henla464/WiRocKiCad/KiCad6/Hardware_OLED_v1/Plots/3dmodel.png

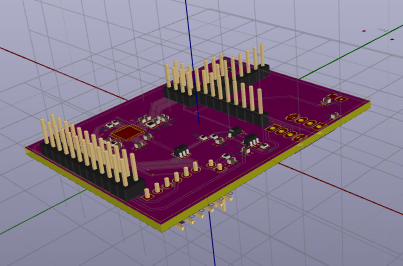
KiCad6/Hardware_OLED_v1/Plots/3dmodel.png
