henla464/WiRocKiCad/KiCad8/WiRoc_NanoPi_v7/production/WiRoc_NanoPi.png

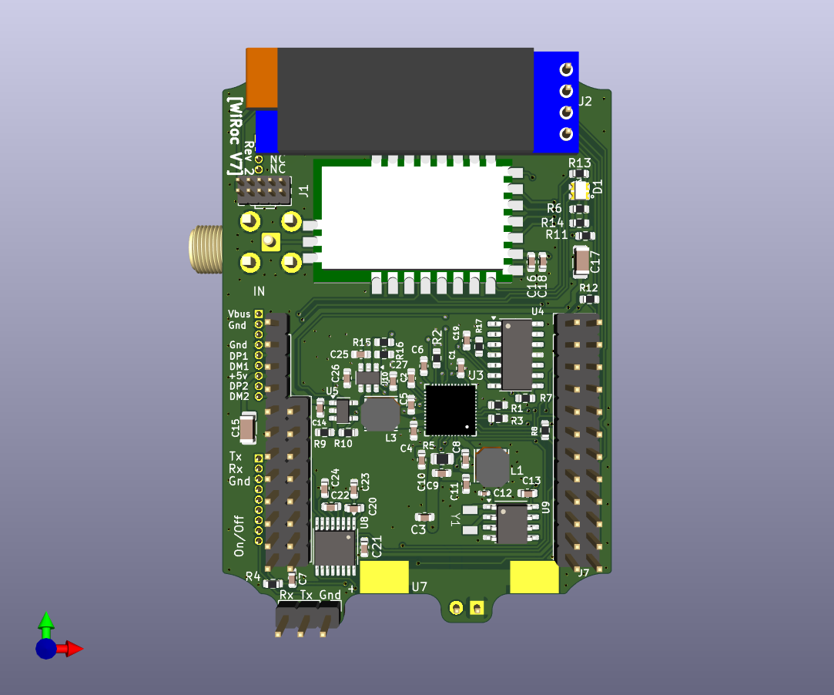
KiCad8/WiRoc_NanoPi_v7/production/WiRoc_NanoPi.png
