henla464/WiRocKiCad/Components for voltage protection TECH PUBLIC USBLC6 2P6.txt

TECH PUBLIC USBLC6-2P6  		is tiny SOT-666-6  1,5kr/st available
STMicroelectronics USBLC6-2P6		is tiny SOT-666-6  2 kr/st available
TECH PUBLIC TPUSBLC6-2P6		is tiny SOT-666-6  1,5kr/st available
