henla464/WiRocKiCad/KiCad6/Hardware_NanoPi_v5/WiRoc_NanoPi_v1.html

# /home/henla464/Documents/WiRoc/Hardware/KiCad/KiCad5/Hardware_NanoPi_v5/WiRoc_NanoPi_v1.sch

lör 7 aug 2021 14:30:26

Eeschema 5.1.10-88a1d61d58~88~ubuntu20.04.1

Component Count:55

Ref | Qnty | Value | Part | Datasheet | Description | Vendor
C1, C3, C8, C10, C11, C18 | 6 | 4.7uF | WiRoc_NanoPi_v1-rescue:C
C2, C6, C9, C16 | 4 | 1uF | WiRoc_NanoPi_v1-rescue:C
C4, C5, C12, C13, C14, C19 | 6 | 10uF | WiRoc_NanoPi_v1-rescue:C
C7 | 1 | 100pF | WiRoc_NanoPi_v1-rescue:C
C15, C17 | 2 | 47uF | Device:C | ~ | Unpolarized capacitor
D1 | 1 | LED_DUAL_ACCA | WiRoc:LED_DUAL_ACCA | https://datasheet.lcsc.com/szlcsc/2005041205_HONGLITRONIC-Hongli-Zhihui-HONGLITRONIC-HL-PCB-1617S9FH203BC_C513363.pdf
D3 | 1 | IN5819 | WiRoc_NanoPi_v1-rescue:D_Schottky | https://datasheet.lcsc.com/szlcsc/1811011112_Changjiang-Electronics-Tech-CJ-B5817W_C8597.pdf
J1 | 1 | Conn_01x02 | WiRoc_NanoPi_v1-rescue:Conn_01x02
J2 | 1 | USB_Power_02x02 | WiRoc:TerminalBlock_USB_Power_01x04 | | Generic connector, single row, 01x04
J3 | 1 | Serial | Connector:Conn_01x04_Female | | Generic connector, single row, 01x04, script generated (kicad-library-utils/schlib/autogen/connector/)
J4 | 1 | USB_Host_Data_02x02 | WiRoc:TerminalBlock_USB_Host_Data_01x04 | | Generic connector, single row, 01x04
J6 | 1 | HAT_Conn_DBG | WiRoc_NanoPi_v1-rescue:Conn_01x03
J7 | 1 | NanoPIAir | WiRoc:NanoPIAir
J8 | 1 | USB_Host_Data_02x02 | WiRoc:TerminalBlock_USB_Host_Data_01x04 | | Generic connector, single row, 01x04
J9 | 1 | Conn_Coaxial | Connector:Conn_Coaxial | | coaxial connector (BNC, SMA, SMB, SMC, Cinch/RCA, ...)
JP1 | 1 | Jumper_NO_Small | Device:Jumper_NO_Small | ~ | Jumper, normally open, small symbol
JP2 | 1 | Jumper_NC_Small | Device:Jumper_NC_Small | ~ | Jumper, normally closed, small symbol
L1, L2 | 2 | 2.2uH-DCR<0.1R-1.5A | WiRoc_NanoPi_v1-rescue:L
R1, R10 | 2 | 100K-1% | WiRoc_NanoPi_v1-rescue:R
R2, R3, R7 | 3 | 200K-1% | WiRoc_NanoPi_v1-rescue:R
R4, R8 | 2 | 24K-1% | WiRoc_NanoPi_v1-rescue:R
R5 | 1 | 0R03 | WiRoc_NanoPi_v1-rescue:R
R6, R13, R14 | 3 | 1K | WiRoc_NanoPi_v1-rescue:R
R9 | 1 | 3.6K-1% | WiRoc_NanoPi_v1-rescue:R | https://datasheet.lcsc.com/szlcsc/1811081731_UNI-ROYAL-Uniroyal-Elec-0603WAF3601T5E_C22980.pdf
R11, R12 | 2 | 10K | WiRoc_NanoPi_v1-rescue:R
SW1 | 1 | SW_SPST | Switch:SW_SPST | | Single Pole Single Throw (SPST) switch
U1 | 1 | DRF1268DS | WiRoc:DRF1268DS
U2 | 1 | OLED | WiRoc:OLED
U3 | 1 | AXP209 | WiRoc:axp209 | http://dl.linux-sunxi.org/AXP/AXP209_Datasheet_v1.0en.pdf
U4 | 1 | LP6226_SY7208 | WiRoc:LP6226_SY7208 | https://datasheet.lcsc.com/szlcsc/1810010234_Silergy-Corp-SY7208ABC_C80514.pdf | SOT23-6
U5 | 1 | SY6280 | WiRoc:SY6280 | https://datasheet.lcsc.com/szlcsc/1810121532_Silergy-Corp-SY6280AAC_C55136.pdf
U6 | 1 | BatteryPadM | WiRoc:BatteryPadM
U7 | 1 | BatteryPadP | WiRoc:BatteryPadP
