henla464/WiRocKiCad/KiCad6/Hardware_NanoPi_v1/Plots/WiRoc_NanoPi_v1.html

# WiRoc NanoPI Hat BOM Rev 1

Date

# 2018-03-31

Company

# Henrik Larsson

Comment 1

Total Parts

# 53 (Unique 29)

Ref

Qty

Value

Description

ElecrowPNr

Manufacturer

ManufacturerPNr

Notes

Original

Package

WebsiteURL

WebsiteURL2

Datasheet

[C] -

C13 C12 C14 C4 C5

5

10uF

C19702

CL10A106KP8NNNC

Free

0603

C3 C11 C10 C8 C1

5

4.7uF

C19666

CL10A475KO8NNNC

Free

0603

C9 C2 C6

3

1uF

C15849

CL10A105KB8NNNC

Free

0603

C7

1

100pF

100pF (101) ±5% 50V

C14858

CL10C101JB8NNNC

Free

0603

[D] -

D3

1

IN5819

Diode Schottky 40V 1A Surface Mount SOD-123

Diodes Incorporated

1N5819HW-7-F

No

SOD-123

Link (https://www.digikey.com/product-detail/en/diodes-incorporated/1N5819HW-7-F/1N5819HW-FDICT-ND/815283)

Datasheet (https://www.diodes.com/assets/Datasheets/ds30217.pdf)

D1

1

D_TVS

Applied Power Microelectronics

AU0511P1

No

DFN1006-2

Link (http://www.datasheetspdf.com/pdf/1099402/AppliedPowerMicroelectronics/AU0511P1/1)

Datasheet

D2

1

LED

Red LED

4040506A

No

0603

[J] -

J6

1

NanoPIAir_USBPort

CONN HEADER FEM 12POS.1" SGL TIN

Sullins Connector Solutions

PPTC121LFBN-RC

No

1x 12P-2.54

Link (https://www.digikey.se/products/en?keywords=PPTC121LFBN-RC)

Link

Datasheet (http://www.sullinscorp.com/drawings/78_P(N)PxCxxxLFBN-RC,_10492-H.pdf)

J9

1

NanoPIAir_GPIOPort

2.54mm 2X12 Pin Double Row Female 12P

Sullins Connector Solutions

PPTC122LFBN-RC

No

2x 12P-2.54

Link (https://www.digikey.com/product-detail/en/sullins-connector-solutions/PPTC122LFBN-RC/S7080-ND/810218)

Link

Datasheet (http://www.sullinscorp.com/drawings/78_P(N)PxCxxxLFBN-RC,_10492-H.pdf)

J7

1

NanoPIAir_DebugPort

CONN HEADER FEM 12POS.1" SGL TIN

Sullins Connector Solutions

PPTC041LFBN-RC

No

1x 4P-2.54

Link (https://www.digikey.se/product-detail/en/sullins-connector-solutions/PPTC041LFBN-RC/S7002-ND/810144)

Link

Datasheet (http://www.sullinscorp.com/drawings/78_P(N)PxCxxxLFBN-RC,_10492-H.pdf)

J3

1

JST-2PIN

2 Positions Header Connector 0.098" (2.50mm) Through Hole Tin

JST Sales America Inc.

B2B-XH-A(LF)(SN)

2.54 mm pitch should work too...

No

Link (https://www.digikey.se/product-detail/en/jst-sales-america-inc/B2B-XH-A-LF-SN/455-2247-ND/1651045)

J1

1

Conn_01x02

6030916A

No

1x 2P-2.54

J8

1

HAT_Conn_DBG

6030916A

No

1x 3P-2.54

J2

1

TerminalBlock_USB_Power_01x04

J5

1

Conn_01x06

J4

1

TerminalBlock_USB_Host_Data_01x04

[L] -

L2 L1

2

2.2uH-DCR<0.1R-1.5A

FIXED IND 2.2UH 1.7A 55 MOHM SMD

Panasonic Electronic Components

ELL-4LG2R2NA

ELL4LG-A

Link (https://www.digikey.se/product-detail/en/panasonic-electronic-components/ELL-4LG2R2NA/PCD2215TR-ND/1938292)

Datasheet (https://industrial.panasonic.com/cdbs/www-data/pdf/AGM0000/AGM0000CE3.pdf)

[R] -

R7 R2 R3

3

200K-1%

C25811

0603WAF2003T5E

Free

0603

R8

1

24K-1%

C23352

0603WAF2402T5E

Free

0603

R9

1

3.6K-1%

C22980

0603WAF3601T5E

Free

0603

R5

1

0R03

RESISTOR 0805 0.03Ω 1/8W±1%

Vishay Dale

WSL0805R0300FEA

No

0805

Link (https://www.digikey.com/product-detail/en/vishay-dale/WSL0805R0300FEA/WSLA-.03CT-ND/713392)

R4 R6

2

1K

1KΩ (1001) ±1%

C21190

0603F1001T5E

Free

0603

R1 R10

2

100K-1%

C25803

0603WAF1003T5E

Free

0603

[TP] -

TP10 TP11 TP14 TP4 TP1 TP2 TP9 TP3

8

TEST

[U] -

U3

1

AXP209

Enhanced single Cell Li-Battery and Power System Management IC

X-Powers Limited

AXP209

Yes

6mm x 6mm 48-pin QFN

Datasheet (http://dl.linux-sunxi.org/AXP/AXP209_Datasheet_v1.0en.pdf)

U4

1

LP6226/SY7208

High Efficiency Boost DC/DC Convertor

lowpowersemi

LP6226B6F

Yes

SOT23-6

Datasheet (http://www.lowpowersemi.com/uploads/soft/20170826Boost/LP6226.pdf)

U5

1

SY6280

Power Distribution Switch 1In/1Out Act-High Enable 1A Vin 2.4÷5.5V 80mΩ

SILERGY

SY6280AAC

Yes

SOT23-5

Datasheet (http://www.szyucan.com/upfile/IC-PDF/SY6280A.pdf)

U2

1

LoraRadio

Lora radio module

AppconnWireless

RF1276T ; freq: ~440Mhz ; voltage: 2.1-3.7V ; TTL serial

Yes

# BOM made with KICAD_BOM_WIZARD (https://github.com/HashDefineElectronics/KiCad_BOM_Wizard) (Generated lör 7 jul 2018 10:53:41)
