henla464/WiRocKiCad/KiCad6/Hardware_NanoPi_v3/WiRoc_NanoPi_v1.html

# WiRoc NanoPI Hat BOM Rev 1

Date

# 2018-03-31

Company

# Henrik Larsson

Comment 1

Total Parts

# 59 (Unique 33)

Ref

Qty

Value

Description

ElecrowPNr

LCSCPNr

Manufacturer

ManufacturerPNr

Notes

Original

Package

WebsiteURL

WebsiteURL2

Datasheet

[C] -

C13 C12 C14 C4 C5

5

10uF

C19702

C19702

Samsung Electro-Mechanics

CL10A106KP8NNNC

No

0603

Link (https://lcsc.com/product-detail/Multilayer-Ceramic-Capacitors-MLCC-SMD-SMT_SAMSUNG_CL10A106KP8NNNC_10uF-106-10-10V_C19702.html)

C3

1

4.7uF

C99226

C19666

Guangdong Fenghua Advanced Tech

0603B475K160NT

No

0603

Link (https://lcsc.com/product-detail/Multilayer-Ceramic-Capacitors-MLCC-SMD-SMT_4-7uF-475-10-16V_C99226.html)

Link

C9 C2 C6

3

1uF

C157684

C15849

Guangdong Fenghua Advanced Tech

0603X105K500NT

No

0603

Link (https://lcsc.com/product-detail/Multilayer-Ceramic-Capacitors-MLCC-SMD-SMT_1uF-105-10-50V_C157684.html)

C11 C10 C8 C1

4

4.7uF

C99226

C19666

Guangdong Fenghua Advanced Tech

0603B475K160NT

No

0603

Link (https://lcsc.com/product-detail/Multilayer-Ceramic-Capacitors-MLCC-SMD-SMT_4-7uF-475-10-16V_C99226.html)

C7

1

100pF

100pF (101) ±5% 50V

C1635

C14858

Guangdong Fenghua Advanced Tech

0603CG101J500NT

No

0603

Link (https://lcsc.com/product-detail/Multilayer-Ceramic-Capacitors-MLCC-SMD-SMT_100pF-101-5-50V_C1635.html)

C15

1

47uF

C77101

C77101

1210

Datasheet

[D] -

D3

1

IN5819

Diode Schottky 40V 1A Surface Mount SOD-123

C82544

C8597

Diodes Incorporated

1N5819HW-7-F

No

SOD-123

Link (https://www.digikey.com/product-detail/en/diodes-incorporated/1N5819HW-7-F/1N5819HW-FDICT-ND/815283)

Datasheet (https://www.diodes.com/assets/Datasheets/ds30217.pdf)

D2 D5 D4

3

LED

Red LED

C118330

C2286

Wuxi ARK Tech Elec

D-R060306L3-KS2

No

0603

Link (https://lcsc.com/product-detail/Light-Emitting-Diodes-LED_D-R060306L3-KS2-Azarin_C118330.html)

[J] -

J3

1

JST-2PIN

2 Positions Header Connector 0.098" (2.50mm) Through Hole Tin

C20079

N/A

Boom Precision Elec

XH-2A

2.54 mm pitch should work too...

No

XH-2A

Link (https://lcsc.com/product-detail/XH-Connectors_XH-2A-2P-pitch2-5mm-Straight-line_C20079.html)

J1

1

Conn_01x02

C2337

N/A

Boom Precision Elec

No

1x 2P-2.54

Link (https://lcsc.com/product-detail/Male-Header_2-54mm-1-40P-Straight-Headers-Pins_C2337.html)

J2

1

USB_Power_02x02

N/A

N/A

J4

1

USB_Host_Data_02x02

N/A

N/A

J6

1

HAT_Conn_DBG

CONN HEADER Male 3POS.1"

C2337

N/A

Boom Precision Elec

No

1x 3P-2.54

Link (https://lcsc.com/product-detail/Male-Header_2-54mm-1-40P-Straight-Headers-Pins_C2337.html)

J5

1

Conn_01x03

N/A

Datasheet

J8

1

USB_Host_Data_02x02

N/A

N/A

J7

1

NanoPIAir

N/A

J9

1

Conn_Coaxial

C88374

C88374

Datasheet

[L] -

L2 L1

2

2.2uH-DCR<0.1R-1.5A

FIXED IND 2.2UH 1.7A 55 MOHM SMD

C206341

C206341

Sunltech Tech

SLW4018S2R2MST

Yes

4018

Link (https://lcsc.com/product-detail/Power-Inductors_2-2uH-20-1-65A_C206341.html)

[R] -

R7 R2 R3

3

200K-1%

C25811

C25811

Uniroyal Elec

0603WAF2003T5E

No

0603

Link (https://lcsc.com/product-detail/Chip-Resistor-Surface-Mount-UniOhm_Uniroyal-Elec-0603WAF2003T5E_C25811.html)

R8

1

24K-1%

C23352

C23352

Uniroyal Elec

0603WAF2402T5E

No

0603

Link (https://lcsc.com/product-detail/Chip-Resistor-Surface-Mount-UniOhm_Uniroyal-Elec-0603WAF2402T5E_C23352.html)

R9

1

3.6K-1%

C100993

C22980

LIZ Elec

CR0603FA3601G

No

0603

Link (https://lcsc.com/product-detail/Chip-Resistor-Surface-Mount_3-6KR-3601-1_C100993.html)

R5

1

0R03

RESISTOR 0805 0.03Ω 1/8W±1%

C158159

C247605

RALEC

RTT05R030FTP

No

0805

Link (https://lcsc.com/product-detail/Chip-Resistor-Surface-Mount_0-03R-R030-1_C158159.html)

R4 R6 R14 R13

4

1K

1KΩ (1001) ±1%

C103198

C21190

RALEC

RTT031001FTP

No

0603

Link (https://lcsc.com/product-detail/Chip-Resistor-Surface-Mount_1KR-1001-1_C103198.html)

R1 R10

2

100K-1%

C25803

C25803

Uniroyal Elec

0603WAF1003T5E

No

0603

Link (https://lcsc.com/product-detail/Chip-Resistor-Surface-Mount-UniOhm_Uniroyal-Elec-0603WAF1003T5E_C25803.html)

R11 R12

2

10K

RESISTOR 0603 10KΩ

C108450

C25804

Huaxin S&T

WR06X103JTL

No

0603

Link (https://lcsc.com/product-detail/Chip-Resistor-Surface-Mount_10KR-103-5_C108450.html)

[TP] -

TP10 TP11 TP14 TP4 TP1 TP2 TP9 TP3

8

TEST

N/A

N/A

[U] -

U3

1

AXP209

Enhanced single Cell Li-Battery and Power System Management IC

C80525

C80525

X-Powers Limited

AXP209

Yes

6mm x 6mm 48-pin QFN

Link (https://lcsc.com/product-detail/PMIC-AC-DC-Converters_AXP209_C80525.html)

Datasheet (http://dl.linux-sunxi.org/AXP/AXP209_Datasheet_v1.0en.pdf)

U4

1

LP6226_SY7208

High Efficiency Boost DC/DC Convertor

Missing

C80514

lowpowersemi

LP6226B6F

Yes

SOT23-6

Link

Link (https://lcsc.com/product-detail/DC-DC-Converters_Silergy_SY7208ABC_SY7208ABC_C80514.html)

Datasheet (http://www.lowpowersemi.com/uploads/soft/20170826Boost/LP6226.pdf)

U5

1

SY6280

Power Distribution Switch 1In/1Out Act-High Enable 1A Vin 2.4÷5.5V 80mΩ

C55136

C55136

SILERGY

SY6280AAC

Yes

SOT23-5

Link (https://lcsc.com/product-detail/PMIC-Power-Distribution-Switches_Silergy_SY6280AAC_SY6280AAC_C55136.html)

Datasheet (http://www.szyucan.com/upfile/IC-PDF/SY6280A.pdf)

U1

1

DRF1268DS

N/A

U2

1

OLED

N/A

U7

1

BatteryPadP

N/A

U6

1

BatteryPadM

N/A

# BOM made with KICAD_BOM_WIZARD (https://github.com/HashDefineElectronics/KiCad_BOM_Wizard) (Generated ons 11 sep 2019 00:13:55)
