henla464/WiRocKiCad/KiCad10/WiRoc_v8/ComponentDesignationAndLocation.ods

Sheet: Resistors
Resistor designation on NanoPi | Found | on WiRoc | Where* (b=bottom, t=top, column A-D, row 1-4)
R1 | No
R2 | Yes | R19 | bC1
R3 | Yes | R27 | bC1
R4 | Yes | R43 | bD1
R5 | Yes | R29 | bC1
R6 | Yes | - |  | Micro usb
R7 | Yes | - |  | Audio
R8 | Yes | - |  | Micro usb
R9 | Yes | - |  | Audio
R10 | Yes | - |  | Micro usb
R11 | Yes | R35 | bB3
R12 | Yes | R45 | bB4
R13 | Yes | R52 | bD4
R14 | Yes | R44 | bB4
R15 | Yes | - |  | Audio
R16 | Yes | R48 | bC4
R17 | Yes | R47 | bC4
R18 | Yes | - |  | Micro usb
R19 | Yes | R51 | bD4
R20 | Yes | RV8 | tC1
R21 | Yes | R33 | tB2
R22 | Yes | R34 | bC3
R23 | Yes | R26 | bC3
R24 | Yes | R29 | tB2
R25 | Yes | RV7 | tC1
R26 | Yes | RV1 | tC2
R27 | Yes | RV2 | tC2
R28 | Yes | RV6 | tC2
R29 | Yes | RV5 | tC2
R30 | Yes | RV4 | tC2
R31 | Yes | RV3 | tC3
R32 | Yes | R42 | bB4
R33 | No
R34 | No
R35 | No
R36 | Yes | R46 | bD1
… | No
R51 | Yes | R23 | tC2
R52 | Yes | R24 | bB2
R53 | Yes | R22 | tC2
… | No
R88 | Yes | R25 | bA4
R89 | Yes | - |  | Audio
R90 | Yes | - |  | IR
R91 | Yes | - |  | Audio
R92 | No
… | No
R140 | Yes | - |  | Wifi/BT
R141 | Yes | - |  | Wifi/BT
R142 | Yes | - |  | Wifi/BT
R143 | Yes | - |  | Wifi/BT
R144 | Yes | - |  | Wifi/BT
R145 | Yes | - |  | Wifi/BT
R146 | Yes | - |  | Wifi/BT
R147 | Yes | - |  | Wifi/BT
.. | No
R163 | Yes | - |  | Micro usb
… | No
R184 | Yes | - |  | Micro usb
… | No
R202 | Yes | R40 | bD3
R203 | Yes | R39 | bD3
… | No
R206 | Yes | R41 | bD3
…
R234 | Yes | - |  | Camera
…
R239 | Yes | - |  | Micro usb
R240 | No
R241 | Yes | - |  | Micro usb
R242 | Yes | - |  | Micro usb
…
R246 | Yes | - |  | Camera
R247 | Yes | - |  | Camera
…
R250 | Yes | - |  | Camera
R251 | No
R252 | Yes | R32 | bC1
R253 | No
R254 | Yes | R34 | bC1
…
R344 | Yes | R28 | bC1
R345 | Yes | - |  | Wifi/BT
R346 | Yes | R20 | bA1
R347 | Yes | R21 | bA1
R348 | Yes | - |  | Wifi/BT
…
R350 | Yes | R18 | bC1
R351 | Yes | R36 | tC1
R352 | Yes | R37 | bA1
R353 | Yes | R38 | bA1
…
R452 | Yes | R50 | bD2
R453 | Yes | R53 | bD2
R454 | Yes | R54 | bD2
R455 | Yes | R55 | bD2
…
R475 | Yes | R30 | bD1

Sheet: Capacitor
Capacitor designation on NanoPi | Found | on WiRoc | Where* (b=bottom, t=top, column A-D, row 1-4)
C1 | Yes | C37 | tC2 |  | DRAM (A – area)
C2 | Yes | C31 | tA2
C3 | Yes | C38 | bD1
C4 | Yes | C39 | bD1
C5 | Yes | C44
… | No
C9 | Yes | C45 | tC2
… | No
C11 | Yes | - |  | Audio
C12 | Yes | - |  | Audio
C13 | Yes | - |  | Audio
C14 | Yes | - |  | Audio
C15 | Yes | - |  | Audio
C16 | Yes | C80 | bD4
C17 | Yes | C66 | bA3
C18 | Yes | C67 | tA2
C19 | Yes | C69 | tC2
C20 | Yes | C68 | tB2
C21 | Yes | C72 | tB2
C22 | Yes | C76
C23 | Yes | C77 | tB1
C24 | Yes | C74 | tB1
C25 | Yes | C78 | tB1
C26 | Yes | C79 | bC3
C27 | Yes | C82 | tB2
C28 | Yes | C83 | bC3
C29 | Yes | C84 | tB2
C30 | Yes | C85 | tB2?
C31 | Yes | C40 | bD2
C32 | Yes | -
C33 | Yes | -
C34 | Yes | -
C35 | Yes | -
C36 | Yes | C71 | tA2
C37 | Yes | -
C38 | Yes | -
C39 | Yes | C75 | tB1
C40 | Yes | C42 | bD3
C41 | Yes | C41 | bD2
C42 | Yes | C64 | bB4
C43 | Yes | C89 | bB4 (marked C50)
C44 | Yes | C87 | bC4
C45 | Yes | C65 | bB3
C46 | Yes | C88 | bC3
C47 | Yes | C92 | bC3
C48 | Yes | C33 | bC4
C49 | Yes | C86 | bD3
C50 | Yes | C91 | bC4
C51 | Yes | C34 | tA4
C52 | Yes | C90 | bC3
C53 | Yes | C35 | bB3
C54 | Yes | C32 | bC4
C55 | Yes | C93 | bD3
C56 | Yes | - |  | Wifi
C57 | Yes | C95 | bD3
C58 | Yes | C96 | bD3
C59 | Yes | C30 | bA2
C60 | Yes | C94 | bD2
C61 | Yes | - |  | Wifi
C62 | Yes | C73 | tB1
C63 | Yes | C81 | tB2
C64 | No
C65 | Yes | C70 | tC3
C66 | Yes | - |  | Audio
… | No
C73 | Yes | - |  | Micro usb
C74 | Yes | - |  | Micro usb
… | No
C91 | Yes | C43 | tC1
… | No
C175 | Yes | - |  | Wifi
C176 | Yes | - |  | Wifi
C177 | Yes | - |  | Wifi
C178 | Yes | - |  | Wifi
C179 | No
C180 | Yes | - |  | Wifi
C181 | Yes | - |  | Wifi
… | No
C238 | Yes | - |  | Camera
C239 | Yes | - |  | Camera
… | No
C307 | Yes | C62 | bA1
C308 | Yes | C46 | bA2
C309 | Yes | C47 | tB1
C310 | Yes | C48 | bA2
C311 | Yes | C49 | bA3
C312 | Yes | C50 | bB3
C313 | Yes | C51 | bA2
C314 | Yes | C52 | bB3
C315 | Yes | C53 | bA2
C316 | Yes | C54 | bA2
C317 | Yes | C55 | bA1
C318 | Yes | C56 | tB1
C319 | Yes | C57 | tC1
… | No
C325 | Yes | C29
C326 | Yes | C63 | bA1
C327 | Yes | C58 | bA2
C328 | Yes | C59 | bA1
C329 | Yes | C60 | tB1
C330 | Yes | C61 | tB1
… | No
C334 | Yes | C28 | bA1
