henla464/WiRocKiCad/KiCad7/LoraAmplifier/production/bom.csv

Designator | Footprint | Quantity | Value | LCSC Part #
BT1 | JST_2.56 | 1 | Battery_Cell
C8, C9 | 0805 | 2 | 10uF
D2 | LED_Dual_1.7_1.6 | 1 | LED_DUAL_ACCA
J1 | USB_Micro-B_Horizontal | 1 | USB_B_Micro
J2 | JST_2.56 | 1 | Conn_01x02_Pin
R4 | 0805 | 1 | 2K
R5, R6 | 0805 | 2 | 470
SW1 | SW_SPDT_PCM12 | 1 | SW_SPDT
U4 | SOT-23-5 | 1 | LP4054HB5F
