henla464/WiRocKiCad/KiCad7/Hardware_NanoPi_v7_ConnectorPlate/production/bom.csv

Designator | Footprint | Quantity | Value | LCSC Part #
J10 | PinHeader_1x04_P1.27mm_Horizontal | 1 | Conn_01x04
J11 | PinHeader_1x02_P2.54mm_Horizontal | 1 | Conn_01x02
J12 | PwrBtnPads | 1 | Conn_01x02
J5 | SerialConnPads3Pin | 1 | Conn_01x03
J6, J8 | PinHeader_1x09_P1.27mm_Horizontal | 2 | Conn_01x09
U1, U2, U3 | SOT-666 | 3 | USBLC6-2P6
