henla464/WiRocKiCad/KiCad10/Hardware_Library/STM32G030F6P6/STM32G030F6P6.stp

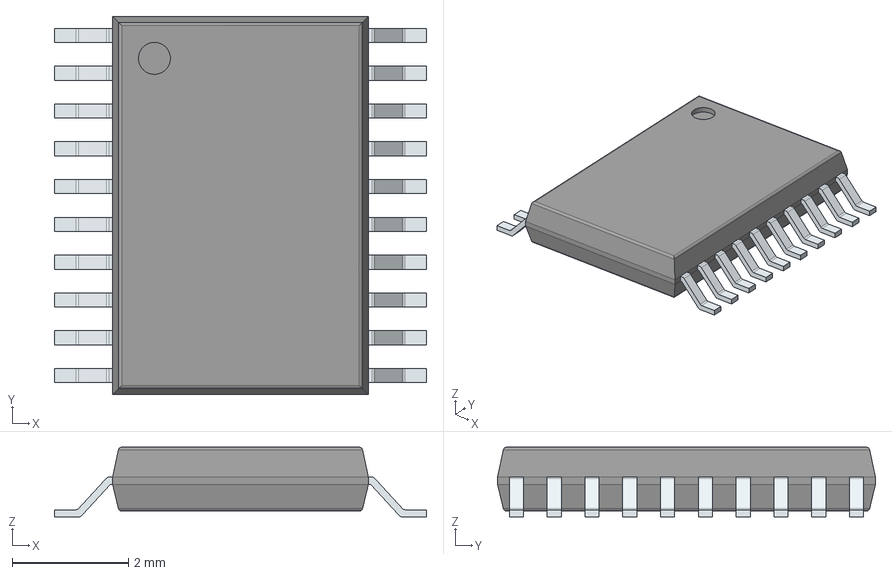
[picture p3: CAD file, 2023-06-16]
KiCad10/Hardware_Library/STM32G030F6P6/STM32G030F6P6.stp
6.40 x 6.50 x 1.20 mm
PinsArrayLR
