henla464/WiRocKiCad/KiCad10/SRRReceiver_v6/SRRReceiver.step

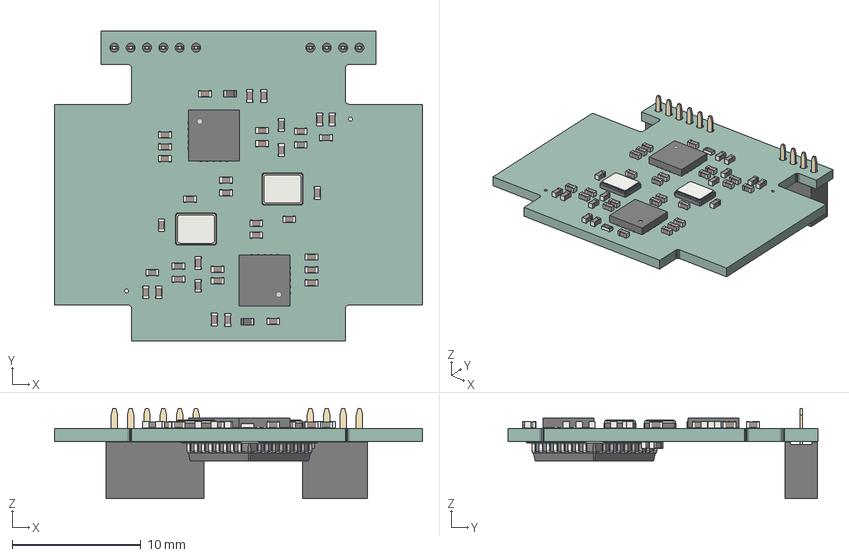
[picture p4: CAD file, 2025-09-28]
KiCad10/SRRReceiver_v6/SRRReceiver.step
28.6 x 24.1 x 7.00 mm
SRRReceiver PCB
