henla464/WiRocKiCad/KiCad10/SRRReceiverProgrammerAdaptorBoard/SRRReceiverProgrammerAdaptorBoard.step

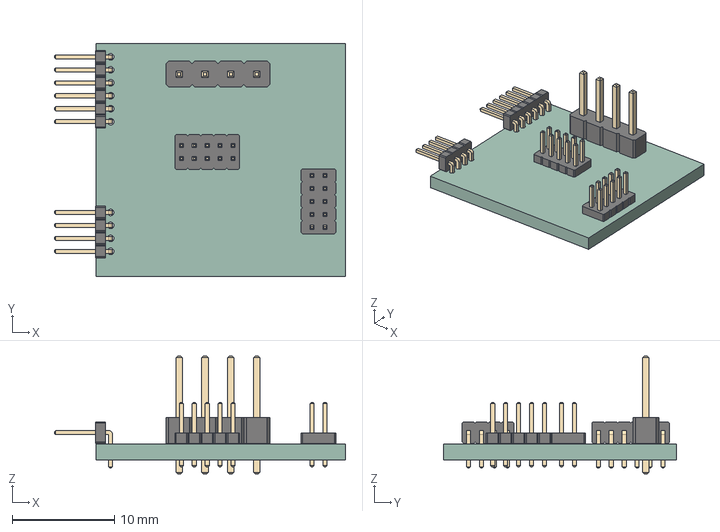
[picture p5: CAD file, 2023-11-12]
KiCad10/SRRReceiverProgrammerAdaptorBoard/SRRReceiverProgrammerAdaptorBoard.step
28.5 x 22.8 x 11.5 mm
_autosave-SRRReceiverProgrammerAdaptorBoard PCB
