henla464/WiRocKiCad/KiCad10/WifiModuleBoard/WifiModuleBoard.step

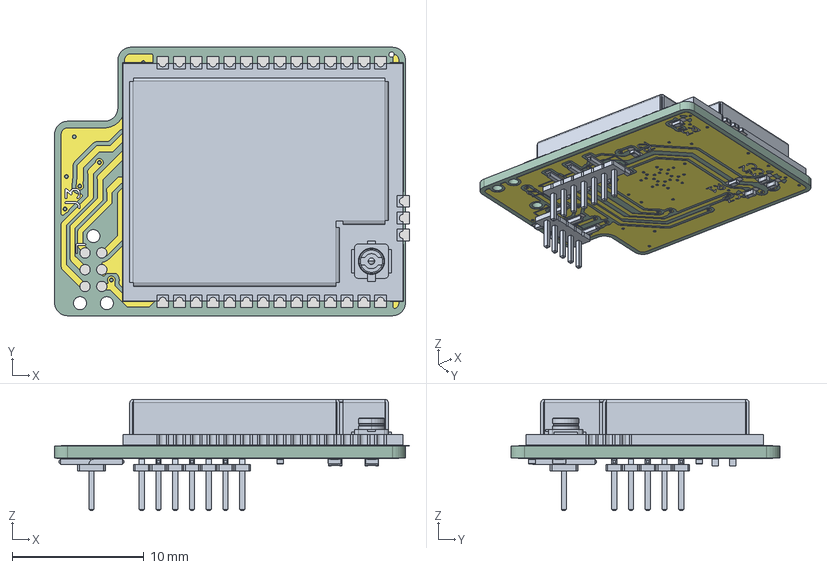
[picture p6: CAD file, 2025-12-04]
KiCad10/WifiModuleBoard/WifiModuleBoard.step
26.9 x 20.4 x 8.43 mm
ESP32-C5-WROOM-1U-N8R8
R_0402_1005Metric x 3
C_0402_1005Metric x 3
PinHeader_1x05_P1.27mm_Vertical_SMD_Pin1Left
PinHeader_1x07_P1.27mm_Vertical_SMD_Pin1Left
WifiModuleBoard_copper
WifiModuleBoard_pad
WifiModuleBoard_via
WifiModuleBoard_silkscreen x 2
WifiModuleBoard_PCB
