henla464/WiRocKiCad/KiCad10/WiRoc_v8/WiRoc_NanoPi.step

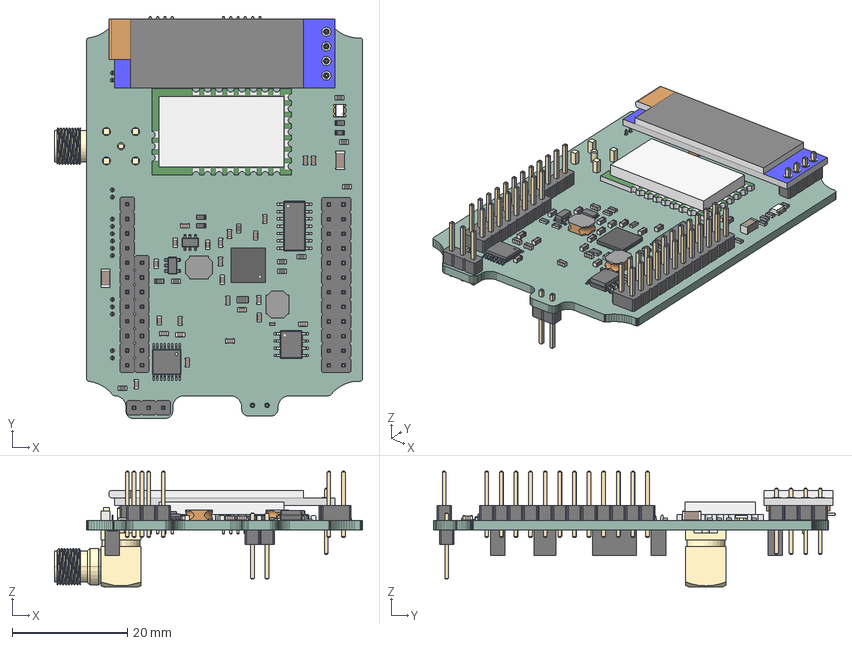
[picture p7: CAD file, 2025-09-28]
KiCad10/WiRoc_v8/WiRoc_NanoPi.step
53.6 x 69.9 x 20.1 mm
_autosave-WiRoc_NanoPi PCB
