henla464/WiRocKiCad/KiCad10/WiRoc_v8_USBConnectorPlate/WiRoc_v8_USBConnectorPlate.step

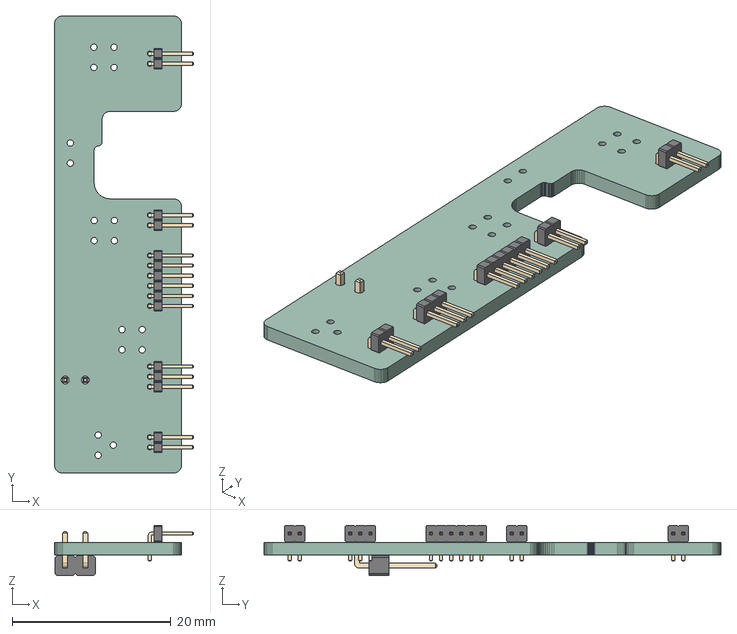
[picture p8: CAD file, 2023-11-12]
KiCad10/WiRoc_v8_USBConnectorPlate/WiRoc_v8_USBConnectorPlate.step
17.5 x 57.5 x 6.34 mm
Hardware_NanoPi_v7_ConnectorPlate PCB
