henla464/WiRocKiCad/KiCad7/USBRadio/USBRadio.step

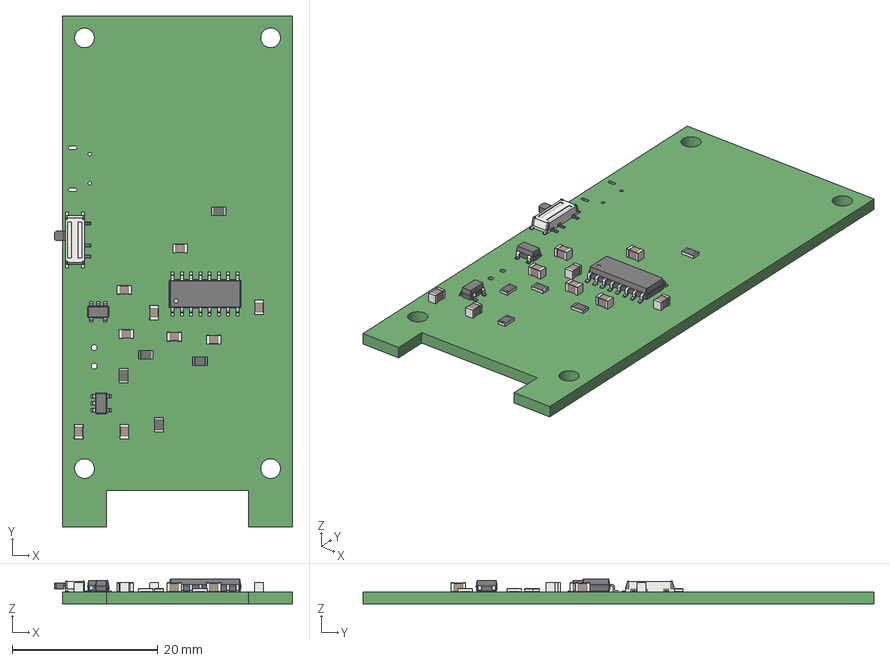
[picture p9: CAD file, 2021-12-25]
KiCad7/USBRadio/USBRadio.step
32.6 x 70.0 x 3.40 mm
JST_XH_B02B-XH-A_02x2.50mm_Straight
