henla464/WiRocKiCad/KiCad10/WiRoc_v8/3dmodelWithSRR.FCStd

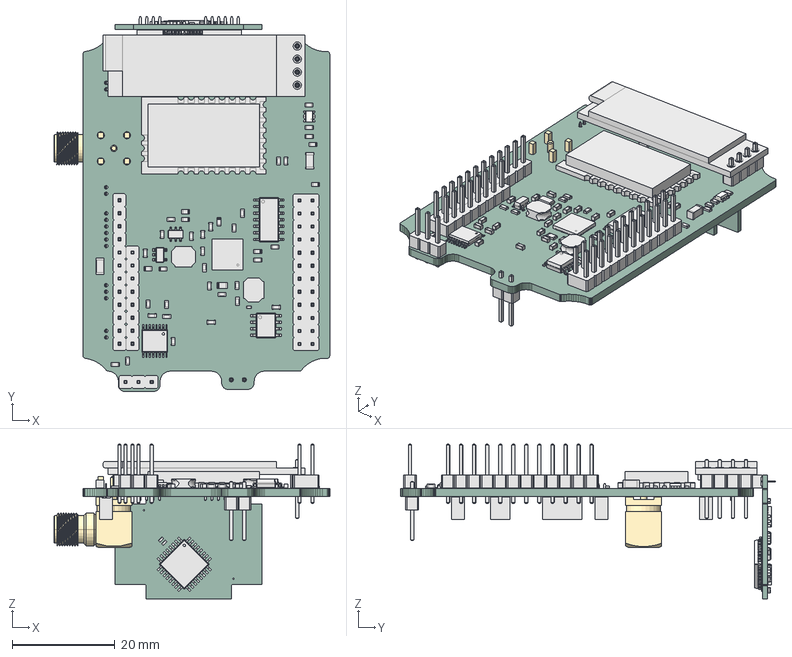
[picture p10: CAD file, 2023-11-12]
KiCad10/WiRoc_v8/3dmodelWithSRR.FCStd
53.6 x 73.0 x 30.1 mm
_autosave-WiRoc_NanoPi PCB
SRRReceiver PCB
