henla464/WiRocKiCad/(list of files, cad)

Other CAD files:
KiCad10/SRRReceiverProgrammerAdaptorBoard/AssemblyWithSRRReciever.FCStd
