henla464/WiRocKiCad/KiCad6/Hardware_NanoPi_v5/.\Board2Pdf/WiRoc_NanoPi_v1-Assembly.pdf

[WiRoc V5] | U5 C⁷ | C14 R⁹ C¹⁵ R⁴ | U1 J2 D+ | 5v GND
1 | 2 | 3 | 4 | 5 | 6

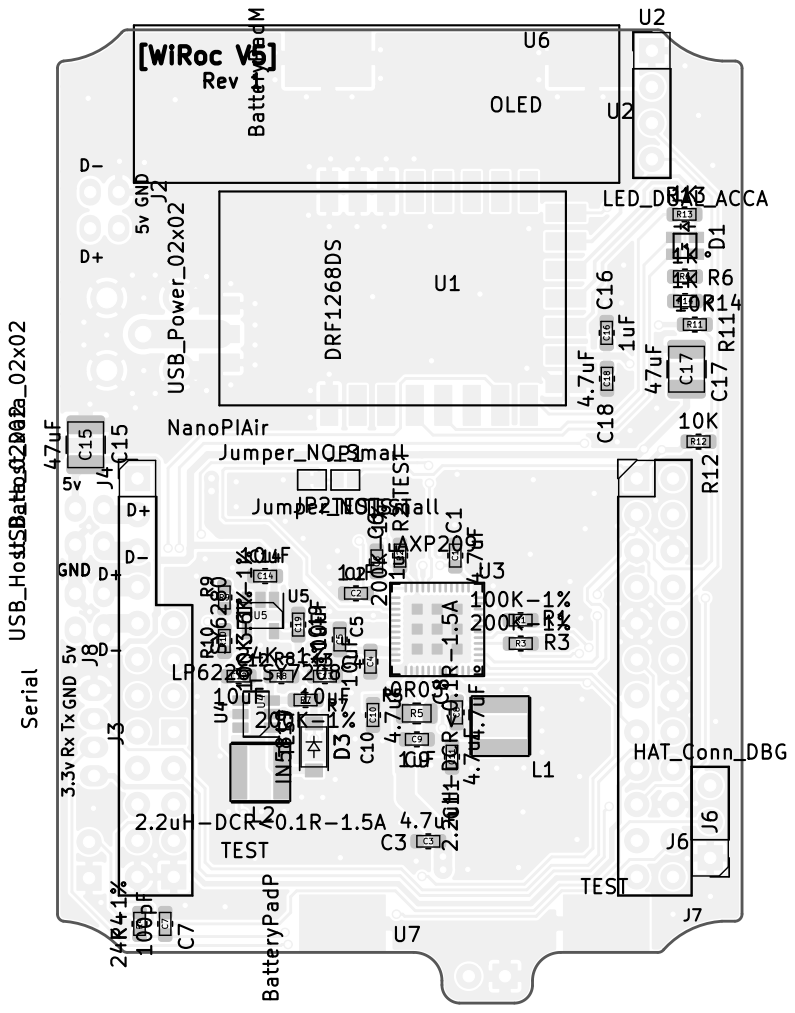
[picture p11: page 1]

J9 1 | 2 | 3 | 4 | 5 | 6

A

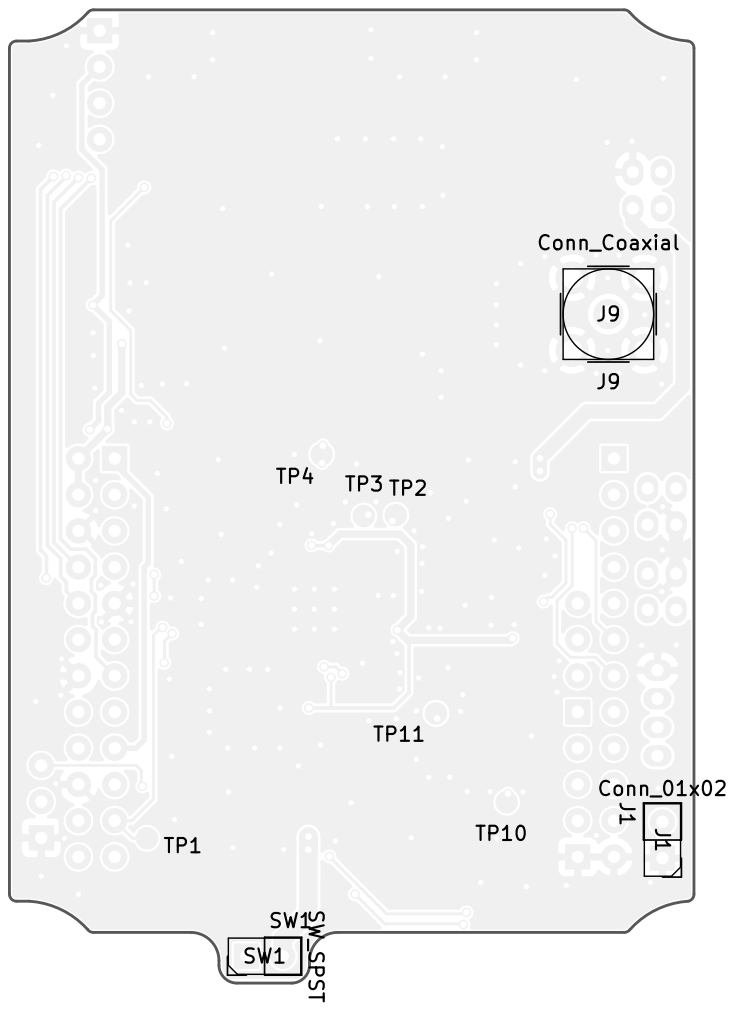
[picture p12: page 2]
