henla464/WiRocKiCad/KiCad6/Hardware_OLED_v1/Plots/WiRocChip_1.pdf

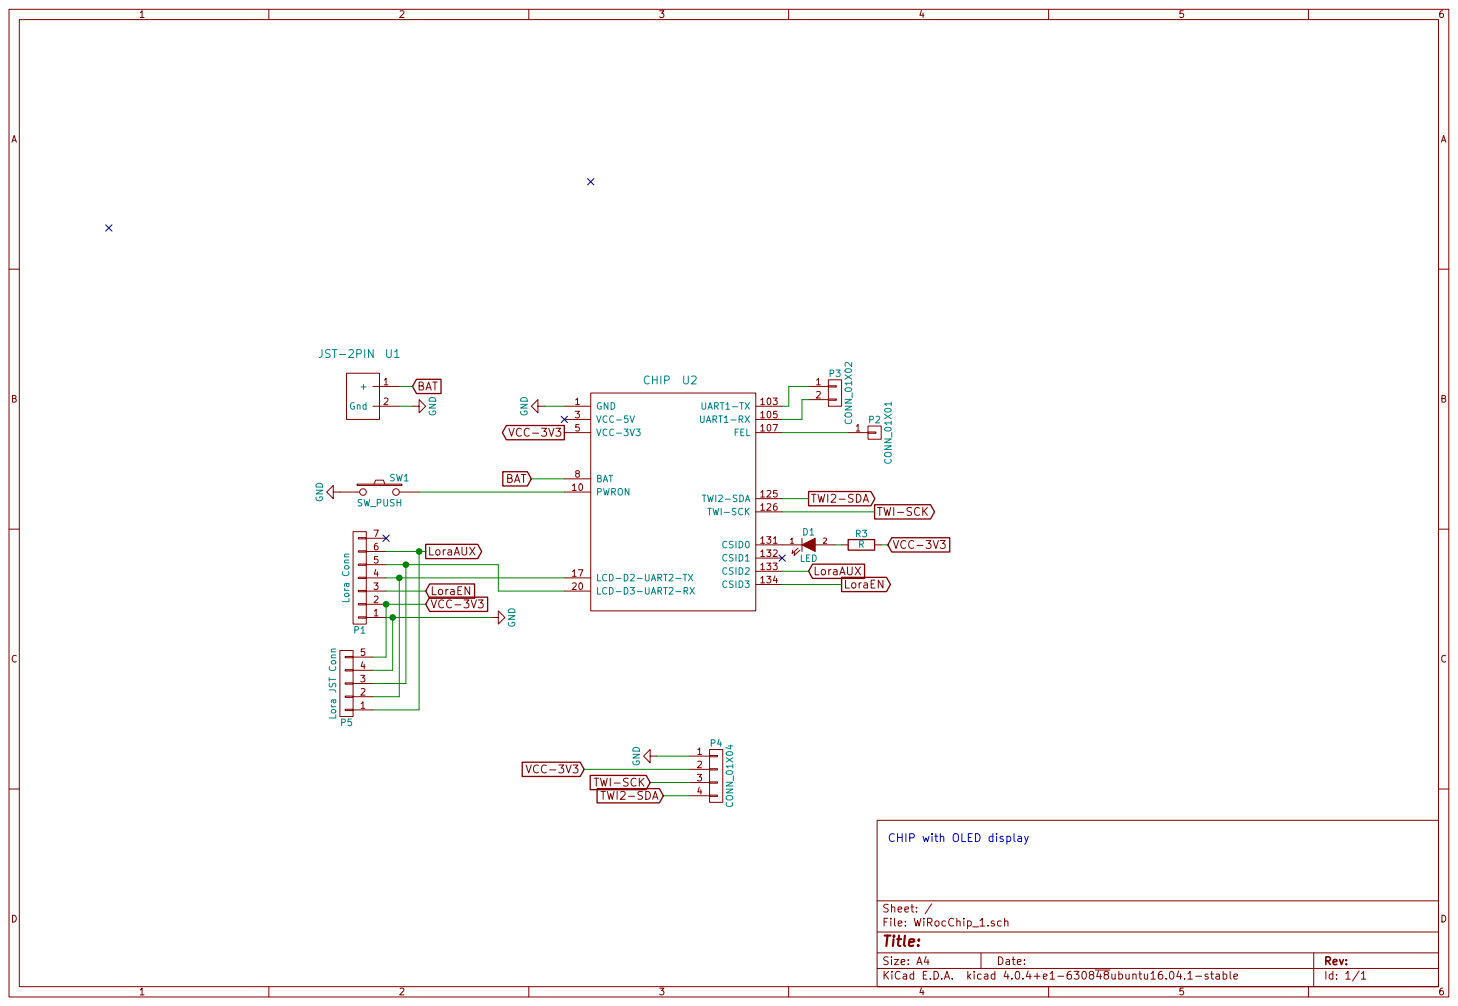
[picture p13: page 1]

3 | LCD-D3-UART2-RX 20

CHIP with OLED display
