henla464/WiRocKiCad/KiCad5/Hardware_NanoPi_SideOledPCB_TallUSBMicro_v2/Plots/WiRoc_NanoPi_SideOledPCB_v1-B.Cu.pdf

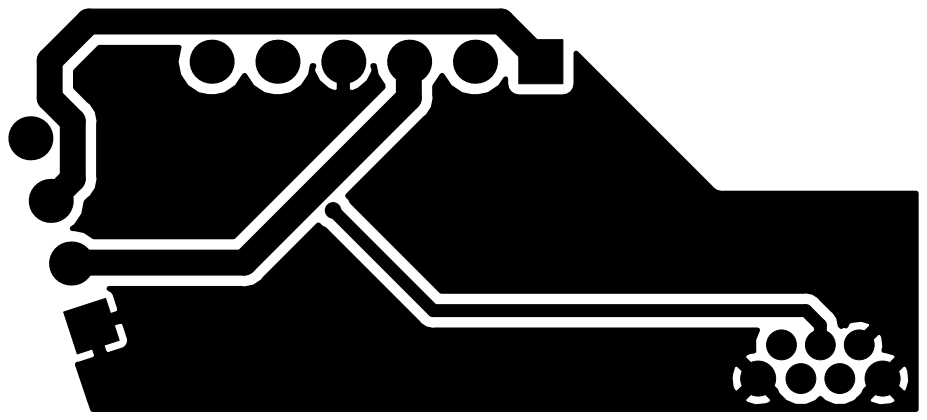
[picture p14: page 1]
