henla464/WiRocKiCad/KiCad5/Hardware_NanoPi_SideOledPCB_TallUSBMicro_v2/Plots/WiRoc_NanoPi_SideOledPCB_v1-F.Cu.pdf

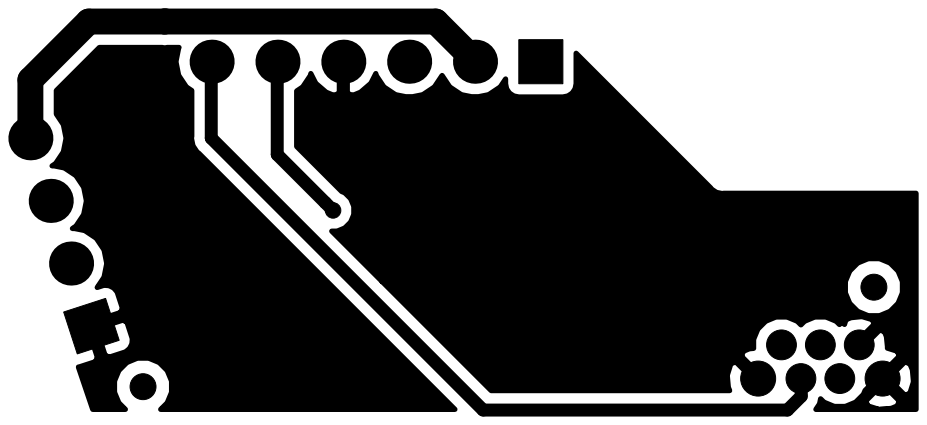
[picture p15: page 1]
