henla464/WiRocKiCad/KiCad5/Hardware_NanoPi_SideOledPCB_v3/Plots/WiRoc_NanoPi_SideOledPCB_v1-B.Cu.pdf

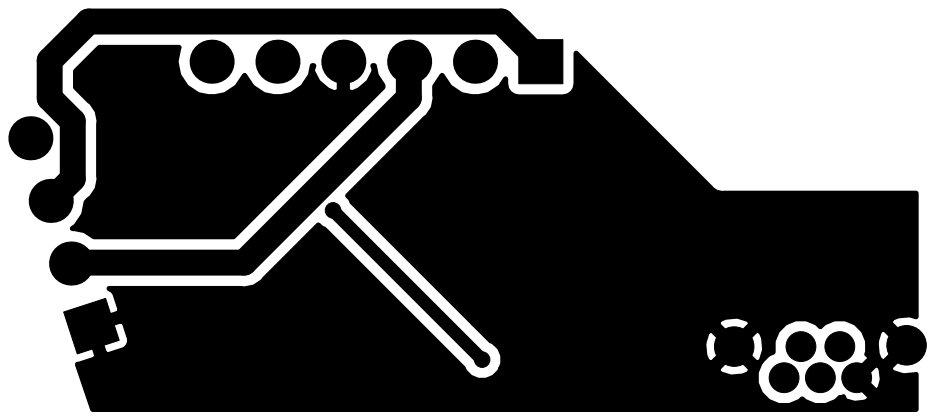
[picture p16: page 1]
