henla464/WiRocKiCad/KiCad5/Hardware_NanoPi_SideOledPCB_v3/Plots/WiRoc_NanoPi_SideOledPCB_v1-F.Cu.pdf

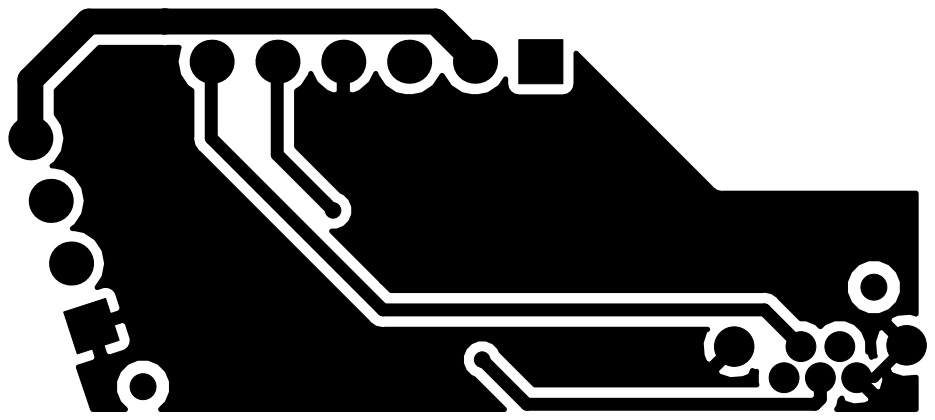
[picture p17: page 1]
