henla464/WiRocKiCad/KiCad6/Hardware_OLED_v1/PlotsPanelized/WiRoc-Panelized-B.Cu.pdf

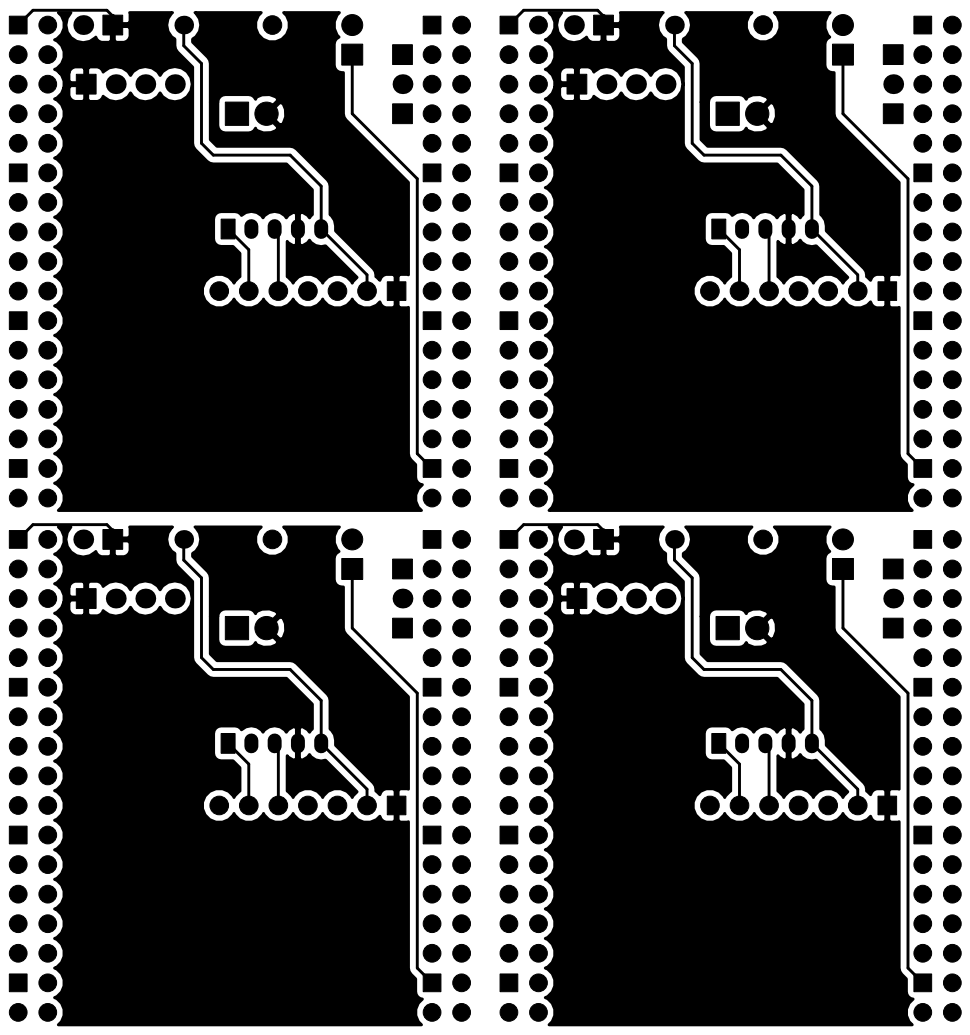
[picture p18: page 1]
