henla464/WiRocKiCad/KiCad6/Hardware_OLED_v1/PlotsPanelized/WiRoc-Panelized-B.Mask.pdf

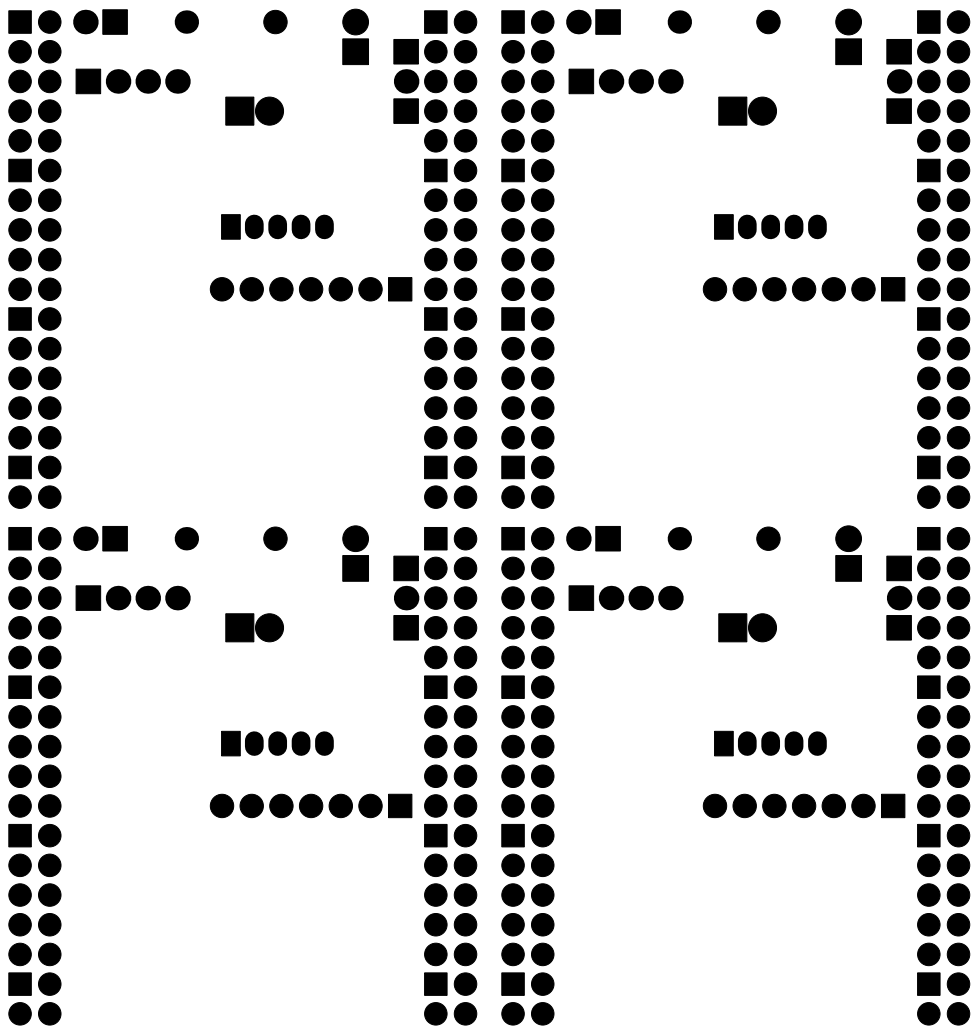
[picture p19: page 1]
