henla464/WiRocKiCad/KiCad6/Hardware_OLED_v1/PlotsPanelized/WiRoc-Panelized-B.SilkS.pdf

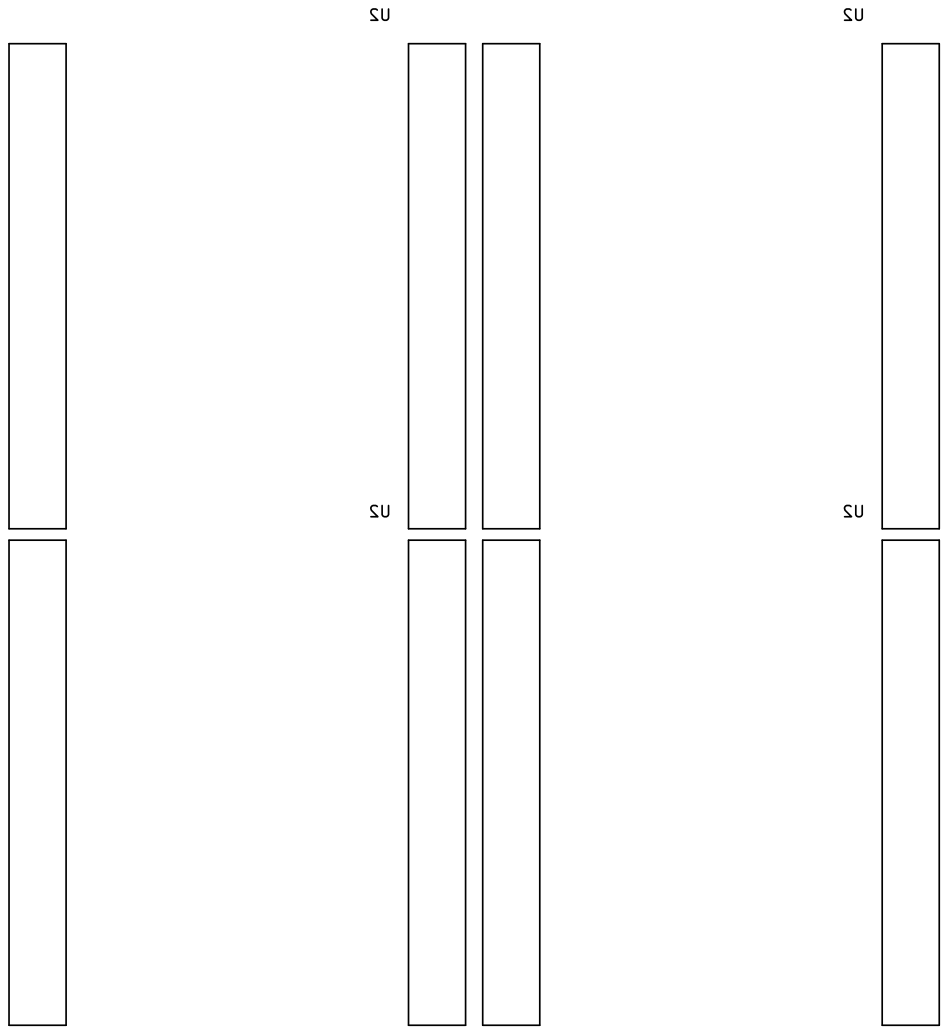
[picture p20: page 1]
