henla464/WiRocKiCad/KiCad6/Hardware_OLED_v1/PlotsPanelized/WiRoc-Panelized-F.Cu.pdf

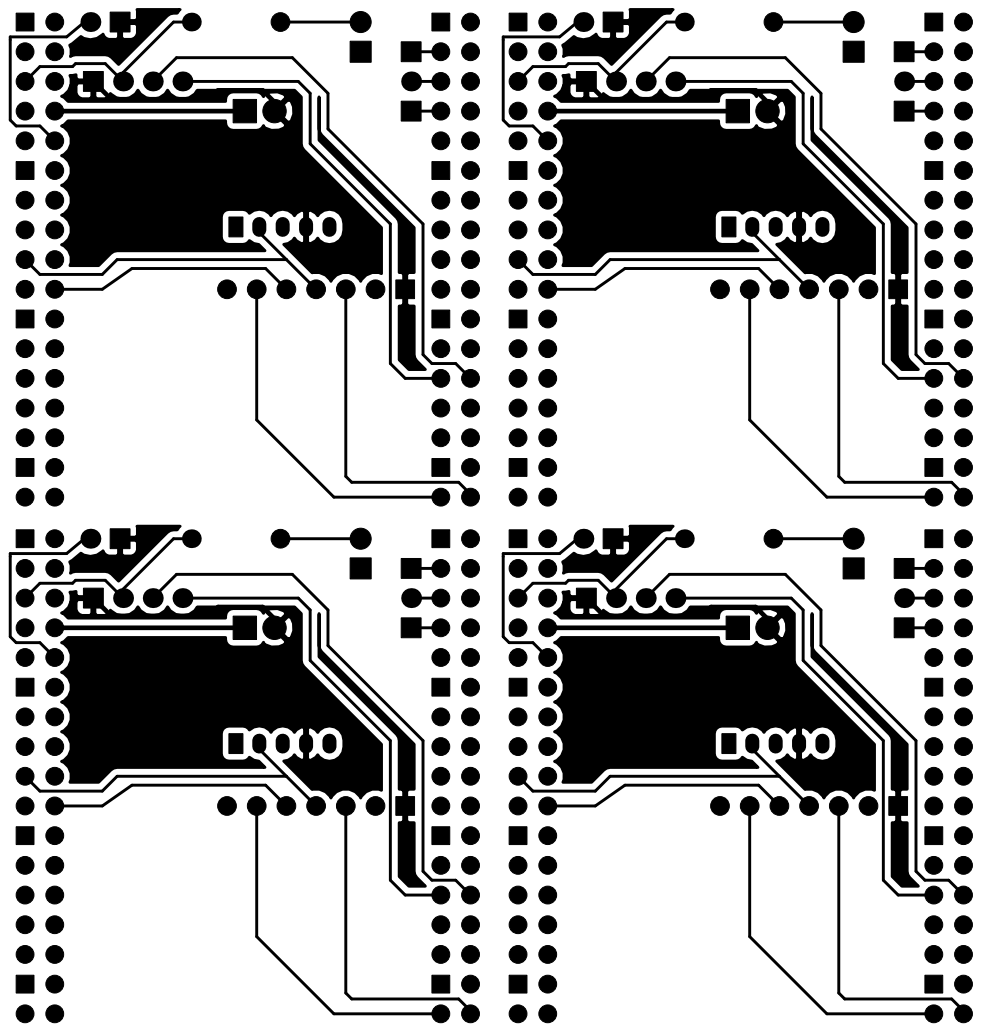
[picture p21: page 1]
