henla464/WiRocKiCad/KiCad6/Hardware_OLED_v1/PlotsPanelized/WiRoc-Panelized-F.SilkS.pdf

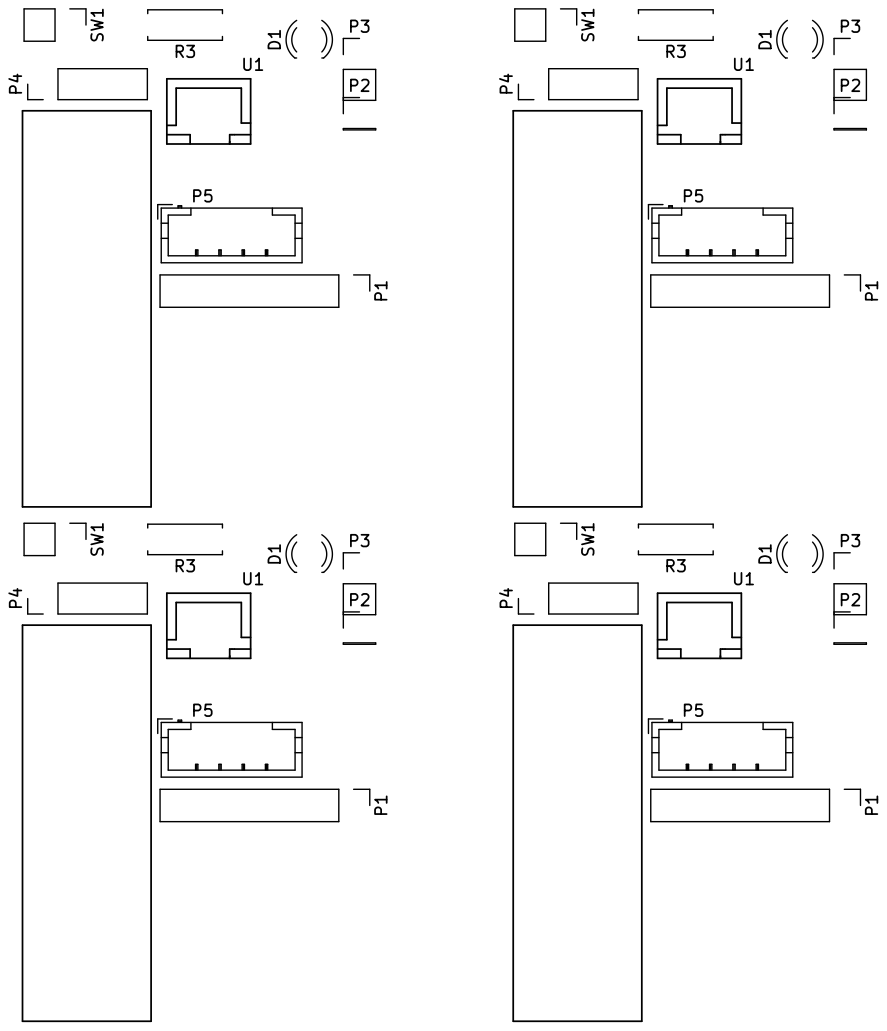
[picture p22: page 1]
