henla464/WiRocKiCad/KiCad6/Hardware_NanoPi_v4/Plots/WiRoc_NanoPi_v1.pdf

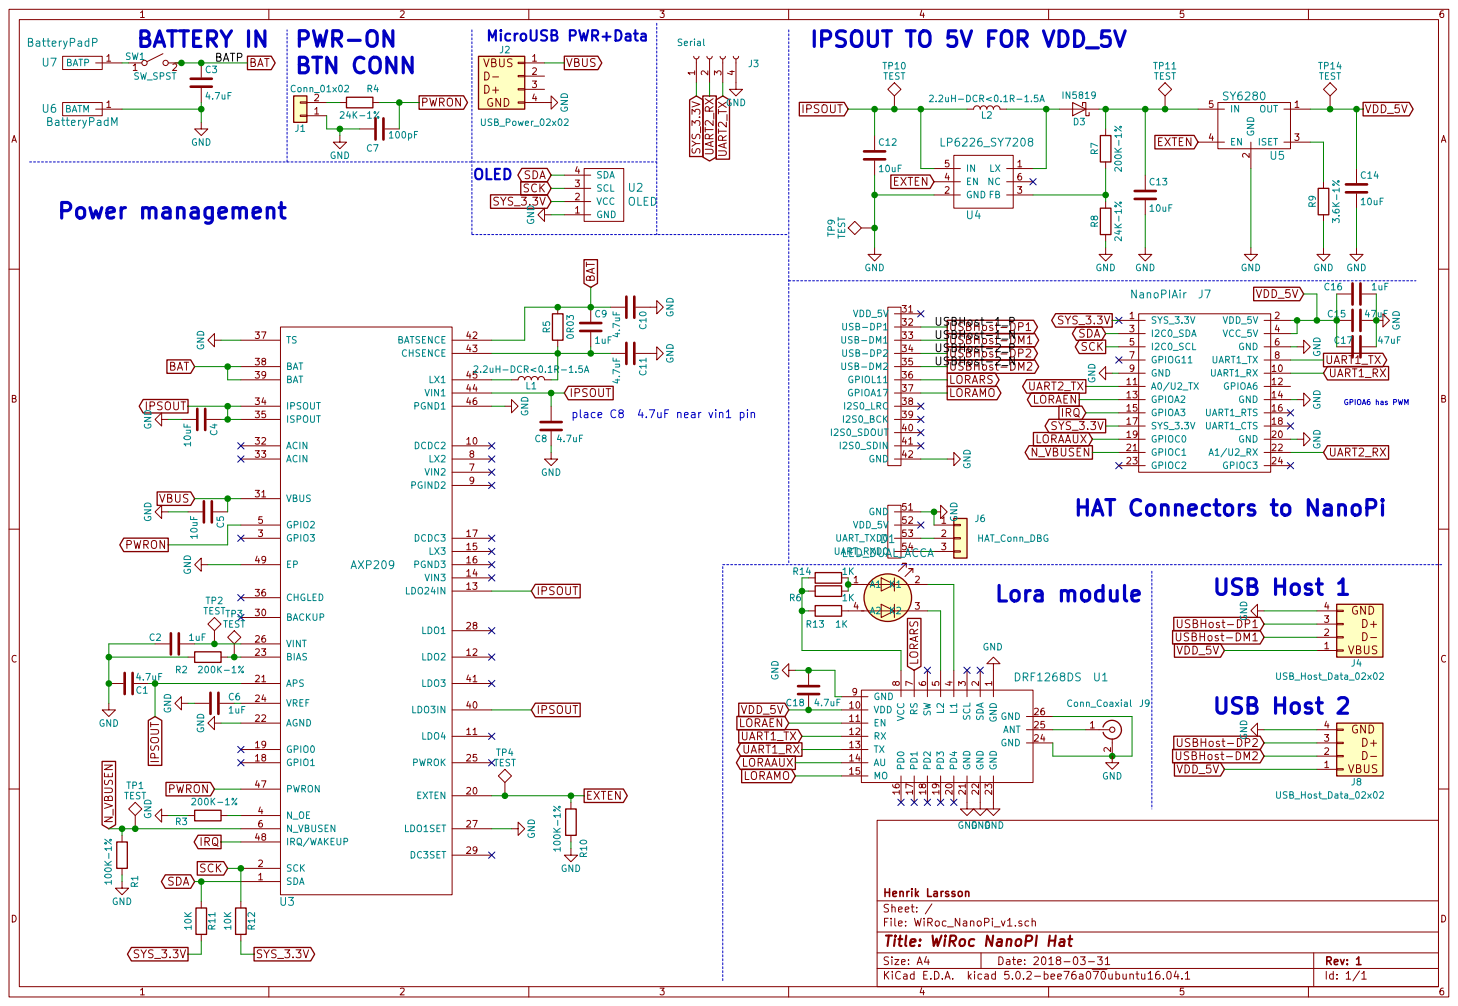
[picture p23: page 1]

HAT Connectors to NanoPi GND

1 VDD 10 EN 11 RX 12 TX 13 AU 14 MO 15 PD0 16 PD1 17 PD2 18 PD3 19 SDA

2 PD4 20 GND 21 GND 22 GND 23 GND 24 ANT 25 GND 26 SCL

File: WiRoc_NanoPi_v1.sch Sheet: / Henrik Larsson

Id: 1/1 Title: WiRoc NanoPI Hat
