henla464/WiRocKiCad/KiCad5/Hardware_v3/WiRoc_3.pdf

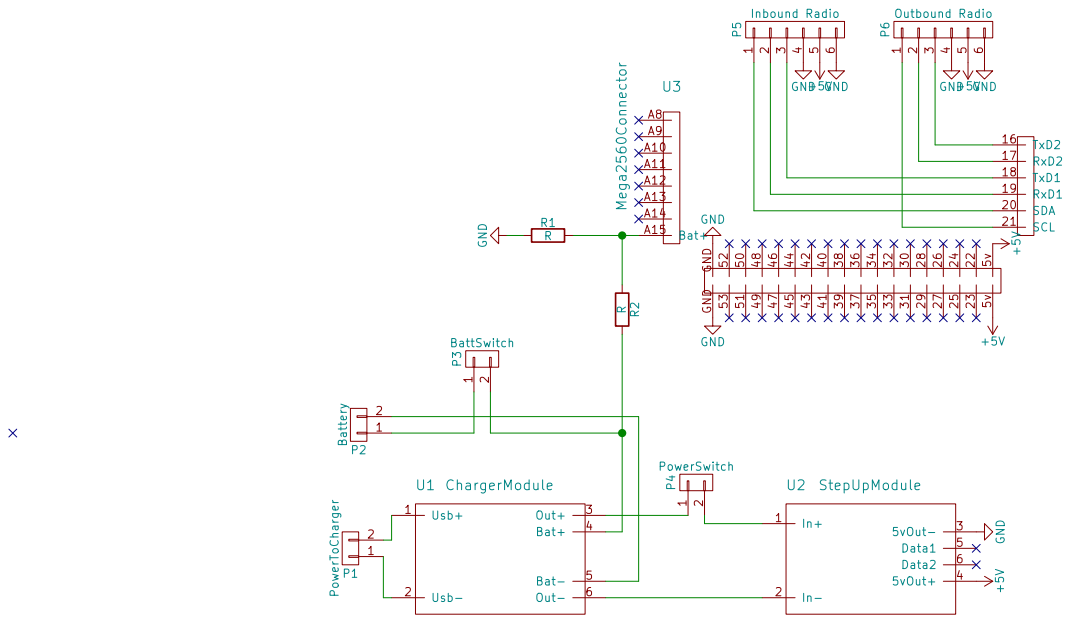
[picture p24: page 1]
