henla464/WiRocKiCad/KiCad5/Hardware_v3/plottest/WiRoc_3-B.Cu.pdf

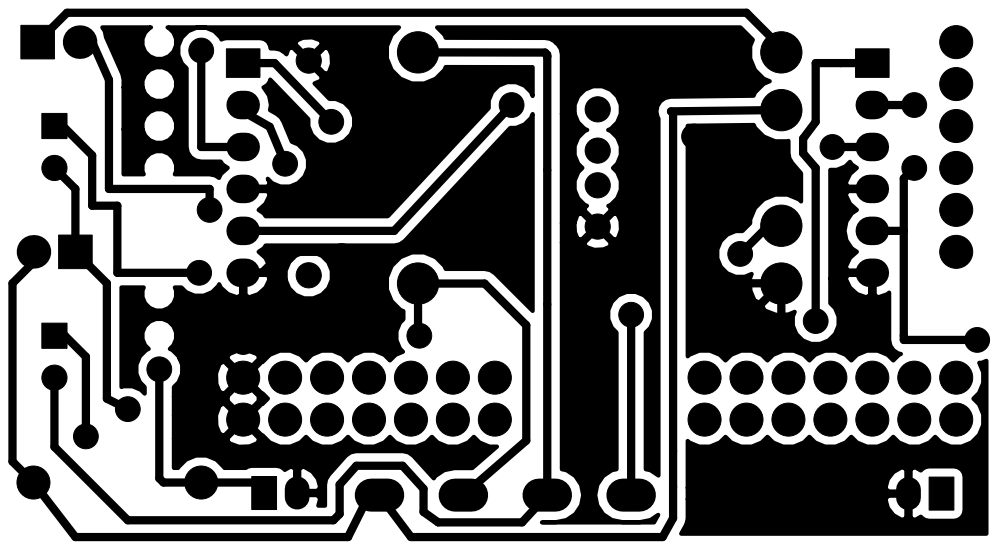
[picture p25: page 1]
