henla464/WiRocKiCad/KiCad5/Hardware_v3/plottest/WiRoc_3-F.Cu.pdf

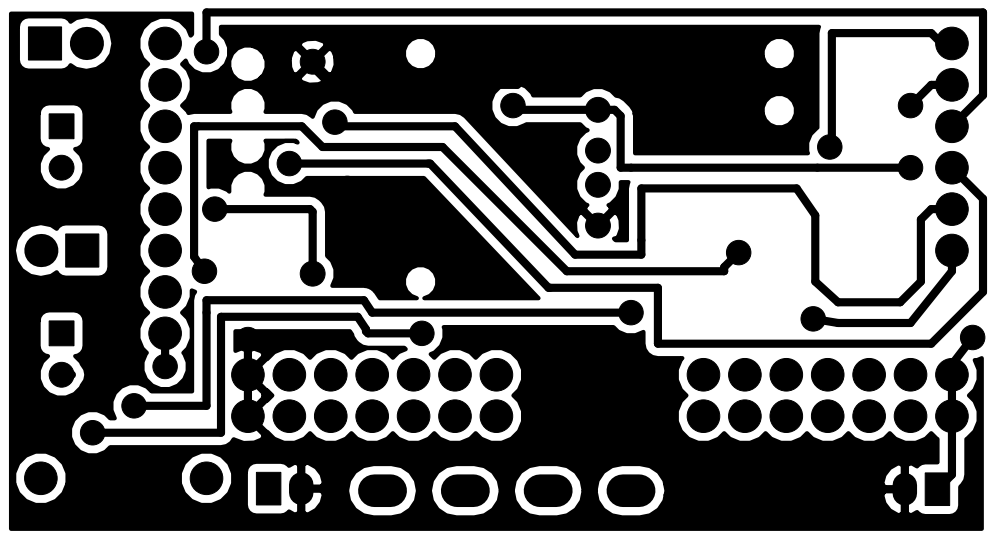
[picture p26: page 1]
