henla464/WiRocKiCad/KiCad6/Hardware_NanoPi_v1/Plots/WiRoc_NanoPi_v1.pdf

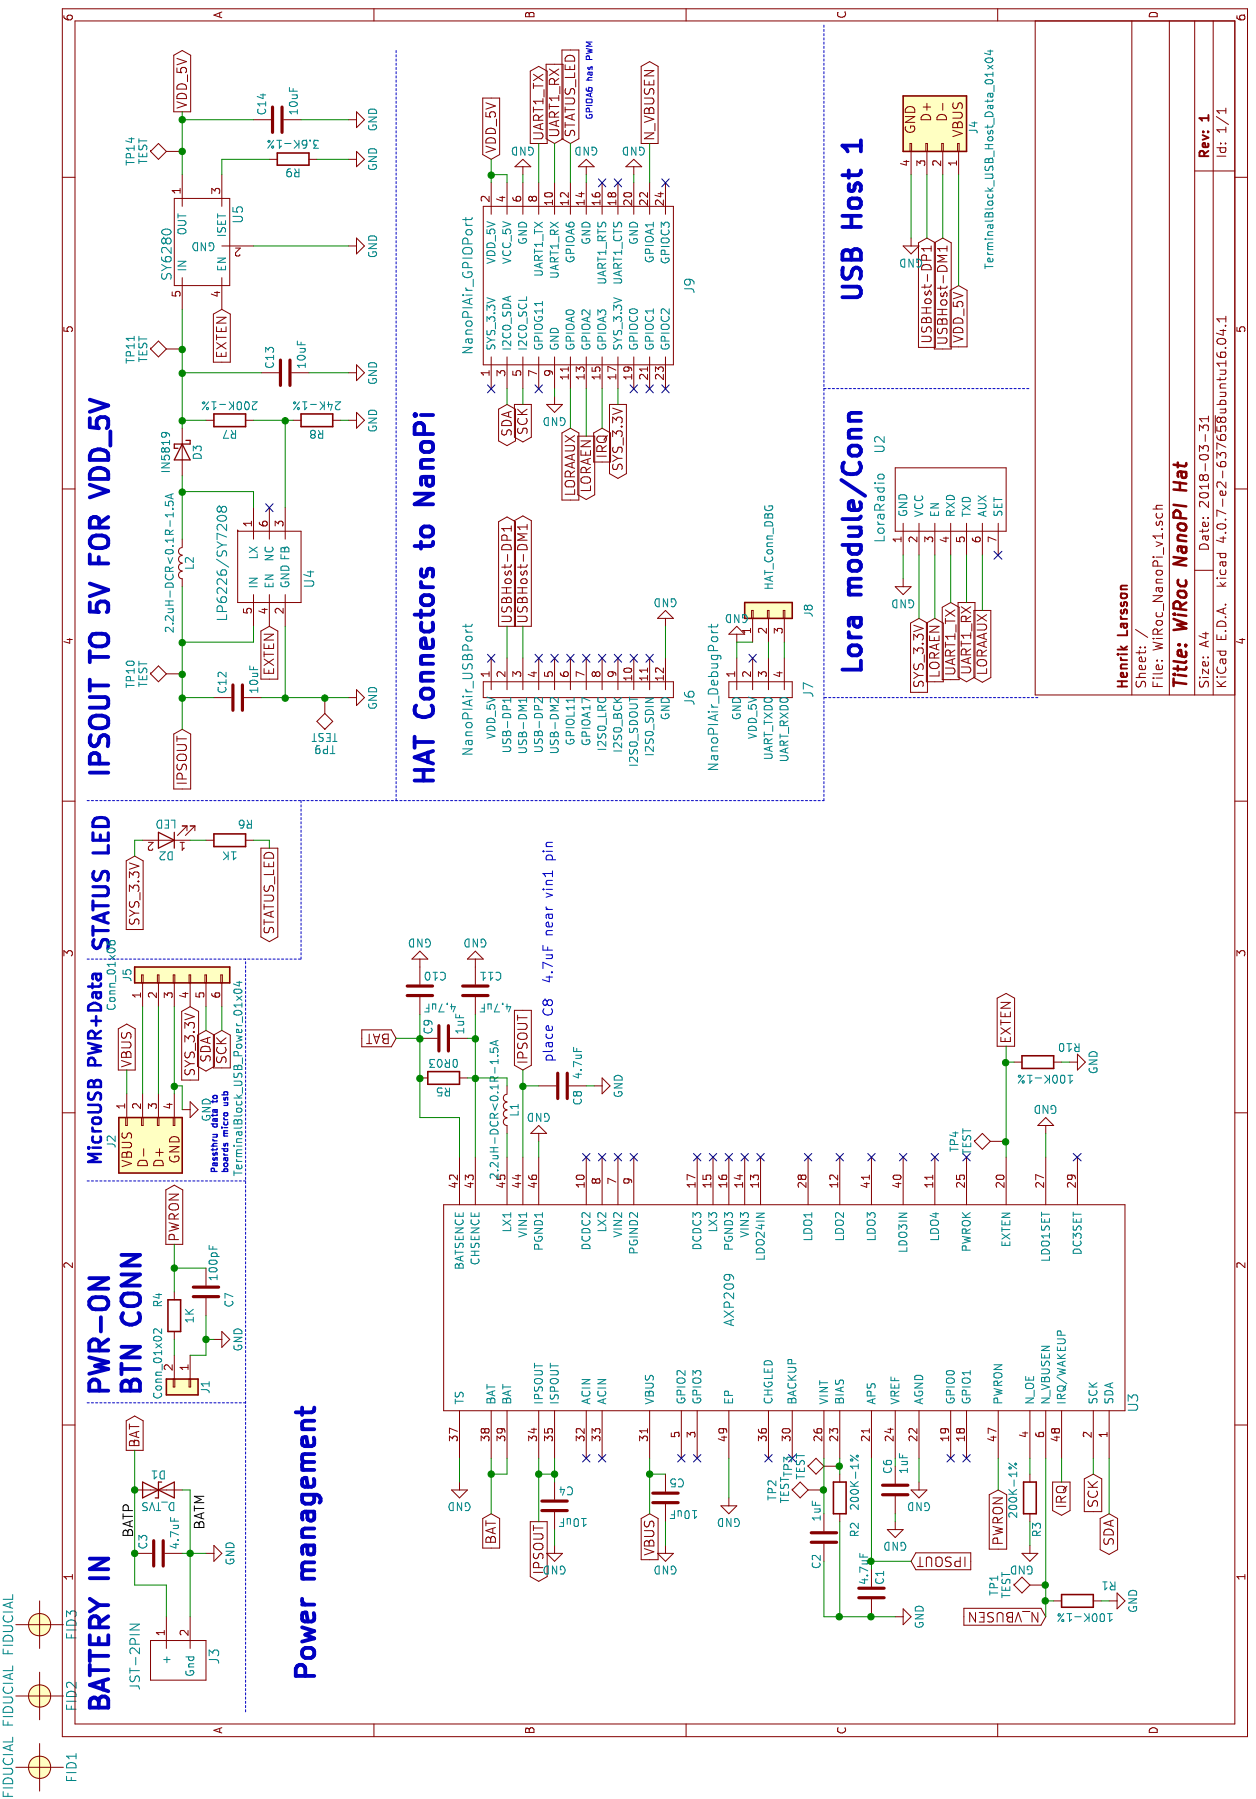
[picture p27: page 1]
