henla464/WiRocKiCad/KiCad6/Hardware_NanoPi_v2/Plots/WiRoc_NanoPi_v1-B.Cu.pdf

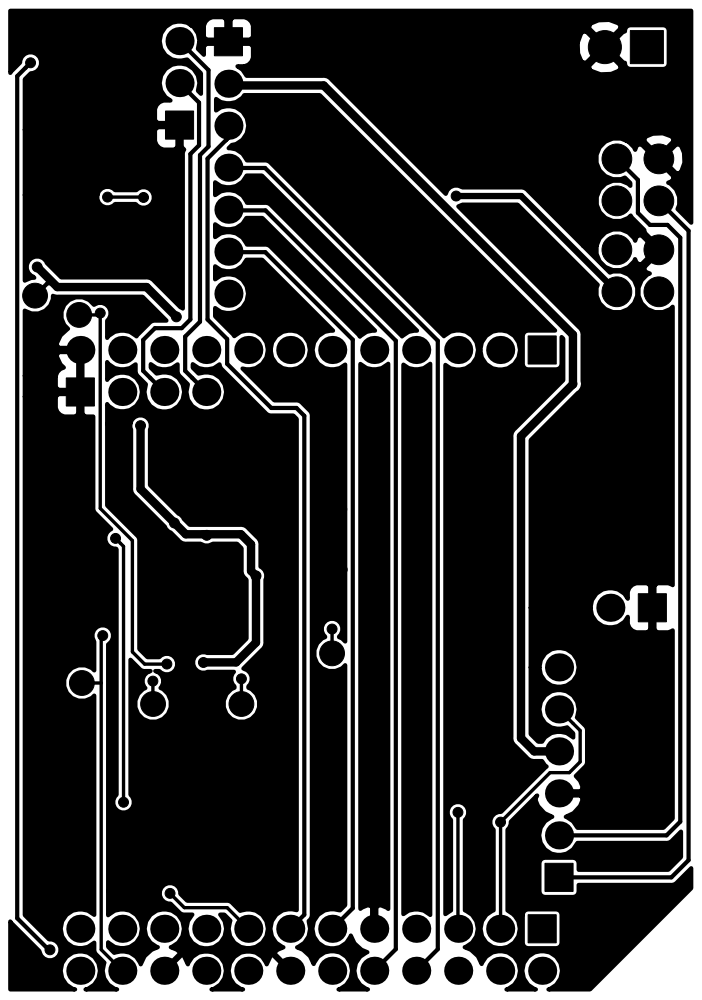
[picture p28: page 1]
