henla464/WiRocKiCad/KiCad6/Hardware_NanoPi_v2/Plots/WiRoc_NanoPi_v1-F.Cu.pdf

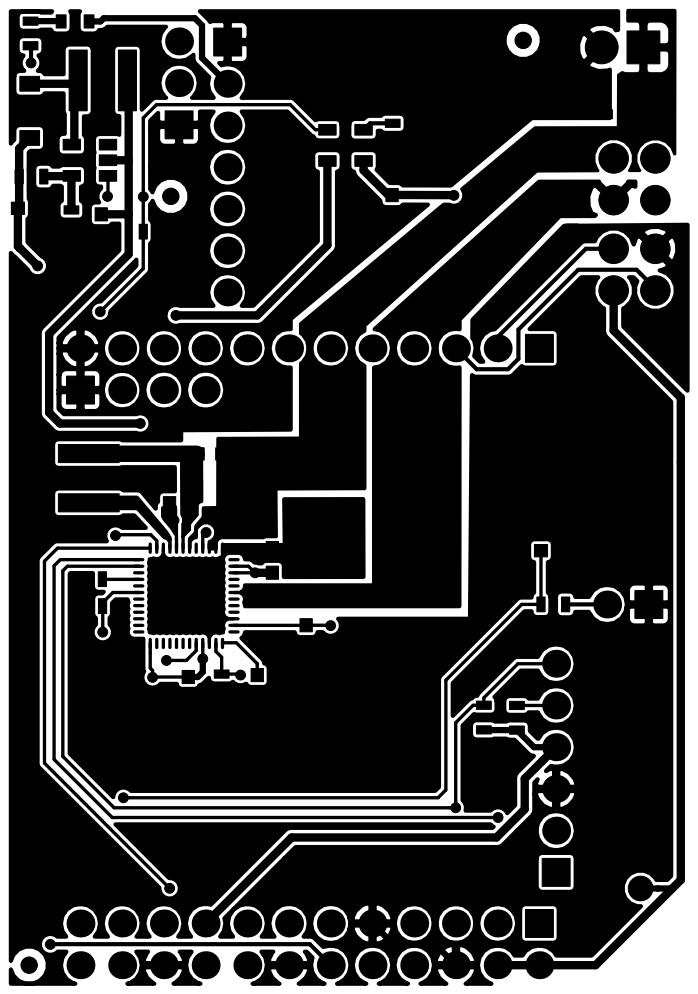
[picture p29: page 1]
