henla464/WiRocKiCad/KiCad10/WifiModuleBoard/WifiModuleBoard.kicad_pcb

## KiCad design KiCad10/WifiModuleBoard/WifiModuleBoard.kicad_pcb (2026-09-28)

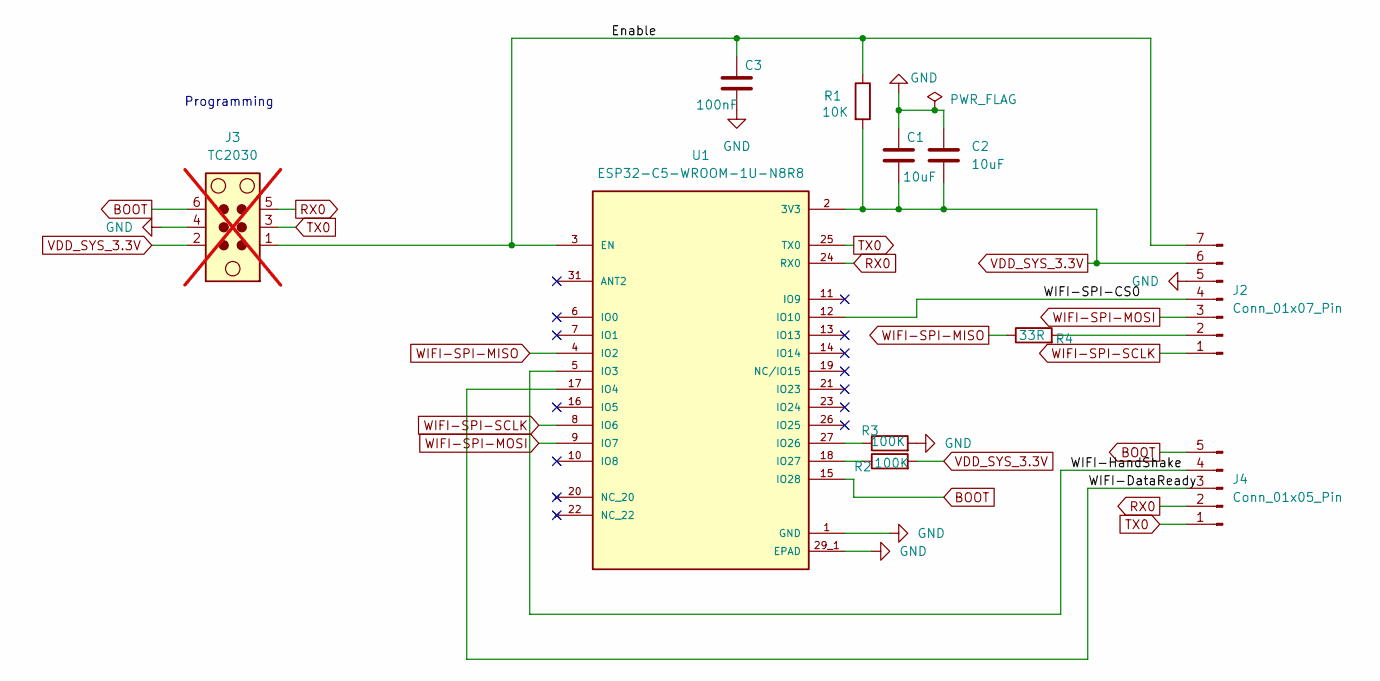
[picture p30: schematic WifiModuleBoard.kicad_sch]

Parts:
C1, C2: 10uF; C_0402_1005Metric_Pad0.74x0.62mm_HandSolder; ManufacturerPartNumber CL05A106MQ5NUNC; LCSC Part# C15525
C3: 100nF; C_0402_1005Metric_Pad0.74x0.62mm_HandSolder; ManufacturerPartNumber CL05B104KO5NNNC; LCSC Part# C1525
J2: Conn_01x07_Pin; PinSocket_1x07_P1.27mm_Vertical_SMD_Pin1Left
J3: TC2030; Tag-Connect_TC2030-IDC-NL_2x03_P1.27mm_Vertical; not fitted
J4: Conn_01x05_Pin; PinSocket_1x05_P1.27mm_Vertical_SMD_Pin1Left
R1: 10K; R_0402_1005Metric_Pad0.72x0.64mm_HandSolder; ManufacturerPartNumber 0402WGF1002TCE; LCSC Part# C25744
R2, R3: 100K; R_0402_1005Metric_Pad0.72x0.64mm_HandSolder; ManufacturerPartNumber 0402WGF1003TCE; LCSC Part# C25741
R4: 33R; R_0402_1005Metric_Pad0.72x0.64mm_HandSolder; ManufacturerPartNumber 0402WGF330JTCE; LCSC Part# C25105
U1: ESP32-C5-WROOM-1U-N8R8; XCVR_ESP32-C5-WROOM-1U-N8R8; PARTREV 0.7

Connections:
/Enable: C3.1, J2.7, J3.1, R1.1, U1.3 (EN)
/WIFI-DataReady: J4.3, U1.17 (IO4)
/WIFI-HandShake: J4.4, U1.5 (IO3)
/WIFI-SPI-CS0: J2.4, U1.12 (IO10)
BOOT: J3.6, J4.5, U1.15 (IO28)
GND: C1.1, C2.1, C3.2, J2.5, J3.4, R3.2, U1.1 (GND), U1.28 (GND), U1.29_1 (EPAD), U1.29_2 (EPAD), U1.29_3 (EPAD), U1.29_4 (EPAD), U1.29_5 (EPAD), U1.29_6 (EPAD), U1.29_7 (EPAD), U1.29_8 (EPAD), U1.29_9 (EPAD), U1.30 (GND), U1.32 (GND)
unnamed: J2.2, R4.2
unnamed: R3.1, U1.27 (IO26)
unnamed: R2.1, U1.18 (IO27)
RX0: J3.5, J4.2, U1.24 (RX0)
TX0: J3.3, J4.1, U1.25 (TX0)
VDD_SYS_3.3V: C1.2, C2.2, J2.6, J3.2, R1.2, R2.2, U1.2 (3V3)
WIFI-SPI-MISO: R4.1, U1.4 (IO2)
WIFI-SPI-MOSI: J2.3, U1.9 (IO7)
WIFI-SPI-SCLK: J2.1, U1.8 (IO6)

Notes on the sheet:
Programming

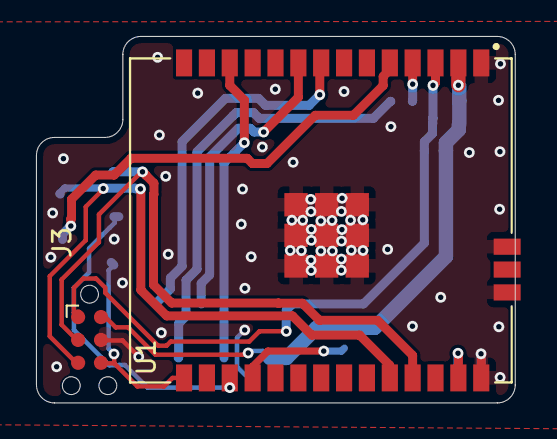
[picture p31: board WifiModuleBoard.kicad_pcb from above]

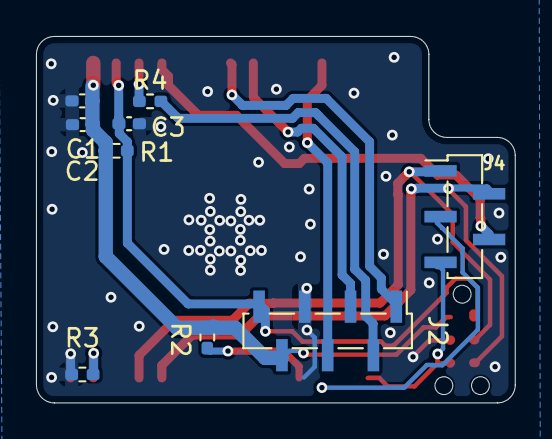
[picture p32: board WifiModuleBoard.kicad_pcb from below]

Board: 2 copper layers, 26.6 x 20.4 mm, 11 parts (9 on the bottom side), 15 nets.
