henla464/WiRocKiCad/KiCad10/WiRoc_v8_USBConnectorPlate/WiRoc_v8_USBConnectorPlate.kicad_pcb

## KiCad design KiCad10/WiRoc_v8_USBConnectorPlate/WiRoc_v8_USBConnectorPlate.kicad_pcb (2026-09-28)

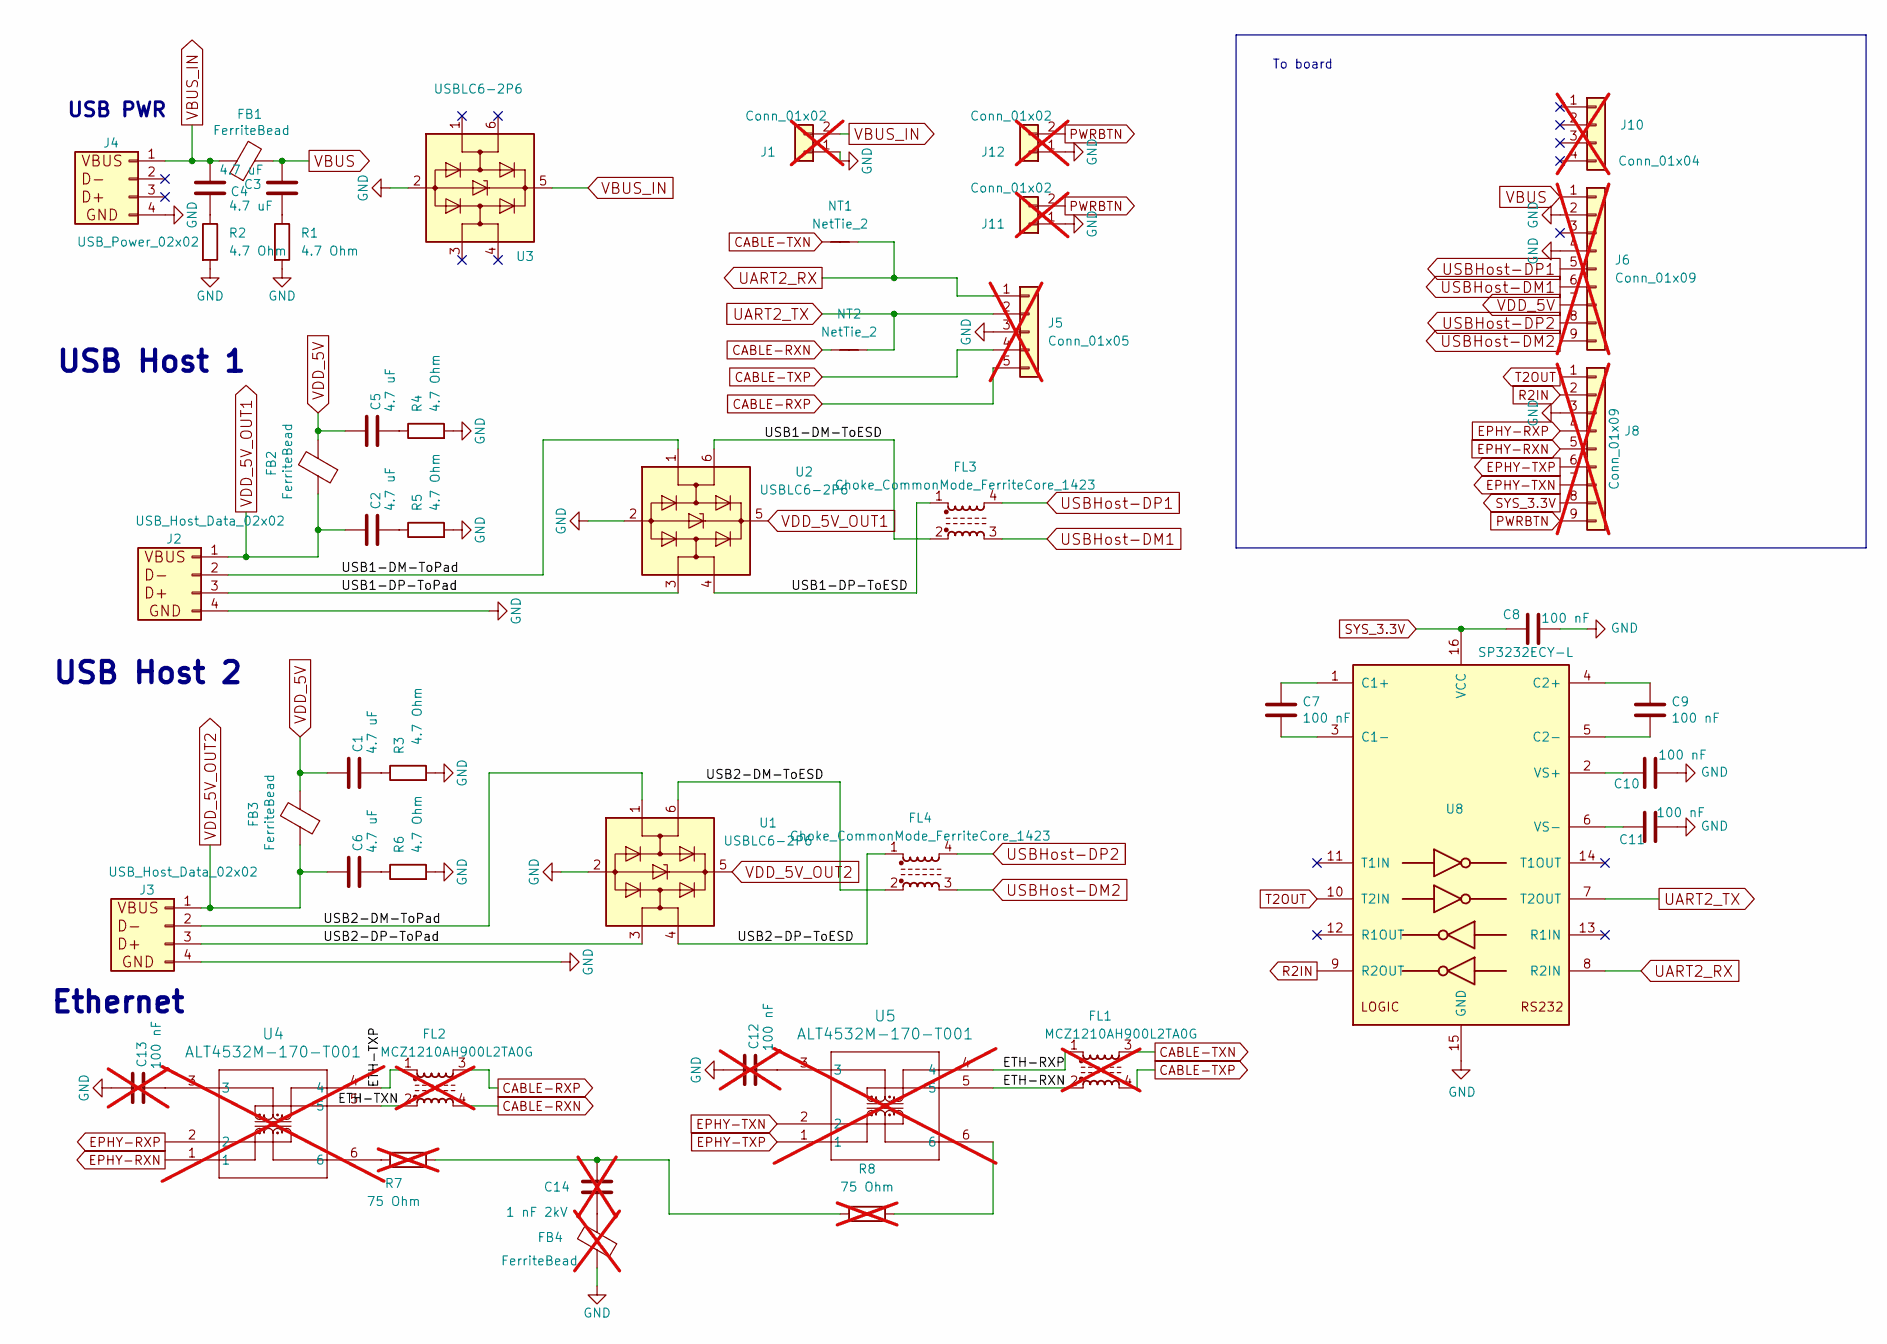
[picture p33: schematic WiRoc_v8_USBConnectorPlate.kicad_sch]

Parts:
C1, C2, C3, C4, C5, C6: 4.7 uF; C_0402_1005Metric; PartNumber CL05A475MP5NRNC; LCSC C23733
C7: 100 nF; C_0402_1005Metric; ManufacturerPartNumber CC0603KRX7R9BB104; LCSC Part # C1525
C8, C9, C10, C11: 100 nF; C_0402_1005Metric; ManufacturerPartNumber CC0603KRX7R9BB104; LCSC Part # C307331
C12, C13: 100 nF; C_0402_1005Metric; PartNumber CL05A475MP5NRNC; LCSC C307331; not fitted
C14: 1 nF 2kV; C_1206_3216Metric; PartNumber CL05A475MP5NRNC; LCSC C9196; not fitted
FB1, FB2: FerriteBead; L_1206_3216Metric; LCSC C16902
FB3: FerriteBead; L_1206_3216Metric; PartNumber BLM31PG601SN1; LCSC C16902
FB4: FerriteBead; L_1206_3216Metric; PartNumber BLM31PG601SN1; LCSC C16902; not fitted
FL1, FL2: MCZ1210AH900L2TA0G; MCZ1210AH_L2_TDK; LCSC C114784; not fitted
FL3, FL4: Choke_CommonMode_FerriteCore_1423; 0805_CommonModeChoke_1423; LCSC C49023314
J1, J11: Conn_01x02; PinHeader_1x02_P2.54mm_Horizontal; not fitted
J2: USB_Host_Data_02x02; USBConnPads7
J3: USB_Host_Data_02x02; USBConnPads8
J4: USB_Power_02x02; USBConnPads7
J5: Conn_01x05; SerialAndEthConnPads4Pin; not fitted
J6, J8: Conn_01x09; PinHeader_1x09_P1.27mm_Horizontal; not fitted
J10: Conn_01x04; PinHeader_1x04_P1.27mm_Horizontal; not fitted
J12: Conn_01x02; PwrBtnPads; not fitted
NT1, NT2: NetTie_2; NetTie-2_SMD_Pad0.3mm
R1, R2, R3, R4, R5, R6: 4.7 Ohm; R_0603_1608Metric; PartNumber 0603WAF470KT5E; LCSC C23164
R7, R8: 75 Ohm; R_0603_1608Metric; LCSC C4275; not fitted
U1, U2, U3: USBLC6-2P6; SOT-666; LCSC C15999
U4, U5: ALT4532M-170-T001; ALT4532M_TDK; LCSC C2845101; not fitted
U8: SP3232ECY-L; TSSOP-16_4.4x5mm_P0.65mm_PartOfSilkscreenRemoved; ManufacturerPartNumber SP3232ECY-L; LCSC Part # C3028967

Connections:
/ETH-RXN: FL1.2, U5.5
/ETH-RXP: FL1.1, U5.4
/ETH-TXN: FL2.2, U4.5
/ETH-TXP: FL2.1, U4.4
/USB1-DM-ToESD: FL3.2, U2.6 (I/O1)
/USB1-DM-ToPad: J2.2, U2.1 (I/O1)
/USB1-DP-ToESD: FL3.1, U2.4 (I/O2)
/USB1-DP-ToPad: J2.3, U2.3 (I/O2)
/USB2-DM-ToESD: FL4.2, U1.6 (I/O1)
/USB2-DM-ToPad: J3.2, U1.1 (I/O1)
/USB2-DP-ToESD: FL4.1, U1.4 (I/O2)
/USB2-DP-ToPad: J3.3, U1.3 (I/O2)
CABLE-RXN: FL2.4, NT2.1
CABLE-RXP: FL2.3, J5.5
CABLE-TXN: FL1.3, NT1.1
CABLE-TXP: FL1.4, J5.4
EPHY-RXN: J8.5, U4.1
EPHY-RXP: J8.4, U4.2
EPHY-TXN: J8.7, U5.2
EPHY-TXP: J8.6, U5.1
GND: C8.1, C10.1, C11.1, C12.1, C13.1, FB4.1, J1.1, J2.4, J3.4, J4.4, J5.3, J6.2, J6.4, J8.3, J11.1, J12.1, R1.2, R2.2, R3.2, R4.2, R5.2, R6.2, U1.2 (GND), U2.2 (GND), U3.2 (GND), U8.15 (GND)
unnamed: C1.2, R3.1
unnamed: C2.2, R5.1
unnamed: C3.1, R1.1
unnamed: C4.2, R2.1
unnamed: C5.2, R4.1
unnamed: C6.2, R6.1
unnamed: C12.2, U5.3
unnamed: C13.2, U4.3
unnamed: C14.1, R7.2, R8.2
unnamed: C14.2, FB4.2
unnamed: R7.1, U4.6
unnamed: R8.1, U5.6
unnamed: C7.1, U8.1 (C1+)
unnamed: C7.2, U8.3 (C1-)
unnamed: C9.1, U8.4 (C2+)
unnamed: C9.2, U8.5 (C2-)
unnamed: C10.2, U8.2 (VS+)
unnamed: C11.2, U8.6 (VS-)
PWRBTN: J8.9, J11.2, J12.2
R2IN: J8.2, U8.9 (R2OUT)
SYS_3.3V: C8.2, J8.8, U8.16 (VCC)
T2OUT: J8.1, U8.10 (T2IN)
UART2_RX: J5.1, NT1.2, U8.8 (R2IN)
UART2_TX: J5.2, NT2.2, U8.7 (T2OUT)
USBHost-DM1: FL3.3, J6.6
USBHost-DM2: FL4.3, J6.9
USBHost-DP1: FL3.4, J6.5
USBHost-DP2: FL4.4, J6.8
VBUS: C3.2, FB1.2, J6.1
VBUS_IN: C4.1, FB1.1, J1.2, J4.1, U3.5 (VBUS)
VDD_5V: C1.1, C5.1, FB2.2, FB3.2, J6.7
VDD_5V_OUT1: C2.1, FB2.1, J2.1, U2.5 (VBUS)
VDD_5V_OUT2: C6.1, FB3.1, J3.1, U1.5 (VBUS)

Notes on the sheet:
USB PWR
USB Host 1
Ethernet
To board
USB Host 2

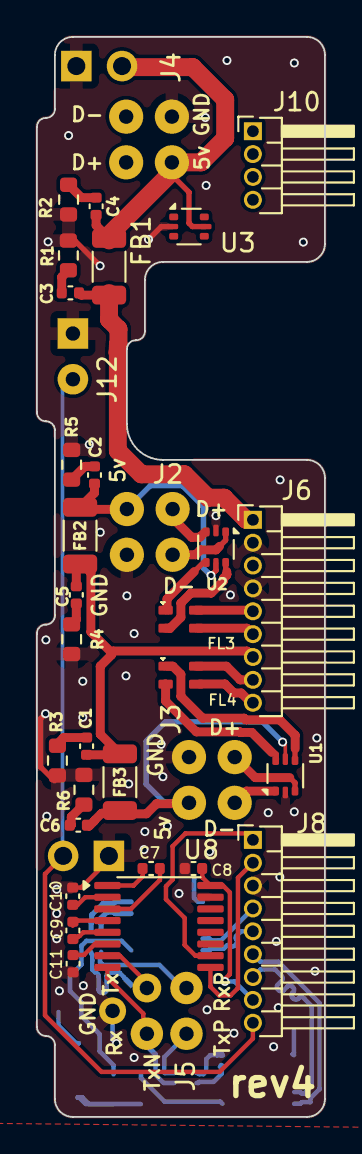
[picture p34: board WiRoc_v8_USBConnectorPlate.kicad_pcb from above]

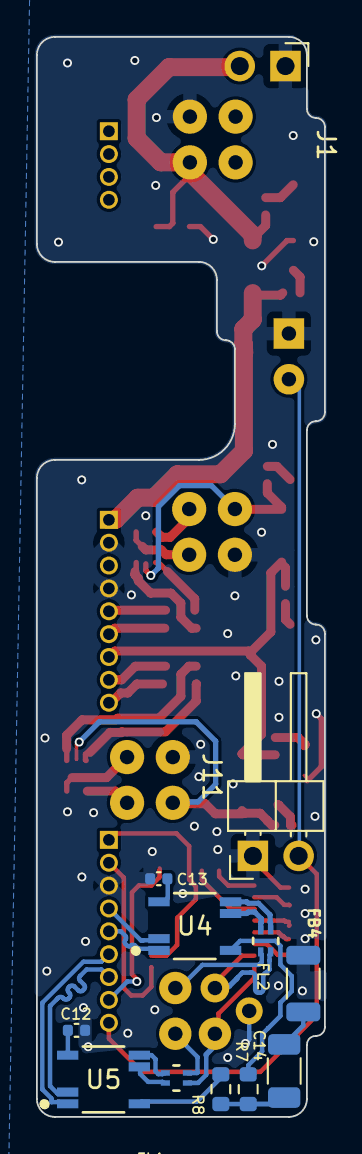
[picture p35: board WiRoc_v8_USBConnectorPlate.kicad_pcb from below]

Board: 2 copper layers, 16.0 x 60.0 mm, 48 parts (14 on the bottom side), 54 nets.
