henla464/WiRocKiCad/KiCad10/SRRReceiver_v6/SRRReceiver.kicad_pcb

## KiCad design KiCad10/SRRReceiver_v6/SRRReceiver.kicad_pcb (2026-09-28)

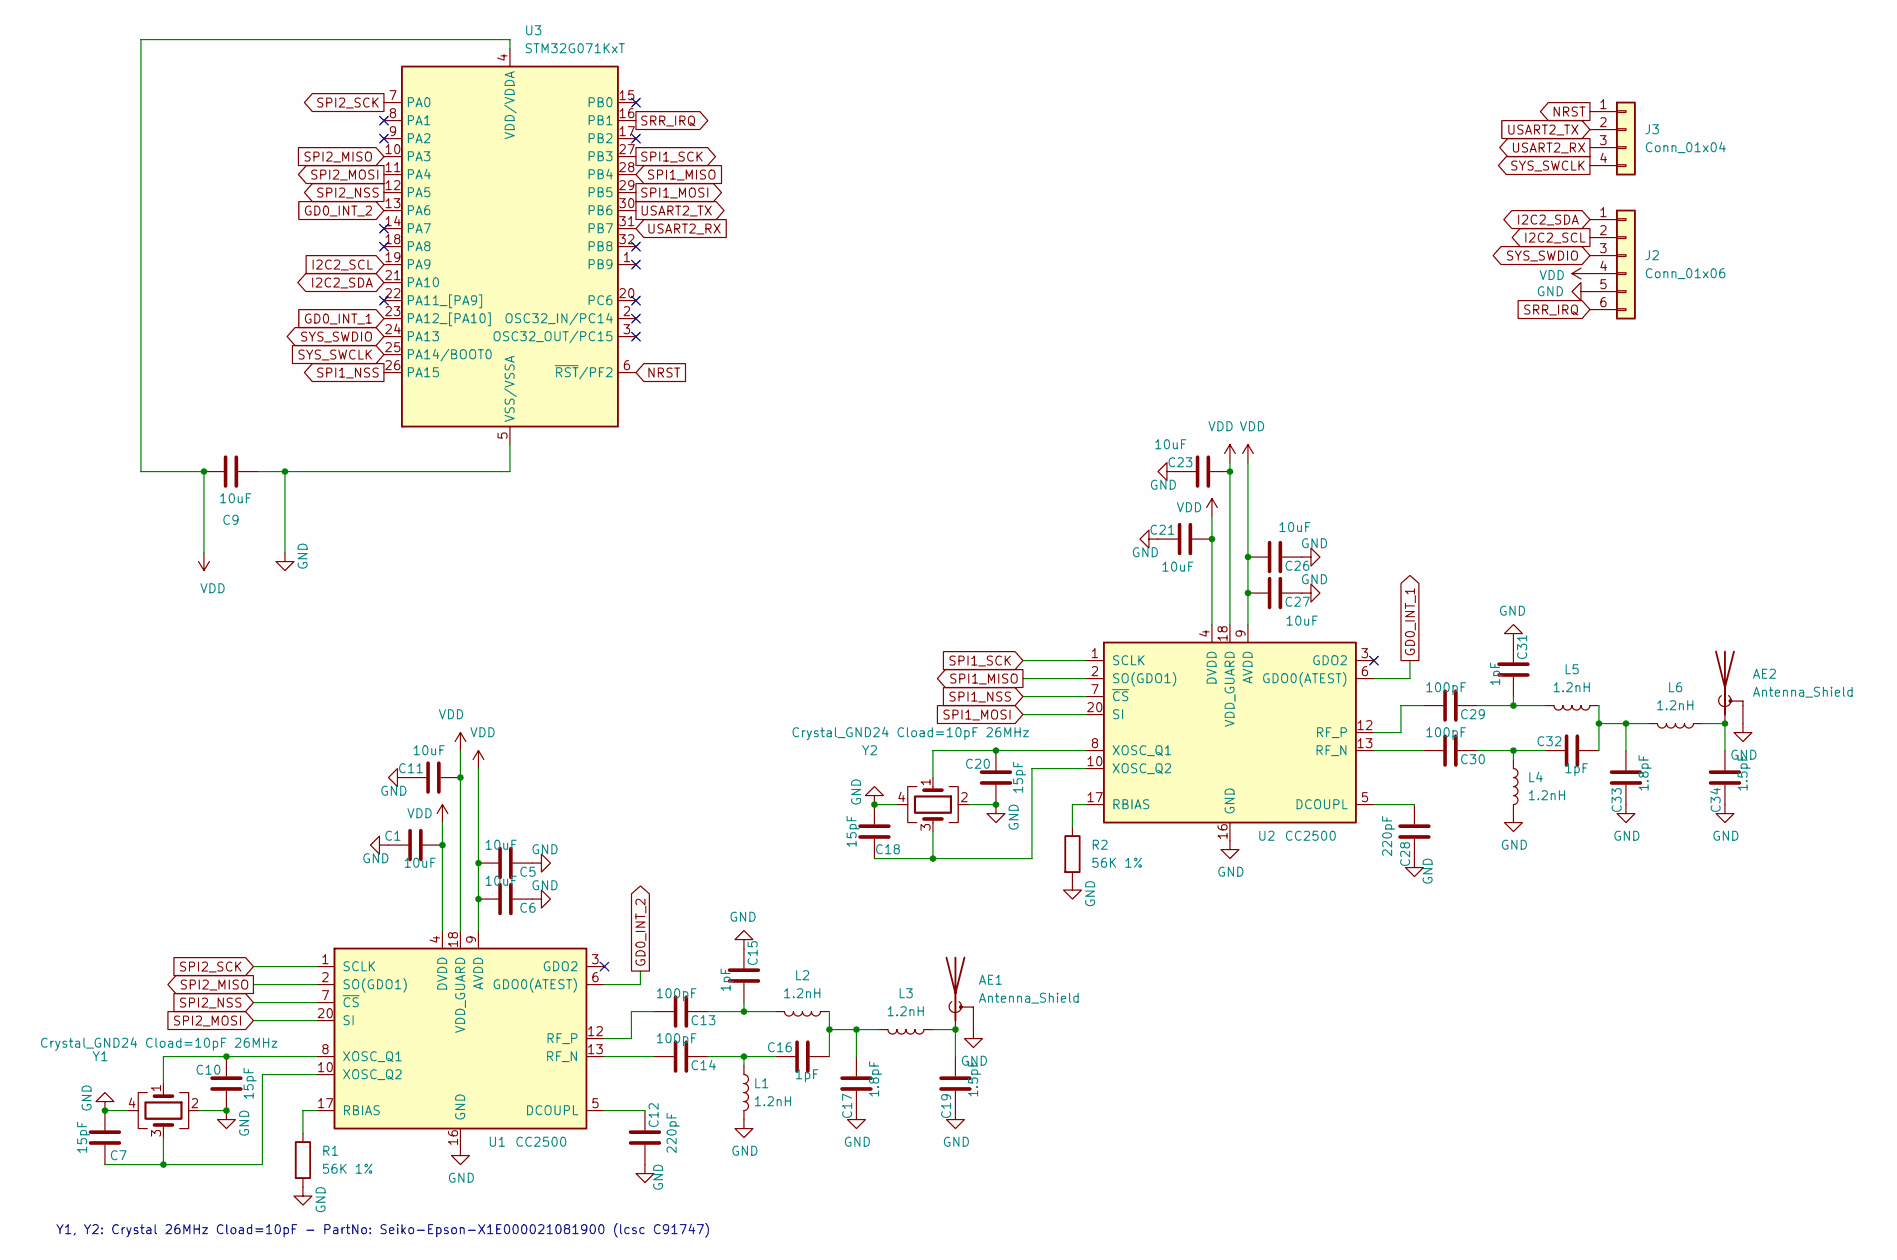
[picture p36: schematic SRRReceiver.kicad_sch]

Parts:
AE1, AE2: Antenna_Shield; Texas_SWRA117D_2.4GHz_Right-TunedForWiroc
C1, C5, C6, C11, C21, C23, C26, C27: 10uF; C_0402_1005Metric; LCSC C15525
C7, C10, C18, C20: 15pF; C_0402_1005Metric; LCSC C1548
C9: 10uF; C_0402_1005Metric_Pad0.74x0.62mm_HandSolder; LCSC C15525
C12, C28: 220pF; C_0402_1005Metric; LCSC C16772
C13, C14, C29, C30: 100pF; C_0402_1005Metric; LCSC C1546
C15, C16, C31, C32: 1pF; C_0402_1005Metric; LCSC C1550
C17, C33: 1.8pF; C_0402_1005Metric; LCSC C76902
C19, C34: 1.5pF; C_0402_1005Metric; LCSC C282238
J2: Conn_01x06; PinSocket_1x06_P1.27mm_Vertical
J3: Conn_01x04; PinSocket_1x04_P1.27mm_Vertical
L1, L2, L3, L4, L5, L6: 1.2nH; L_0402_1005Metric; LCSC C445745
R1, R2: 56K 1%; R_0402_1005Metric; LCSC C25796
U1, U2: CC2500; Texas_S-PVQFN-N20_EP2.4x2.4mm; LCSC C57494
U3: STM32G071KxT; LQFP-32_7x7mm_P0.8mm; LCSC C529339
Y1, Y2: Crystal_GND24 Cload=10pF 26MHz; Crystal_SMD_3225-4Pin_3.2x2.5mm; LCSC C91747

Connections:
GD0_INT_1: U2.6 (GDO0(ATEST)), U3.23 (PA12_[PA10])
GD0_INT_2: U1.6 (GDO0(ATEST)), U3.13 (PA6)
GND: AE1.2 (Shield), AE2.2 (Shield), C1.1, C5.1, C6.1, C7.1, C9.1, C10.1, C11.1, C12.2, C15.1, C17.1, C18.1, C19.1, C20.1, C21.1, C23.1, C26.1, C27.1, C28.1, C31.1, C33.1, C34.1, J2.5, L1.2, L4.2, R1.2, R2.2, U1.16 (GND), U1.19 (GND), U1.21 (GND), U2.16 (GND), U2.19 (GND), U2.21 (GND), U3.5 (VSS/VSSA), Y1.2, Y1.4, Y2.2, Y2.4
I2C2_SCL: J2.2, U3.19 (PA9)
I2C2_SDA: J2.1, U3.21 (PA10)
NRST: J3.1, U3.6 (~RST/PF2)
unnamed: AE1.1 (A), C19.2, L3.1
unnamed: AE2.1 (A), C34.2, L6.1
unnamed: C13.1, C15.2, L2.2
unnamed: C14.1, C16.1, L1.1
unnamed: C16.2, C17.2, L2.1, L3.2
unnamed: C29.1, C31.2, L5.2
unnamed: C30.1, C32.1, L4.1
unnamed: C32.2, C33.2, L5.1, L6.2
unnamed: C12.1, U1.5 (DCOUPL)
unnamed: R1.1, U1.17 (RBIAS)
unnamed: C14.2, U1.13 (RF_N)
unnamed: C13.2, U1.12 (RF_P)
unnamed: C10.2, U1.8 (XOSC_Q1), Y1.1
unnamed: C7.2, U1.10 (XOSC_Q2), Y1.3
unnamed: C28.2, U2.5 (DCOUPL)
unnamed: R2.1, U2.17 (RBIAS)
unnamed: C30.2, U2.13 (RF_N)
unnamed: C29.2, U2.12 (RF_P)
unnamed: C20.2, U2.8 (XOSC_Q1), Y2.1
unnamed: C18.2, U2.10 (XOSC_Q2), Y2.3
SPI1_MISO: U2.2 (SO(GDO1)), U3.28 (PB4)
SPI1_MOSI: U2.20 (SI), U3.29 (PB5)
SPI1_NSS: U2.7 (~CS), U3.26 (PA15)
SPI1_SCK: U2.1 (SCLK), U3.27 (PB3)
SPI2_MISO: U1.2 (SO(GDO1)), U3.10 (PA3)
SPI2_MOSI: U1.20 (SI), U3.11 (PA4)
SPI2_NSS: U1.7 (~CS), U3.12 (PA5)
SPI2_SCK: U1.1 (SCLK), U3.7 (PA0)
SRR_IRQ: J2.6, U3.16 (PB1)
SYS_SWCLK: J3.4, U3.25 (PA14/BOOT0)
SYS_SWDIO: J2.3, U3.24 (PA13)
USART2_RX: J3.3, U3.31 (PB7)
USART2_TX: J3.2, U3.30 (PB6)
VDD: C1.2, C5.2, C6.2, C9.2, C11.2, C21.2, C23.2, C26.2, C27.2, J2.4, U1.4 (DVDD), U1.9 (AVDD), U1.11 (AVDD), U1.14 (AVDD), U1.15 (AVDD), U1.18 (VDD_GUARD), U2.4 (DVDD), U2.9 (AVDD), U2.11 (AVDD), U2.14 (AVDD), U2.15 (AVDD), U2.18 (VDD_GUARD), U3.4 (VDD/VDDA)

Notes on the sheet:
Y1, Y2: Crystal 26MHz Cload=10pF - PartNo: Seiko-Epson-X1E000021081900 (lcsc C91747)

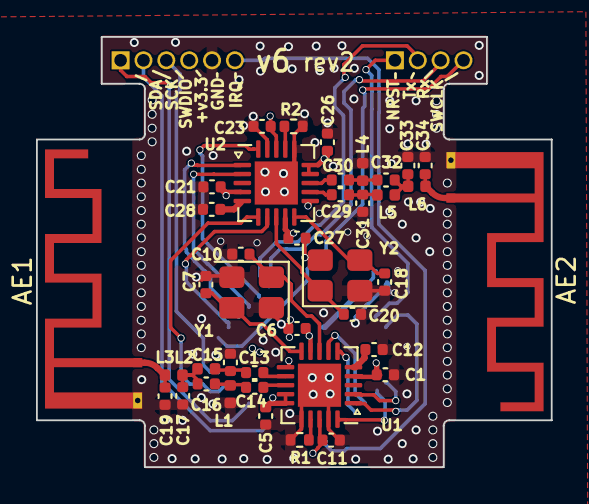
[picture p37: board SRRReceiver.kicad_pcb from above]

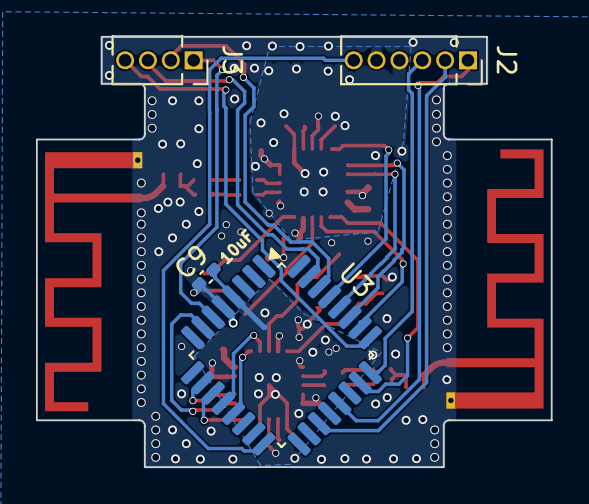
[picture p38: board SRRReceiver.kicad_pcb from below]

Board: 4 copper layers, 28.6 x 23.9 mm, 44 parts (4 on the bottom side), 40 nets.
