henla464/WiRocKiCad/KiCad10/WiRoc_v8/WiRoc_NanoPi.kicad_pcb

## KiCad design KiCad10/WiRoc_v8/WiRoc_NanoPi.kicad_pcb (2026-09-28)

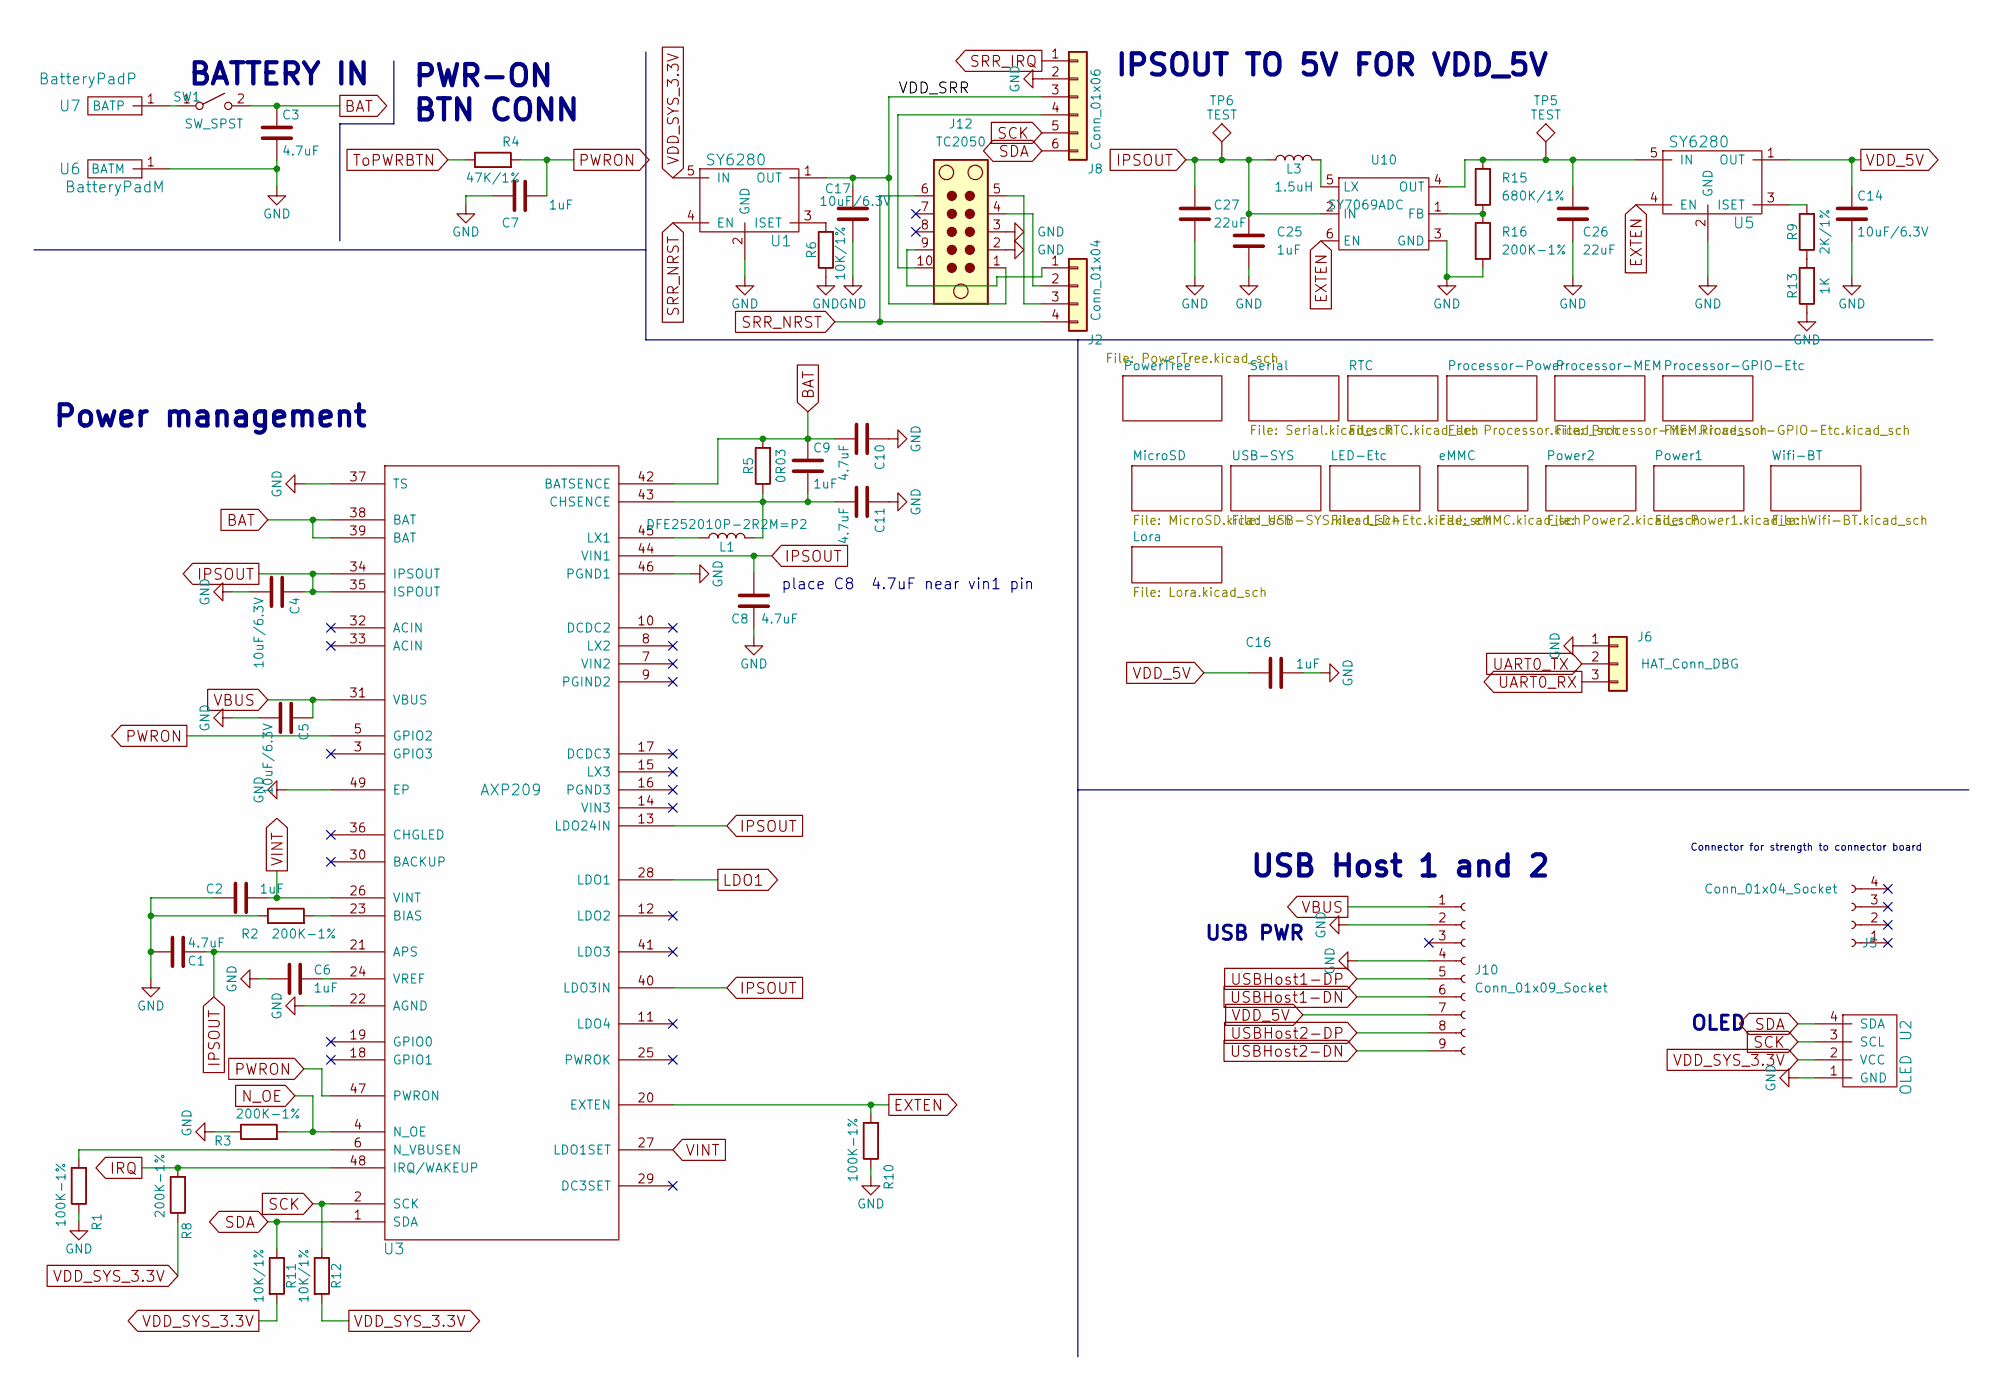
[picture p39: schematic WiRoc_NanoPi.kicad_sch, WiRoc]

Parts:
C1, C3, C8, C10, C11: 4.7uF; C_0402_1005Metric; ManufacturerPartNumber CL05A475MP5NRNC; LCSC Part # C23733
C2, C6, C7, C9, C16, C25: 1uF; C_0402_1005Metric; ManufacturerPartNumber CL05A105KA5NQNC; LCSC Part # C52923
C4, C5, C14, C17: 10uF/6.3V; C_0402_1005Metric; ManufacturerPartNumber CL05A106MQ5NUNC; LCSC Part # C15525
C26, C27: 22uF; C_0603_1608Metric; ManufacturerPartNumber GRM188R61A226ME15D; LCSC Part # C84419
J2: Conn_01x04; PinSocket_1x04_P1.27mm_RightAngled
J5: Conn_01x04_Socket; PinSocket_1x04_P1.27mm_Vertical; ManufacturerPartNumber PM127V-11-04-H46; JLCBasicExtended Extended
J6: HAT_Conn_DBG; Pin_Header_Straight_1x03_Pitch2.54mm; ManufacturerPartNumber 2.54mm 1x40P
J8: Conn_01x06; PinSocket_1x06_P1.27mm_RightAngled
J10: Conn_01x09_Socket; PinSocket_1x09_P1.27mm_Vertical; ManufacturerPartNumber PM127V-11-09-H46; JLCBasicExtended Extended
J12: TC2050; Tag-Connect_TC2050-IDC-NL_2x05_P1.27mm_Vertical
L1: DFE252010P-2R2M=P2; L_1008_2520Metric; ManufacturerPartNumber DFE252012F‑2R2M=P2; LCSC Part # C576403
L3: 1.5uH; L_1008_2520Metric; ManufacturerPartNumber DFE252012F-1R5M=P2; LCSC Part # C909806
R1, R10: 100K-1%; R_0402_1005Metric; ManufacturerPartNumber 0402WGF1003TCE; LCSC Part # C25741
R2, R3, R8, R16: 200K-1%; R_0402_1005Metric; ManufacturerPartNumber 0402WGF2003TCE; LCSC Part # C25764
R4: 47K/1%; R_0402_1005Metric; ManufacturerPartNumber 0402WGF4702TCE; LCSC Part # C25792
R5: 0R03; R_0805_2012Metric; ManufacturerPartNumber 0805W4F300MT5E; LCSC Part # C247605
R6, R11, R12: 10K/1%; R_0402_1005Metric; ManufacturerPartNumber 0402WGF1002TCE; LCSC Part # C25744
R9: 2K/1%; R_0402_1005Metric; ManufacturerPartNumber 0402WGF2001TCE; LCSC Part # C4109
R13: 1K; R_0402_1005Metric; ManufacturerPartNumber 0402WGF1001TCE; LCSC Part # C11702
R15: 680K/1%; R_0402_1005Metric; ManufacturerPartNumber 0402WGF6803TCE; LCSC Part # C4131
SW1: SW_SPST; Pin_Header_Straight_1x02_Pitch2.54mm; ManufacturerPartNumber 2.54mm 1x40P
TP5, TP6: TEST; TestPoint_Pad_D1.0mm
U1, U5: SY6280; SOT-23-5; ManufacturerPartNumber SY6280AAC; LCSC Part # C55136
U2: OLED; CONN_OLED_TWI-Socket_Strip_Straight_1x04_Pitch2.54mm; ManufacturerPartNumber 2.54mm 1x40P
U3: AXP209; qfn48_6x6mm_Pitch0.4mm; ManufacturerPartNumber AXP209; LCSC Part # C2997895
U6: BatteryPadM; BatteryPad
U7: BatteryPadP; BatteryPadThinner
U10: SY7069ADC; TSOT-23-6; PartNo SY7069ADC; LCSC Part # C207630

Connections:
/VDD_SRR: C17.1, J8.3, J12.1, U1.1 (OUT)
BAT: C3.1, C9.1, C10.2, R5.2, SW1.2 (B), U3.38 (BAT), U3.39 (BAT), U3.42 (BATSENCE)
EXTEN: R10.2, U3.20 (EXTEN), U5.4 (EN), U10.6 (EN); also elsewhere on the board
GND: C1.2, C2.2, C3.2, C4.2, C5.2, C6.2, C7.1, C8.1, C10.1, C11.1, C14.2, C16.2, C17.2, C25.2, C26.2, C27.2, J6.1, J8.2, J10.2, J10.4, J12.2, J12.3, R1.1, R2.1, R3.1, R6.1, R10.1, R13.1, R16.2, U1.2 (GND), U2.1 (GND), U3.22 (AGND), U3.37 (TS), U3.46 (PGND1), U3.49 (EP), U5.2 (GND), U6.1 (BATM_1), U10.3 (GND); also elsewhere on the board
IPSOUT: C1.1, C4.1, C8.2, C25.1, C27.1, L3.1, TP6.1, U3.13 (LDO24IN), U3.21 (APS), U3.34 (IPSOUT), U3.35 (ISPOUT), U3.40 (LDO3IN), U3.44 (VIN1), U10.2 (IN); also elsewhere on the board
IRQ: R8.2, U3.48 (IRQ/WAKEUP); also elsewhere on the board
LDO1: U3.28 (LDO1); also elsewhere on the board
N_OE: R3.2, U3.4 (N_OE); also elsewhere on the board
unnamed: J2.1, J12.9
unnamed: J2.2, J12.4
unnamed: J2.3, J12.5
unnamed: J8.4, J12.10
unnamed: R9.1, R13.2
unnamed: SW1.1 (A), U7.1 (BATP_1)
unnamed: R6.2, U1.3 (ISET)
unnamed: R2.2, U3.23 (BIAS)
unnamed: C9.2, C11.2, L1.2, R5.1, U3.43 (CHSENCE)
unnamed: L1.1, U3.45 (LX1)
unnamed: R1.2, U3.6 (N_VBUSEN)
unnamed: C6.1, U3.24 (VREF)
unnamed: R9.2, U5.3 (ISET)
unnamed: R15.2, R16.1, U10.1 (FB)
unnamed: L3.2, U10.5 (LX)
unnamed: C26.1, R15.1, TP5.1, U5.5 (IN), U10.4 (OUT)
PWRON: C7.2, R4.2, U3.5 (GPIO2), U3.47 (PWRON)
SCK: J8.5, R12.1, U2.3 (SCL), U3.2 (SCK); also elsewhere on the board
SDA: J8.6, R11.1, U2.4 (SDA), U3.1 (SDA); also elsewhere on the board
SRR_IRQ: J8.1; also elsewhere on the board
SRR_NRST: J2.4, J12.6, U1.4 (EN); also elsewhere on the board
ToPWRBTN: R4.1; also elsewhere on the board
UART0_RX: J6.3; also elsewhere on the board
UART0_TX: J6.2; also elsewhere on the board
USBHost1-DN: J10.6; also elsewhere on the board
USBHost1-DP: J10.5; also elsewhere on the board
USBHost2-DN: J10.9; also elsewhere on the board
USBHost2-DP: J10.8; also elsewhere on the board
VBUS: C5.1, J10.1, U3.31 (VBUS)
VDD_5V: C14.1, C16.1, J10.7, U5.1 (OUT); also elsewhere on the board
VDD_SYS_3.3V: R8.1, R11.2, R12.2, U1.5 (IN), U2.2 (VCC); also elsewhere on the board
VINT: C2.1, U3.26 (VINT), U3.27 (LDO1SET)

Notes on the sheet:
place C8 4.7uF near vin1 pin
USB PWR
IPSOUT TO 5V FOR VDD_5V
PWR-ON BTN CONN
Power management
OLED
Connector for strength to connector board
USB Host 1 and 2
BATTERY IN
