henla464/WiRocKiCad/KiCad10/WiRoc_v8/WiRoc_NanoPi.kicad_pcb

## KiCad design KiCad10/WiRoc_v8/WiRoc_NanoPi.kicad_pcb (continued)

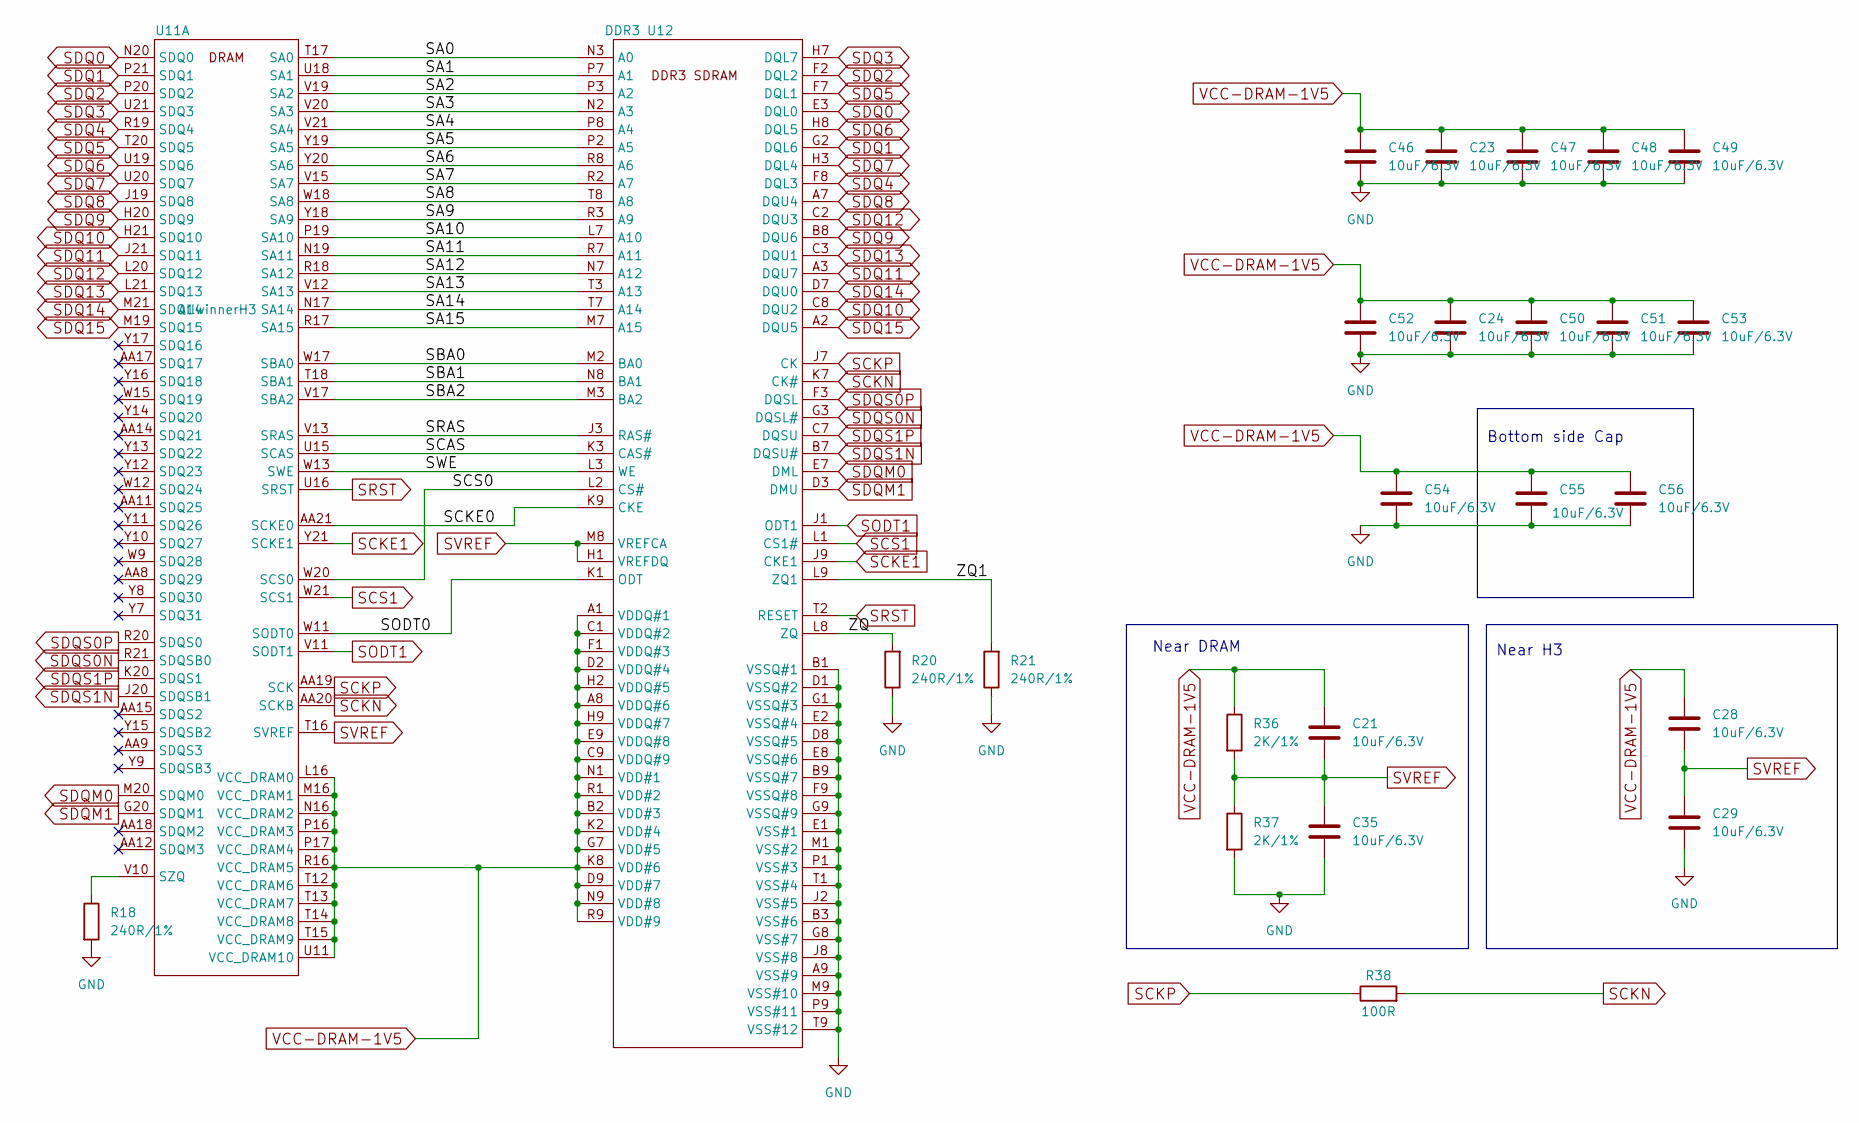
[picture p40: schematic Processor-MEM.kicad_sch]

Parts:
C21, C23, C24, C28, C29, C35, C46, C47, C48, C49, C50, C51, C52, C53, C54, C55, C56: 10uF/6.3V; C_0402_1005Metric; ManufacturerPartNumber CL05A106MQ5NUNC; LCSC Part # C15525
R18, R20, R21: 240R/1%; R_0402_1005Metric; ManufacturerPartNumber RC0402FR-07240RL; JLCBasicExtended Extended
R36, R37: 2K/1%; R_0402_1005Metric; ManufacturerPartNumber 0402WGF2001TCE; JLCBasicExtended Basic
R38: 100R; R_0402_1005Metric; ManufacturerPartNumber RC0402FR-07100RL; JLCBasicExtended Basic
U11: AllwinnerH3; BGA-347_21x21_14.0x14.0mm; ManufacturerPartNumber H3; JLCBasicExtended Extended
U12: DDR3; FBGA-96_7.5x13mm_Layout9x16_P0.8mm; ManufacturerPartNumber H5TQ4G63EFR-RDC; JLCBasicExtended Extended

Connections:
/Processor-MEM/SA0: U11.T17 (SA0), U12.N3 (A0)
/Processor-MEM/SA1: U11.U18 (SA1), U12.P7 (A1)
/Processor-MEM/SA2: U11.V19 (SA2), U12.P3 (A2)
/Processor-MEM/SA3: U11.V20 (SA3), U12.N2 (A3)
/Processor-MEM/SA4: U11.V21 (SA4), U12.P8 (A4)
/Processor-MEM/SA5: U11.Y19 (SA5), U12.P2 (A5)
/Processor-MEM/SA6: U11.Y20 (SA6), U12.R8 (A6)
/Processor-MEM/SA7: U11.V15 (SA7), U12.R2 (A7)
/Processor-MEM/SA8: U11.W18 (SA8), U12.T8 (A8)
/Processor-MEM/SA9: U11.Y18 (SA9), U12.R3 (A9)
/Processor-MEM/SA10: U11.P19 (SA10), U12.L7 (A10)
/Processor-MEM/SA11: U11.N19 (SA11), U12.R7 (A11)
/Processor-MEM/SA12: U11.R18 (SA12), U12.N7 (A12)
/Processor-MEM/SA13: U11.V12 (SA13), U12.T3 (A13)
/Processor-MEM/SA14: U11.N17 (SA14), U12.T7 (A14)
/Processor-MEM/SA15: U11.R17 (SA15), U12.M7 (A15)
/Processor-MEM/SBA0: U11.W17 (SBA0), U12.M2 (BA0)
/Processor-MEM/SBA1: U11.T18 (SBA1), U12.N8 (BA1)
/Processor-MEM/SBA2: U11.V17 (SBA2), U12.M3 (BA2)
/Processor-MEM/SCAS: U11.U15 (SCAS), U12.K3 (CAS#)
/Processor-MEM/SCKE0: U11.AA21 (SCKE0), U12.K9 (CKE)
/Processor-MEM/SCS0: U11.W20 (SCS0), U12.L2 (CS#)
/Processor-MEM/SODT0: U11.W11 (SODT0), U12.K1 (ODT)
/Processor-MEM/SRAS: U11.V13 (SRAS), U12.J3 (RAS#)
/Processor-MEM/SWE: U11.W13 (SWE), U12.L3 (WE)
/Processor-MEM/ZQ: R20.2, U12.L8 (ZQ)
/Processor-MEM/ZQ1: R21.2, U12.L9 (ZQ1)
GND: C23.2, C24.2, C29.2, C35.2, C46.2, C47.2, C48.2, C49.2, C50.2, C51.2, C52.2, C53.2, C54.2, C55.2, C56.2, R18.2, R20.1, R21.1, R37.2, U12.A9 (VSS#9), U12.B1 (VSSQ#1), U12.B3 (VSS#6), U12.B9 (VSSQ#7), U12.D1 (VSSQ#2), U12.D8 (VSSQ#5), U12.E1 (VSS#1), U12.E2 (VSSQ#4), U12.E8 (VSSQ#6), U12.F9 (VSSQ#8), U12.G1 (VSSQ#3), U12.G8 (VSS#7), U12.G9 (VSSQ#9), U12.J2 (VSS#5), U12.J8 (VSS#8), U12.M1 (VSS#2), U12.M9 (VSS#10), U12.P1 (VSS#3), U12.P9 (VSS#11), U12.T1 (VSS#4), U12.T9 (VSS#12); also elsewhere on the board
unnamed: R18.1, U11.V10 (SZQ)
SCKE1: U11.Y21 (SCKE1), U12.J9 (CKE1)
SCKN: R38.2, U11.AA20 (SCKB), U12.K7 (CK#)
SCKP: R38.1, U11.AA19 (SCK), U12.J7 (CK)
SCS1: U11.W21 (SCS1), U12.L1 (CS1#)
SDQ0: U11.N20 (SDQ0), U12.E3 (DQL0)
SDQ1: U11.P21 (SDQ1), U12.G2 (DQL6)
SDQ2: U11.P20 (SDQ2), U12.F2 (DQL2)
SDQ3: U11.U21 (SDQ3), U12.H7 (DQL7)
SDQ4: U11.R19 (SDQ4), U12.F8 (DQL3)
SDQ5: U11.T20 (SDQ5), U12.F7 (DQL1)
SDQ6: U11.U19 (SDQ6), U12.H8 (DQL5)
SDQ7: U11.U20 (SDQ7), U12.H3 (DQL4)
SDQ8: U11.J19 (SDQ8), U12.A7 (DQU4)
SDQ9: U11.H20 (SDQ9), U12.B8 (DQU6)
SDQ10: U11.H21 (SDQ10), U12.C8 (DQU2)
SDQ11: U11.J21 (SDQ11), U12.A3 (DQU7)
SDQ12: U11.L20 (SDQ12), U12.C2 (DQU3)
SDQ13: U11.L21 (SDQ13), U12.C3 (DQU1)
SDQ14: U11.M21 (SDQ14), U12.D7 (DQU0)
SDQ15: U11.M19 (SDQ15), U12.A2 (DQU5)
SDQM0: U11.M20 (SDQM0), U12.E7 (DML)
SDQM1: U11.G20 (SDQM1), U12.D3 (DMU)
SDQS0N: U11.R21 (SDQSB0), U12.G3 (DQSL#)
SDQS0P: U11.R20 (SDQS0), U12.F3 (DQSL)
SDQS1N: U11.J20 (SDQSB1), U12.B7 (DQSU#)
SDQS1P: U11.K20 (SDQS1), U12.C7 (DQSU)
SODT1: U11.V11 (SODT1), U12.J1 (ODT1)
SRST: U11.U16 (SRST), U12.T2 (RESET)
SVREF: C21.2, C28.2, C29.1, C35.1, R36.2, R37.1, U11.T16 (SVREF), U12.H1 (VREFDQ), U12.M8 (VREFCA)
VCC-DRAM-1V5: C21.1, C23.1, C24.1, C28.1, C46.1, C47.1, C48.1, C49.1, C50.1, C51.1, C52.1, C53.1, C54.1, C55.1, C56.1, R36.1, U11.L16 (VCC_DRAM0), U11.M16 (VCC_DRAM1), U11.N16 (VCC_DRAM2), U11.P16 (VCC_DRAM3), U11.P17 (VCC_DRAM4), U11.R16 (VCC_DRAM5), U11.T12 (VCC_DRAM6), U11.T13 (VCC_DRAM7), U11.T14 (VCC_DRAM8), U11.T15 (VCC_DRAM9), U11.U11 (VCC_DRAM10), U12.A1 (VDDQ#1), U12.A8 (VDDQ#6), U12.B2 (VDD#3), U12.C1 (VDDQ#2), U12.C9 (VDDQ#9), U12.D2 (VDDQ#4), U12.D9 (VDD#7), U12.E9 (VDDQ#8), U12.F1 (VDDQ#3), U12.G7 (VDD#5), U12.H2 (VDDQ#5), U12.H9 (VDDQ#7), U12.K2 (VDD#4), U12.K8 (VDD#6), U12.N1 (VDD#1), U12.N9 (VDD#8), U12.R1 (VDD#2), U12.R9 (VDD#9); also elsewhere on the board

Notes on the sheet:
Near H3
Near DRAM
Bottom side Cap

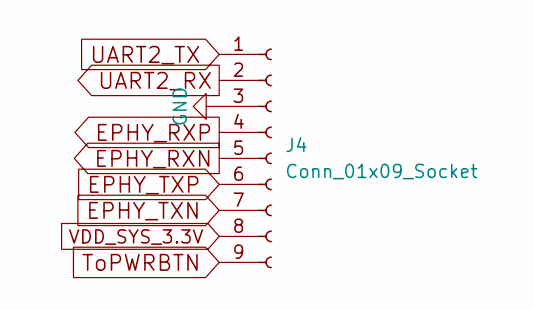
[picture p41: schematic Serial.kicad_sch]

Parts:
J4: Conn_01x09_Socket; PinSocket_1x09_P1.27mm_Vertical; ManufacturerPartNumber PM127V-11-09-H46; JLCBasicExtended Extended

Connections:
EPHY_RXN: J4.5; also elsewhere on the board
EPHY_RXP: J4.4; also elsewhere on the board
EPHY_TXN: J4.7; also elsewhere on the board
EPHY_TXP: J4.6; also elsewhere on the board
GND: J4.3; also elsewhere on the board
ToPWRBTN: J4.9; also elsewhere on the board
UART2_RX: J4.2; also elsewhere on the board
UART2_TX: J4.1; also elsewhere on the board
VDD_SYS_3.3V: J4.8; also elsewhere on the board

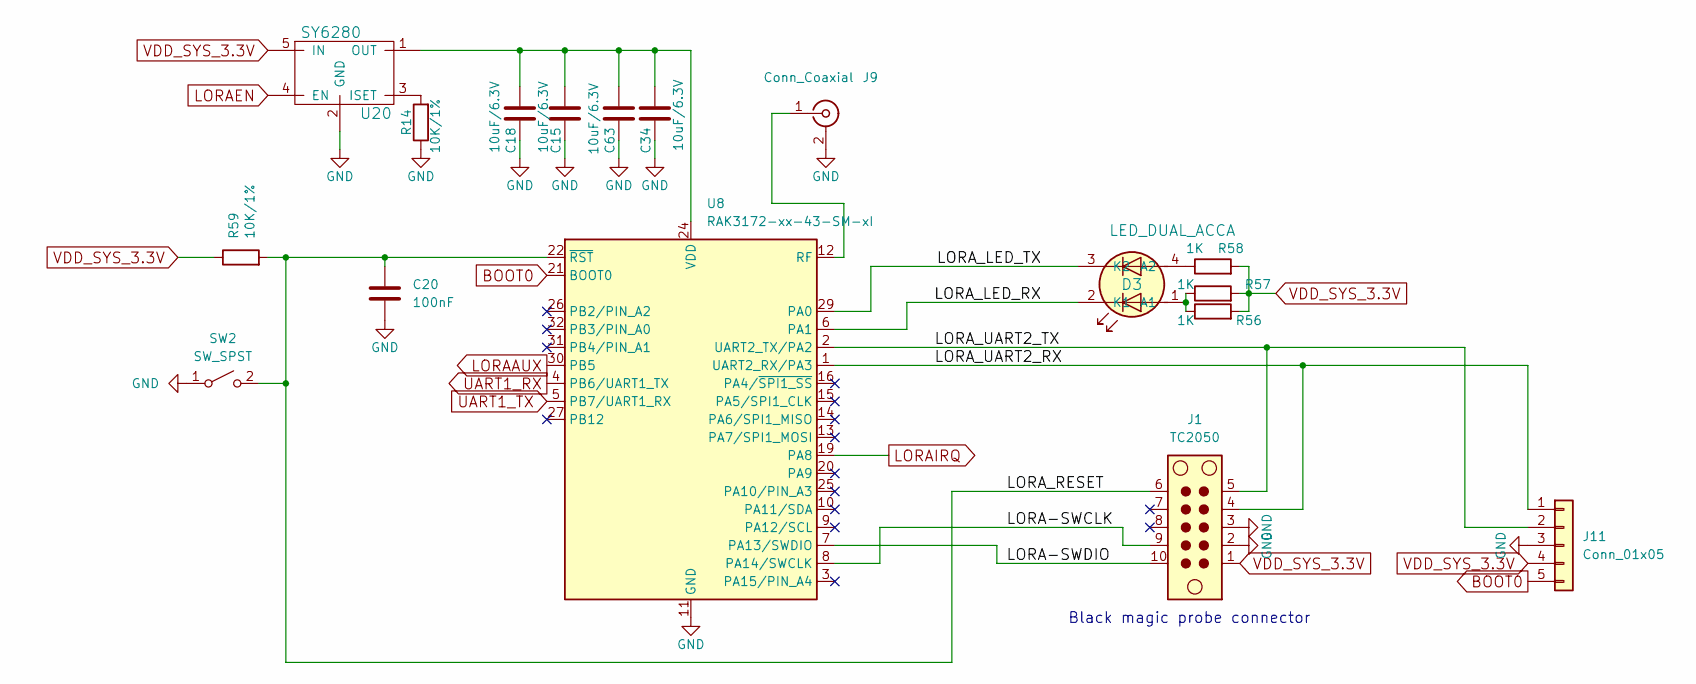
[picture p42: schematic Lora.kicad_sch]

Parts:
C15, C18, C34, C63: 10uF/6.3V; C_0402_1005Metric; ManufacturerPartNumber CL05A106MQ5NUNC; LCSC Part # C15525
C20: 100nF; C_0402_1005Metric; ManufacturerPartNumber CL05B104KO5NNNC; LCSC Part # C1525
D3: LED_DUAL_ACCA; LED_Dual_1.7_1.6; ManufacturerPartNumber HL-PCB-1617S9FH203BC; LCSC Part # C513363
J1: TC2050; Tag-Connect_TC2050-IDC-NL_2x05_P1.27mm_Vertical
J9: Conn_Coaxial; SMA_Amphenol_901-143_Horizontal
J11: Conn_01x05; PinHeader_1x05_P2.54mm_Vertical; ManufacturerPartNumber HB-PH3-25415PB2GOP; JLCBasicExtended Extended
R14: 10K/1%; R_0402_1005Metric; ManufacturerPartNumber 0402WGF1002TCE; LCSC Part # C25744
R56, R57, R58: 1K; R_0402_1005Metric; ManufacturerPartNumber 0402WGF1001TCE; LCSC Part # C11702
R59: 10K/1%; R_0402_1005Metric; ManufacturerPartNumber 0402WGF1002TCE; JLCBasicExtended Basic
SW2: SW_SPST; PinHeader_1x02_P1.27mm_Vertical
U8: RAK3172-xx-43-SM-xI; RAK3172
U20: SY6280; SOT-23-5; ManufacturerPartNumber SY6280AAC; LCSC Part # C55136

Connections:
/Lora/LORA-SWCLK: J1.9, U8.8 (PA14/SWCLK)
/Lora/LORA-SWDIO: J1.10, U8.7 (PA13/SWDIO)
/Lora/LORA_LED_RX: D3.2 (K1), U8.6 (PA1)
/Lora/LORA_LED_TX: D3.3 (K2), U8.29 (PA0)
/Lora/LORA_RESET: C20.1, J1.6, R59.2, SW2.2 (B), U8.22 (~RST)
/Lora/LORA_UART2_RX: J1.4, J11.1, U8.1 (UART2_RX/PA3)
/Lora/LORA_UART2_TX: J1.5, J11.2, U8.2 (UART2_TX/PA2)
BOOT0: J11.5, U8.21 (BOOT0)
GND: C15.2, C18.2, C20.2, C34.2, C63.2, J1.2, J1.3, J9.2 (Ext), J11.3, R14.1, SW2.1 (A), U8.11 (GND), U8.17 (GND), U8.18 (GND), U8.23 (GND), U8.28 (GND), U20.2 (GND); also elsewhere on the board
LORAAUX: U8.30 (PB5); also elsewhere on the board
LORAEN: U20.4 (EN); also elsewhere on the board
LORAIRQ: U8.19 (PA8); also elsewhere on the board
unnamed: D3.1 (A1), R56.1, R57.1
unnamed: D3.4 (A2), R58.1
unnamed: J9.1 (In), U8.12 (RF)
unnamed: R14.2, U20.3 (ISET)
unnamed: C15.1, C18.1, C34.1, C63.1, U8.24 (VDD), U20.1 (OUT)
UART1_RX: U8.4 (PB6/UART1_TX); also elsewhere on the board
UART1_TX: U8.5 (PB7/UART1_RX); also elsewhere on the board
VDD_SYS_3.3V: J1.1, J11.4, R56.2, R57.2, R58.2, R59.1, U20.5 (IN); also elsewhere on the board

Notes on the sheet:
Black magic probe connector

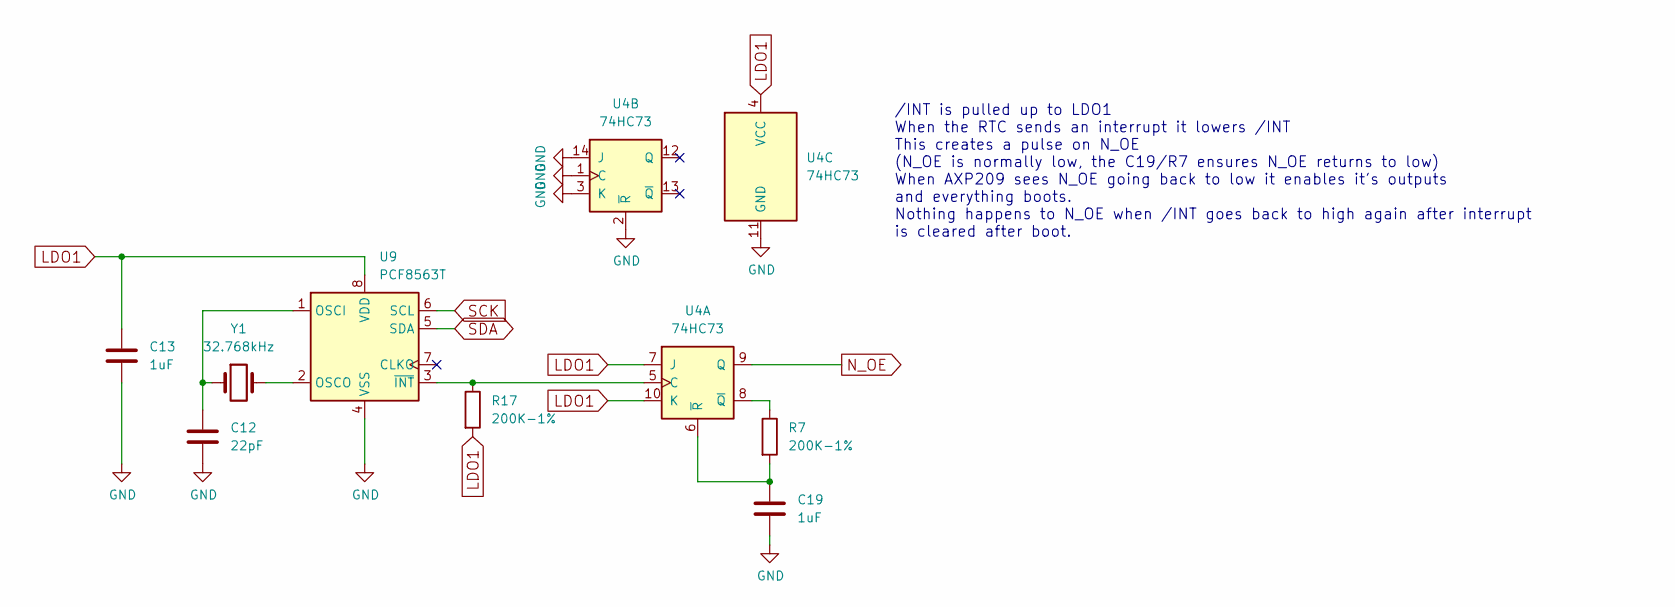
[picture p43: schematic RTC.kicad_sch]

Parts:
C12: 22pF; C_0402_1005Metric; ManufacturerPartNumber 0402CG220J500NT; LCSC Part # C1555
C13, C19: 1uF; C_0402_1005Metric; ManufacturerPartNumber CL05A105KA5NQNC; LCSC Part # C52923
R7, R17: 200K-1%; R_0402_1005Metric; ManufacturerPartNumber 0402WGF2003TCE; LCSC Part # C25764
U4: 74HC73; SOIC-14_3.9x8.7mm_P1.27mm; ManufacturerPartNumber CD74HC73M96; LCSC Part # C350539
U9: PCF8563T; SOIC-8_3.9x4.9mm_P1.27mm; ManufacturerPartNumber PCF8563T/5,518; LCSC Part # C7440
Y1: 32.768kHz; SMD3215-2P; ManufacturerPartNumber Q13FC1350000400; LCSC Part # C32346

Connections:
GND: C12.2, C13.2, C19.2, U4.1 (C), U4.2 (~R), U4.3 (K), U4.11 (GND), U4.14 (J), U9.4 (VSS); also elsewhere on the board
LDO1: C13.1, R17.2, U4.4 (VCC), U4.7 (J), U4.10 (K), U9.8 (VDD); also elsewhere on the board
N_OE: U4.9 (Q); also elsewhere on the board
unnamed: R17.1, U4.5 (C), U9.3 (~INT)
unnamed: R7.1, U4.8 (~Q)
unnamed: C19.1, R7.2, U4.6 (~R)
unnamed: C12.1, U9.1 (OSCI), Y1.1
unnamed: U9.2 (OSCO), Y1.2
SCK: U9.6 (SCL); also elsewhere on the board
SDA: U9.5 (SDA); also elsewhere on the board

Notes on the sheet:
/INT is pulled up to LDO1 When the RTC sends an interrupt it lowers /INT This creates a pulse on N_OE (N_OE is normally low, the C19/R7 ensures N_OE returns to low) When AXP209 sees N_OE going back to low it enables it's outputs and everything boots. Nothing happens to N_OE when /INT goes back to h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

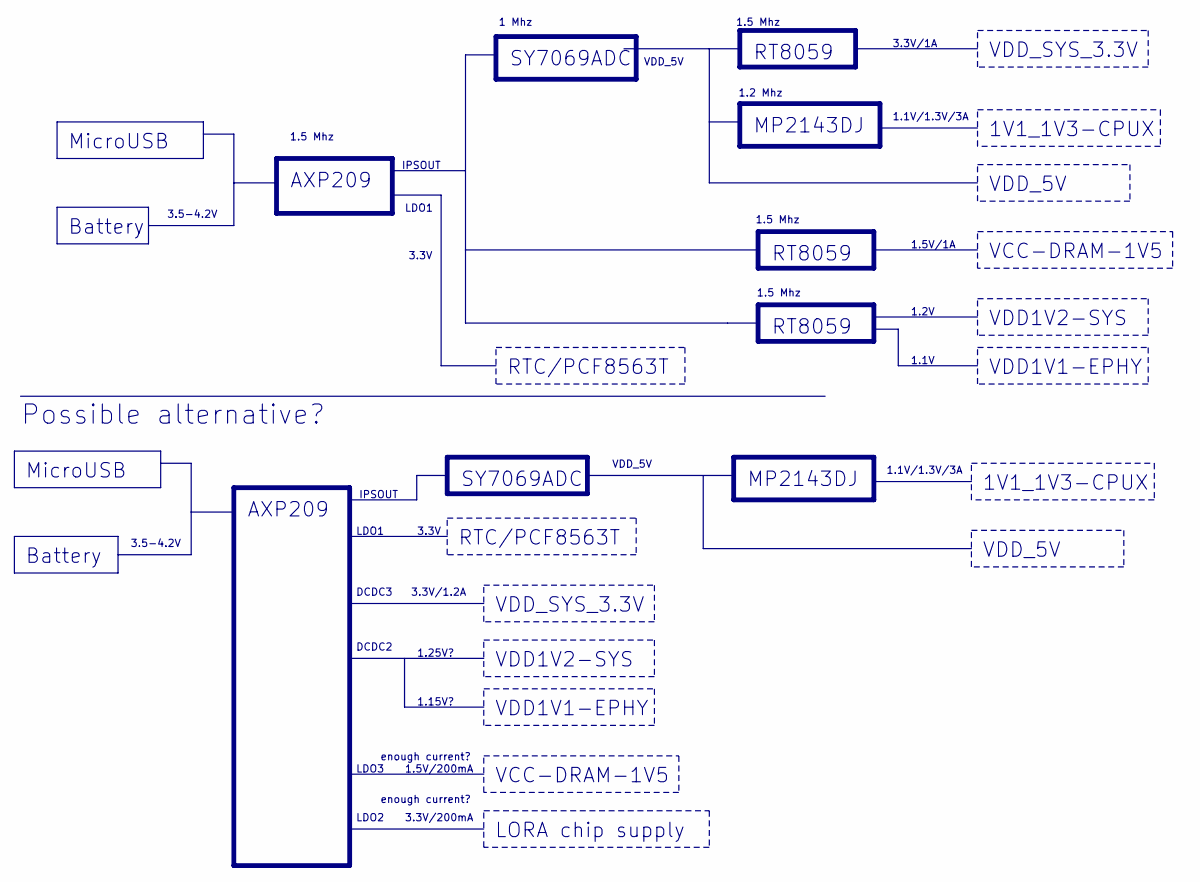
[picture p44: schematic PowerTree.kicad_sch]

Notes on the sheet:
1.5 Mhz
1.5V/1A
3.5-4.2V
DCDC3
1.1V/1.3V/3A
Possible alternative?
3.3V/1.2A
1.5V/200mA
1.25V?
IPSOUT
1 Mhz
LDO2
3.3V/1A
3.3V/200mA
1.2V
1.15V?
DCDC2
VDD_5V
LDO1
1.2 Mhz
LDO3
3.3V
1.1V
enough current?
VDD1V1-EPHY
1V1_1V3-CPUX
MicroUSB
RTC/PCF8563T
SY7069ADC
Battery
VDD1V2-SYS
MP2143DJ
RT8059
VDD_SYS_3.3V
AXP209
VCC-DRAM-1V5
LORA chip supply

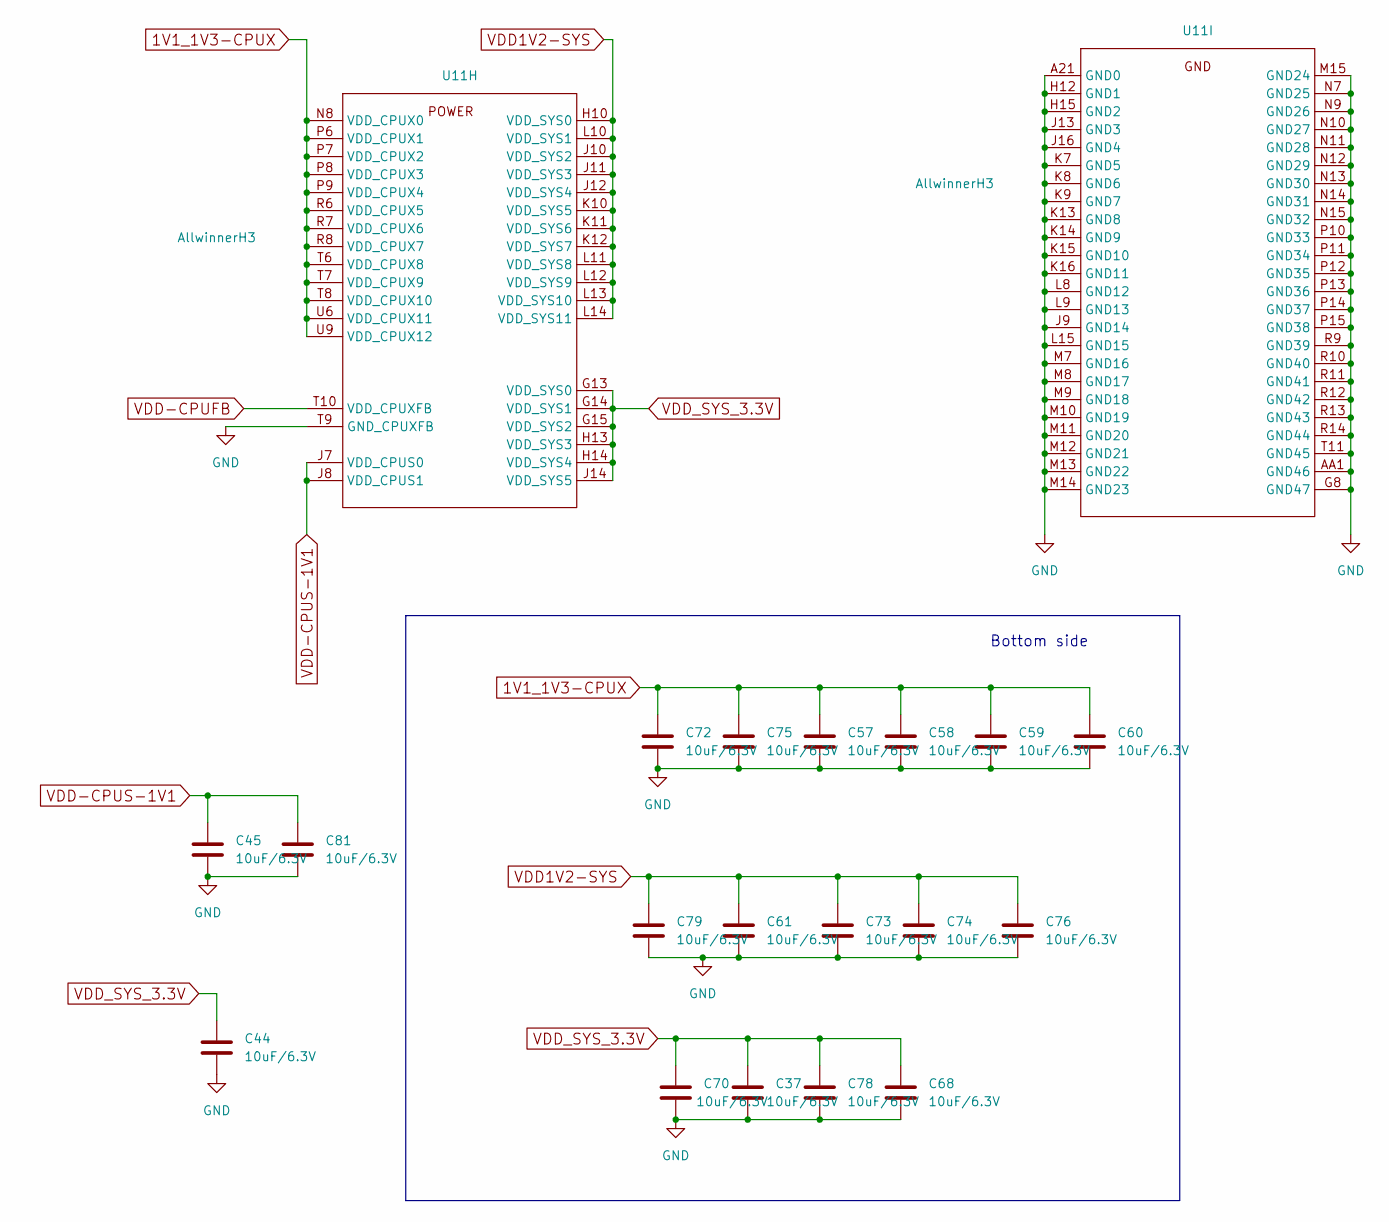
[picture p45: schematic Processor.kicad_sch]

Parts:
C37, C44, C45, C57, C58, C59, C60, C61, C68, C70, C72, C73, C74, C75, C76, C78, C79, C81: 10uF/6.3V; C_0402_1005Metric; ManufacturerPartNumber CL05A106MQ5NUNC; LCSC Part # C15525
U11: AllwinnerH3; BGA-347_21x21_14.0x14.0mm; ManufacturerPartNumber H3; JLCBasicExtended Extended

Connections:
1V1_1V3-CPUX: C57.1, C58.1, C59.1, C60.1, C72.1, C75.1, U11.N8 (VDD_CPUX0), U11.P6 (VDD_CPUX1), U11.P7 (VDD_CPUX2), U11.P8 (VDD_CPUX3), U11.P9 (VDD_CPUX4), U11.R6 (VDD_CPUX5), U11.R7 (VDD_CPUX6), U11.R8 (VDD_CPUX7), U11.T6 (VDD_CPUX8), U11.T7 (VDD_CPUX9), U11.T8 (VDD_CPUX10), U11.U6 (VDD_CPUX11), U11.U9 (VDD_CPUX12); also elsewhere on the board
GND: C37.2, C44.2, C45.2, C57.2, C58.2, C59.2, C60.2, C61.2, C68.2, C70.2, C72.2, C73.2, C74.2, C75.2, C76.2, C78.2, C79.2, C81.2, U11.A21 (GND0), U11.AA1 (GND46), U11.G8 (GND47), U11.H12 (GND1), U11.H15 (GND2), U11.J9 (GND14), U11.J13 (GND3), U11.J16 (GND4), U11.K7 (GND5), U11.K8 (GND6), U11.K9 (GND7), U11.K13 (GND8), U11.K14 (GND9), U11.K15 (GND10), U11.K16 (GND11), U11.L8 (GND12), U11.L9 (GND13), U11.L15 (GND15), U11.M7 (GND16), U11.M8 (GND17), U11.M9 (GND18), U11.M10 (GND19), U11.M11 (GND20), U11.M12 (GND21), U11.M13 (GND22), U11.M14 (GND23), U11.M15 (GND24), U11.N7 (GND25), U11.N9 (GND26), U11.N10 (GND27), U11.N11 (GND28), U11.N12 (GND29), U11.N13 (GND30), U11.N14 (GND31), U11.N15 (GND32), U11.P10 (GND33), U11.P11 (GND34), U11.P12 (GND35), U11.P13 (GND36), U11.P14 (GND37), U11.P15 (GND38), U11.R9 (GND39), U11.R10 (GND40), U11.R11 (GND41), U11.R12 (GND42), U11.R13 (GND43), U11.R14 (GND44), U11.T9 (GND_CPUXFB), U11.T11 (GND45); also elsewhere on the board
VDD1V2-SYS: C61.1, C73.1, C74.1, C76.1, C79.1, U11.H10 (VDD_SYS0), U11.J10 (VDD_SYS2), U11.J11 (VDD_SYS3), U11.J12 (VDD_SYS4), U11.K10 (VDD_SYS5), U11.K11 (VDD_SYS6), U11.K12 (VDD_SYS7), U11.L10 (VDD_SYS1), U11.L11 (VDD_SYS8), U11.L12 (VDD_SYS9), U11.L13 (VDD_SYS10), U11.L14 (VDD_SYS11); also elsewhere on the board
VDD-CPUFB: U11.T10 (VDD_CPUXFB); also elsewhere on the board
VDD-CPUS-1V1: C45.1, C81.1, U11.J7 (VDD_CPUS0), U11.J8 (VDD_CPUS1); also elsewhere on the board
VDD_SYS_3.3V: C37.1, C44.1, C68.1, C70.1, C78.1, U11.G13 (VDD_SYS0), U11.G14 (VDD_SYS1), U11.G15 (VDD_SYS2), U11.H13 (VDD_SYS3), U11.H14 (VDD_SYS4), U11.J14 (VDD_SYS5); also elsewhere on the board

Notes on the sheet:
Bottom side

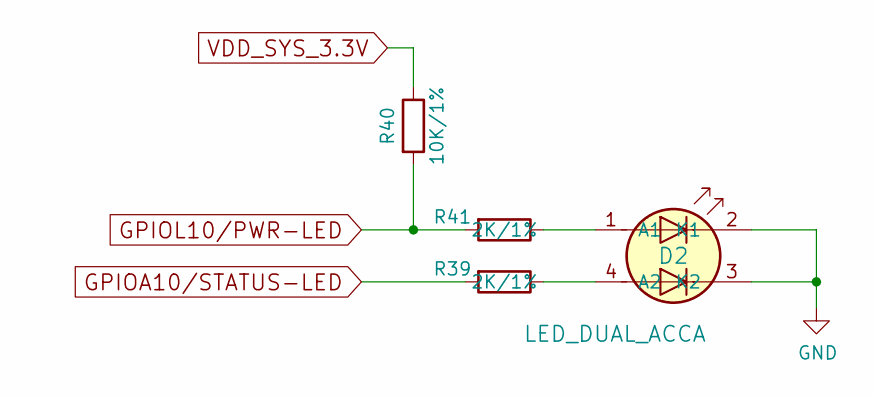
[picture p46: schematic LED-Etc.kicad_sch]

Parts:
D2: LED_DUAL_ACCA; LED_Dual_1.7_1.6; ManufacturerPartNumber HL-PCB-1617S9FH203BC; LCSC Part # C513363
R39, R41: 2K/1%; R_0402_1005Metric; ManufacturerPartNumber 0402WGF2001TCE; LCSC Part # C4109
R40: 10K/1%; R_0402_1005Metric; ManufacturerPartNumber 0402WGF1002TCE; LCSC Part # C25744

Connections:
GPIOA10/STATUS-LED: R39.2; also elsewhere on the board
GND: D2.2 (K1), D2.3 (K2); also elsewhere on the board
GPIOL10/PWR-LED: R40.2, R41.2; also elsewhere on the board
unnamed: D2.1 (A1), R41.1
unnamed: D2.4 (A2), R39.1
VDD_SYS_3.3V: R40.1; also elsewhere on the board

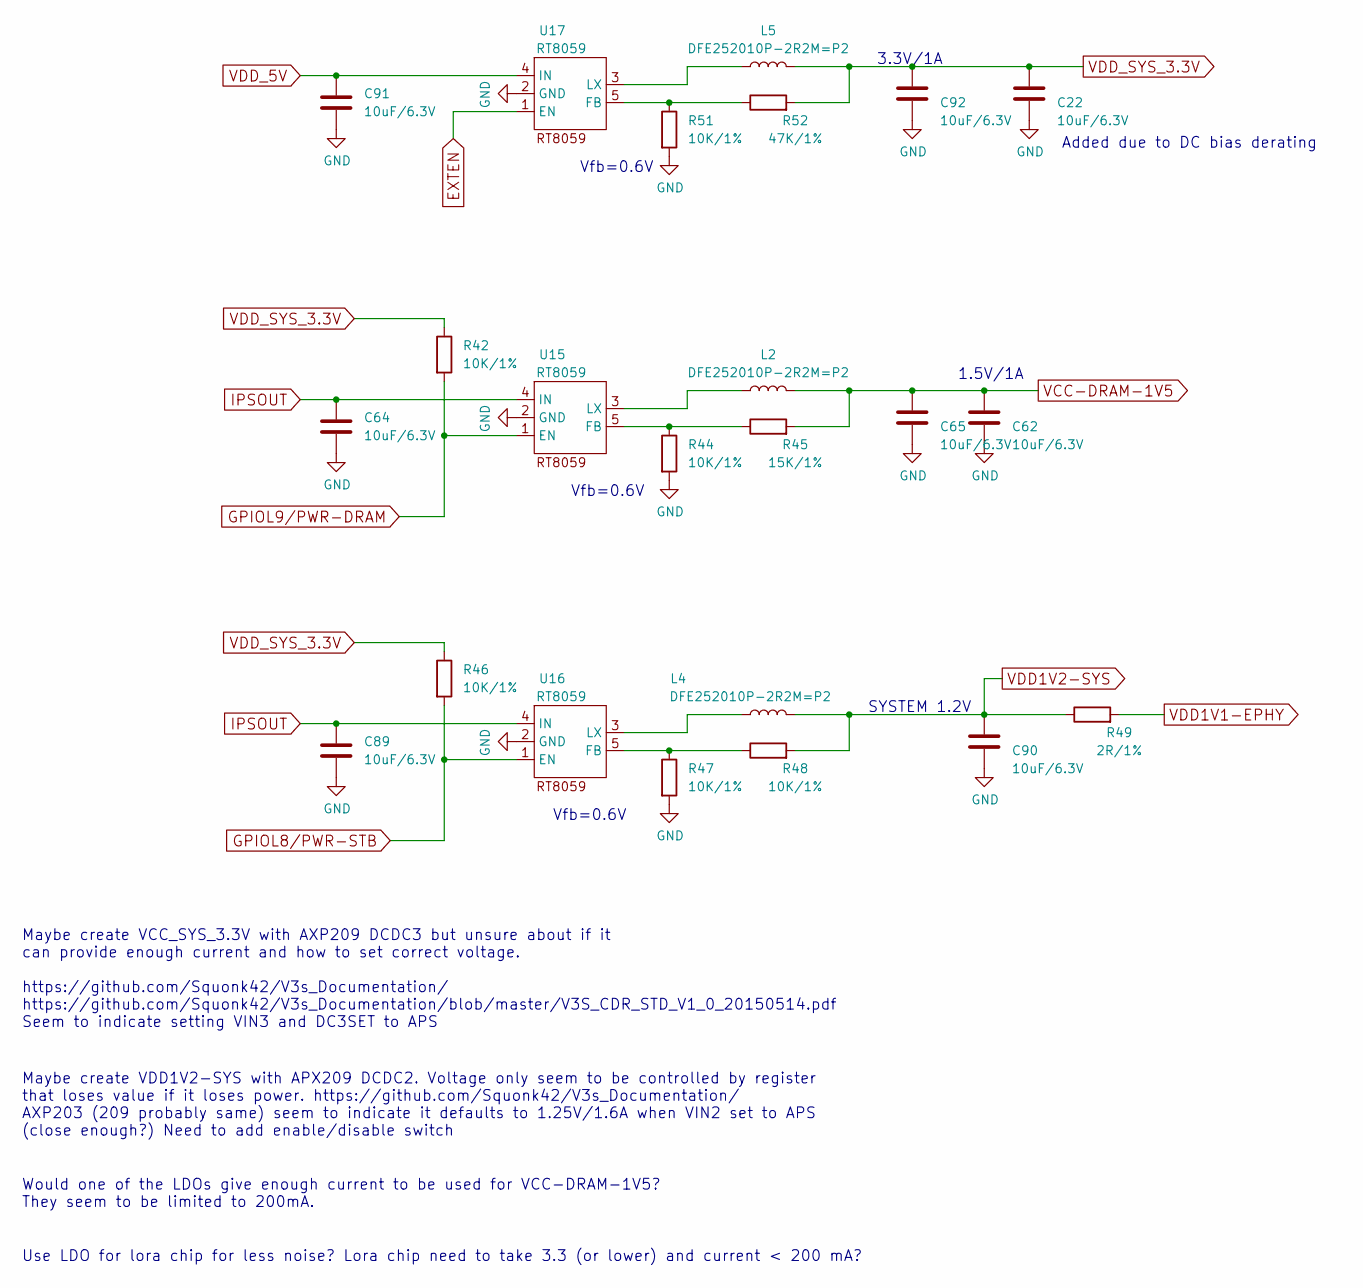
[picture p47: schematic Power2.kicad_sch]

Parts:
C22, C62, C64, C65, C89, C90, C91, C92: 10uF/6.3V; C_0402_1005Metric; ManufacturerPartNumber CL05A106MQ5NUNC; LCSC Part # C15525
L2, L4, L5: DFE252010P-2R2M=P2; L_1008_2520Metric; ManufacturerPartNumber DFE252010P-2R2M=P2; JLCBasicExtended Extended
R42, R46: 10K/1%; R_0402_1005Metric; ManufacturerPartNumber 0402WGF1002TCE; LCSC Part # C25744
R44, R47, R48, R51: 10K/1%; R_0402_1005Metric; ManufacturerPartNumber 0402WGF1002TCE; JLCBasicExtended Basic
R45: 15K/1%; R_0402_1005Metric; ManufacturerPartNumber 0402WGF1502TCE; JLCBasicExtended Basic
R49: 2R/1%; R_0402_1005Metric; ManufacturerPartNumber FRC0402F2R00TS; JLCBasicExtended Extended
R52: 47K/1%; R_0402_1005Metric; ManufacturerPartNumber 0402WGF4702TCE; JLCBasicExtended Basic
U15, U16, U17: RT8059; TSOT-23-5; ManufacturerPartNumber RT8059GJ5; JLCBasicExtended Extended

Connections:
EXTEN: U17.1 (EN); also elsewhere on the board
GND: C22.2, C62.2, C64.2, C65.2, C89.2, C90.2, C91.2, C92.2, R44.2, R47.2, R51.2, U15.2 (GND), U16.2 (GND), U17.2 (GND); also elsewhere on the board
GPIOL8/PWR-STB: R46.2, U16.1 (EN); also elsewhere on the board
GPIOL9/PWR-DRAM: R42.2, U15.1 (EN); also elsewhere on the board
IPSOUT: C64.1, C89.1, U15.4 (IN), U16.4 (IN); also elsewhere on the board
unnamed: R44.1, R45.1, U15.5 (FB)
unnamed: L2.1, U15.3 (LX)
unnamed: R47.1, R48.1, U16.5 (FB)
unnamed: L4.1, U16.3 (LX)
unnamed: R51.1, R52.1, U17.5 (FB)
unnamed: L5.1, U17.3 (LX)
VCC-DRAM-1V5: C62.1, C65.1, L2.2, R45.2; also elsewhere on the board
VDD1V1-EPHY: R49.2; also elsewhere on the board
VDD1V2-SYS: C90.1, L4.2, R48.2, R49.1; also elsewhere on the board
VDD_5V: C91.1, U17.4 (IN); also elsewhere on the board
VDD_SYS_3.3V: C22.1, C92.1, L5.2, R42.1, R46.1, R52.2; also elsewhere on the board

Notes on the sheet:
Vfb=0.6V
Maybe create VDD1V2-SYS with APX209 DCDC2. Voltage only seem to be controlled by register that loses value if it loses power. https://github.com/Squonk42/V3s_Documentation/ AXP203 (209 probably same) seem to indicate it defaults to 1.25V/1.6A when VIN2 set to APS (close enough?) Need to add enable/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
1.5V/1A
Added due to DC bias derating
Maybe create VCC_SYS_3.3V with AXP209 DCDC3 but unsure about if it can provide enough current and how to set correct voltage. https://github.com/Squonk42/V3s_Documentation/ https://github.com/Squonk42/V3s_Documentation/blob/master/V3S_CDR_STD_V1_0_20150514.pdf Seem to indicate setting VIN3 and DC3S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
Would one of the LDOs give enough current to be used for VCC-DRAM-1V5? They seem to be limited to 200mA.
Use LDO for lora chip for less noise? Lora chip need to take 3.3 (or lower) and current < 200 mA?
3.3V/1A
SYSTEM 1.2V

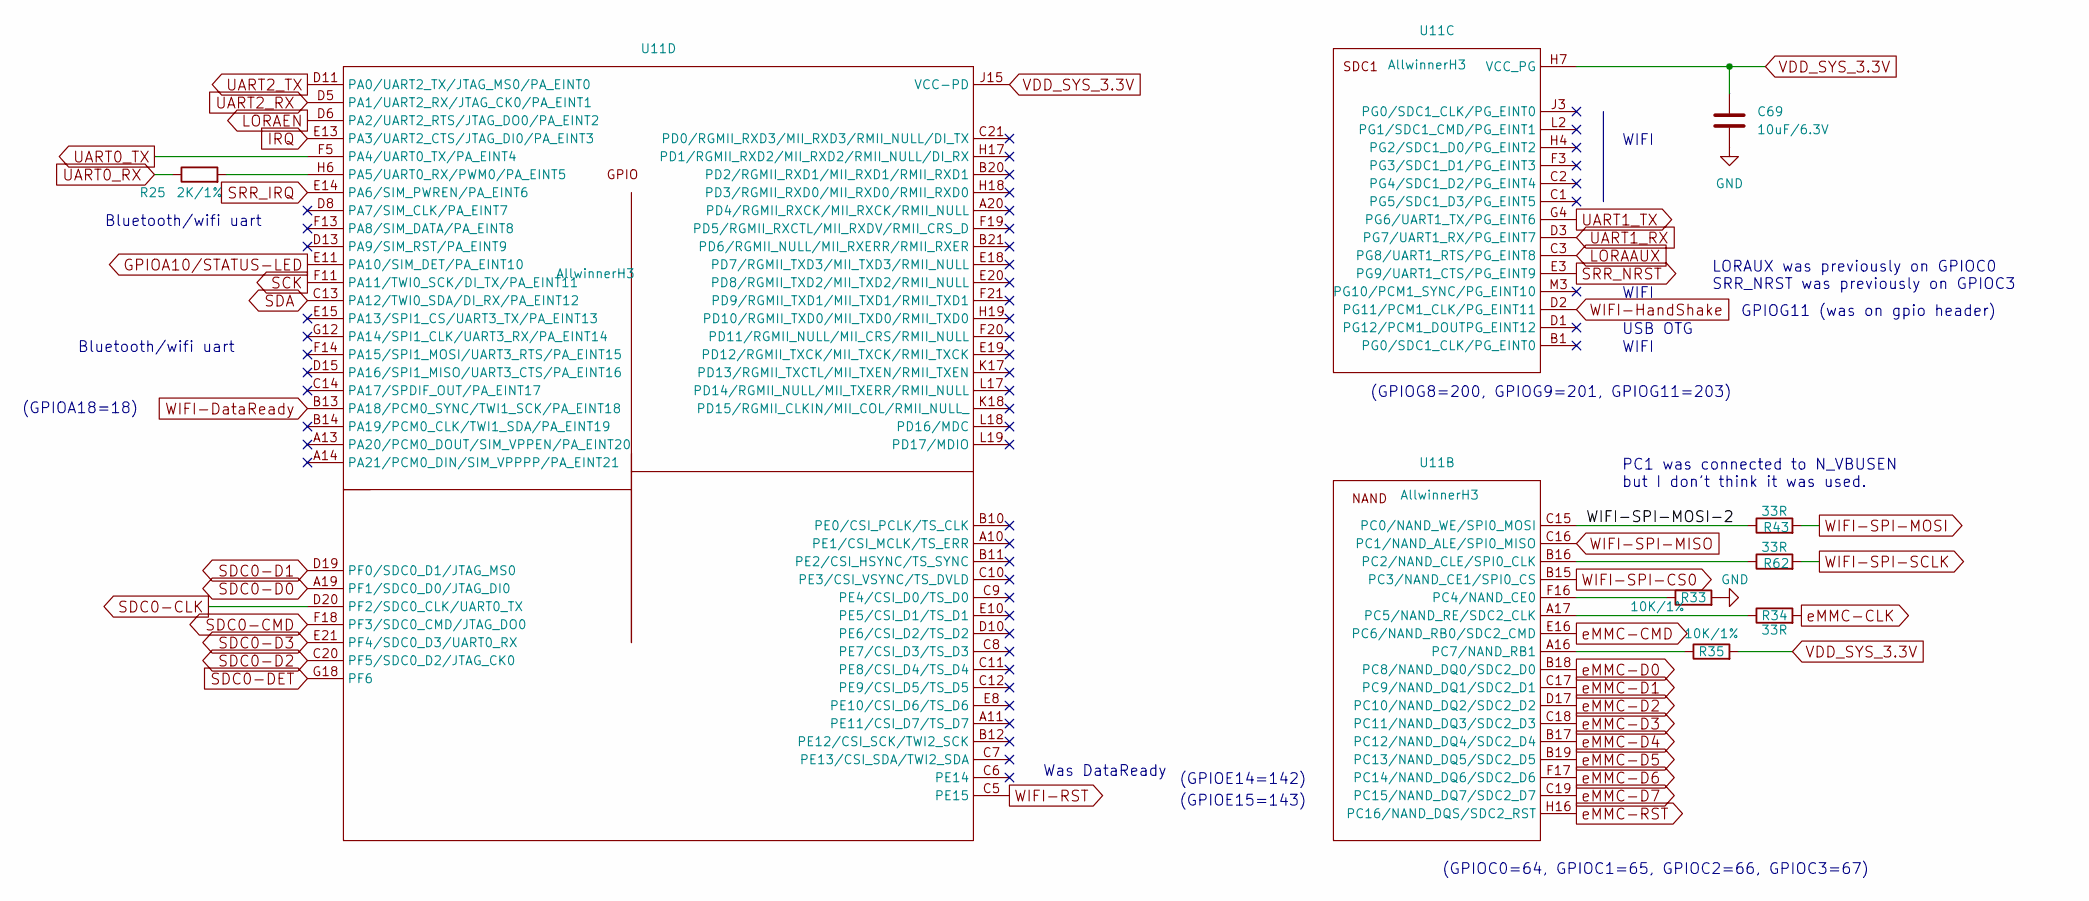
[picture p48: schematic Processor-GPIO-Etc.kicad_sch]

Parts:
C69: 10uF/6.3V; C_0402_1005Metric; ManufacturerPartNumber CL05A106MQ5NUNC; LCSC Part # C15525
R25: 2K/1%; R_0402_1005Metric; ManufacturerPartNumber 0402WGF2001TCE; JLCBasicExtended Basic
R33, R35: 10K/1%; R_0402_1005Metric; ManufacturerPartNumber 0402WGF1002TCE; LCSC Part # C25744
R34, R43, R62: 33R; R_0402_1005Metric; ManufacturerPartNumber 0402WGF330JTCE; JLCBasicExtended Basic
U11: AllwinnerH3; BGA-347_21x21_14.0x14.0mm; ManufacturerPartNumber H3; JLCBasicExtended Extended

Connections:
GPIOA10/STATUS-LED: U11.E11 (PA10/SIM_DET/PA_EINT10); also elsewhere on the board
/Processor-GPIO-Etc/WIFI-SPI-MOSI-2: R43.1, U11.C15 (PC0/NAND_WE/SPI0_MOSI)
GND: C69.2, R33.2; also elsewhere on the board
IRQ: U11.E13 (PA3/UART2_CTS/JTAG_DI0/PA_EINT3); also elsewhere on the board
LORAAUX: U11.C3 (PG8/UART1_RTS/PG_EINT8); also elsewhere on the board
LORAEN: U11.D6 (PA2/UART2_RTS/JTAG_DO0/PA_EINT2); also elsewhere on the board
unnamed: R62.1, U11.B16 (PC2/NAND_CLE/SPI0_CLK)
unnamed: R33.1, U11.F16 (PC4/NAND_CE0)
unnamed: R34.1, U11.A17 (PC5/NAND_RE/SDC2_CLK)
unnamed: R35.1, U11.A16 (PC7/NAND_RB1)
unnamed: R25.2, U11.H6 (PA5/UART0_RX/PWM0/PA_EINT5)
SCK: U11.F11 (PA11/TWI0_SCK/DI_TX/PA_EINT11); also elsewhere on the board
SDA: U11.C13 (PA12/TWI0_SDA/DI_RX/PA_EINT12); also elsewhere on the board
SDC0-CLK: U11.D20 (PF2/SDC0_CLK/UART0_TX); also elsewhere on the board
SDC0-CMD: U11.F18 (PF3/SDC0_CMD/JTAG_DO0); also elsewhere on the board
SDC0-D0: U11.A19 (PF1/SDC0_D0/JTAG_DI0); also elsewhere on the board
SDC0-D1: U11.D19 (PF0/SDC0_D1/JTAG_MS0); also elsewhere on the board
SDC0-D2: U11.C20 (PF5/SDC0_D2/JTAG_CK0); also elsewhere on the board
SDC0-D3: U11.E21 (PF4/SDC0_D3/UART0_RX); also elsewhere on the board
SDC0-DET: U11.G18 (PF6); also elsewhere on the board
SRR_IRQ: U11.E14 (PA6/SIM_PWREN/PA_EINT6); also elsewhere on the board
SRR_NRST: U11.E3 (PG9/UART1_CTS/PG_EINT9); also elsewhere on the board
UART0_RX: R25.1; also elsewhere on the board
UART0_TX: U11.F5 (PA4/UART0_TX/PA_EINT4); also elsewhere on the board
UART1_RX: U11.D3 (PG7/UART1_RX/PG_EINT7); also elsewhere on the board
UART1_TX: U11.G4 (PG6/UART1_TX/PG_EINT6); also elsewhere on the board
UART2_RX: U11.D5 (PA1/UART2_RX/JTAG_CK0/PA_EINT1); also elsewhere on the board
UART2_TX: U11.D11 (PA0/UART2_TX/JTAG_MS0/PA_EINT0); also elsewhere on the board
VDD_SYS_3.3V: C69.1, R35.2, U11.H7 (VCC_PG), U11.J15 (VCC-PD); also elsewhere on the board
WIFI-DataReady: U11.B13 (PA18/PCM0_SYNC/TWI1_SCK/PA_EINT18); also elsewhere on the board
WIFI-HandShake: U11.D2 (PG11/PCM1_CLK/PG_EINT11); also elsewhere on the board
WIFI-RST: U11.C5 (PE15); also elsewhere on the board
WIFI-SPI-CS0: U11.B15 (PC3/NAND_CE1/SPI0_CS); also elsewhere on the board
WIFI-SPI-MISO: U11.C16 (PC1/NAND_ALE/SPI0_MISO); also elsewhere on the board
WIFI-SPI-MOSI: R43.2; also elsewhere on the board
WIFI-SPI-SCLK: R62.2; also elsewhere on the board
eMMC-CLK: R34.2; also elsewhere on the board
eMMC-CMD: U11.E16 (PC6/NAND_RB0/SDC2_CMD); also elsewhere on the board
eMMC-D0: U11.B18 (PC8/NAND_DQ0/SDC2_D0); also elsewhere on the board
eMMC-D1: U11.C17 (PC9/NAND_DQ1/SDC2_D1); also elsewhere on the board
eMMC-D2: U11.D17 (PC10/NAND_DQ2/SDC2_D2); also elsewhere on the board
eMMC-D3: U11.C18 (PC11/NAND_DQ3/SDC2_D3); also elsewhere on the board
eMMC-D4: U11.B17 (PC12/NAND_DQ4/SDC2_D4); also elsewhere on the board
eMMC-D5: U11.B19 (PC13/NAND_DQ5/SDC2_D5); also elsewhere on the board
eMMC-D6: U11.F17 (PC14/NAND_DQ6/SDC2_D6); also elsewhere on the board
eMMC-D7: U11.C19 (PC15/NAND_DQ7/SDC2_D7); also elsewhere on the board
eMMC-RST: U11.H16 (PC16/NAND_DQS/SDC2_RST); also elsewhere on the board

Notes on the sheet:
Bluetooth/wifi uart
WIFI
(GPIOG8=200, GPIOG9=201, GPIOG11=203)
USB OTG
(GPIOA18=18)
Was DataReady
PC1 was connected to N_VBUSEN but I don't think it was used.
(GPIOE15=143)
GPIOG11 (was on gpio header)
(GPIOE14=142)
LORAUX was previously on GPIOC0 SRR_NRST was previously on GPIOC3
(GPIOC0=64, GPIOC1=65, GPIOC2=66, GPIOC3=67)

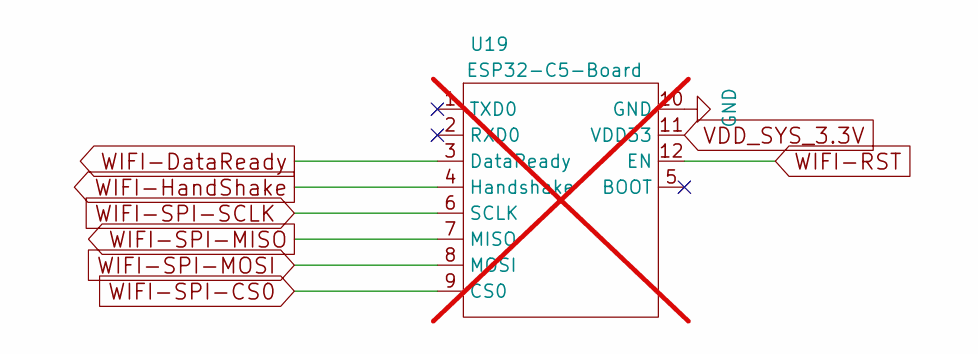
[picture p49: schematic Wifi-BT.kicad_sch]

Parts:
U19: ESP32-C5-Board; ESP32Hosted-C6-Board; not fitted

Connections:
GND: U19.10 (GND); also elsewhere on the board
VDD_SYS_3.3V: U19.11 (VDD33); also elsewhere on the board
WIFI-DataReady: U19.3 (DataReady); also elsewhere on the board
WIFI-HandShake: U19.4 (Handshake); also elsewhere on the board
WIFI-RST: U19.12 (EN); also elsewhere on the board
WIFI-SPI-CS0: U19.9 (CS0); also elsewhere on the board
WIFI-SPI-MISO: U19.7 (MISO); also elsewhere on the board
WIFI-SPI-MOSI: U19.8 (MOSI); also elsewhere on the board
WIFI-SPI-SCLK: U19.6 (SCLK); also elsewhere on the board
