henla464/WiRocKiCad/KiCad10/WiRoc_v8/WiRoc_NanoPi.kicad_pcb

## KiCad design KiCad10/WiRoc_v8/WiRoc_NanoPi.kicad_pcb (continued)

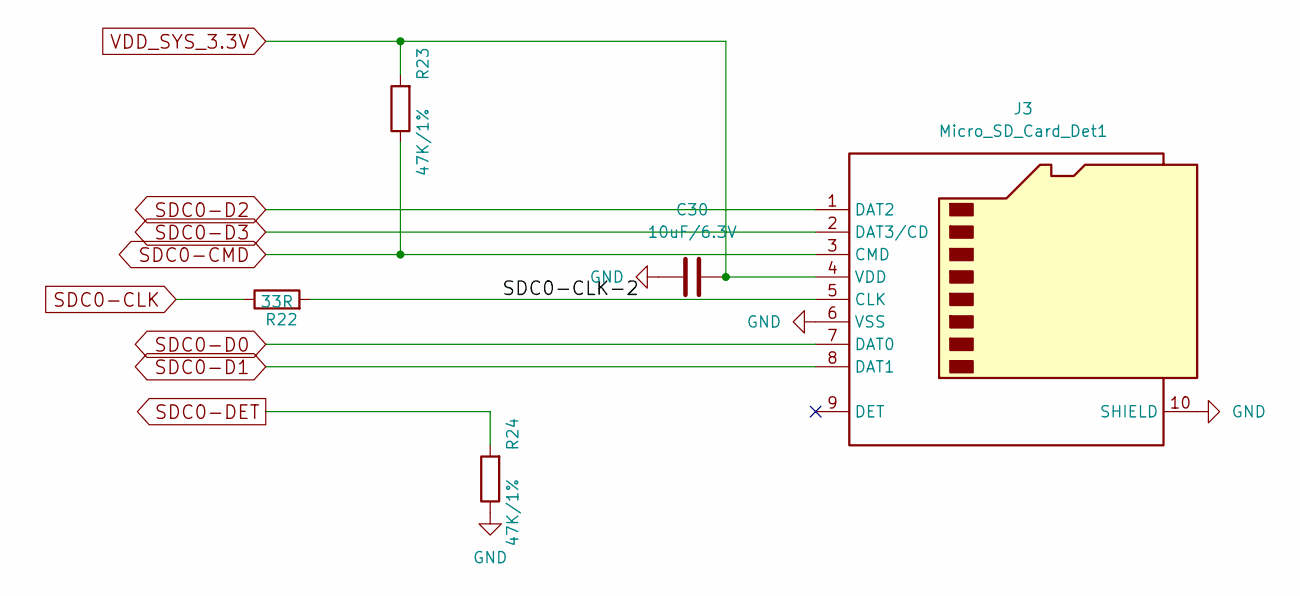
[picture p50: schematic MicroSD.kicad_sch]

Parts:
C30: 10uF/6.3V; C_0402_1005Metric; ManufacturerPartNumber CL05A106MQ5NUNC; LCSC Part # C15525
J3: Micro_SD_Card_Det1; TF-SMD_TF-018B-H15; ManufacturerPartNumber TF-018B-H15; LCSC Part # C2962372
R22: 33R; R_0402_1005Metric; ManufacturerPartNumber 0402WGF330JTCE; JLCBasicExtended Basic
R23, R24: 47K/1%; R_0402_1005Metric; ManufacturerPartNumber 0402WGF4702TCE; JLCBasicExtended Basic

Connections:
/MicroSD/SDC0-CLK-2: J3.5 (CLK), R22.2
GND: C30.1, J3.6 (VSS), J3.10 (SHIELD), R24.1; also elsewhere on the board
SDC0-CLK: R22.1; also elsewhere on the board
SDC0-CMD: J3.3 (CMD), R23.1; also elsewhere on the board
SDC0-D0: J3.7 (DAT0); also elsewhere on the board
SDC0-D1: J3.8 (DAT1); also elsewhere on the board
SDC0-D2: J3.1 (DAT2); also elsewhere on the board
SDC0-D3: J3.2 (DAT3/CD); also elsewhere on the board
SDC0-DET: R24.2; also elsewhere on the board
VDD_SYS_3.3V: C30.2, J3.4 (VDD), R23.2; also elsewhere on the board

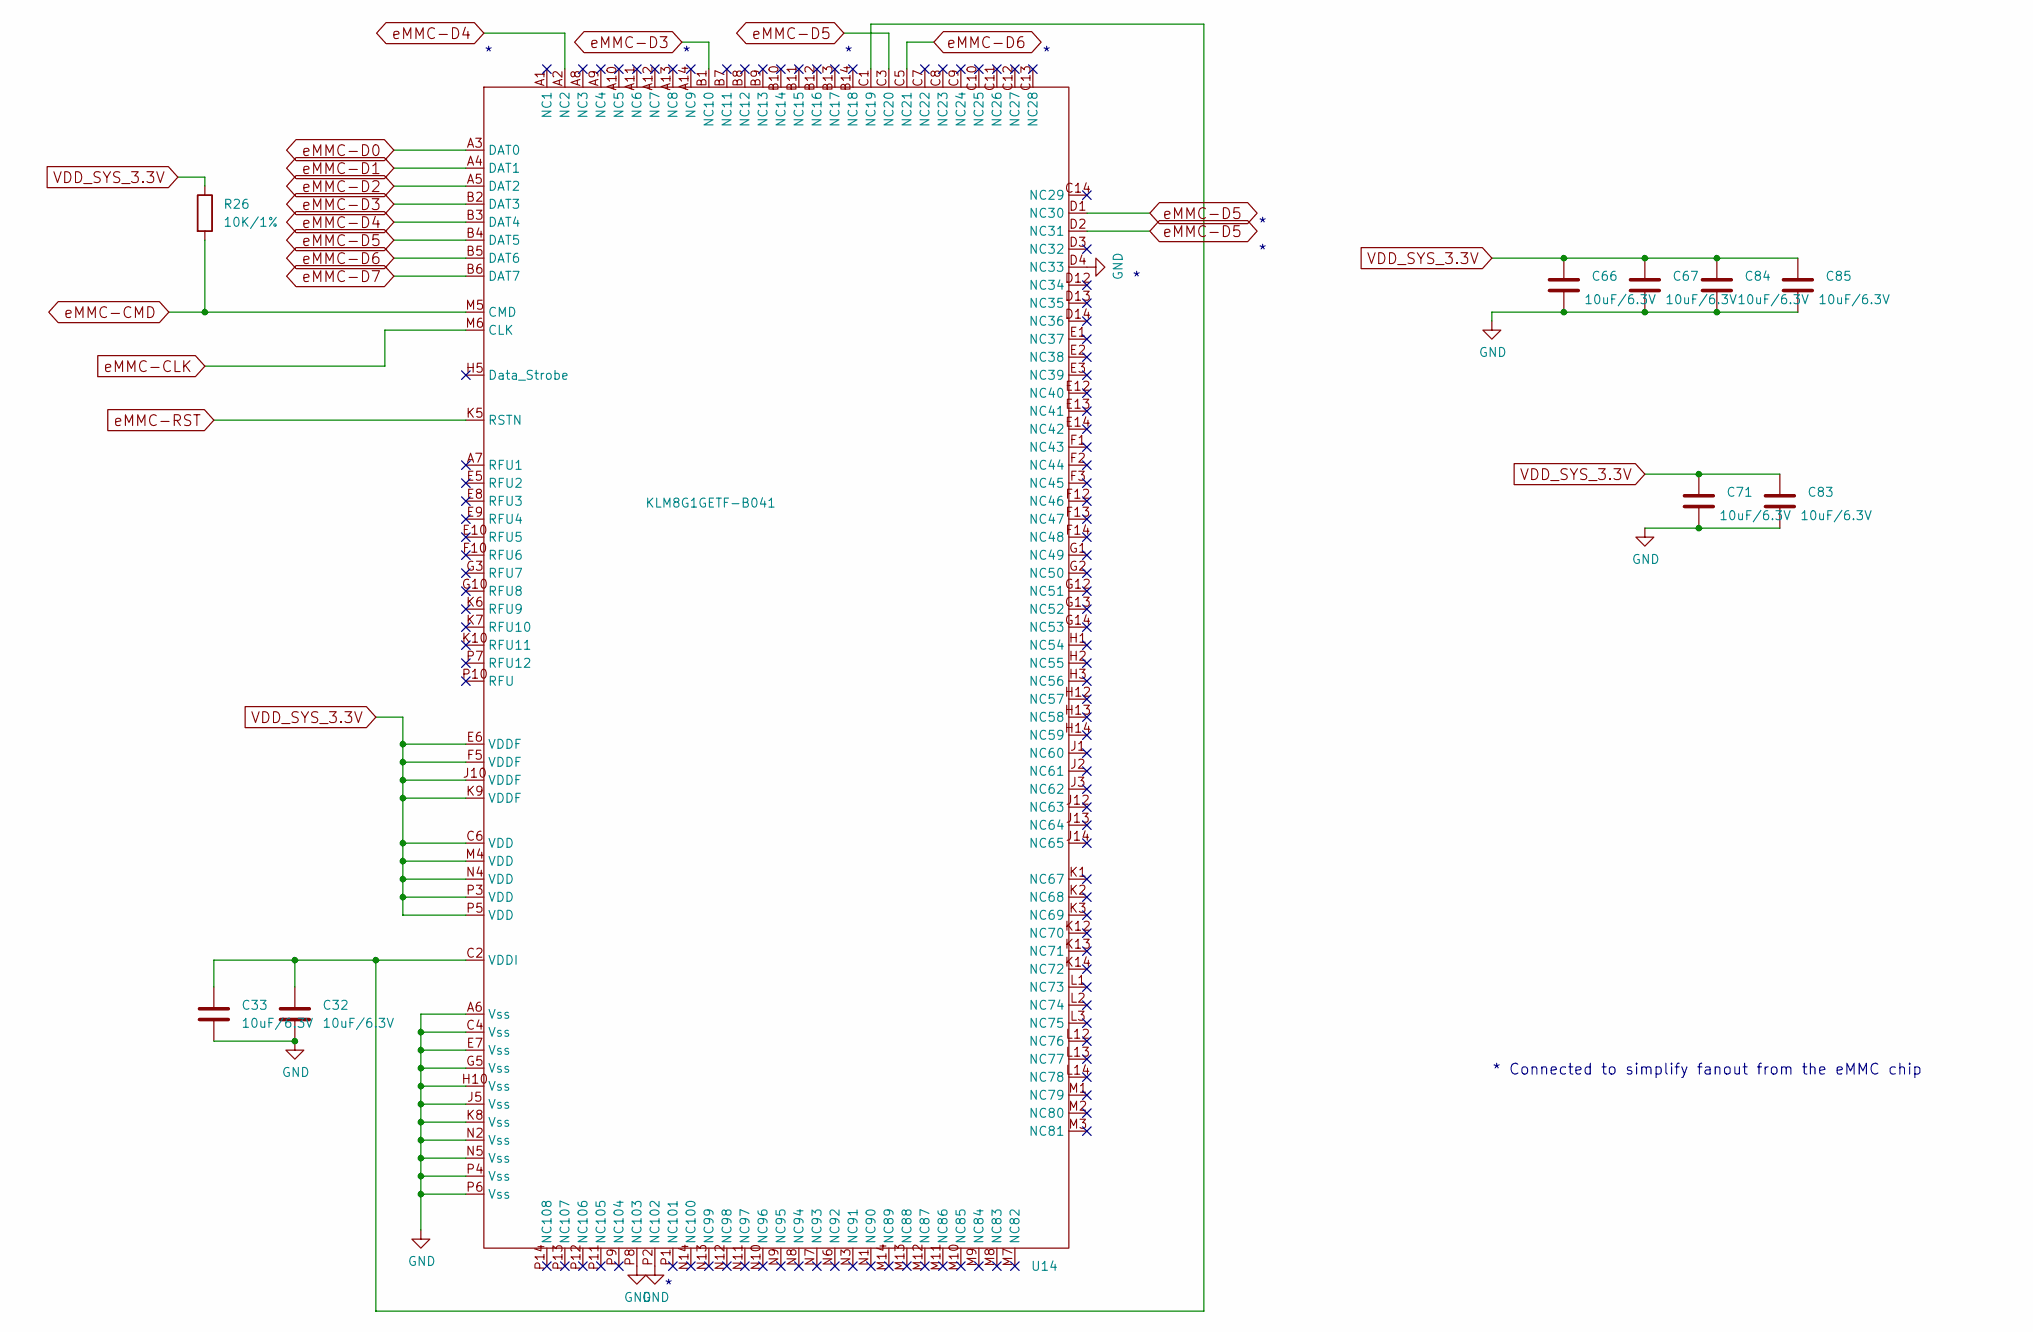
[picture p51: schematic eMMC.kicad_sch]

Parts:
C32, C33, C66, C67, C71, C83, C84, C85: 10uF/6.3V; C_0402_1005Metric; ManufacturerPartNumber CL05A106MQ5NUNC; LCSC Part # C15525
R26: 10K/1%; R_0402_1005Metric; ManufacturerPartNumber 0402WGF1002TCE; LCSC Part # C25744
U14: KLM8G1GETF-B041; MICRON_EMMC_153; ManufacturerPartNumber KLM8G1GETF-B041; JLCBasicExtended Extended

Connections:
GND: C32.2, C33.2, C66.2, C67.2, C71.2, C83.2, C84.2, C85.2, U14.A6 (Vss), U14.C4 (Vss), U14.D4 (NC33), U14.E7 (Vss), U14.G5 (Vss), U14.H10 (Vss), U14.J5 (Vss), U14.K8 (Vss), U14.N2 (Vss), U14.N5 (Vss), U14.P2 (NC102), U14.P4 (Vss), U14.P6 (Vss), U14.P8 (NC103); also elsewhere on the board
unnamed: C32.1, C33.1, U14.C1 (NC19), U14.C2 (VDDI)
VDD_SYS_3.3V: C66.1, C67.1, C71.1, C83.1, C84.1, C85.1, R26.1, U14.C6 (VDD), U14.E6 (VDDF), U14.F5 (VDDF), U14.J10 (VDDF), U14.K9 (VDDF), U14.M4 (VDD), U14.N4 (VDD), U14.P3 (VDD), U14.P5 (VDD); also elsewhere on the board
eMMC-CLK: U14.M6 (CLK); also elsewhere on the board
eMMC-CMD: R26.2, U14.M5 (CMD); also elsewhere on the board
eMMC-D0: U14.A3 (DAT0); also elsewhere on the board
eMMC-D1: U14.A4 (DAT1); also elsewhere on the board
eMMC-D2: U14.A5 (DAT2); also elsewhere on the board
eMMC-D3: U14.B1 (NC10), U14.B2 (DAT3); also elsewhere on the board
eMMC-D4: U14.A2 (NC2), U14.B3 (DAT4); also elsewhere on the board
eMMC-D5: U14.B4 (DAT5), U14.C3 (NC20), U14.D1 (NC30), U14.D2 (NC31); also elsewhere on the board
eMMC-D6: U14.B5 (DAT6), U14.C5 (NC21); also elsewhere on the board
eMMC-D7: U14.B6 (DAT7); also elsewhere on the board
eMMC-RST: U14.K5 (RSTN); also elsewhere on the board

Notes on the sheet:
* Connected to simplify fanout from the eMMC chip

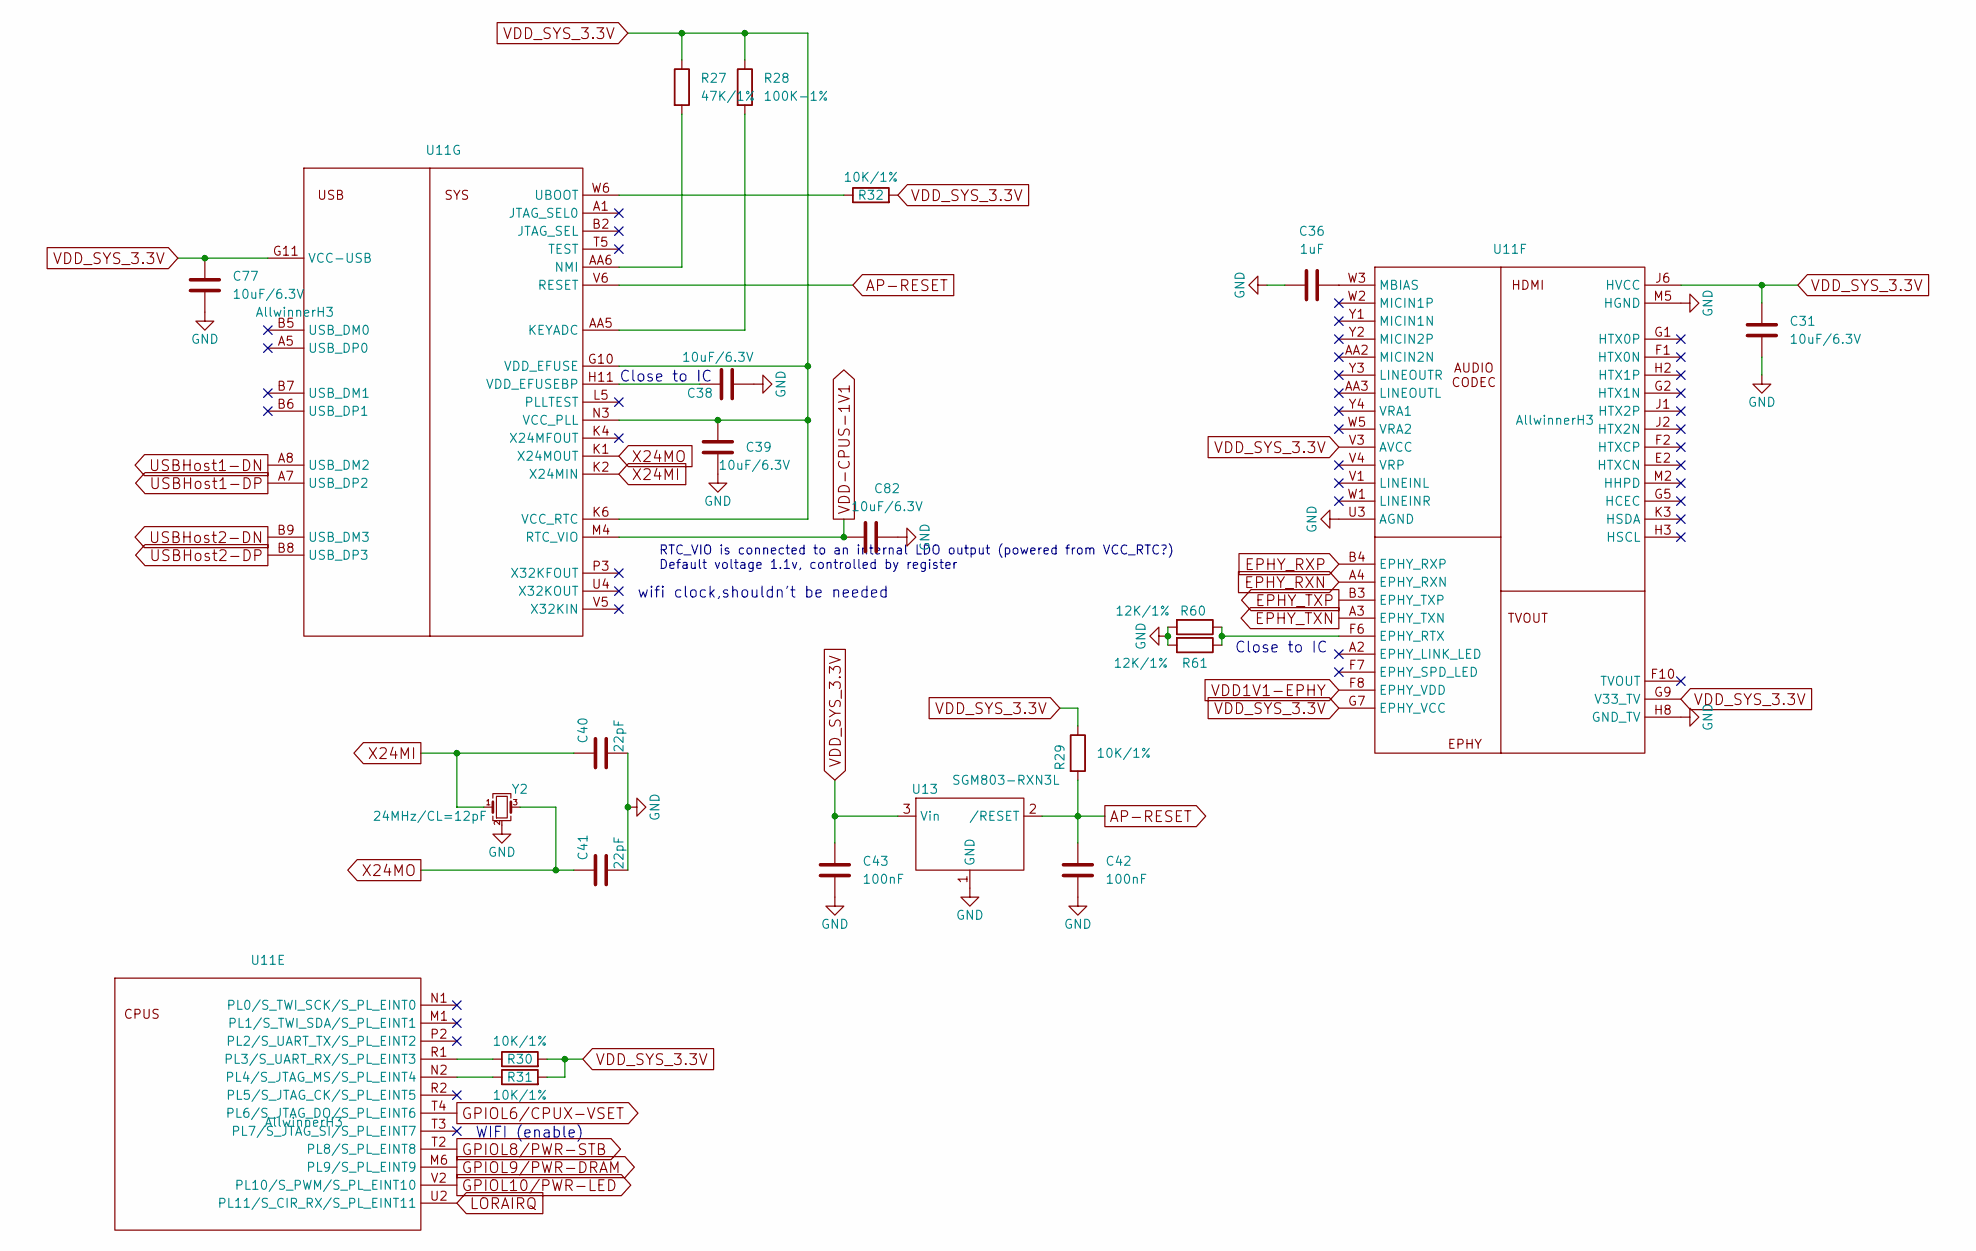
[picture p52: schematic USB-SYS.kicad_sch]

Parts:
C31, C38, C39, C77, C82: 10uF/6.3V; C_0402_1005Metric; ManufacturerPartNumber CL05A106MQ5NUNC; LCSC Part # C15525
C36: 1uF; C_0402_1005Metric; ManufacturerPartNumber CL05A105KA5NQNC; LCSC Part # C52923
C40, C41: 22pF; C_0402_1005Metric; ManufacturerPartNumber 0402CG220J500NT; JLCBasicExtended Basic
C42, C43: 100nF; C_0402_1005Metric; ManufacturerPartNumber CL05B104KO5NNNC; LCSC Part # C1525
R27: 47K/1%; R_0402_1005Metric; ManufacturerPartNumber 0402WGF4702TCE; JLCBasicExtended Basic
R28: 100K-1%; R_0402_1005Metric; ManufacturerPartNumber 0402WGF1003TCE; JLCBasicExtended Basic
R29, R30, R31, R32: 10K/1%; R_0402_1005Metric; ManufacturerPartNumber 0402WGF1002TCE; LCSC Part # C25744
R60, R61: 12K/1%; R_0402_1005Metric; ManufacturerPartNumber 0402WGF1202TCE; JLCBasicExtended Basic
U11: AllwinnerH3; BGA-347_21x21_14.0x14.0mm; ManufacturerPartNumber H3; JLCBasicExtended Extended
U13: SGM803-RXN3L; SOT-23-3; ManufacturerPartNumber SGM803-RXN3L/TR; JLCBasicExtended Extended
Y2: 24MHz/CL=12pF; Crystal_SMD_2520-4Pin_2.5x2.0mm; ManufacturerPartNumber TXM24M0004252FBCEO00T; JLCBasicExtended Extended

Connections:
AP-RESET: C42.1, R29.2, U11.V6 (RESET), U13.2 (/RESET)
EPHY_RXN: U11.A4 (EPHY_RXN); also elsewhere on the board
EPHY_RXP: U11.B4 (EPHY_RXP); also elsewhere on the board
EPHY_TXN: U11.A3 (EPHY_TXN); also elsewhere on the board
EPHY_TXP: U11.B3 (EPHY_TXP); also elsewhere on the board
GND: C31.2, C36.1, C38.2, C39.1, C40.1, C41.1, C42.2, C43.2, C77.2, C82.2, R60.2, R61.2, U11.H8 (GND_TV), U11.M5 (HGND), U11.U3 (AGND), U13.1 (GND), Y2.2 (G), Y2.4 (G); also elsewhere on the board
GPIOL6/CPUX-VSET: U11.T4 (PL6/S_JTAG_DO/S_PL_EINT6); also elsewhere on the board
GPIOL8/PWR-STB: U11.T2 (PL8/S_PL_EINT8); also elsewhere on the board
GPIOL9/PWR-DRAM: U11.M6 (PL9/S_PL_EINT9); also elsewhere on the board
GPIOL10/PWR-LED: U11.V2 (PL10/S_PWM/S_PL_EINT10); also elsewhere on the board
LORAIRQ: U11.U2 (PL11/S_CIR_RX/S_PL_EINT11); also elsewhere on the board
unnamed: R30.1, U11.R1 (PL3/S_UART_RX/S_PL_EINT3)
unnamed: R31.1, U11.N2 (PL4/S_JTAG_MS/S_PL_EINT4)
unnamed: R60.1, R61.1, U11.F6 (EPHY_RTX)
unnamed: C36.2, U11.W3 (MBIAS)
unnamed: R28.2, U11.AA5 (KEYADC)
unnamed: R27.2, U11.AA6 (NMI)
unnamed: R32.1, U11.W6 (UBOOT)
unnamed: C38.1, U11.H11 (VDD_EFUSEBP)
USBHost1-DN: U11.A8 (USB_DM2); also elsewhere on the board
USBHost1-DP: U11.A7 (USB_DP2); also elsewhere on the board
USBHost2-DN: U11.B9 (USB_DM3); also elsewhere on the board
USBHost2-DP: U11.B8 (USB_DP3); also elsewhere on the board
VDD1V1-EPHY: U11.F8 (EPHY_VDD); also elsewhere on the board
VDD-CPUS-1V1: C82.1, U11.M4 (RTC_VIO); also elsewhere on the board
VDD_SYS_3.3V: C31.1, C39.2, C43.1, C77.1, R27.1, R28.1, R29.1, R30.2, R31.2, R32.2, U11.G7 (EPHY_VCC), U11.G9 (V33_TV), U11.G10 (VDD_EFUSE), U11.G11 (VCC-USB), U11.J6 (HVCC), U11.K6 (VCC_RTC), U11.N3 (VCC_PLL), U11.V3 (AVCC), U13.3 (Vin); also elsewhere on the board
X24MI: C40.2, U11.K2 (X24MIN), Y2.1
X24MO: C41.2, U11.K1 (X24MOUT), Y2.3

Notes on the sheet:
Close to IC
RTC_VIO is connected to an internal LDO output (powered from VCC_RTC?) Default voltage 1.1v, controlled by register
wifi clock,shouldn't be needed
WIFI (enable)

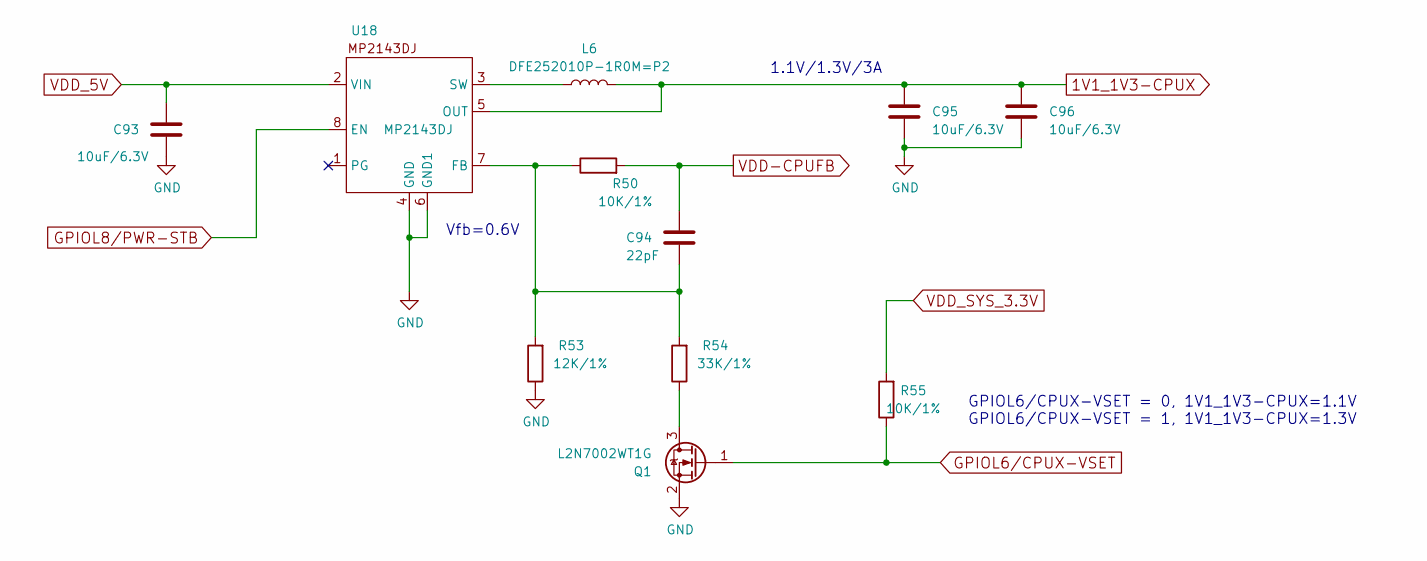
[picture p53: schematic Power1.kicad_sch]

Parts:
C93, C95, C96: 10uF/6.3V; C_0402_1005Metric; ManufacturerPartNumber CL05A106MQ5NUNC; LCSC Part # C15525
C94: 22pF; C_0402_1005Metric; ManufacturerPartNumber 0402CG220J500NT; LCSC Part # C1555
L6: DFE252010P-1R0M=P2; L_1008_2520Metric; ManufacturerPartNumber DFE252010P-1R0M=P2; JLCBasicExtended Extended
Q1: L2N7002WT1G; SOT-323_SC-70; ManufacturerPartNumber L2N7002WT1G; JLCBasicExtended Extended
R50: 10K/1%; R_0402_1005Metric; ManufacturerPartNumber 0402WGF1002TCE; JLCBasicExtended Basic
R53: 12K/1%; R_0402_1005Metric; ManufacturerPartNumber 0402WGF1202TCE; JLCBasicExtended Basic
R54: 33K/1%; R_0402_1005Metric; ManufacturerPartNumber 0402WGF3302TCE; JLCBasicExtended Basic
R55: 10K/1%; R_0402_1005Metric; ManufacturerPartNumber 0402WGF1002TCE; LCSC Part # C25744
U18: MP2143DJ; TSOT-23-8-Thinner-Pads; ManufacturerPartNumber MP2143DJ-LF-Z; JLCBasicExtended Extended

Connections:
1V1_1V3-CPUX: C95.1, C96.1, L6.2, U18.5 (OUT); also elsewhere on the board
GND: C93.2, C95.2, C96.2, Q1.2 (S), R53.1, U18.4 (GND), U18.6 (GND1); also elsewhere on the board
GPIOL6/CPUX-VSET: Q1.1 (G), R55.1; also elsewhere on the board
GPIOL8/PWR-STB: U18.8 (EN); also elsewhere on the board
unnamed: Q1.3 (D), R54.1
unnamed: C94.2, R50.1, R53.2, R54.2, U18.7 (FB)
unnamed: L6.1, U18.3 (SW)
VDD-CPUFB: C94.1, R50.2; also elsewhere on the board
VDD_5V: C93.1, U18.2 (VIN); also elsewhere on the board
VDD_SYS_3.3V: R55.2; also elsewhere on the board

Notes on the sheet:
GPIOL6/CPUX-VSET = 0, 1V1_1V3-CPUX=1.1V GPIOL6/CPUX-VSET = 1, 1V1_1V3-CPUX=1.3V
1.1V/1.3V/3A
Vfb=0.6V

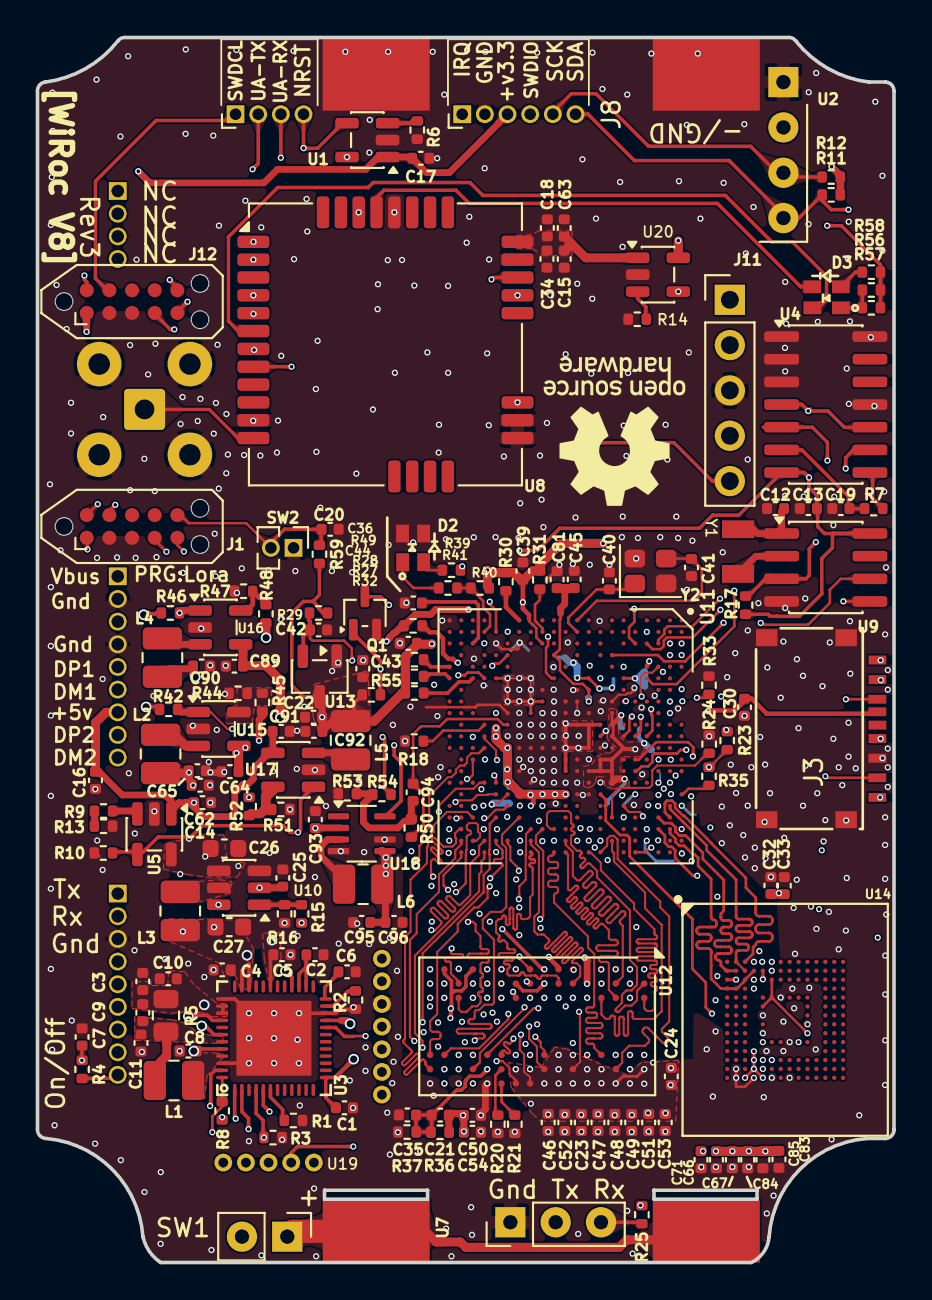
[picture p54: board WiRoc_NanoPi.kicad_pcb from above]

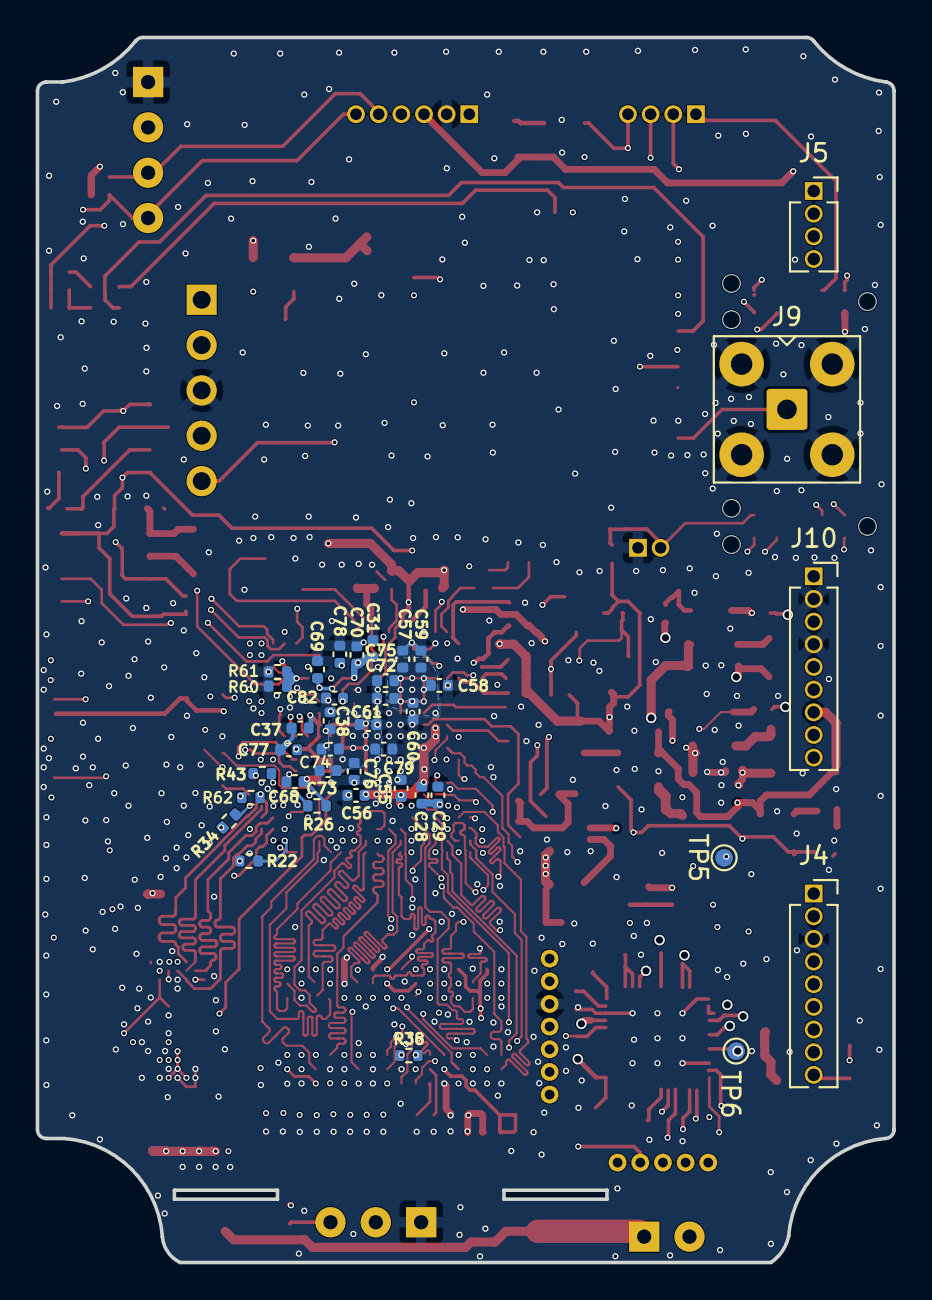
[picture p55: board WiRoc_NanoPi.kicad_pcb from below]

Board: 6 copper layers, 48.0 x 68.7 mm, 199 parts (38 on the bottom side), 192 nets.
