henla464/WiRocKiCad/KiCad10/SRRReceiverProgrammerAdaptorBoard/SRRReceiverProgrammerAdaptorBoard.kicad_pcb

## KiCad design KiCad10/SRRReceiverProgrammerAdaptorBoard/SRRReceiverProgrammerAdaptorBoard.kicad_pcb (2026-05-12)

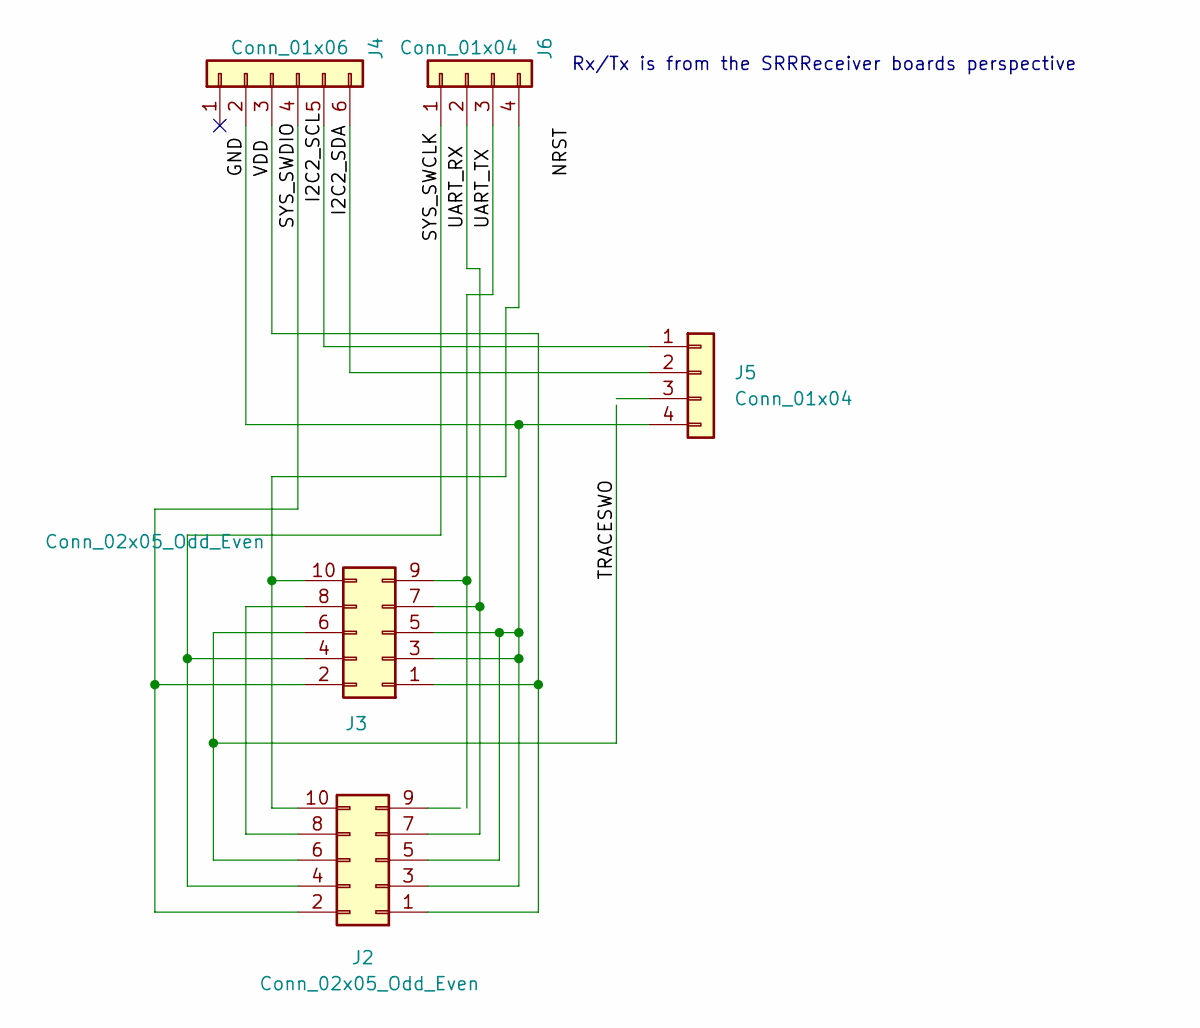
[picture p56: schematic SRRReceiverProgrammerAdaptorBoard.kicad_sch]

Parts:
J2, J3: Conn_02x05_Odd_Even; PinHeader_2x05_P1.27mm_Vertical
J4: Conn_01x06; PinHeader_1x06_P1.27mm_Horizontal
J5: Conn_01x04; PinHeader_1x04_P2.54mm_Vertical
J6: Conn_01x04; PinHeader_1x04_P1.27mm_Horizontal

Connections:
/GND: J2.3, J2.5, J3.3, J3.5, J4.2, J5.4
/I2C2_SCL: J4.5, J5.1
/I2C2_SDA: J4.6, J5.2
/SYS_SWCLK: J2.4, J3.4, J6.1
/SYS_SWDIO: J2.2, J3.2, J4.4
/TRACESWO: J2.6, J3.6
/UART_RX: J2.7, J3.7, J6.2
/UART_TX: J3.9, J6.3
/VDD: J2.1, J3.1, J4.3
unnamed: J2.8, J3.8
unnamed: J2.10, J3.10, J6.4

Notes on the sheet:
Rx/Tx is from the SRRReceiver boards perspective

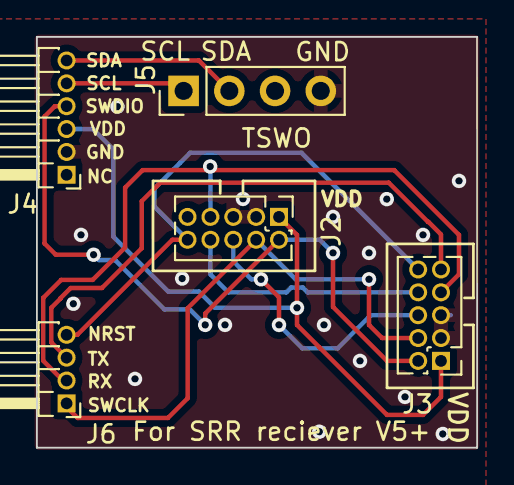
[picture p57: board KiCad10/SRRReceiverProgrammerAdaptorBoard/SRRReceiverProgrammerAdapto… from above]

Board: 2 copper layers, 24.5 x 22.8 mm, 5 parts (0 on the bottom side), 11 nets.
