henla464/WiRocKiCad/KiCad9/ESPHostedTestBoard/ESPHostedTestBoard.kicad_pcb

## KiCad design KiCad9/ESPHostedTestBoard/ESPHostedTestBoard.kicad_pcb (2025-10-19)

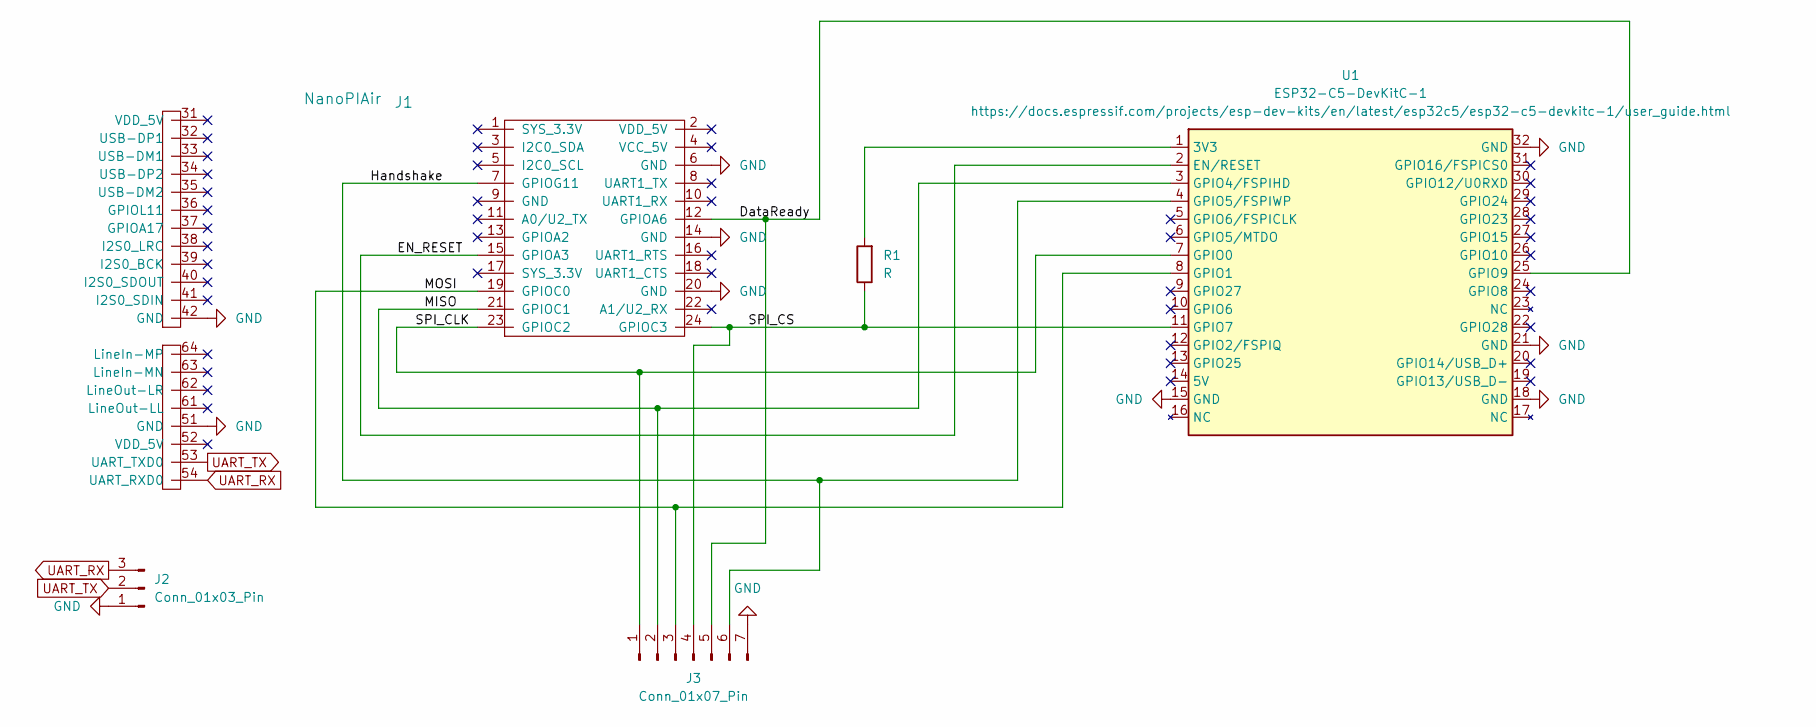
[picture p58: schematic ESPHostedTestBoard.kicad_sch]

Parts:
J1: NanoPIAir; NanoPiNeoAirAllPins
J2: Conn_01x03_Pin; PinHeader_1x03_P2.54mm_Vertical
J3: Conn_01x07_Pin; PinHeader_1x07_P2.54mm_Vertical
R1: R; R_0805_2012Metric
U1: ESP32-C5-DevKitC-1

Connections:
/DataReady: J1.12 (GPIOA6), J3.5, U1.25 (GPIO9)
/EN_RESET: J1.15 (GPIOA3), U1.2 (EN/RESET)
/Handshake: J1.7 (GPIOG11), J3.6, U1.4 (GPIO5/FSPIWP)
/MISO: J1.21 (GPIOC1), J3.2, U1.3 (GPIO4/FSPIHD)
/MOSI: J1.19 (GPIOC0), J3.3, U1.8 (GPIO1)
/SPI_CLK: J1.23 (GPIOC2), J3.1, U1.7 (GPIO0)
/SPI_CS: J1.24 (GPIOC3), J3.4, R1.1, U1.11 (GPIO7)
GND: J1.6 (GND), J1.14 (GND), J1.20 (GND), J1.42 (GND), J1.51 (GND), J2.1, J3.7, U1.15 (GND), U1.18 (GND), U1.21 (GND), U1.32 (GND)
unnamed: R1.2, U1.1 (3V3)
UART_RX: J1.54 (UART_RXD0), J2.3
UART_TX: J1.53 (UART_TXD0), J2.2

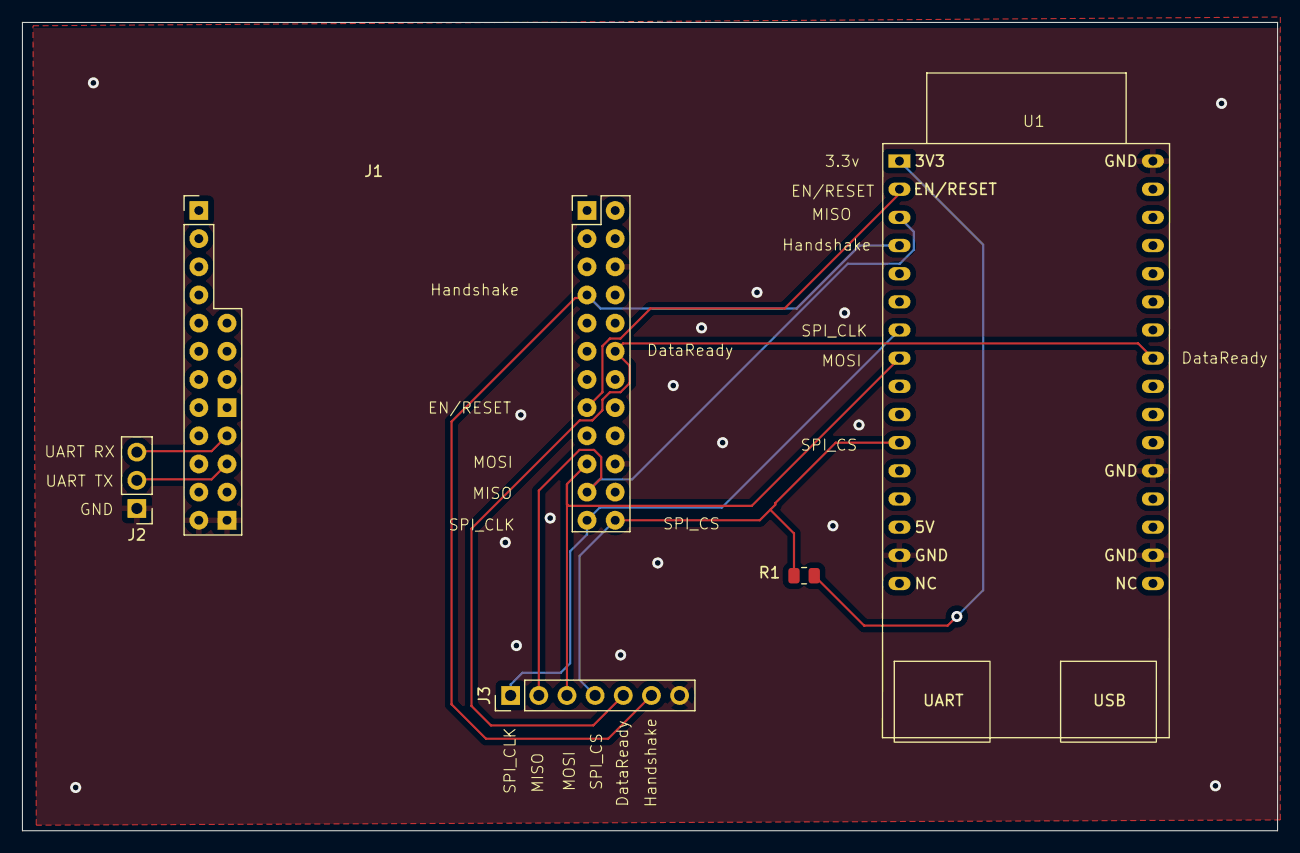
[picture p59: board ESPHostedTestBoard.kicad_pcb from above]

Board: 2 copper layers, 113.2 x 72.9 mm, 5 parts (0 on the bottom side), 11 nets.
