henla464/WiRocKiCad/KiCad8/Hardware_NanoPi_v7_ConnectorPlate/Hardware_NanoPi_v7_ConnectorPlate.kicad_pcb

## KiCad design KiCad8/Hardware_NanoPi_v7_ConnectorPlate/Hardware_NanoPi_v7_ConnectorPlate.kicad_pcb (2025-09-28)

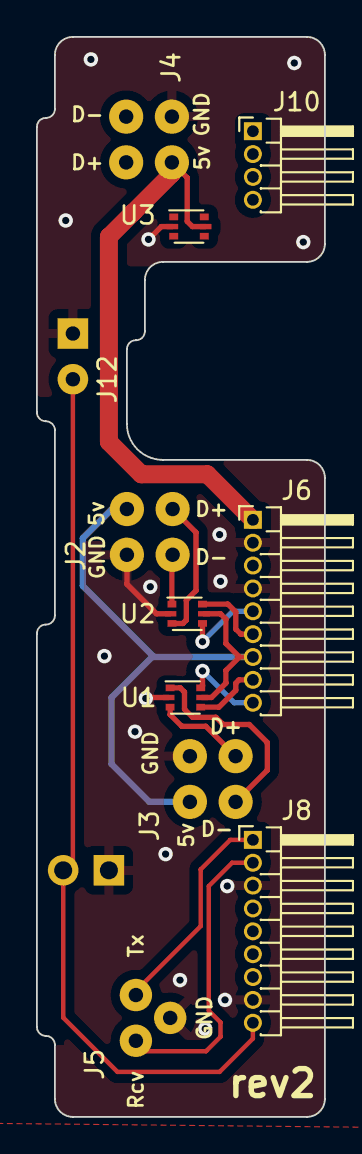
[picture p60: board Hardware_NanoPi_v7_ConnectorPlate.kicad_pcb from above]

Board: 2 copper layers, 16.0 x 60.0 mm, 12 parts (1 on the bottom side), 14 nets.

Parts:
J2: USB_Host_Data_02x02; USBConnPads7
J3: USB_Host_Data_02x02; USBConnPads8
J4: USB_Power_02x02; USBConnPads7
J5: Conn_01x03; SerialConnPads3Pin
J6, J8: Conn_01x09; PinHeader_1x09_P1.27mm_Horizontal
J10: Conn_01x04; PinHeader_1x04_P1.27mm_Horizontal
J11: Conn_01x02; PinHeader_1x02_P2.54mm_Horizontal
J12: Conn_01x02; PwrBtnPads
U1, U2, U3: USBLC6-2P6; SOT-666

Connections:
GND: J2.4, J3.4, J4.4, J5.3, J6.2, J6.4, J8.3, J8.8, J11.1, J12.1, U1.2 (GND), U2.2 (GND), U3.2 (GND)
unnamed: J2.2, U2.1 (I/O1)
unnamed: J2.3, U2.3 (I/O2)
unnamed: J3.2, U1.1 (I/O1)
unnamed: J3.3, U1.3 (I/O2)
PWRBTN: J8.9, J11.2, J12.2
R2IN: J5.1, J8.2
T2OUT: J5.2, J8.1
USBHost-DM1: J6.6, U2.6 (I/O1)
USBHost-DM2: J6.9, U1.6 (I/O1)
USBHost-DP1: J6.5, U2.4 (I/O2)
USBHost-DP2: J6.8, U1.4 (I/O2)
VBUS: J4.1, J6.1, U3.5 (VBUS)
VDD_5V: J2.1, J3.1, J6.7, U1.5 (VBUS), U2.5 (VBUS)
