henla464/WiRocKiCad/KiCad7/LoraAmplifier/LoraAmplifier.kicad_pcb

## KiCad design KiCad7/LoraAmplifier/LoraAmplifier.kicad_pcb (2025-09-28)

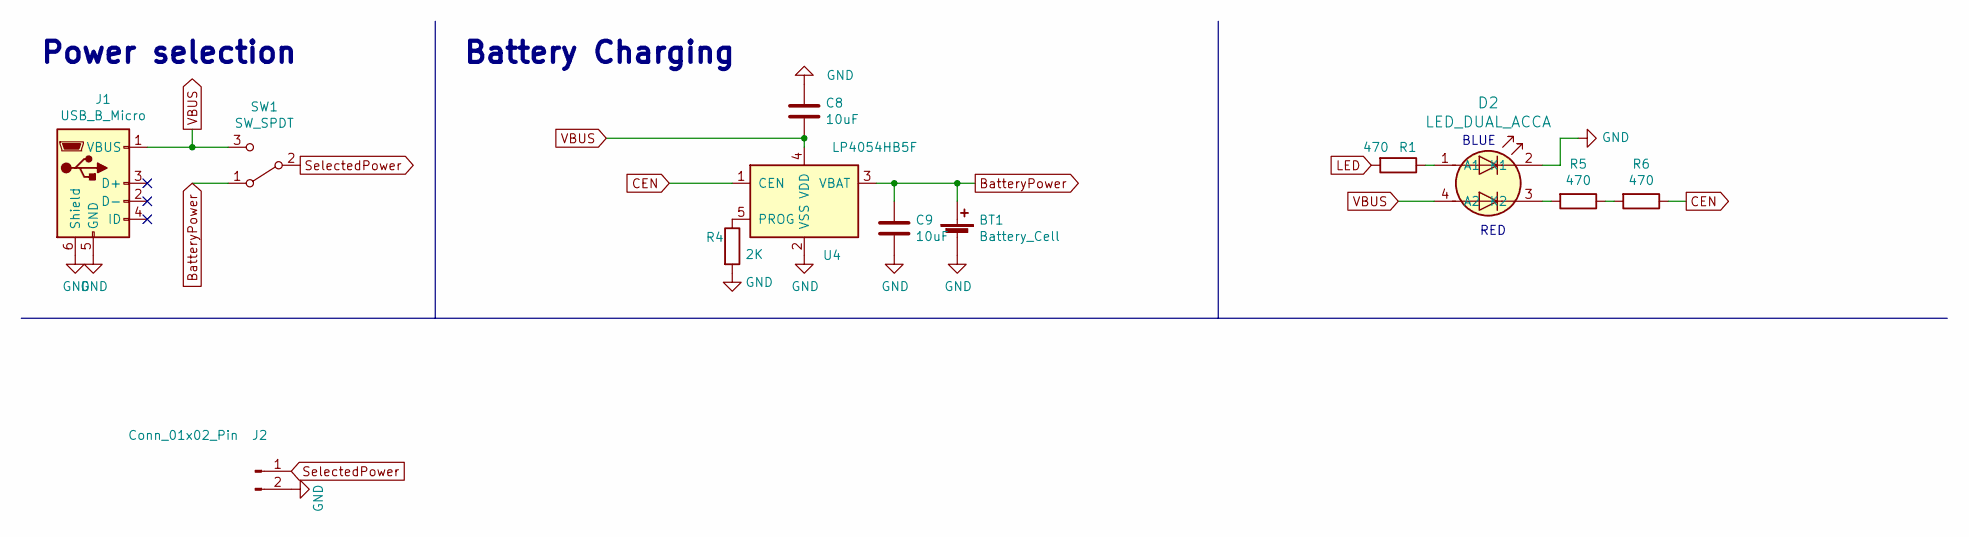
[picture p61: schematic LoraAmplifier.kicad_sch]

Parts:
BT1: Battery_Cell; JST_2.56
C8, C9: 10uF; C_0805_2012Metric_Pad1.15x1.40mm_HandSolder; ManufacturerPartNumber CL21A106KOQNNNE; LCSCPartNumber C1713
D2: LED_DUAL_ACCA; LED_Dual_1.7_1.6; ManufacturerPartNumber HL-PCB-1617S9FH203BC; LCSCPartNumber C513363
J1: USB_B_Micro; USB_Micro-B_Horizontal; ManufacturerPartNumber U254-051T-4BH83-F1S; LCSCPartNumber C397452
J2: Conn_01x02_Pin; JST_2.56
R1, R5, R6: 470; R_0805_2012Metric_Pad1.15x1.40mm_HandSolder; ManufacturerPartNumber 0805W8F4700T5E; LCSCPartNumber C17710
R4: 2K; R_0805_2012Metric_Pad1.15x1.40mm_HandSolder; ManufacturerPartNumber 0805W8F2001T5E; LCSCPartNumber C17604
SW1: SW_SPDT; SW_SPDT_PCM12; ManufacturerPartNumber SK-3296S-01-L3; LCSCPartNumber C319019
U4: LP4054HB5F; SOT-23-5; ManufacturerPartNumber LP4054HB5F; LCSCPartNumber C517187

Connections:
BatteryPower: BT1.1 (+), C9.1, SW1.1 (A), U4.3 (VBAT)
CEN: R6.1, U4.1 (CEN)
GND: BT1.2 (-), C8.1, C9.2, D2.2 (K1), J1.5 (GND), J1.6 (Shield), J2.2, R4.2, U4.2 (VSS)
unnamed: D2.1 (A1), R1.1
unnamed: D2.3 (K2), R5.2
unnamed: R5.1, R6.2
unnamed: R4.1, U4.5 (PROG)
SelectedPower: J2.1, SW1.2 (B)
VBUS: C8.2, D2.4 (A2), J1.1 (VBUS), SW1.3 (C), U4.4 (VDD)

Notes on the sheet:
Battery Charging
RED
BLUE
Power selection

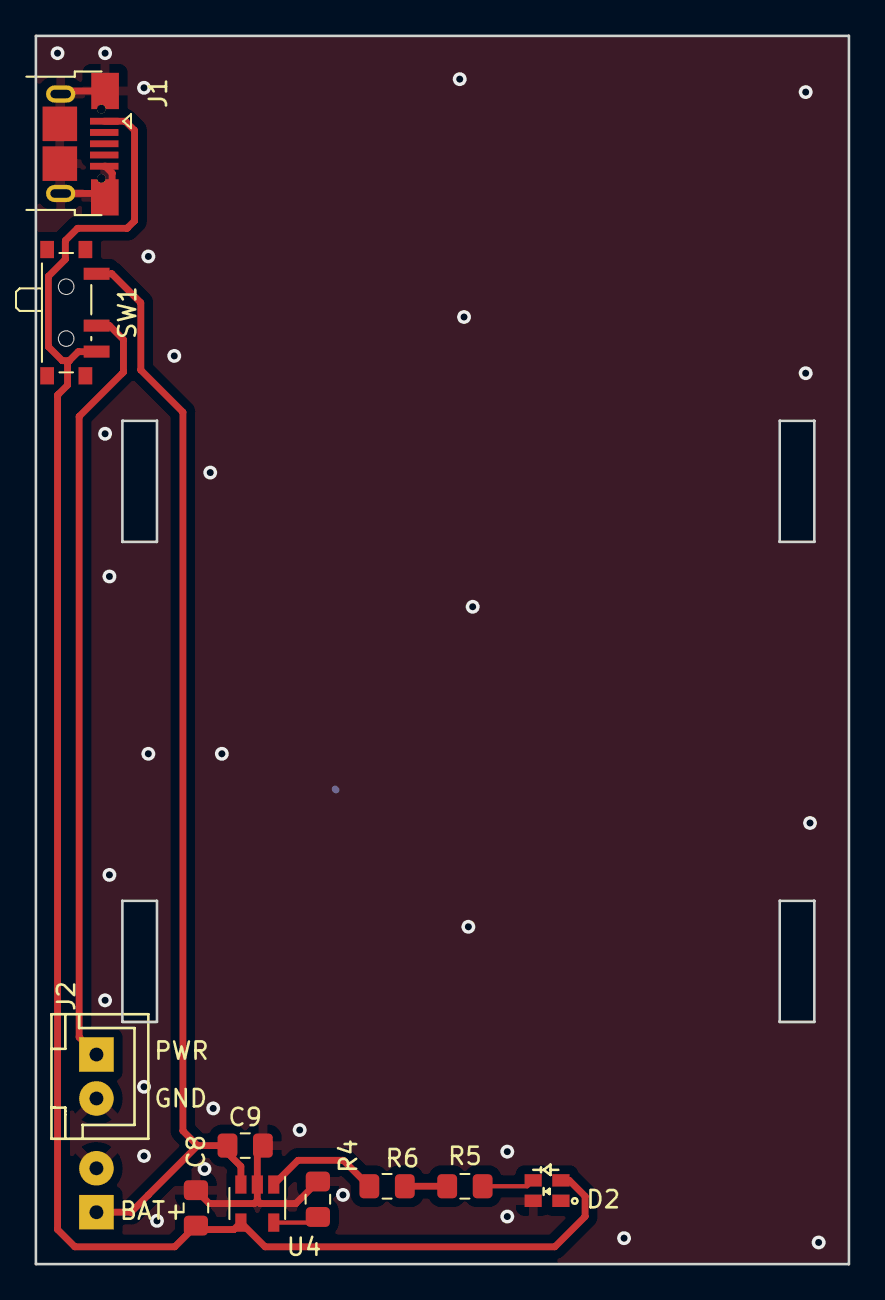
[picture p62: board LoraAmplifier.kicad_pcb from above]

Board: 2 copper layers, 47.0 x 71.0 mm, 11 parts (1 on the bottom side), 8 nets.
