henla464/WiRocKiCad/KiCad9/RAK3172_Breakoutboard/RAK3172_Breakoutboard.kicad_pcb

## KiCad design KiCad9/RAK3172_Breakoutboard/RAK3172_Breakoutboard.kicad_pcb (2025-09-28)

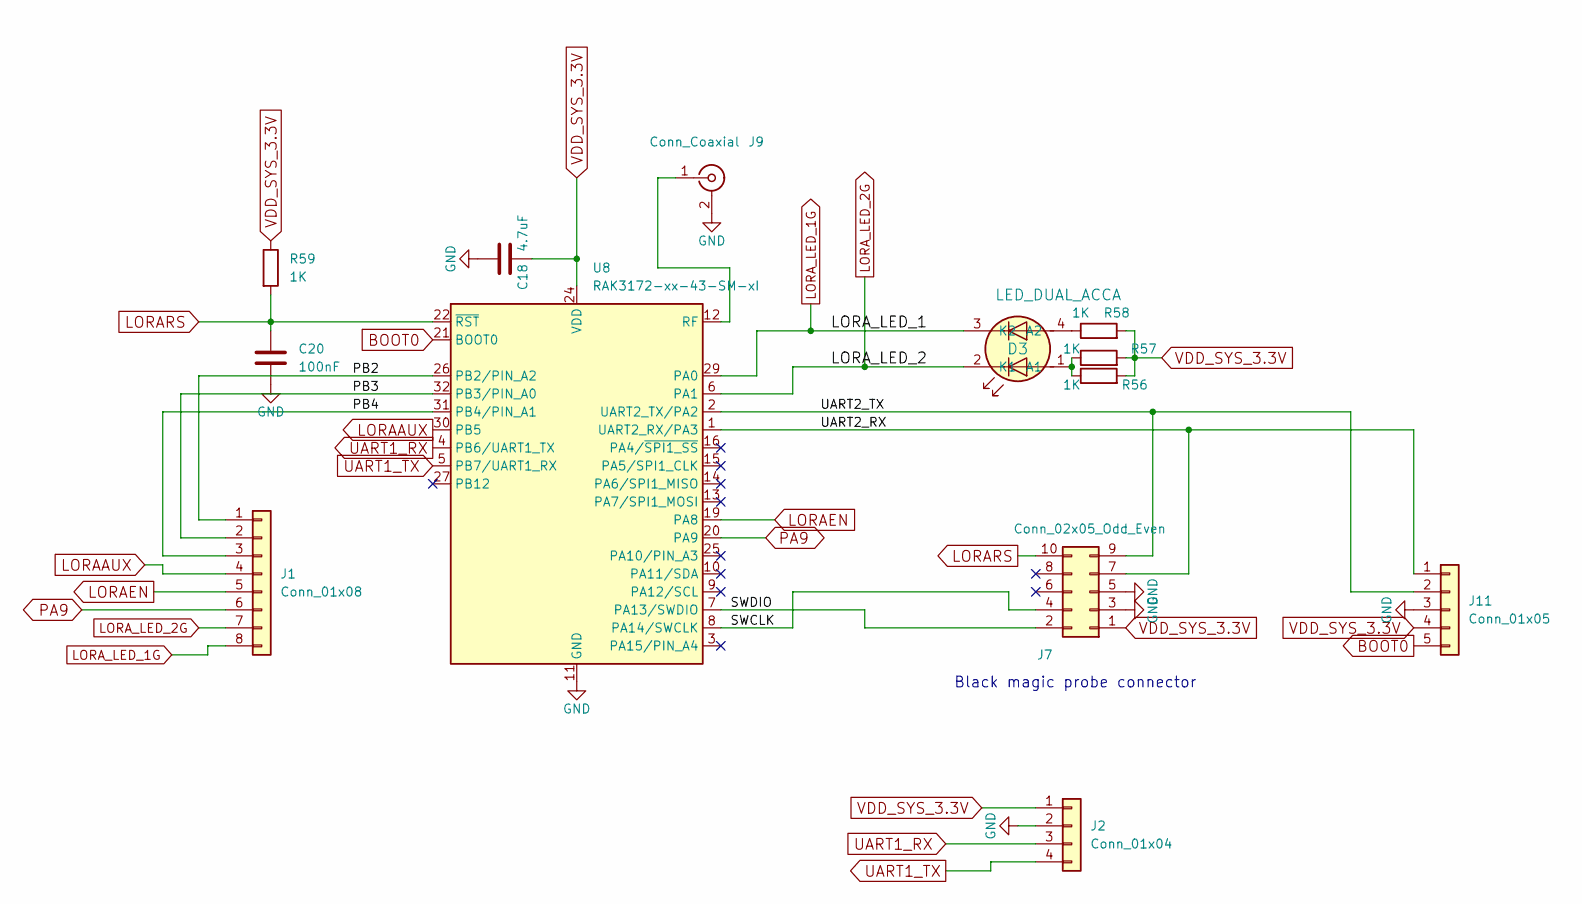
[picture p63: schematic RAK3172_Breakoutboard.kicad_sch]

Parts:
C18: 4.7uF; C_0603_1608Metric; ManufacturerPartNumber CL10A475KO8NNNC; LCSC Part # C19666
C20: 100nF; C_0402_1005Metric
D3: LED_DUAL_ACCA; LED_Dual_1.7_1.6; ManufacturerPartNumber HL-PCB-1617S9FH203BC; LCSC Part # C513363
J1: Conn_01x08; PinHeader_1x08_P2.54mm_Vertical
J2: Conn_01x04; PinHeader_1x04_P2.54mm_Vertical
J7: Conn_02x05_Odd_Even; PinHeader_2x05_P1.27mm_Vertical
J9: Conn_Coaxial; SMA_Amphenol_901-143_Horizontal
J11: Conn_01x05; PinHeader_1x05_P2.54mm_Vertical
R56, R57, R58: 1K; R_0603_1608Metric; ManufacturerPartNumber 0603WAJ0102T5E; LCSC Part # C21190
R59: 1K; R_0603_1608Metric
U8: RAK3172-xx-43-SM-xI; RAK3172

Connections:
/PB2: J1.1, U8.26 (PB2/PIN_A2)
/PB3: J1.2, U8.32 (PB3/PIN_A0)
/PB4: J1.3, U8.31 (PB4/PIN_A1)
/SWCLK: J7.4, U8.8 (PA14/SWCLK)
/SWDIO: J7.2, U8.7 (PA13/SWDIO)
/UART2_RX: J7.7, J11.1, U8.1 (UART2_RX/PA3)
/UART2_TX: J7.9, J11.2, U8.2 (UART2_TX/PA2)
BOOT0: J11.5, U8.21 (BOOT0)
GND: C18.2, C20.2, J2.2, J7.3, J7.5, J9.2 (Ext), J11.3, U8.11 (GND), U8.17 (GND), U8.18 (GND), U8.23 (GND), U8.28 (GND)
LORAAUX: J1.4, U8.30 (PB5)
LORAEN: J1.5, U8.19 (PA8)
LORARS: C20.1, J7.10, R59.2, U8.22 (~RST)
LORA_LED_1G: D3.3 (K2), J1.8, U8.29 (PA0)
LORA_LED_2G: D3.2 (K1), J1.7, U8.6 (PA1)
unnamed: D3.1 (A1), R56.1, R57.1
unnamed: D3.4 (A2), R58.1
unnamed: J9.1 (In), U8.12 (RF)
PA9: J1.6, U8.20 (PA9)
UART1_RX: J2.3, U8.4 (PB6/UART1_TX)
UART1_TX: J2.4, U8.5 (PB7/UART1_RX)
VDD_SYS_3.3V: C18.1, J2.1, J7.1, J11.4, R56.2, R57.2, R58.2, R59.1, U8.24 (VDD)

Notes on the sheet:
Black magic probe connector

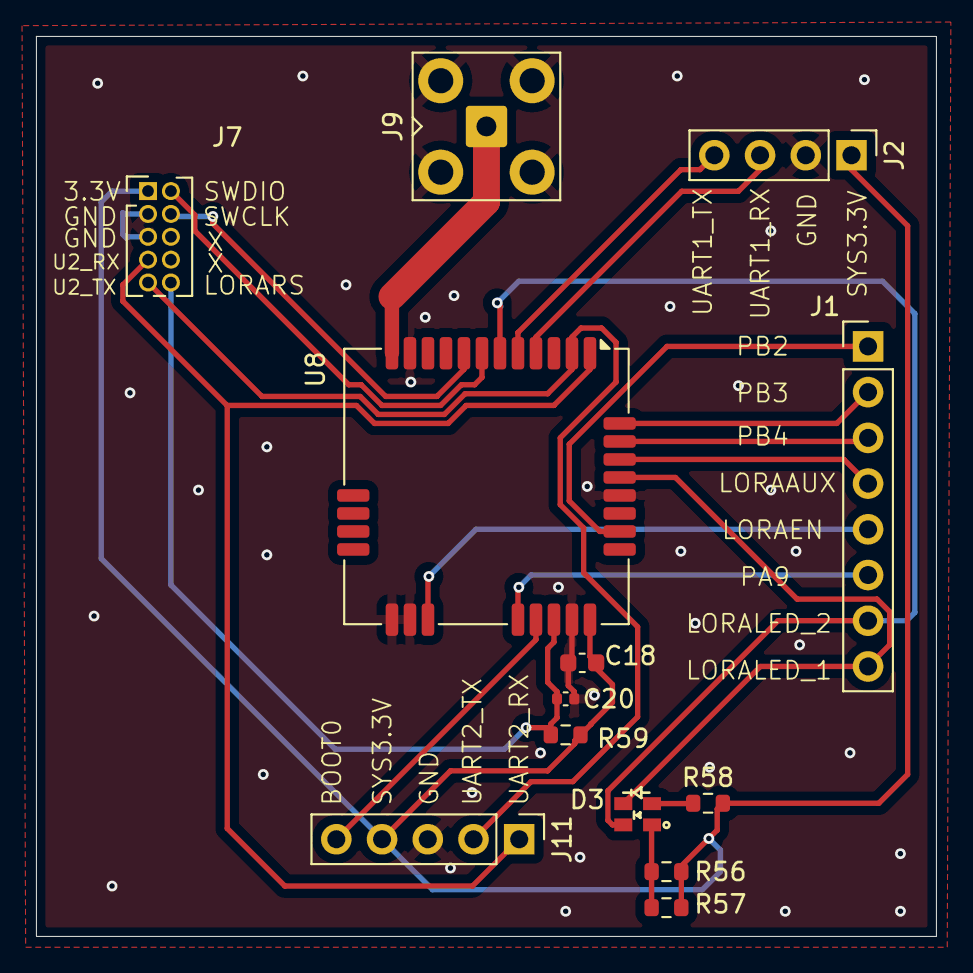
[picture p64: board RAK3172_Breakoutboard.kicad_pcb from above]

Board: 2 copper layers, 50.0 x 50.0 mm, 13 parts (0 on the bottom side), 21 nets.
