henla464/WiRocKiCad/KiCad7/TestAXP209/TestAXP209/TestAXP209.kicad_pcb

## KiCad design KiCad7/TestAXP209/TestAXP209/TestAXP209.kicad_pcb (2024-07-03)

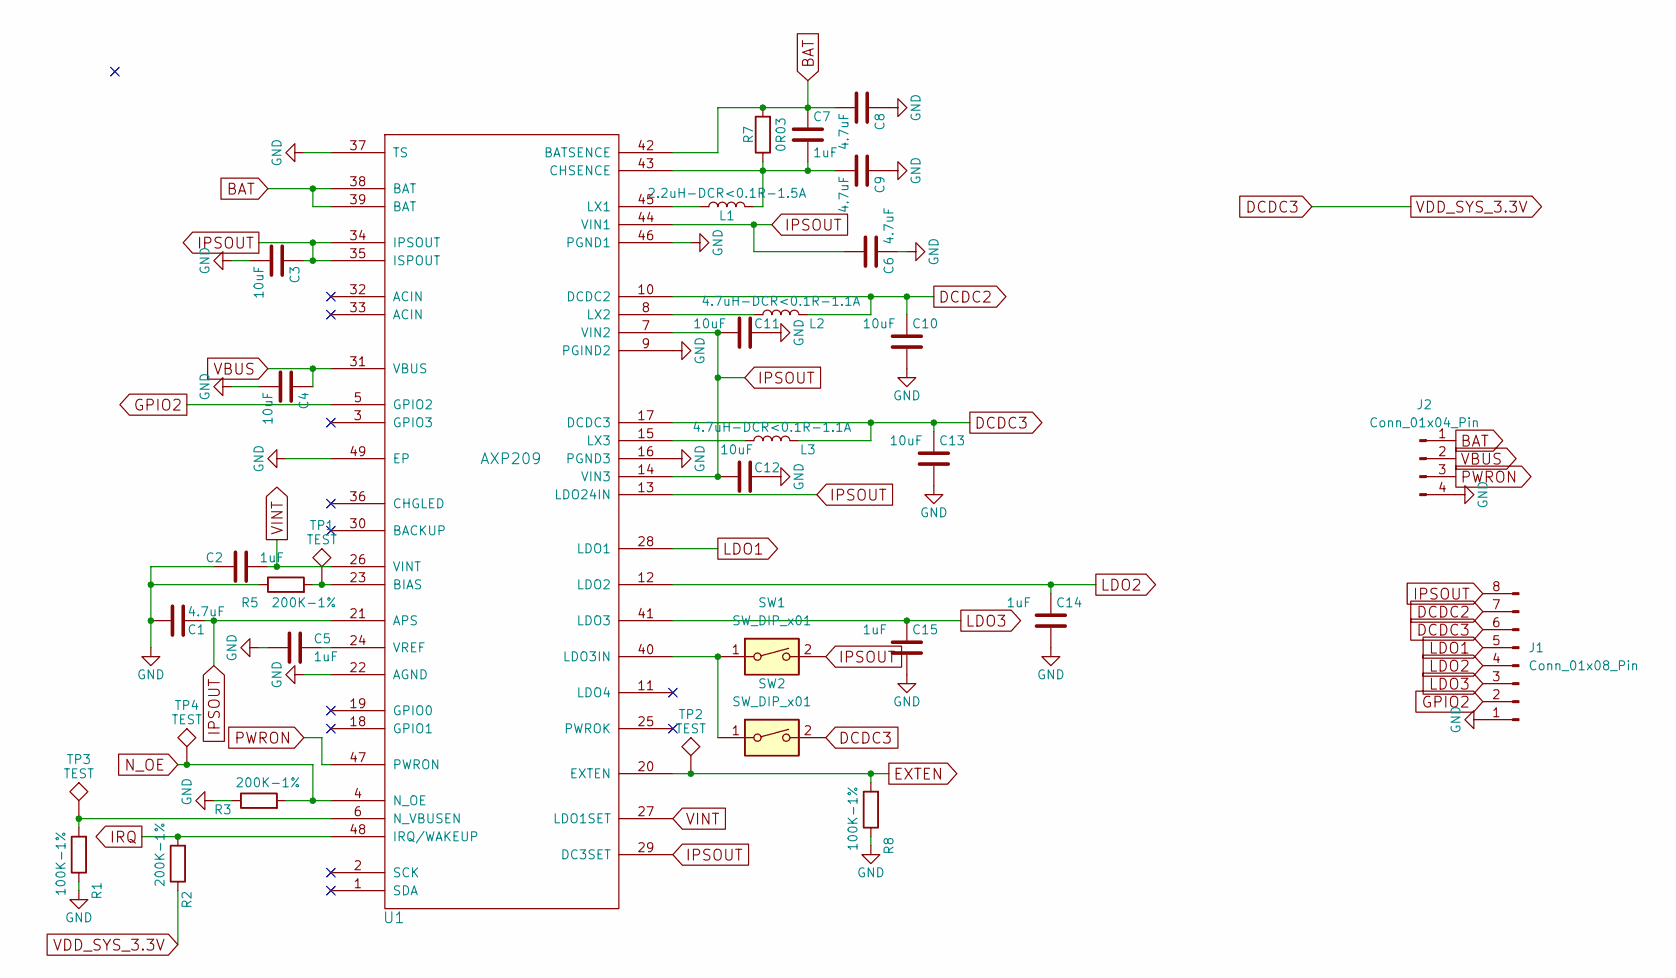
[picture p65: schematic TestAXP209.kicad_sch]

Parts:
C1, C6, C8, C9: 4.7uF; C_0603_1608Metric; ManufacturerPartNumber CL10A475KO8NNNC; LCSC Part # C19666
C2, C5, C7: 1uF; C_0603_1608Metric; ManufacturerPartNumber CL10A105KB8NNNC; LCSC Part # C15849
C3, C4: 10uF; C_0603_1608Metric; ManufacturerPartNumber CL10A106KP8NNNC; LCSC Part # C19702
C10, C11, C12, C13: 10uF; C_0603_1608Metric; ManufacturerPartNumber CL10A475KO8NNNC; LCSC Part # C19666
C14, C15: 1uF; C_0603_1608Metric; ManufacturerPartNumber CL10A475KO8NNNC; LCSC Part # C19666
J1: Conn_01x08_Pin; PinHeader_1x08_P2.54mm_Vertical
J2: Conn_01x04_Pin; PinHeader_1x04_P2.54mm_Vertical
L1: 2.2uH-DCR<0.1R-1.5A; Inductor_SLW4018; ManufacturerPartNumber SLW4018S2R2MST; LCSC Part # C206341
L2: 4.7uH-DCR<0.1R-1.1A; Inductor_SLW4018; ManufacturerPartNumber ?? DFE322520FD-4R7M=P2; LCSC Part # ?? C2045343
L3: 4.7uH-DCR<0.1R-1.1A; Inductor_SLW4018; ManufacturerPartNumber SWPA4030S4R7MT; LCSC Part # C57269
R1, R8: 100K-1%; R_0603_1608Metric; ManufacturerPartNumber 0603WAF1003T5E; LCSC Part # C25803
R2, R3, R5: 200K-1%; R_0603_1608Metric; ManufacturerPartNumber 0603WAF2003T5E; LCSC Part # C25811
R7: 0R03; R_0805_2012Metric; ManufacturerPartNumber 0805W4F300MT5E; LCSC Part # C247605
SW1, SW2: SW_DIP_x01; PinHeader_1x02_P2.54mm_Vertical
TP1, TP2, TP3, TP4: TEST; TestPoint_Pad_D1.0mm
U1: AXP209; qfn48_6x6mm_Pitch0.4mm; ManufacturerPartNumber AXP209; LCSC Part # C2997895

Connections:
BAT: C7.1, C8.2, J2.1, R7.2, U1.38 (BAT), U1.39 (BAT), U1.42 (BATSENCE)
DCDC2: C10.1, J1.7, L2.2, U1.10 (DCDC2)
DCDC3: C13.1, J1.6, L3.2, R2.1, SW2.2, U1.17 (DCDC3)
EXTEN: R8.2, TP2.1, U1.20 (EXTEN)
GND: C1.2, C2.2, C3.2, C4.2, C5.2, C6.1, C8.1, C9.1, C10.2, C11.2, C12.2, C13.2, C14.2, C15.2, J1.1, J2.4, R1.1, R3.1, R5.1, R8.1, U1.9 (PGIND2), U1.16 (PGND3), U1.22 (AGND), U1.37 (TS), U1.46 (PGND1), U1.49 (EP)
GPIO2: J1.2, U1.5 (GPIO2)
IPSOUT: C1.1, C3.1, C6.2, C11.1, C12.1, J1.8, SW1.2, U1.7 (VIN2), U1.13 (LDO24IN), U1.14 (VIN3), U1.21 (APS), U1.29 (DC3SET), U1.34 (IPSOUT), U1.35 (ISPOUT), U1.44 (VIN1)
IRQ: R2.2, U1.48 (IRQ/WAKEUP)
LDO1: J1.5, U1.28 (LDO1)
LDO2: C14.1, J1.4, U1.12 (LDO2)
LDO3: C15.1, J1.3, U1.41 (LDO3)
N_OE: R3.2, TP4.1, U1.4 (N_OE)
unnamed: R5.2, TP1.1, U1.23 (BIAS)
unnamed: C7.2, C9.2, L1.2, R7.1, U1.43 (CHSENCE)
unnamed: SW1.1, SW2.1, U1.40 (LDO3IN)
unnamed: L1.1, U1.45 (LX1)
unnamed: L2.1, U1.8 (LX2)
unnamed: L3.1, U1.15 (LX3)
unnamed: R1.2, TP3.1, U1.6 (N_VBUSEN)
unnamed: C5.1, U1.24 (VREF)
PWRON: J2.3, U1.47 (PWRON)
VBUS: C4.1, J2.2, U1.31 (VBUS)
VINT: C2.1, U1.26 (VINT), U1.27 (LDO1SET)

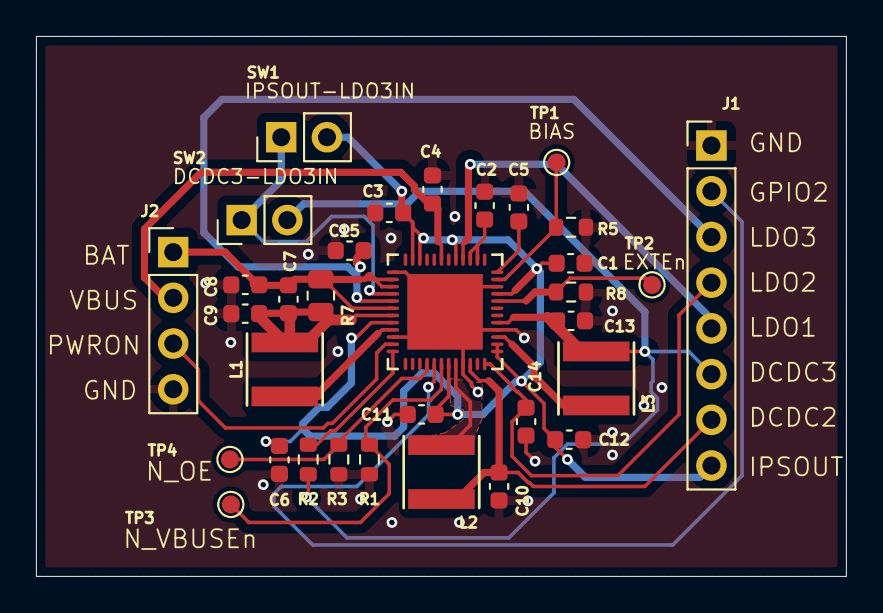
[picture p66: board TestAXP209.kicad_pcb from above]

Board: 2 copper layers, 45.0 x 30.0 mm, 33 parts (0 on the bottom side), 23 nets.
