henla464/WiRocKiCad/KiCad7/USBConnectorTester/USBConnectorTester.kicad_pcb

## KiCad design KiCad7/USBConnectorTester/USBConnectorTester.kicad_pcb (2024-06-18)

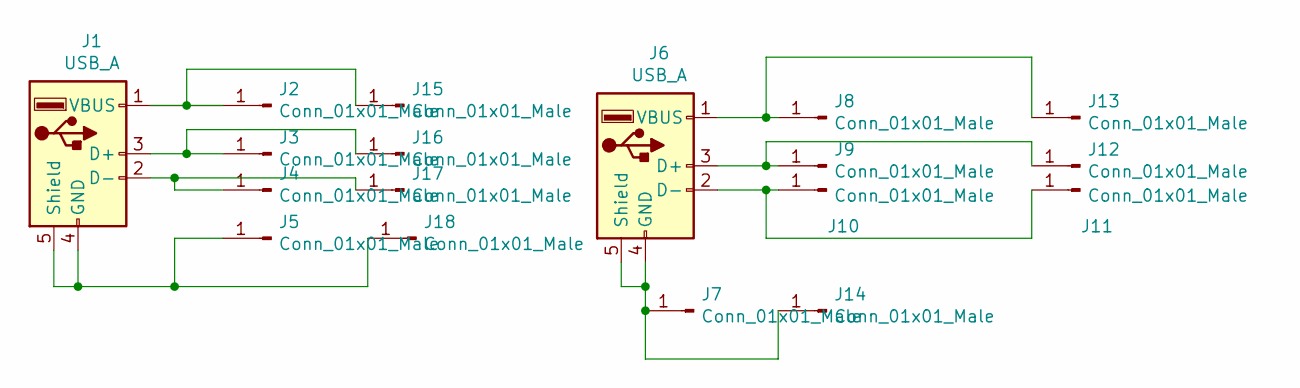
[picture p67: schematic USBConnectorTester.kicad_sch]

Parts:
J1: USB_A; USBA-Male-through-hole-C112454
J2, J3, J4, J5, J7, J8, J9, J10: Conn_01x01_Male; PinHeader_1x01_P2.54mm_Vertical
J6: USB_A; USB_A_CONNFLY_DS1095-WNR0
J11, J12, J13, J14, J15, J16, J17, J18: Conn_01x01_Male; RoundPadThroughHole

Connections:
unnamed: J1.3 (D+), J3.1, J16.1
unnamed: J1.2 (D-), J4.1, J17.1
unnamed: J1.4 (GND), J1.5 (Shield), J5.1, J18.1
unnamed: J1.1 (VBUS), J2.1, J15.1
unnamed: J6.2 (D-), J10.1, J11.1
unnamed: J6.3 (D+), J9.1, J12.1
unnamed: J6.1 (VBUS), J8.1, J13.1
unnamed: J6.4 (GND), J6.5 (Shield), J7.1, J14.1

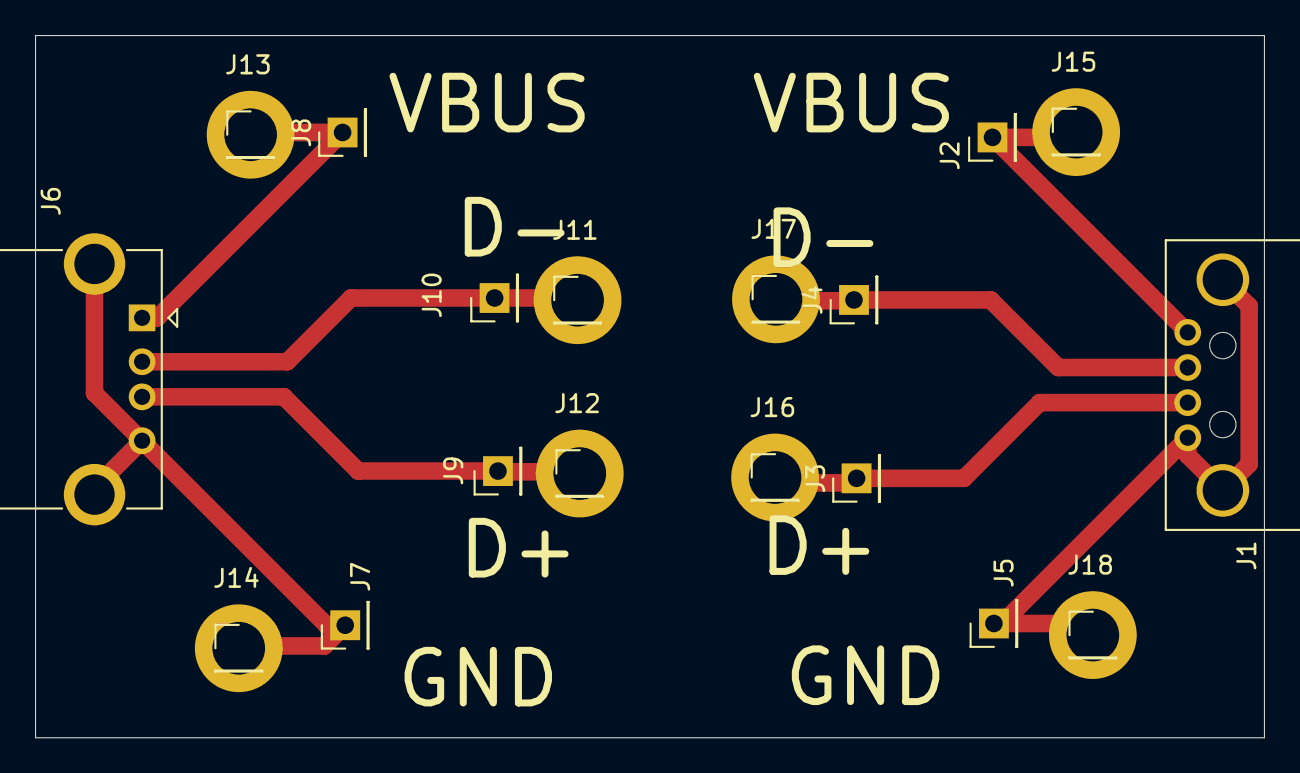
[picture p68: board USBConnectorTester.kicad_pcb from above]

Board: 2 copper layers, 70.0 x 40.0 mm, 18 parts (0 on the bottom side), 8 nets.
