henla464/WiRocKiCad/KiCad7/USBRadio/USBRadio.kicad_pcb

## KiCad design KiCad7/USBRadio/USBRadio.kicad_pcb (2024-06-18)

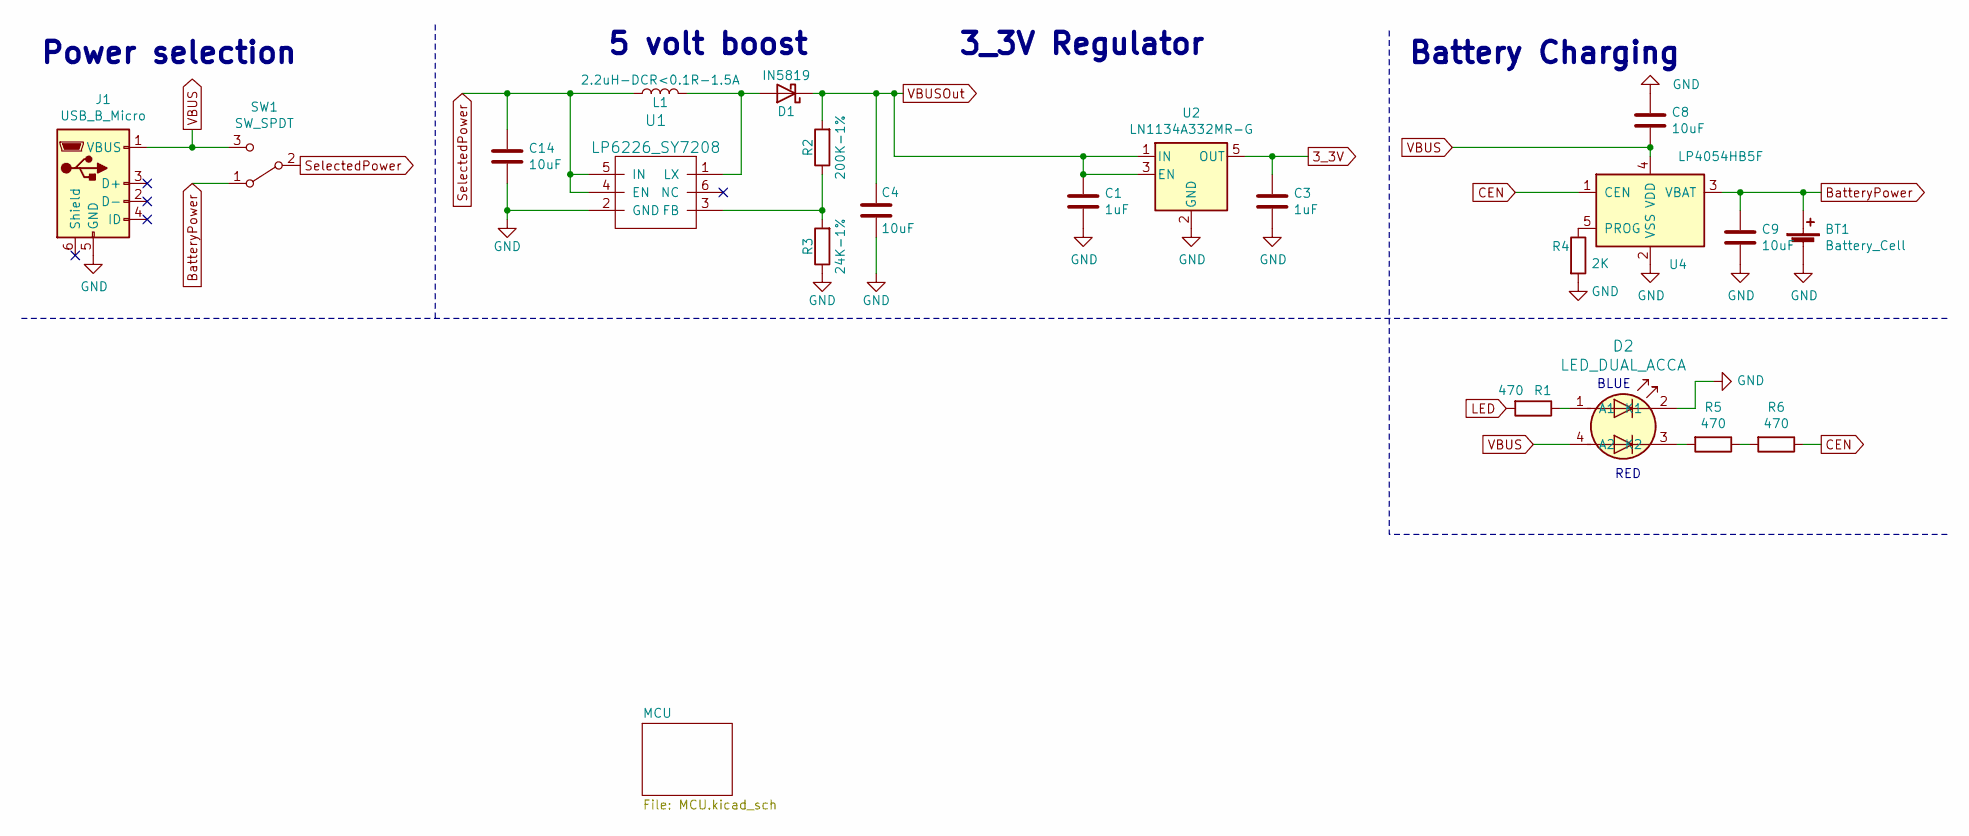
[picture p69: schematic USBRadio.kicad_sch]

Parts:
BT1: Battery_Cell; JST_2.56
C1, C3: 1uF; C_0603_1608Metric_Pad1.08x0.95mm_HandSolder; ManufacturerPartNumber CL10A105KB8NNNC; LCSC Part # C15849
C4, C8, C9, C14: 10uF; C_0603_1608Metric_Pad1.08x0.95mm_HandSolder; ManufacturerPartNumber CL10A106KP8NNNC; LCSC Part # C19702
D1: IN5819; D_SOD-123; ManufacturerPartNumber B5817W; LCSC Part # C8597
D2: LED_DUAL_ACCA; LED_Dual_1.7_1.6; ManufacturerPartNumber HL-PCB-1617S9FH203BC; LCSC Part # C513363
J1: USB_B_Micro; USB_Micro-B_Horizontal; ManufacturerPartNumber U254-051T-4BH83-F1S; LCSC Part # C397452
L1: 2.2uH-DCR<0.1R-1.5A; Inductor_SLW4018; ManufacturerPartNumber SLW4018S2R2MST; LCSC Part # C206341
R1, R5, R6: 470; R_0805_2012Metric_Pad1.20x1.40mm_HandSolder; ManufacturerPartNumber 0805W8F4700T5E; LCSC Part # C17710
R2: 200K-1%; C_0603_1608Metric_Pad1.08x0.95mm_HandSolder; ManufacturerPartNumber 0603WAF2003T5E; LCSC Part # C25811
R3: 24K-1%; C_0603_1608Metric_Pad1.08x0.95mm_HandSolder; ManufacturerPartNumber 0603WAF2402T5E; LCSC Part # C23352
R4: 2K; R_0805_2012Metric_Pad1.20x1.40mm_HandSolder; ManufacturerPartNumber 0805W8F2001T5E; LCSC Part # C17604
SW1: SW_SPDT; SW_SPDT_PCM12; ManufacturerPartNumber SK-3296S-01-L3; LCSC Part # C319019
U1: LP6226_SY7208; TSOT-23-6_HandSoldering; ManufacturerPartNumber SY7208ABC; LCSC Part # C80514
U2: LN1134A332MR-G; SOT-23-5; ManufacturerPartNumber LN1134A332MR-G; LCSC Part # C141419
U4: LP4054HB5F; SOT-23-5; ManufacturerPartNumber LP4054HB5F; LCSC Part # C517187

Connections:
3_3V: C3.1, U2.5 (OUT); also elsewhere on the board
BatteryPower: BT1.1 (+), C9.1, SW1.1 (A), U4.3 (VBAT)
CEN: R6.1, U4.1 (CEN)
GND: BT1.2 (-), C1.2, C3.2, C4.2, C8.1, C9.2, C14.2, D2.2 (K1), J1.5 (GND), R3.1, R4.2, U1.2 (GND), U2.2 (GND), U4.2 (VSS); also elsewhere on the board
LED: R1.2; also elsewhere on the board
unnamed: D1.2 (A), L1.2, U1.1 (LX)
unnamed: D2.1 (A1), R1.1
unnamed: D2.3 (K2), R5.2
unnamed: R5.1, R6.2
unnamed: R2.1, R3.2, U1.3 (FB)
unnamed: R4.1, U4.5 (PROG)
SelectedPower: C14.1, L1.1, SW1.2 (B), U1.4 (EN), U1.5 (IN)
VBUS: C8.2, D2.4 (A2), J1.1 (VBUS), SW1.3 (C), U4.4 (VDD)
VBUSOut: C1.1, C4.1, D1.1 (K), R2.2, U2.1 (IN), U2.3 (EN); also elsewhere on the board

Notes on the sheet:
RED
Power selection
BLUE
5 volt boost
3_3V Regulator
Battery Charging

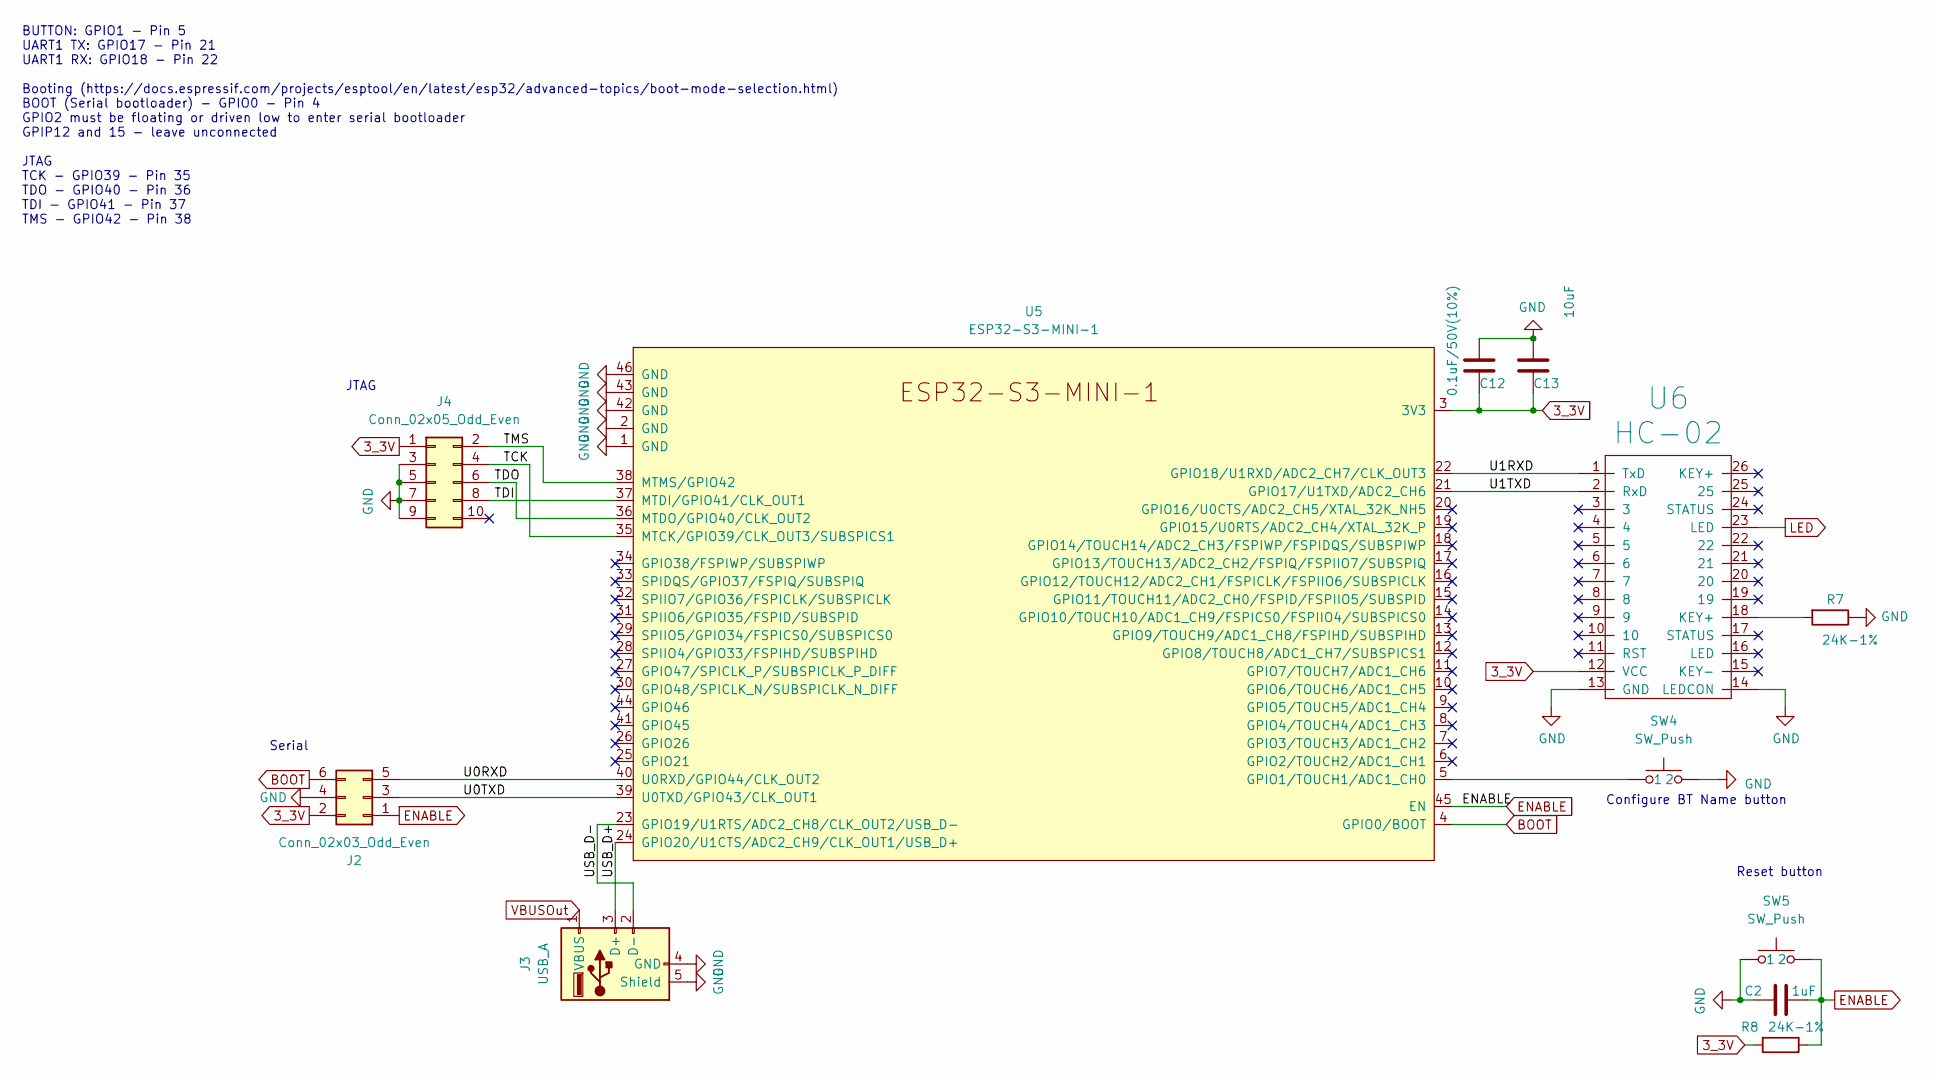
[picture p70: schematic MCU.kicad_sch]

Parts:
C2: 1uF; C_0603_1608Metric_Pad1.08x0.95mm_HandSolder; ManufacturerPartNumber CL10A105KB8NNNC; LCSC Part # C15849
C12: 0.1uF/50V(10%); C_0805_2012Metric_Pad1.18x1.45mm_HandSolder; ManufacturerPartNumber CC0805KRX7R9BB104; LCSC Part # C49678
C13: 10uF; C_0603_1608Metric_Pad1.08x0.95mm_HandSolder; ManufacturerPartNumber CL10A106KP8NNNC; LCSC Part # C19702
J2: Conn_02x03_Odd_Even; IDC-Header_2x03_P1.27mm_Vertical_SMD
J3: USB_A; USB_A_CONNFLY_DS1095-WNR0
J4: Conn_02x05_Odd_Even; IDC-Header_2x05_P1.27mm_Vertical_SMD
R7, R8: 24K-1%; C_0603_1608Metric_Pad1.08x0.95mm_HandSolder; ManufacturerPartNumber 0603WAF2402T5E; LCSC Part # C23352
SW4, SW5: SW_Push; SW_SPST_TL3342; ManufacturerPartNumber TS-1187A-B-A-B; LCSC Part # C318884
U5: ESP32-S3-MINI-1
U6: HC-02

Connections:
3_3V: C12.1, C13.1, J2.2, J4.1, R8.2, U5.3 (3V3), U6.12 (VCC); also elsewhere on the board
/MCU/TCK: J4.4, U5.35 (MTCK/GPIO39/CLK_OUT3/SUBSPICS1)
/MCU/TDI: J4.8, U5.37 (MTDI/GPIO41/CLK_OUT1)
/MCU/TDO: J4.6, U5.36 (MTDO/GPIO40/CLK_OUT2)
/MCU/TMS: J4.2, U5.38 (MTMS/GPIO42)
/MCU/U0RXD: J2.5, U5.40 (U0RXD/GPIO44/CLK_OUT2)
/MCU/U0TXD: J2.3, U5.39 (U0TXD/GPIO43/CLK_OUT1)
/MCU/U1RXD: U5.22 (GPIO18/U1RXD/ADC2_CH7/CLK_OUT3), U6.1 (TxD)
/MCU/U1TXD: U5.21 (GPIO17/U1TXD/ADC2_CH6), U6.2 (RxD)
/MCU/USB_D+: J3.3 (D+), U5.24 (GPIO20/U1CTS/ADC2_CH9/CLK_OUT1/USB_D+)
/MCU/USB_D-: J3.2 (D-), U5.23 (GPIO19/U1RTS/ADC2_CH8/CLK_OUT2/USB_D-)
BOOT: J2.6, U5.4 (GPIO0/BOOT)
ENABLE: C2.2, J2.1, R8.1, SW5.2, U5.45 (EN)
GND: C2.1, C12.2, C13.2, J2.4, J3.4 (GND), J3.5 (Shield), J4.3, J4.5, J4.7, J4.9, R7.1, SW4.2, SW5.1, U5.1 (GND), U5.2 (GND), U5.42 (GND), U5.43 (GND), U5.46 (GND), U6.13 (GND), U6.14 (LEDCON); also elsewhere on the board
LED: U6.23 (LED); also elsewhere on the board
unnamed: R7.2, U6.18 (KEY+)
unnamed: SW4.1, U5.5 (GPIO1/TOUCH1/ADC1_CH0)
VBUSOut: J3.1 (VBUS); also elsewhere on the board

Notes on the sheet:
Reset button
JTAG
BUTTON: GPIO1 - Pin 5 UART1 TX: GPIO17 - Pin 21 UART1 RX: GPIO18 - Pin 22 Booting (https://docs.espressif.com/projects/esptool/en/latest/esp32/advanced-topics/boot-mode-selection.html) BOOT (Serial bootloader) - GPIO0 - Pin 4 GPIO2 must be floating or driven low to enter serial bootloader GPIP12 an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
Serial
Configure BT Name button

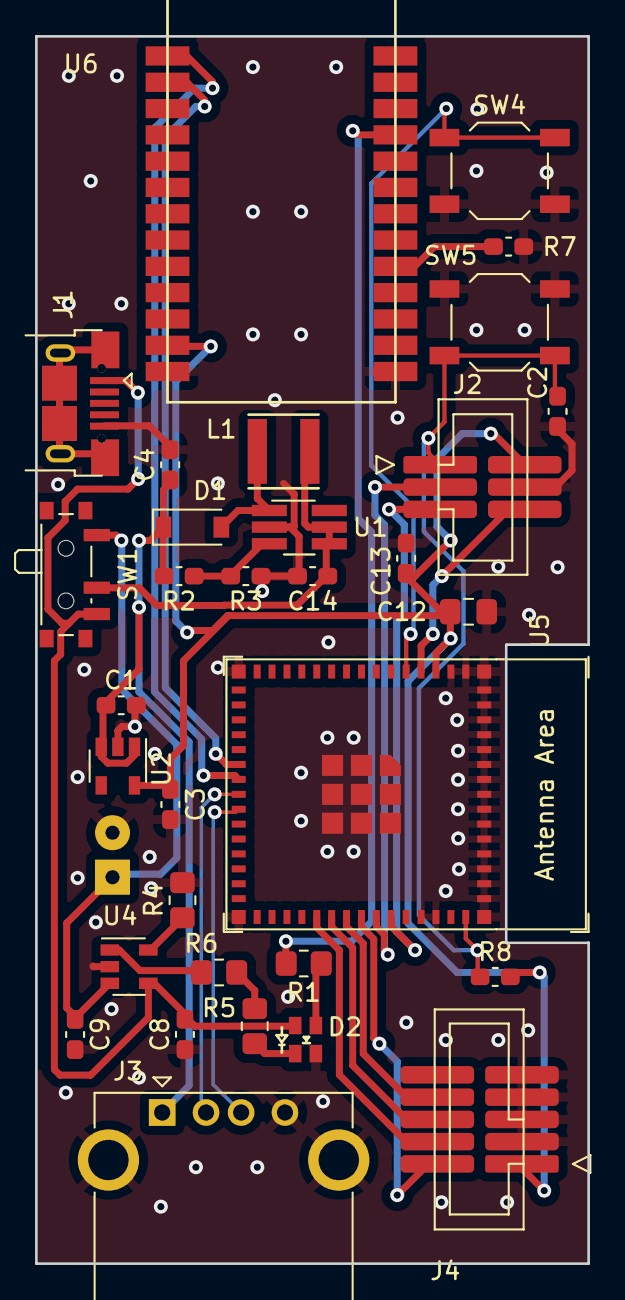
[picture p71: board USBRadio.kicad_pcb from above]

Board: 2 copper layers, 31.5 x 70.0 mm, 33 parts (1 on the bottom side), 28 nets.
