henla464/WiRocKiCad/KiCad7/SerialBlocker/SerialBlocker.kicad_pcb

## KiCad design KiCad7/SerialBlocker/SerialBlocker.kicad_pcb (2024-06-18)

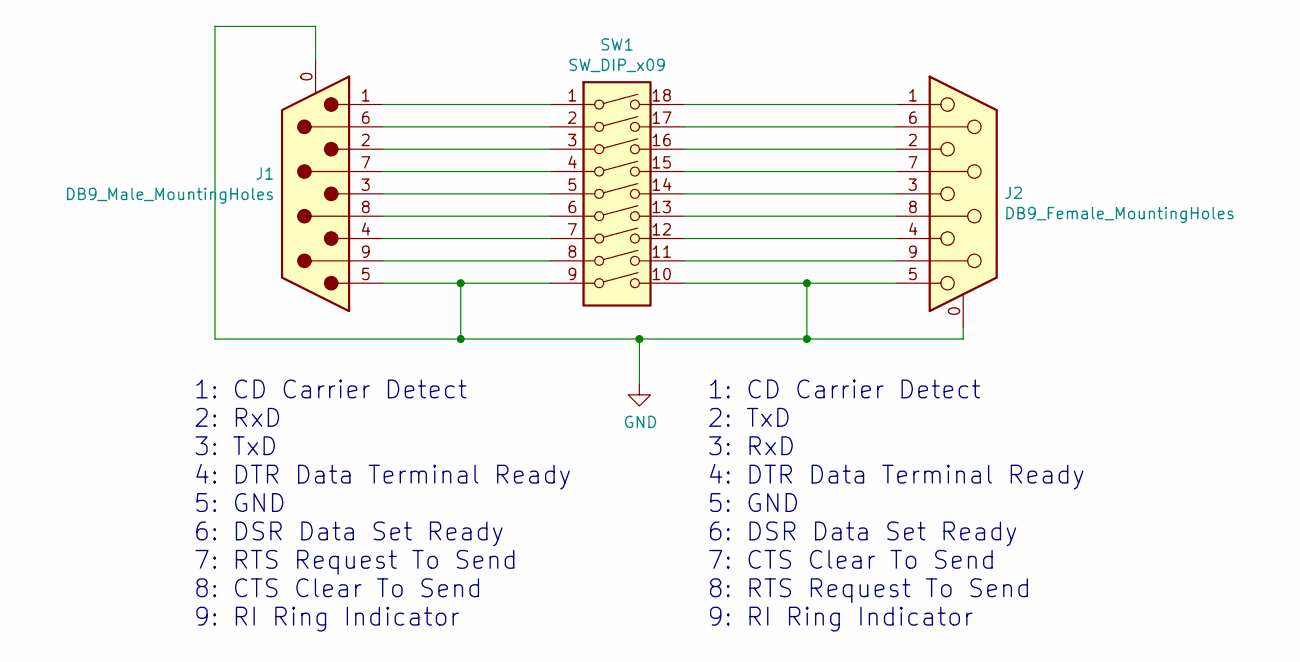
[picture p72: schematic SerialBlocker.kicad_sch]

Parts:
J1: DB9_Male_MountingHoles; DSUB-9_Male_Horizontal_P2.77x2.84mm_Edge_Housed_MountingHol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
J2: DB9_Female_MountingHoles; DSUB-9_Female_Horizontal_P2.77x2.84mm_Edge_offset6.96mm_cen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
SW1: SW_DIP_x09; PinHeader_Serial_Blocker

Connections:
GND: J1.0 (PAD), J1.5, J2.0 (PAD), J2.5, SW1.9, SW1.10
unnamed: J1.1, SW1.1
unnamed: J1.2, SW1.3
unnamed: J1.3, SW1.5
unnamed: J1.4, SW1.7
unnamed: J1.6, SW1.2
unnamed: J1.7, SW1.4
unnamed: J1.8, SW1.6
unnamed: J1.9, SW1.8
unnamed: J2.1, SW1.18
unnamed: J2.2, SW1.16
unnamed: J2.3, SW1.14
unnamed: J2.4, SW1.12
unnamed: J2.6, SW1.17
unnamed: J2.7, SW1.15
unnamed: J2.8, SW1.13
unnamed: J2.9, SW1.11

Notes on the sheet:
1: CD Carrier Detect 2: RxD 3: TxD 4: DTR Data Terminal Ready 5: GND 6: DSR Data Set Ready 7: RTS Request To Send 8: CTS Clear To Send 9: RI Ring Indicator
1: CD Carrier Detect 2: TxD 3: RxD 4: DTR Data Terminal Ready 5: GND 6: DSR Data Set Ready 7: CTS Clear To Send 8: RTS Request To Send 9: RI Ring Indicator

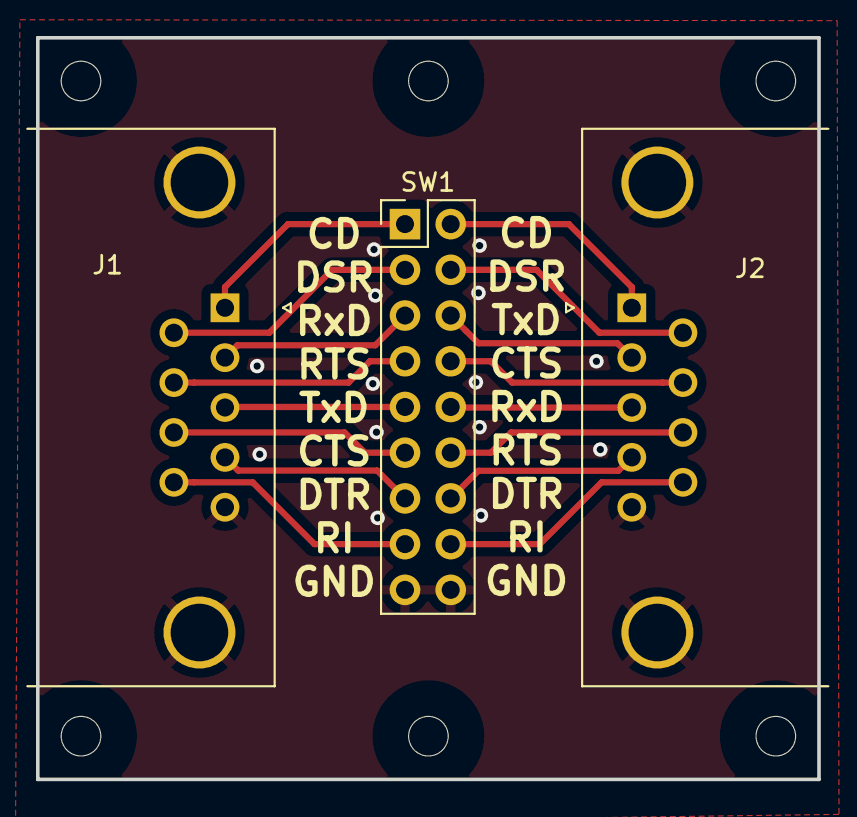
[picture p73: board SerialBlocker.kicad_pcb from above]

Board: 2 copper layers, 43.4 x 41.2 mm, 3 parts (0 on the bottom side), 17 nets.
