henla464/WiRocKiCad/KiCad7/TestBoost/TestBoost.kicad_pcb

## KiCad design KiCad7/TestBoost/TestBoost.kicad_pcb (2023-11-12)

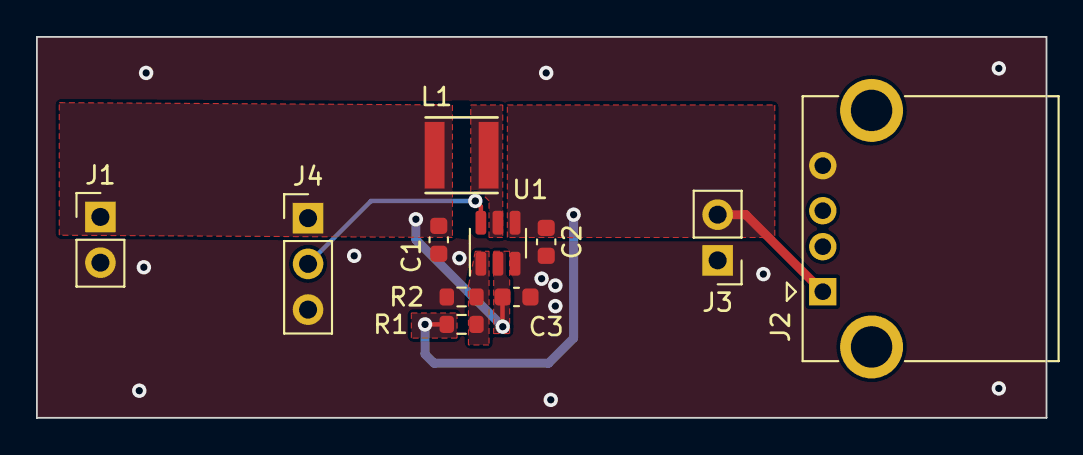
[picture p74: board TestBoost.kicad_pcb from above]

Board: 2 copper layers, 56.1 x 21.2 mm, 11 parts (0 on the bottom side), 6 nets.

Parts:
C1, C2: 22uF; C_0603_1608Metric
C3: C; C_0603_1608Metric
J1, J3: Conn_01x02_Male; PinHeader_1x02_P2.54mm_Vertical
J2: USB_A; USB_A_CONNFLY_DS1095-WNR0
J4: Conn_01x03_Male; PinHeader_1x03_P2.54mm_Vertical
L1: 1.5uH; Inductor_SLW4018
R1: 500kOhm; R_0603_1608Metric
R2: 150kOhm; R_0603_1608Metric
U1: TSOT-23-6

Connections:
/Vin: C1.1, C3.1, J1.1, J4.1, L1.1, U1.2 (IN)
/Vout: C2.1, J2.1 (VBUS), J3.2, R1.1, U1.4 (OUT)
GND: C1.2, C2.2, C3.2, J1.2, J2.4 (GND), J3.1, J4.3, R2.2, U1.3 (GND)
unnamed: J4.2, U1.6 (EN)
unnamed: R1.2, R2.1, U1.1 (FB)
unnamed: L1.2, U1.5 (LX)
