henla464/WiRocKiCad/KiCad6/Hardware_NanoPi_v3/WiRoc_NanoPi_v1.kicad_pcb

## KiCad design KiCad6/Hardware_NanoPi_v3/WiRoc_NanoPi_v1.kicad_pcb (2023-11-12, an earlier design)

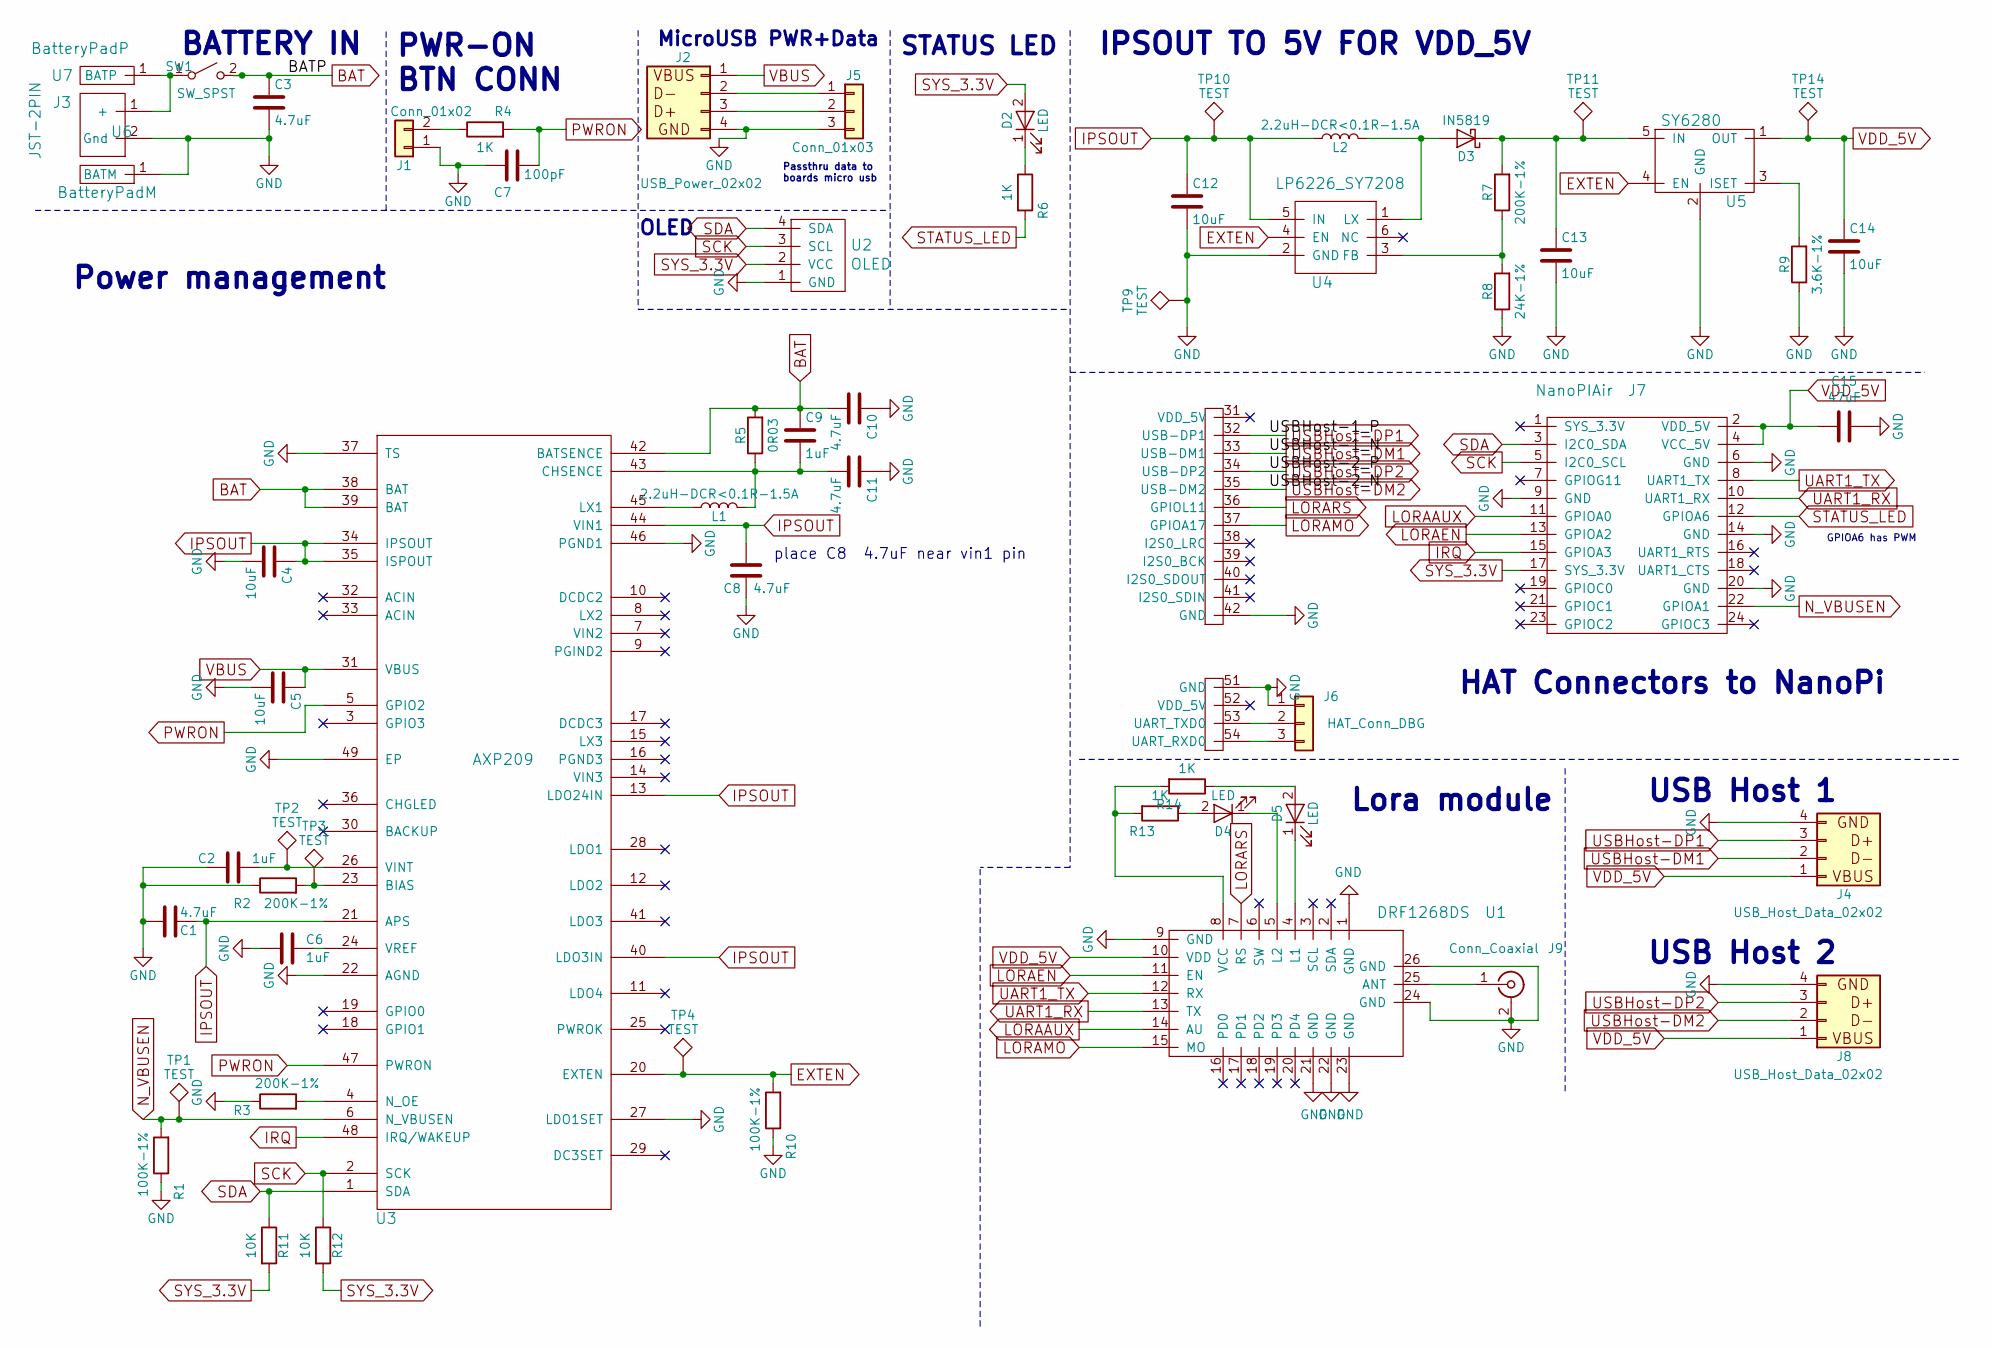
[picture p75: schematic WiRoc_NanoPi_v1.sch, WiRoc NanoPI Hat]

Parts:
C1, C3, C8, C10, C11: 4.7uF; C_0603_1608Metric; ManufacturerPartNumber 0603B475K160NT; LCSCPartNumber C19666
C2, C6, C9: 1uF; C_0603_1608Metric; ManufacturerPartNumber 0603X105K500NT; LCSCPartNumber C15849
C4, C5, C12, C13, C14: 10uF; C_0603_1608Metric; ManufacturerPartNumber CL10A106KP8NNNC; LCSCPartNumber C19702
C7: 100pF; C_0603_1608Metric; ManufacturerPartNumber 0603CG101J500NT; LCSCPartNumber C14858
C15: 47uF; C_1210_3225Metric; ManufacturerPartNumber GRM32ER61C476KE15L; LCSCPartNumber C77101
D2, D4, D5: LED; D_0603_1608Metric; ManufacturerPartNumber D-R060306L3-KS2; LCSCPartNumber C2286
D3: IN5819; D_SOD-123; ManufacturerPartNumber 1N5819HW-7-F; LCSCPartNumber C8597
J1: Conn_01x02; Pin_Header_Straight_1x02_Pitch2.54mm; LCSCPartNumber N/A
J2: USB_Power_02x02; USBConnPads4; LCSCPartNumber N/A
J3: JST-2PIN; JST_2.56; ManufacturerPartNumber XH-2A; LCSCPartNumber N/A
J4: USB_Host_Data_02x02; USBConnPads2; LCSCPartNumber N/A
J5: Conn_01x03; Pin_Header_Straight_1x03_Pitch2.54mm; LCSCPartNumber N/A
J6: HAT_Conn_DBG; Pin_Header_Straight_1x03_Pitch2.54mm; LCSCPartNumber N/A
J7: NanoPIAir; NanoPiNeoAirAllPins; LCSCPartNumber N/A
J8: USB_Host_Data_02x02; USBConnPads3; LCSCPartNumber N/A
J9: Conn_Coaxial; U.FL_Hirose_U.FL-R-SMT-1_Vertical; ManufacturerPartNumber U.FL-R-SMT-1(80); LCSCPartNumber C88374
L1, L2: 2.2uH-DCR<0.1R-1.5A; Inductor_SLW4018; ManufacturerPartNumber SLW4018S2R2MST; LCSCPartNumber C206341
R1, R10: 100K-1%; R_0603_1608Metric; ManufacturerPartNumber 0603WAF1003T5E; LCSCPartNumber C25803
R2, R3, R7: 200K-1%; R_0603_1608Metric; ManufacturerPartNumber 0603WAF2003T5E; LCSCPartNumber C25811
R4, R6, R13, R14: 1K; R_0603_1608Metric; ManufacturerPartNumber RTT031001FTP; LCSCPartNumber C21190
R5: 0R03; R_0805_2012Metric; ManufacturerPartNumber RTT05R030FTP; LCSCPartNumber C247605
R8: 24K-1%; R_0603_1608Metric; ManufacturerPartNumber 0603WAF2402T5E; LCSCPartNumber C23352
R9: 3.6K-1%; R_0603_1608Metric; ManufacturerPartNumber CR0603FA3601G; LCSCPartNumber C22980
R11, R12: 10K; R_0603_1608Metric; ManufacturerPartNumber WR06X103JTL; LCSCPartNumber C25804
SW1: SW_SPST; PinHeader_1x02_P2.54mm_Vertical
TP1, TP2, TP3, TP4, TP9, TP10, TP11, TP14: TEST; Measurement_Point_Round-SMD-Pad_Small; LCSCPartNumber N/A
U1: DRF1268DS; LCSCPartNumber N/A
U2: OLED; CONN_OLED_TWI-Socket_Strip_Straight_1x04_Pitch2.54mm; LCSCPartNumber N/A
U3: AXP209; qfn48_6x6mm_Pitch0.4mm; ManufacturerPartNumber AXP209; LCSCPartNumber C80525
U4: LP6226_SY7208; SOT-23-6; ManufacturerPartNumber LP6226B6F; LCSCPartNumber C80514
U5: SY6280; SOT-23-5; ManufacturerPartNumber SY6280AAC; LCSCPartNumber C55136
U6: BatteryPadM; BatteryPad; LCSCPartNumber N/A
U7: BatteryPadP; BatteryPad; LCSCPartNumber N/A

Connections:
BAT: C3.1, C9.1, C10.2, R5.2, SW1.2 (B), U3.38 (BAT), U3.39 (BAT), U3.42 (BATSENCE)
EXTEN: R10.2, TP4.1, U3.20 (EXTEN), U4.4 (EN), U5.4 (EN)
GND: C1.2, C2.2, C3.2, C4.2, C5.2, C6.2, C7.1, C8.1, C10.1, C11.1, C12.2, C13.2, C14.2, C15.1, J1.1, J2.4, J3.2 (Gnd), J4.4, J5.3, J6.1, J7.6 (GND), J7.9 (GND), J7.14 (GND), J7.20 (GND), J7.42 (GND), J7.51 (GND), J8.4, J9.2 (Ext), R1.1, R2.1, R3.1, R8.1, R9.1, R10.1, TP9.1, U1.1 (GND), U1.9 (GND), U1.21 (GND), U1.22 (GND), U1.23 (GND), U1.24 (GND), U1.26 (GND), U2.1 (GND), U3.22 (AGND), U3.27 (LDO1SET), U3.37 (TS), U3.46 (PGND1), U3.49 (EP), U4.2 (GND), U5.2 (GND), U6.1
IPSOUT: C1.1, C4.1, C8.2, C12.1, L2.1, TP10.1, U3.13 (LDO24IN), U3.21 (APS), U3.34 (IPSOUT), U3.35 (ISPOUT), U3.40 (LDO3IN), U3.44 (VIN1), U4.5 (IN)
IRQ: J7.15 (GPIOA3), U3.48 (IRQ/WAKEUP)
LORAAUX: J7.11 (GPIOA0), U1.14 (AU)
LORAEN: J7.13 (GPIOA2), U1.11 (EN)
LORAMO: J7.37 (GPIOA17), U1.15 (MO)
LORARS: J7.36 (GPIOL11), U1.7 (RS)
N_VBUSEN: J7.22 (GPIOA1), R1.2, TP1.1, U3.6 (N_VBUSEN)
unnamed: C2.1, TP2.1, U3.26 (VINT)
unnamed: C6.1, U3.24 (VREF)
unnamed: C9.2, C11.2, L1.2, R5.1, U3.43 (CHSENCE)
unnamed: C13.1, D3.1 (K), R7.2, TP11.1, U5.5 (IN)
unnamed: D2.1 (K), R6.1
unnamed: D3.2 (A), L2.2, U4.1 (LX)
unnamed: D4.1 (K), U1.5 (L2)
unnamed: D4.2 (A), R13.1
unnamed: D5.1 (K), U1.4 (L1)
unnamed: D5.2 (A), R14.1
unnamed: J1.2, R4.1
unnamed: J2.2, J5.1
unnamed: J2.3, J5.2
unnamed: J3.1 (+), SW1.1 (A), U7.1
unnamed: J6.2, J7.53 (UART_TXD0)
unnamed: J6.3, J7.54 (UART_RXD0)
unnamed: J9.1 (In), U1.25 (ANT)
unnamed: L1.1, U3.45 (LX1)
unnamed: R2.2, TP3.1, U3.23 (BIAS)
unnamed: R3.2, U3.4 (N_OE)
unnamed: R7.1, R8.2, U4.3 (FB)
unnamed: R9.2, U5.3 (ISET)
unnamed: R13.2, R14.2, U1.8 (VCC)
PWRON: C7.2, R4.2, U3.5 (GPIO2), U3.47 (PWRON)
SCK: J7.5 (I2C0_SCL), R12.1, U2.3 (SCL), U3.2 (SCK)
SDA: J7.3 (I2C0_SDA), R11.1, U2.4 (SDA), U3.1 (SDA)
STATUS_LED: J7.12 (GPIOA6), R6.2
SYS_3.3V: D2.2 (A), J7.17 (SYS_3.3V), R11.2, R12.2, U2.2 (VCC)
UART1_RX: J7.10 (UART1_RX), U1.13 (TX)
UART1_TX: J7.8 (UART1_TX), U1.12 (RX)
USBHost-DM1: J4.2, J7.33 (USB-DM1)
USBHost-DM2: J7.35 (USB-DM2), J8.2
USBHost-DP1: J4.3, J7.32 (USB-DP1)
USBHost-DP2: J7.34 (USB-DP2), J8.3
VBUS: C5.1, J2.1, U3.31 (VBUS)
VDD_5V: C14.1, C15.2, J4.1, J7.2 (VDD_5V), J7.4 (VCC_5V), J8.1, TP14.1, U1.10 (VDD), U5.1 (OUT)

Notes on the sheet:
IPSOUT TO 5V FOR VDD_5V
BATTERY IN
PWR-ON BTN CONN
Passthru data to boards micro usb
USB Host 1
STATUS LED
HAT Connectors to NanoPi
Lora module
Power management
MicroUSB PWR+Data
place C8 4.7uF near vin1 pin
GPIOA6 has PWM
OLED
USB Host 2

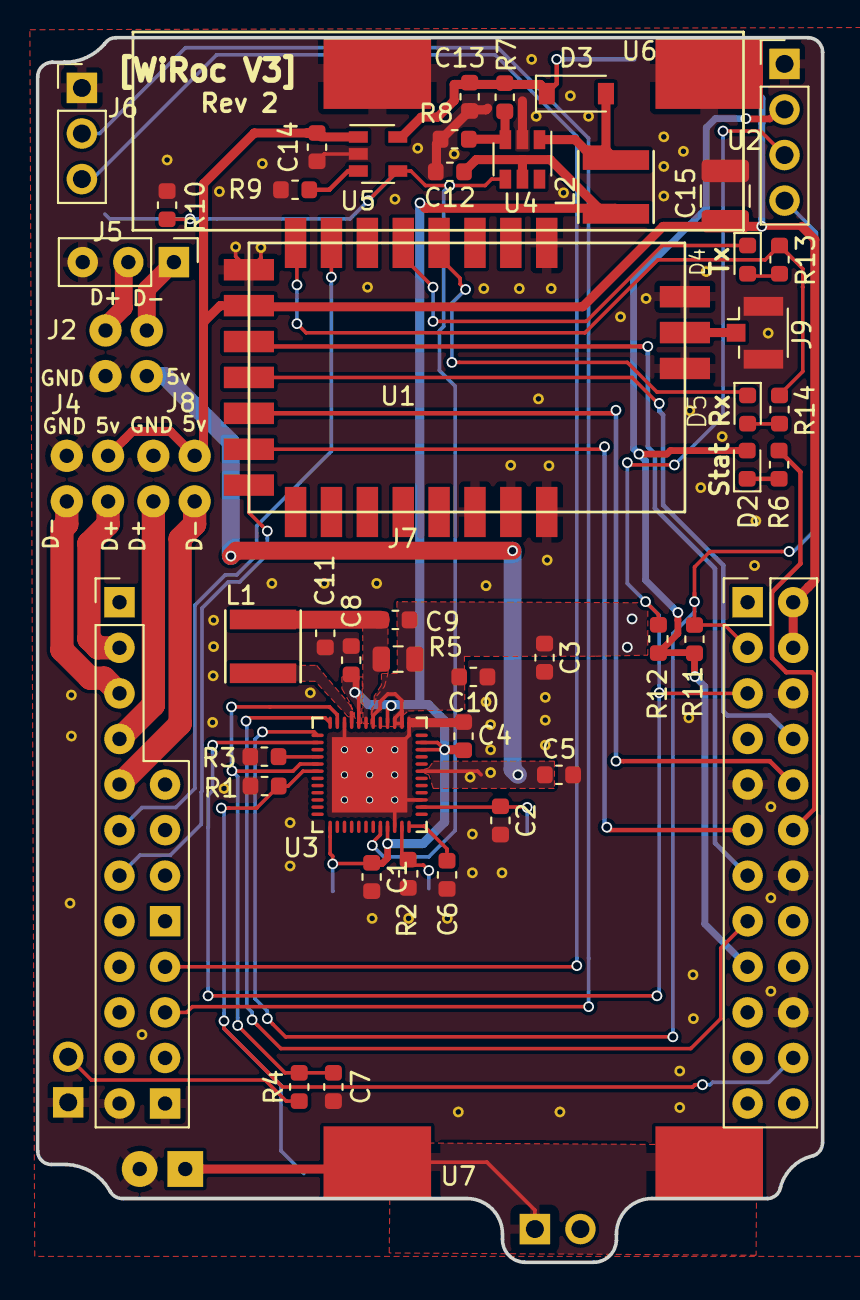
[picture p76: board WiRoc_NanoPi_v1.kicad_pcb from above]

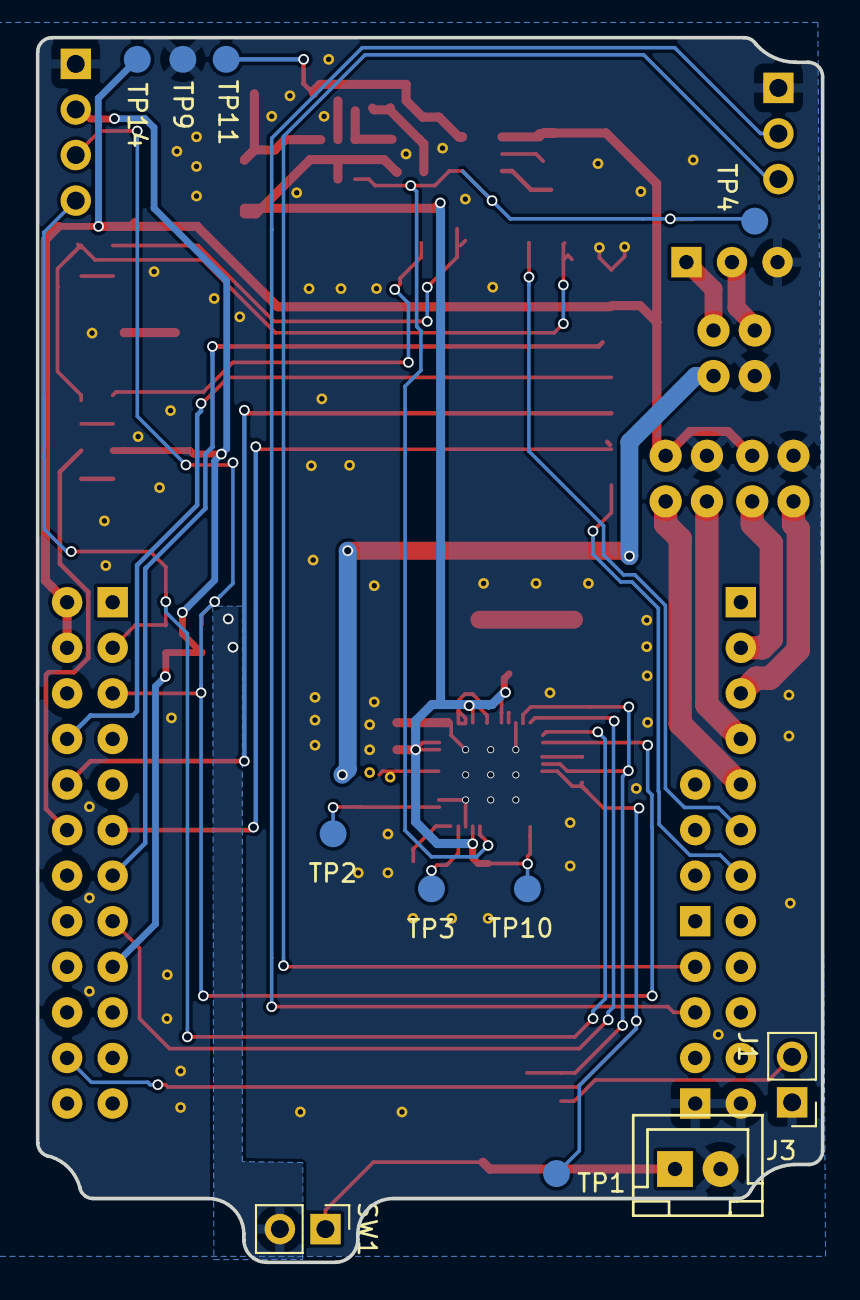
[picture p77: board WiRoc_NanoPi_v1.kicad_pcb from below]

Board: 2 copper layers, 43.8 x 68.3 mm, 60 parts (5 on the bottom side), 46 nets.
