henla464/WiRocKiCad/KiCad7/BTSerialClient/BTSerialClient.kicad_pcb

## KiCad design KiCad7/BTSerialClient/BTSerialClient.kicad_pcb (2021-12-25)

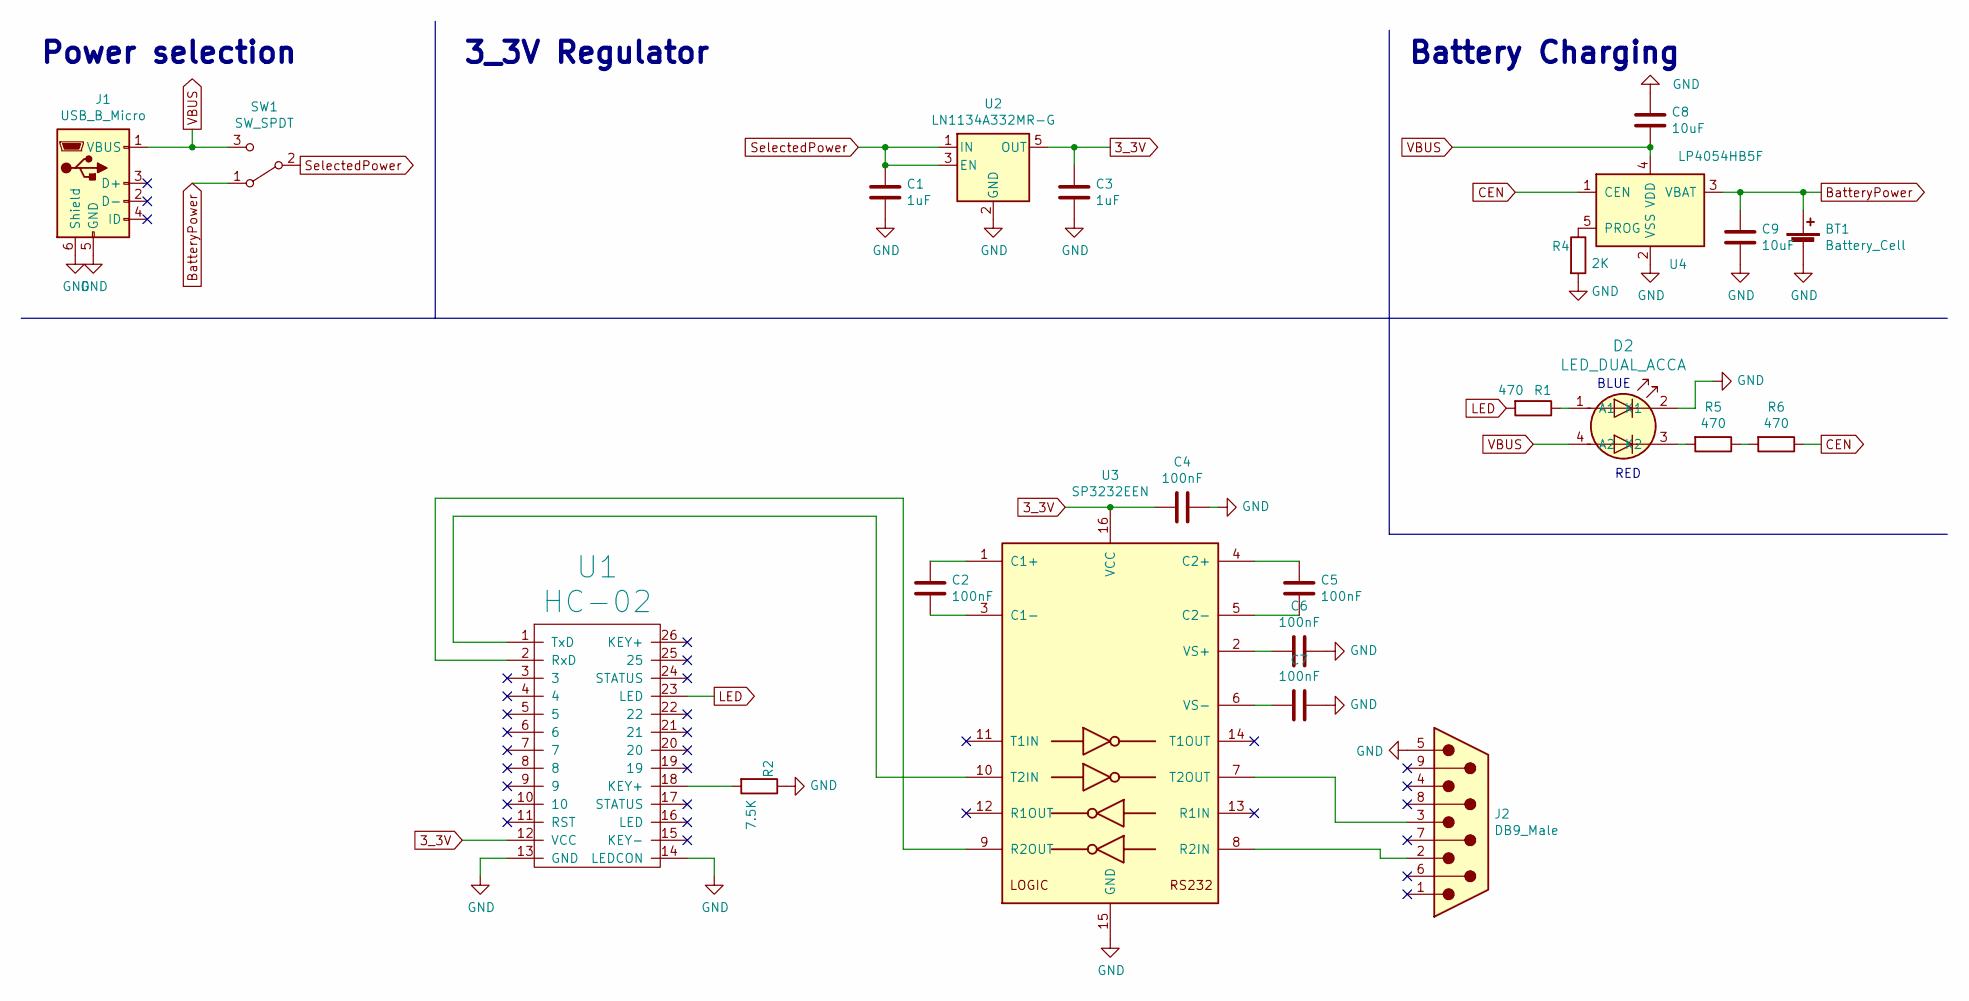
[picture p78: schematic BTSerialClient.kicad_sch]

Parts:
BT1: Battery_Cell; JST_2.56
C1, C3: 1uF; C_0805_2012Metric_Pad1.15x1.40mm_HandSolder; ManufacturerPartNumber CL21B105KBFNNNE; LCSCPartNumber C28323
C2, C4, C5, C6, C7: 100nF; C_0805_2012Metric_Pad1.15x1.40mm_HandSolder; ManufacturerPartNumber CC0805KRX7R9BB104; LCSCPartNumber C49678
C8, C9: 10uF; C_0805_2012Metric_Pad1.15x1.40mm_HandSolder; ManufacturerPartNumber CL21A106KOQNNNE; LCSCPartNumber C1713
D2: LED_DUAL_ACCA; LED_Dual_1.7_1.6; ManufacturerPartNumber HL-PCB-1617S9FH203BC; LCSCPartNumber C513363
J1: USB_B_Micro; USB_Micro-B_Horizontal; ManufacturerPartNumber U254-051T-4BH83-F1S; LCSCPartNumber C397452
J2: DB9_Male; DSUB-9_Male_EdgeMount_P2.77mm; ManufacturerPartNumber DS1033-09MUNSiSS; LCSCPartNumber C75746
R1, R5, R6: 470; R_0805_2012Metric_Pad1.15x1.40mm_HandSolder; ManufacturerPartNumber 0805W8F4700T5E; LCSCPartNumber C17710
R2: 7.5K; R_0805_2012Metric_Pad1.15x1.40mm_HandSolder; ManufacturerPartNumber 0805W8F7501T5E; LCSCPartNumber C17807
R4: 2K; R_0805_2012Metric_Pad1.15x1.40mm_HandSolder; ManufacturerPartNumber 0805W8F2001T5E; LCSCPartNumber C17604
SW1: SW_SPDT; SW_SPDT_PCM12; ManufacturerPartNumber SK-3296S-01-L3; LCSCPartNumber C319019
U1: HC-02
U2: LN1134A332MR-G; SOT-23-5; ManufacturerPartNumber LN1134A332MR-G; LCSCPartNumber C141419
U3: SP3232EEN; SOIC-16_3.9x9.9mm_P1.27mm; ManufacturerPartNumber SP3232EEN-L/TR; LCSCPartNumber C9378
U4: LP4054HB5F; SOT-23-5; ManufacturerPartNumber LP4054HB5F; LCSCPartNumber C517187

Connections:
3_3V: C3.1, C4.2, U1.12 (VCC), U2.5 (OUT), U3.16 (VCC)
BatteryPower: BT1.1 (+), C9.1, SW1.1 (A), U4.3 (VBAT)
CEN: R6.1, U4.1 (CEN)
GND: BT1.2 (-), C1.2, C3.2, C4.1, C6.1, C7.1, C8.1, C9.2, D2.2 (K1), J1.5 (GND), J1.6 (Shield), J2.5, R2.1, R4.2, U1.13 (GND), U1.14 (LEDCON), U2.2 (GND), U3.15 (GND), U4.2 (VSS)
LED: R1.2, U1.23 (LED)
unnamed: C2.1, U3.1 (C1+)
unnamed: C2.2, U3.3 (C1-)
unnamed: C5.1, U3.4 (C2+)
unnamed: C5.2, U3.5 (C2-)
unnamed: C6.2, U3.2 (VS+)
unnamed: C7.2, U3.6 (VS-)
unnamed: D2.1 (A1), R1.1
unnamed: D2.3 (K2), R5.2
unnamed: J2.2, U3.8 (R2IN)
unnamed: J2.3, U3.7 (T2OUT)
unnamed: R2.2, U1.18 (KEY+)
unnamed: R4.1, U4.5 (PROG)
unnamed: R5.1, R6.2
unnamed: U1.1 (TxD), U3.10 (T2IN)
unnamed: U1.2 (RxD), U3.9 (R2OUT)
SelectedPower: C1.1, SW1.2 (B), U2.1 (IN), U2.3 (EN)
VBUS: C8.2, D2.4 (A2), J1.1 (VBUS), SW1.3 (C), U4.4 (VDD)

Notes on the sheet:
Battery Charging
RED
BLUE
3_3V Regulator
Power selection

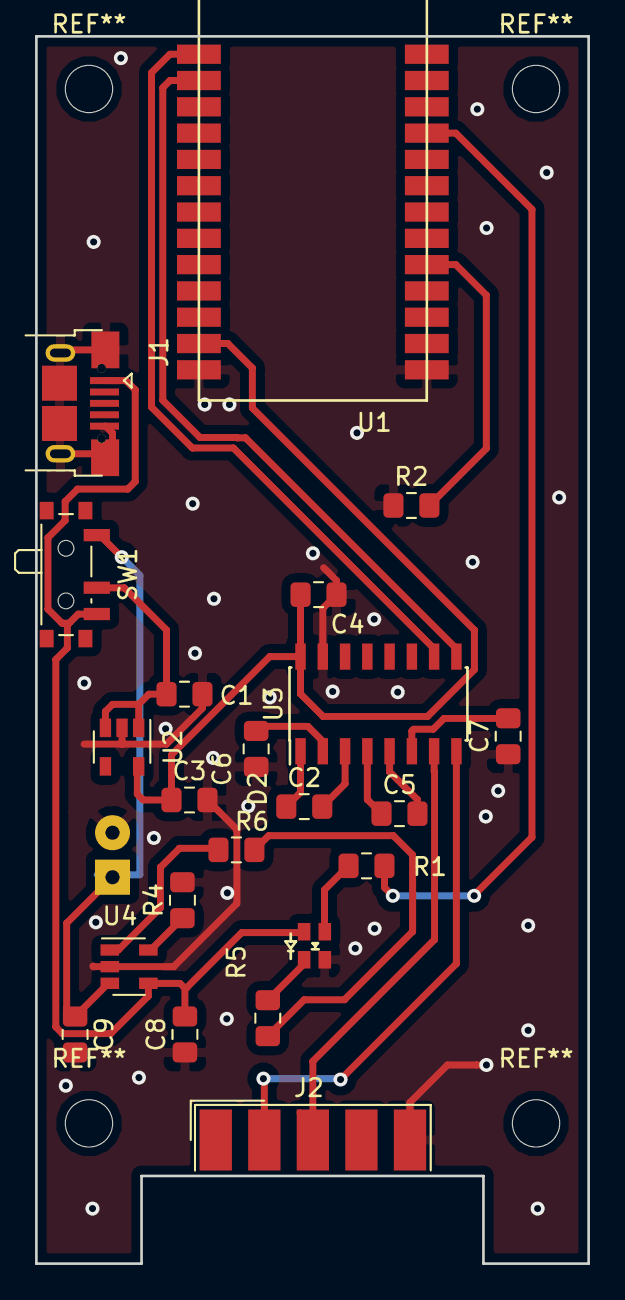
[picture p79: board BTSerialClient.kicad_pcb from above]

Board: 2 copper layers, 31.5 x 70.0 mm, 23 parts (1 on the bottom side), 22 nets.
