henla464/WiRocKiCad/KiCad6/SRRReceiverProgrammerAdaptorBoard/SRRReceiverProgrammerAdaptorBoard.kicad_pcb

## KiCad design KiCad6/SRRReceiverProgrammerAdaptorBoard/SRRReceiverProgrammerAdaptorBoard.kicad_pcb (2023-06-16, an earlier design)

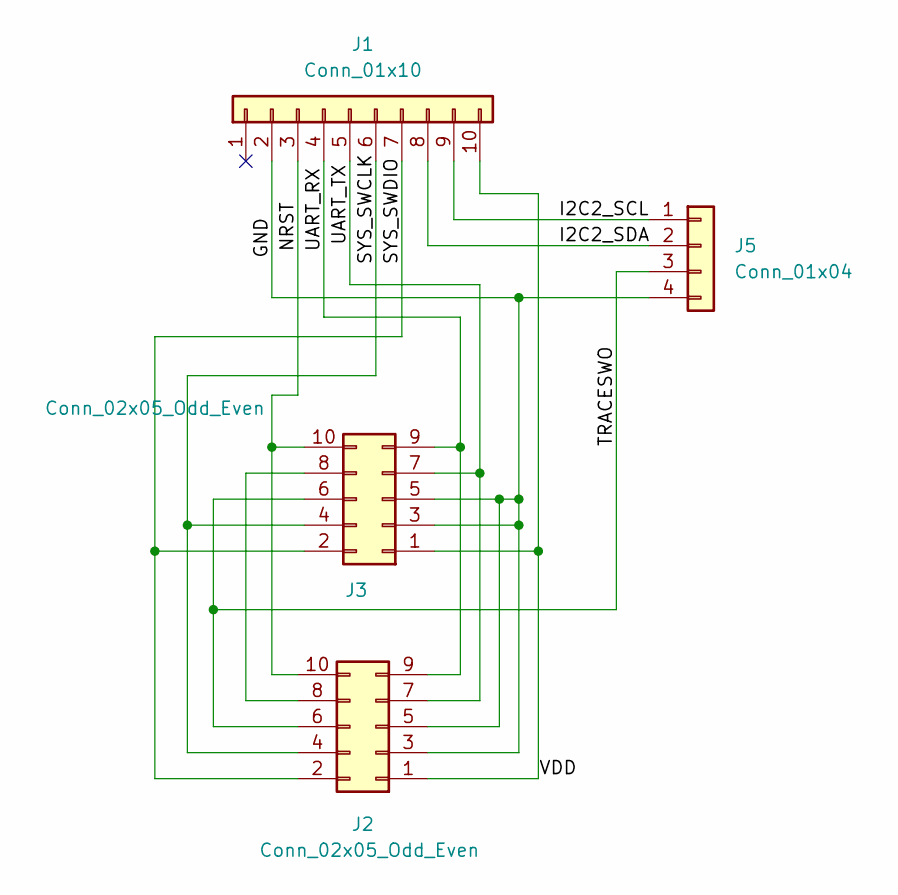
[picture p80: schematic SRRReceiverProgrammerAdaptorBoard.kicad_sch]

Parts:
J1: Conn_01x10; FPC-Connector_1x10-1MP_P0.5mm_Horizontal
J2, J3: Conn_02x05_Odd_Even; PinHeader_2x05_P1.27mm_Vertical
J5: Conn_01x04; PinHeader_1x04_P2.54mm_Vertical

Connections:
/GND: J1.2, J2.3, J2.5, J3.3, J3.5, J5.4
/I2C2_SCL: J1.9, J5.1
/I2C2_SDA: J1.8, J5.2
/NRST: J1.3, J2.10, J3.10
/SYS_SWCLK: J1.6, J2.4, J3.4
/SYS_SWDIO: J1.7, J2.2, J3.2
/TRACESWO: J2.6, J3.6, J5.3
/UART_RX: J1.4, J2.9, J3.9
/UART_TX: J1.5, J2.7, J3.7
/VDD: J1.10, J2.1, J3.1
unnamed: J2.8, J3.8

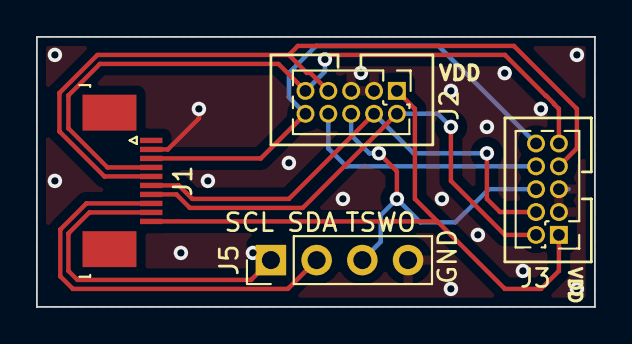
[picture p81: board KiCad6/SRRReceiverProgrammerAdaptorBoard/SRRReceiverProgrammerAdaptor… from above]

Board: 2 copper layers, 31.0 x 15.0 mm, 4 parts (0 on the bottom side), 11 nets.
