henla464/WiRocKiCad/KiCad6/Hardware_OLED_v1/WiRocChip_1.kicad_pcb

## KiCad design KiCad6/Hardware_OLED_v1/WiRocChip_1.kicad_pcb (2020-10-04)

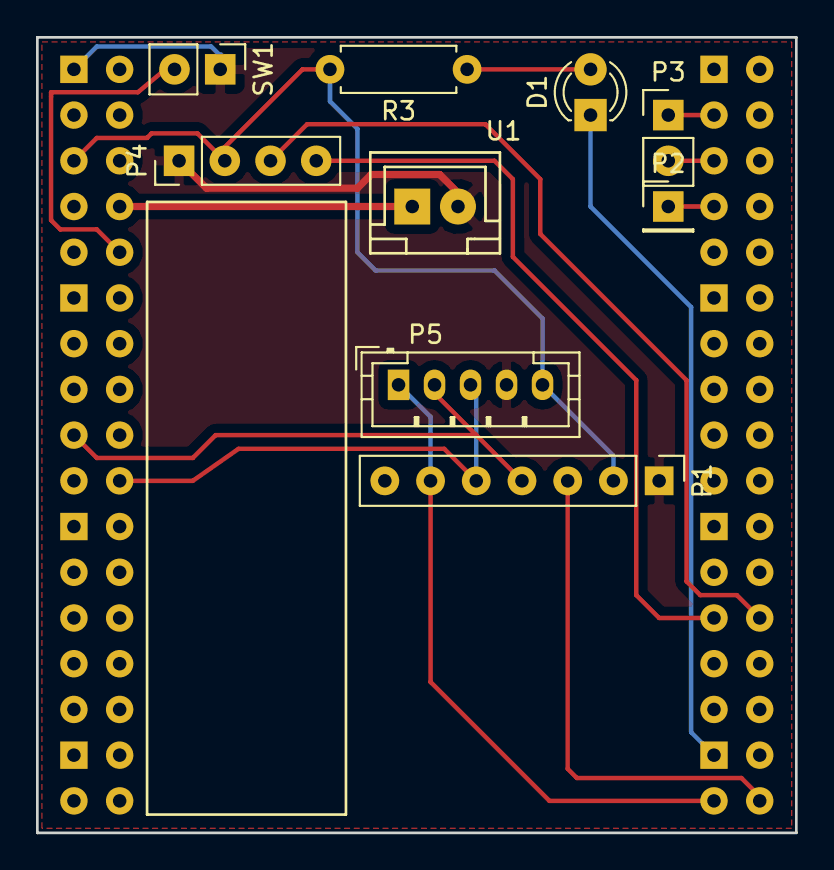
[picture p82: board KiCad6/Hardware_OLED_v1/WiRocChip_1.kicad_pcb from above]

Board: 2 copper layers, 42.2 x 44.2 mm, 10 parts (1 on the bottom side), 15 nets.

Parts:
D1: LED; LED_D3.0mm
P1: Lora Conn; Pin_Header_Straight_1x07_Pitch2.54mm
P2: CONN_01X01; Pin_Header_Straight_1x01_Pitch2.54mm
P3: CONN_01X02; Pin_Header_Straight_1x02_Pitch2.54mm
P4: CONN_01X04; CONN_OLED_TWI-Socket_Strip_Straight_1x04_Pitch2.54mm
P5: Lora JST Conn; JST_PH_B5B-PH-K_05x2.00mm_Straight
R3: R; R_Axial_DIN0207_L6.3mm_D2.5mm_P7.62mm_Horizontal
SW1: SW_PUSH; Pin_Header_Straight_1x02_Pitch2.54mm
U1: JST-2PIN; JST_2.56
U2: CHIP; Chip

Connections:
BAT: U1.1, U2.8
GND: P1.1, P4.1, P5.4, SW1.1, U1.2, U2.1
LoraAUX: P1.6, P5.1, U2.133
LoraEN: P1.3, U2.134
unnamed: D1.1, U2.131
unnamed: D1.2, R3.1
unnamed: P1.4, P5.2, U2.17
unnamed: P1.5, P5.3, U2.20
unnamed: P2.1, U2.107
unnamed: P3.1, U2.103
unnamed: P3.2, U2.105
unnamed: SW1.2, U2.10
TWI2-SDA: P4.4, U2.125
TWI-SCK: P4.3, U2.126
VCC-3V3: P1.2, P4.2, P5.5, R3.2, U2.5
