henla464/WiRocKiCad/KiCad5/Hardware_v6/WiRocChip_1.kicad_pcb

## KiCad design KiCad5/Hardware_v6/WiRocChip_1.kicad_pcb (2020-10-04, an earlier design)

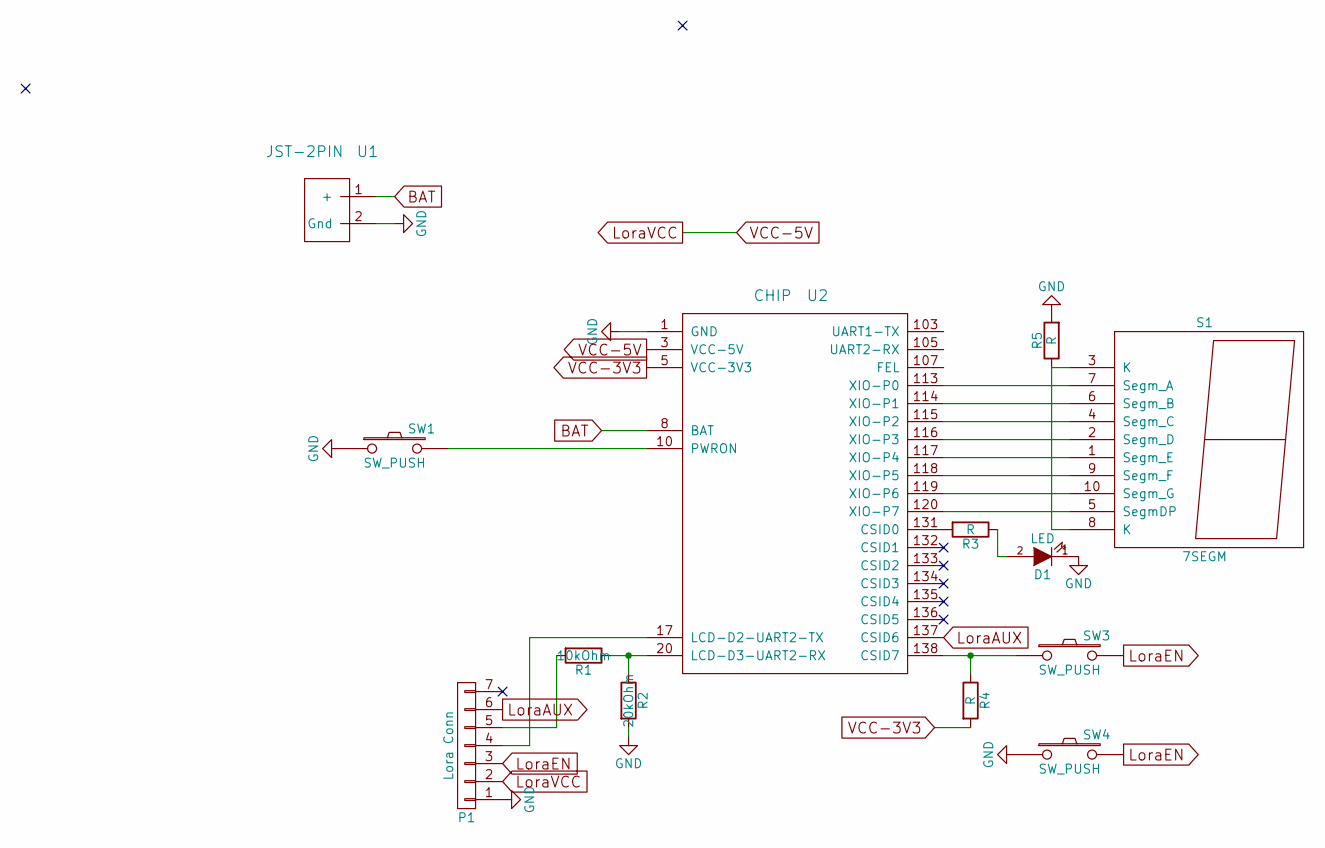
[picture p83: schematic WiRocChip_1.sch]

Parts:
D1: LED; LED-3MM
P1: Lora Conn; Pin_Header_Straight_1x07
R1: 10kOhm; Resistor_Horizontal_RM10mm
R2: 20kOhm; Resistor_Horizontal_RM10mm
R3, R4, R5: R; Resistor_Horizontal_RM10mm
S1: 7SEGM; 7SegmentLED_LTS6760_LTS6780
SW1, SW3, SW4: SW_PUSH; Pin_Header_Straight_1x02
U1: JST-2PIN; JST_2.56
U2: CHIP; Chip

Connections:
BAT: U1.1 (+), U2.8 (BAT)
GND: D1.1 (K), P1.1, R2.2, R5.2, SW1.1, SW4.1, U1.2 (Gnd), U2.1 (GND)
LoraAUX: P1.6, U2.137 (CSID6)
LoraEN: P1.3, SW3.2, SW4.2
LoraVCC: P1.2, U2.3 (VCC-5V)
unnamed: D1.2 (A), R3.1
unnamed: P1.4, U2.17 (LCD-D2-UART2-TX)
unnamed: P1.5, R1.2
unnamed: R1.1, R2.1, U2.20 (LCD-D3-UART2-RX)
unnamed: R3.2, U2.131 (CSID0)
unnamed: R4.1, SW3.1, U2.138 (CSID7)
unnamed: R5.1, S1.3 (K), S1.8 (K)
unnamed: S1.1 (Segm_E), U2.117 (XIO-P4)
unnamed: S1.2 (Segm_D), U2.116 (XIO-P3)
unnamed: S1.4 (Segm_C), U2.115 (XIO-P2)
unnamed: S1.5 (SegmDP), U2.120 (XIO-P7)
unnamed: S1.6 (Segm_B), U2.114 (XIO-P1)
unnamed: S1.7 (Segm_A), U2.113 (XIO-P0)
unnamed: S1.9 (Segm_F), U2.118 (XIO-P5)
unnamed: S1.10 (Segm_G), U2.119 (XIO-P6)
unnamed: SW1.2, U2.10 (PWRON)
VCC-3V3: R4.2, U2.5 (VCC-3V3)

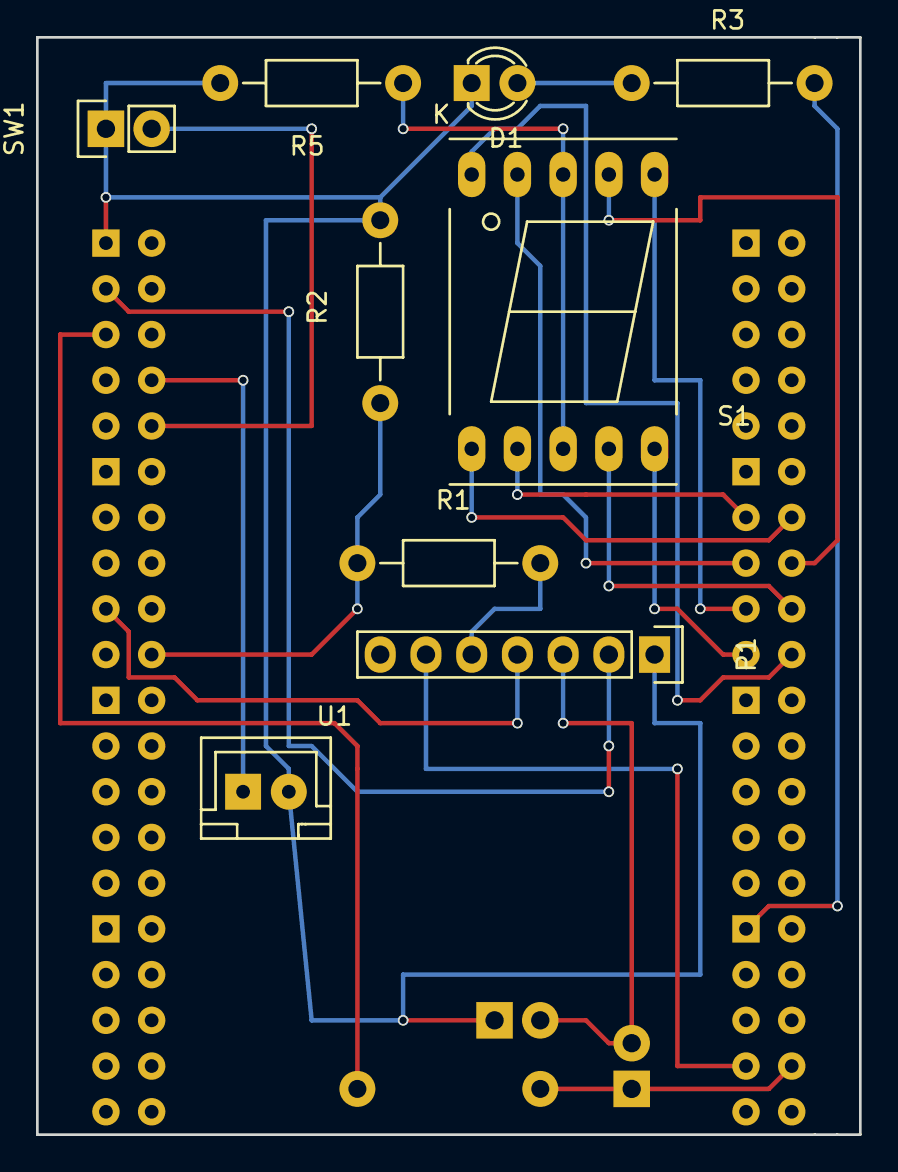
[picture p84: board KiCad5/Hardware_v6/WiRocChip_1.kicad_pcb from above]

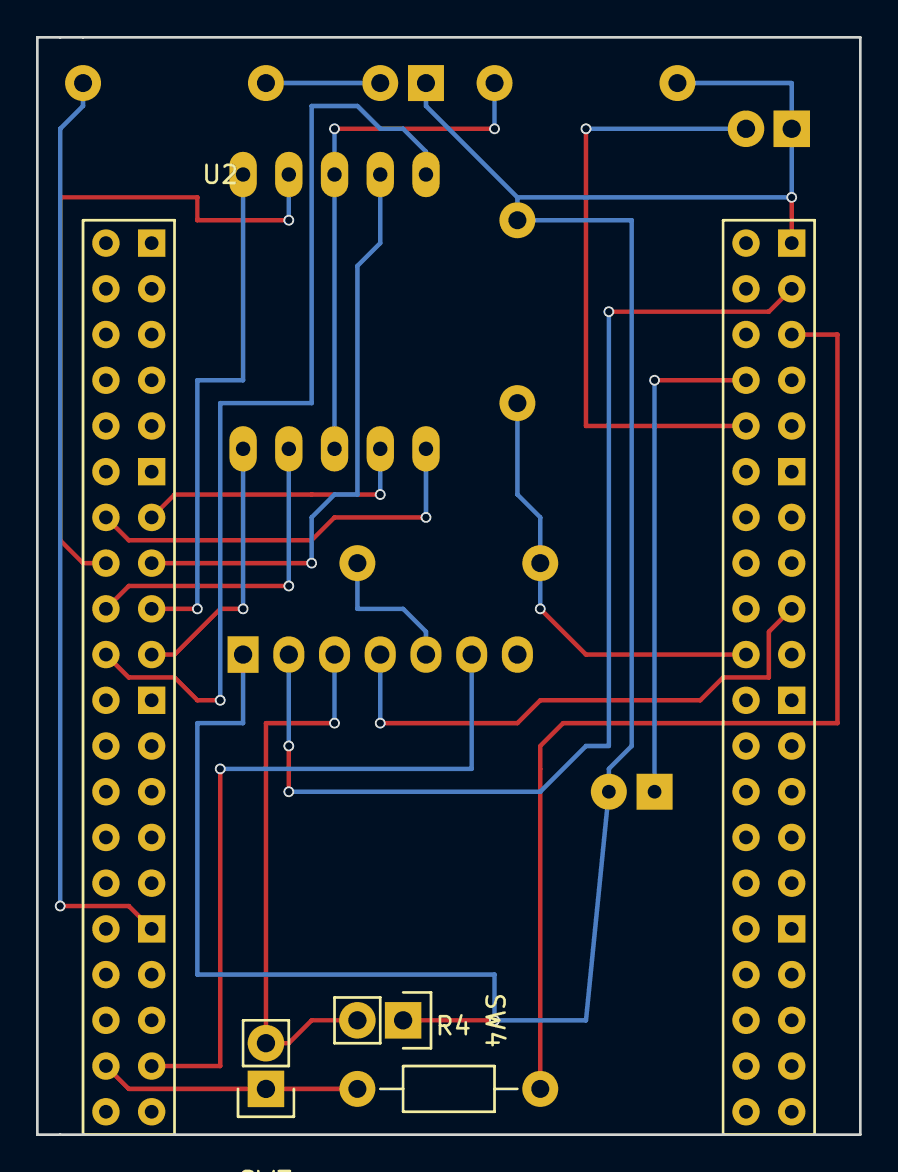
[picture p85: board KiCad5/Hardware_v6/WiRocChip_1.kicad_pcb from below]

Board: 2 copper layers, 45.7 x 61.0 mm, 13 parts (4 on the bottom side), 22 nets.
