henla464/WiRocKiCad/KiCad5/Hardware_NanoPi_SideOledPCB_TallUSBMicro_v2/WiRoc_NanoPi_SideOledPCB_v1.kicad_pcb

## KiCad design KiCad5/Hardware_NanoPi_SideOledPCB_TallUSBMicro_v2/WiRoc_NanoPi_SideOledPCB_v1.kicad_pcb (2020-10-04)

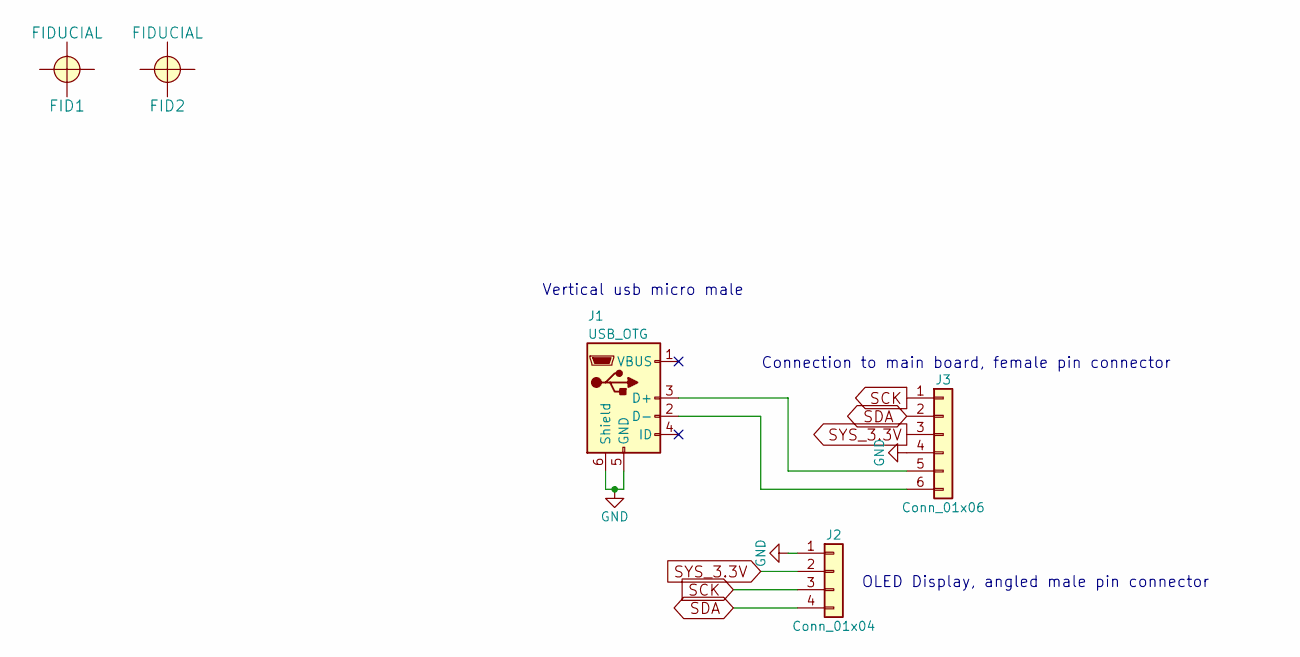
[picture p86: schematic WiRoc_NanoPi_SideOledPCB_v1.sch]

Parts:
FID1, FID2: FIDUCIAL; Fiducial
J1: USB_OTG; Vertical_USB_micro
J2: Conn_01x04; Pin_Header_Angled_1x04_Pitch2.54mm
J3: Conn_01x06; Socket_Strip_Straight_1x06_Pitch2.54mm

Connections:
GND: J1.5 (GND), J1.6 (Shield), J2.1, J3.4
unnamed: J1.2 (D-), J3.6
unnamed: J1.3 (D+), J3.5
SCK: J2.3, J3.1
SDA: J2.4, J3.2
SYS_3.3V: J2.2, J3.3

Notes on the sheet:
OLED Display, angled male pin connector
Connection to main board, female pin connector
Vertical usb micro male

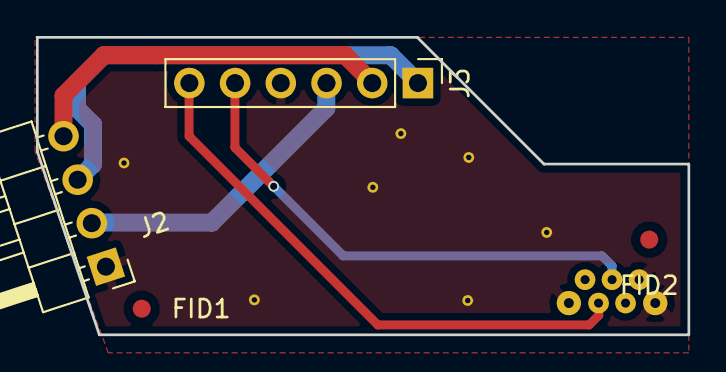
[picture p87: board KiCad5/Hardware_NanoPi_SideOledPCB_TallUSBMicro_v2/WiRoc_NanoPi_SideO… from above]

Board: 2 copper layers, 36.2 x 16.5 mm, 5 parts (1 on the bottom side), 6 nets.
