henla464/WiRocKiCad/KiCad5/Hardware_v4/WiRoc_4.kicad_pcb

## KiCad design KiCad5/Hardware_v4/WiRoc_4.kicad_pcb (2020-10-04, an earlier design)

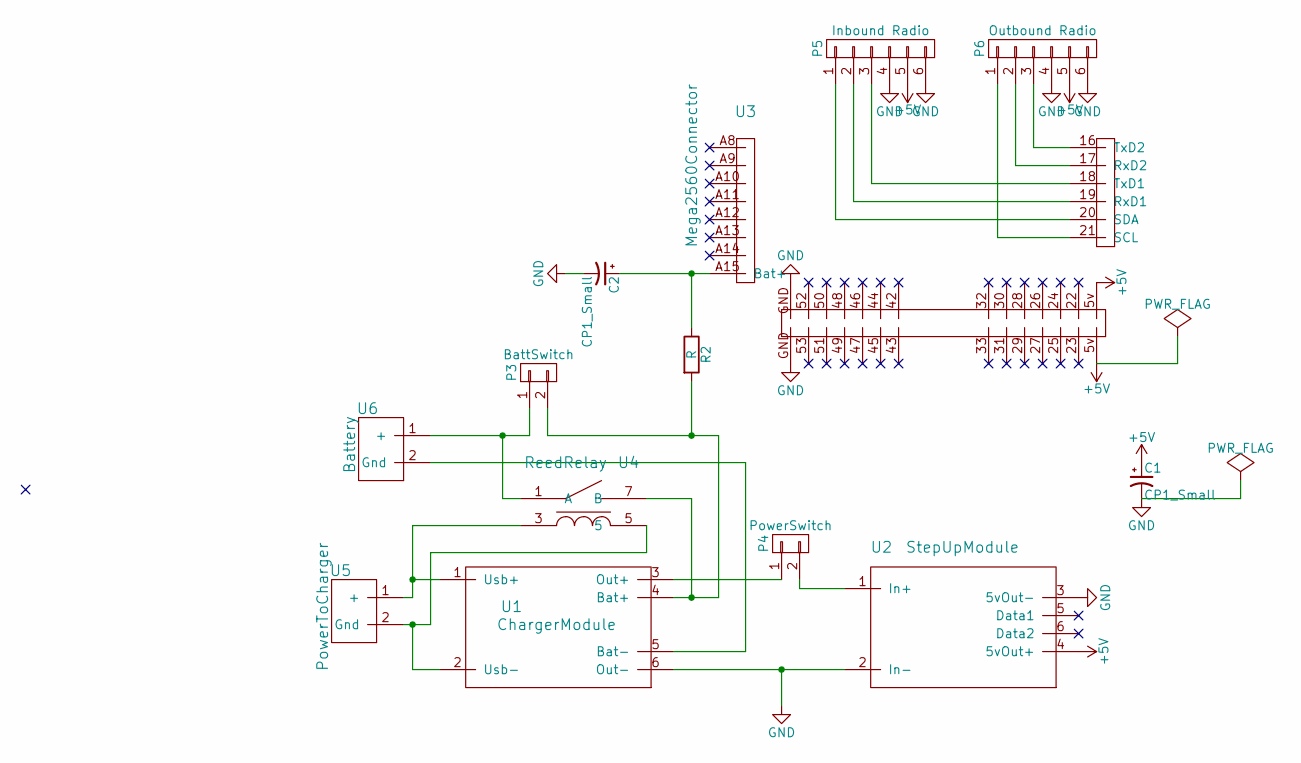
[picture p89: schematic WiRoc_4.sch]

Parts:
C1, C2: CP1_Small; C_Radial_D5_L11_P2
P3: BattSwitch; Pin_Header_Straight_1x02
P4: PowerSwitch; Pin_Header_Straight_1x02
P5: Inbound Radio; Pin_Header_Straight_1x06
P6: Outbound Radio; Pin_Header_Straight_1x06
R2: R; Resistor_Horizontal_RM10mm
U1: ChargerModule
U2: StepUpModule
U3: Mega2560Connector
U4: ReedRelay; SIP-1A05
U5: PowerToCharger; JST_2.56
U6: Battery; JST_2.56

Connections:
+5V: C1.1, P5.5, P6.5, U2.4 (5vOut+), U3.5v
GND: C1.2, C2.2, P5.4, P5.6, P6.4, P6.6, U1.6 (Out-), U2.2 (In-), U2.3 (5vOut-), U3.GND
unnamed: C2.1, R2.1, U3.A15 (Bat+)
unnamed: P3.1, U4.1 (A), U6.1 (+)
unnamed: P3.2, R2.2, U1.4 (Bat+), U4.7 (B)
unnamed: P4.1, U1.3 (Out+)
unnamed: P4.2, U2.1 (In+)
unnamed: P5.1, U3.20 (SDA)
unnamed: P5.2, U3.19 (RxD1)
unnamed: P5.3, U3.18 (TxD1)
unnamed: P6.1, U3.21 (SCL)
unnamed: P6.2, U3.17 (RxD2)
unnamed: P6.3, U3.16 (TxD2)
unnamed: U1.1 (Usb+), U4.3, U5.1 (+)
unnamed: U1.2 (Usb-), U4.5, U5.2 (Gnd)
unnamed: U1.5 (Bat-), U6.2 (Gnd)

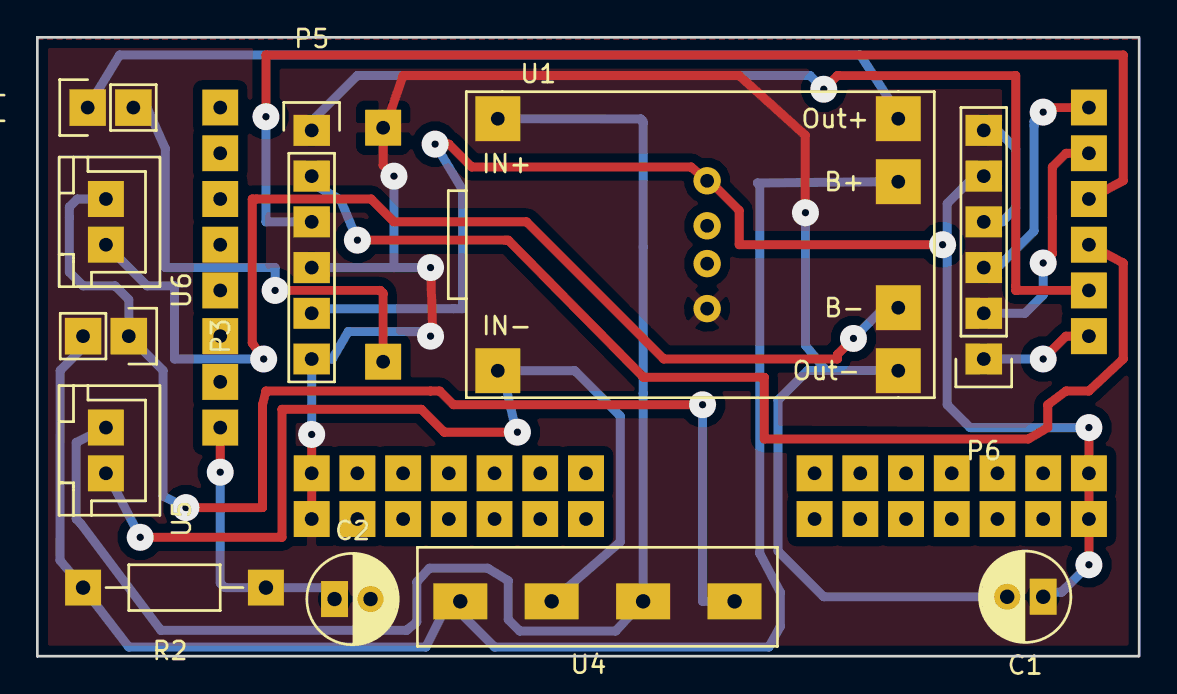
[picture p90: board WiRoc_4.kicad_pcb from above]

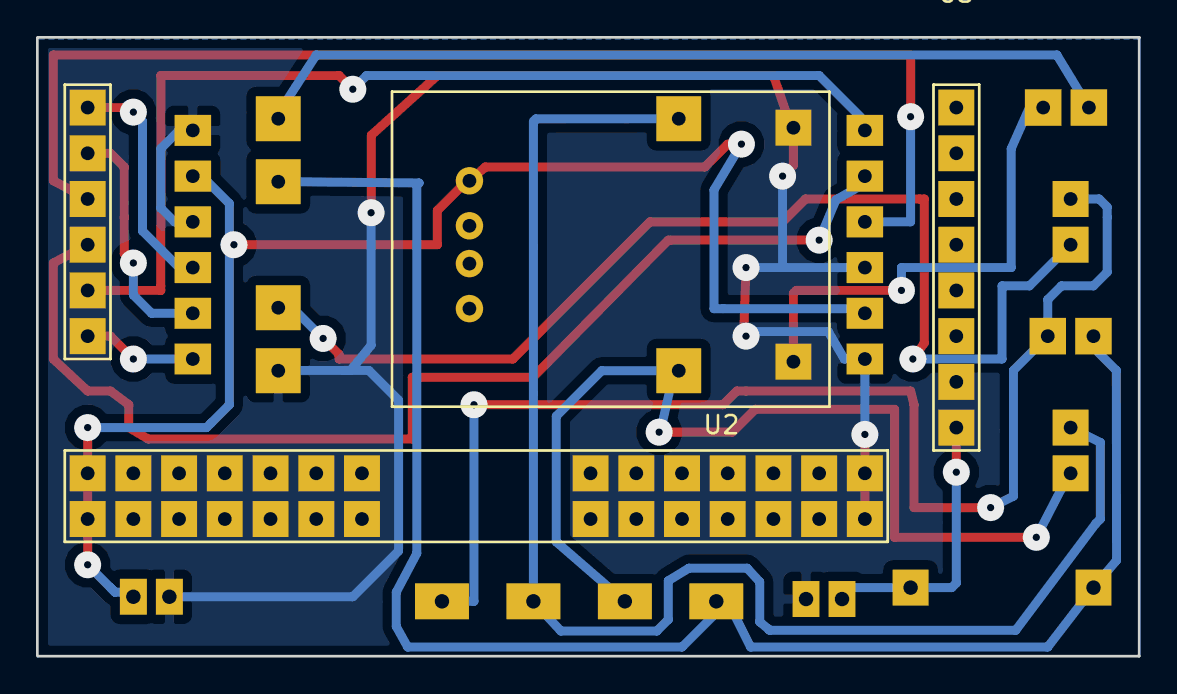
[picture p91: board WiRoc_4.kicad_pcb from below]

Board: 2 copper layers, 61.2 x 34.4 mm, 13 parts (2 on the bottom side), 16 nets.
