henla464/WiRocKiCad/(commit log)

2022-01-19 add KiCad6 versions
    [BOM_WiRoc_NanoPi_v1.xls, BOM_WiRoc_NanoPi_v3_JLCPCB.csv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]
2022-09-06 add USBRadio etc
    [BOM-USBRadio.csv, MCU.kicad_sch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]
2023-06-16 add KiCad7
    [BOM-SRRReceiver.csv, BOM-SRRReceiverProgrammerAdaptorBoard.csv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]
2023-11-12 diverse SRR etc
    [3dmodelWithSRR.FCStd, AssemblyWithSRRReciever.FCStd, BOM-SRRReceiver.csv, BOM-SRRReceiverProgrammerAdaptorBoard.csv, Hardware_NanoPi_v7_ConnectorPlate.kicad_pcb, Hardware_NanoPi_v7_ConnectorPlate.kicad_sch, Hardware_NanoPi_v7_ConnectorPlate.step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]
2024-07-03 wiroc v8 layout work
    [ComponentDesignationAndLocation.ods, LED-Etc.kicad_sch, MicroSD.kicad_sch, Power1.kicad_sch, Power2.kicad_sch, PowerTree.kicad_sch, Processor-GPIO-Etc.kicad_sch, Processor-MEM.kicad_sch]
2024-07-08 more routing of v8
    [Power1.kicad_sch, Processor-GPIO-Etc.kicad_sch, WiRoc_NanoPi.kicad_pcb, Wifi-BT.kicad_sch, eMMC.kicad_sch]
2024-07-08 more v8 routing
    [WiRoc_NanoPi.kicad_pcb]
2025-09-28 sbc version etc
    [3dmodelWithSRR.FCStd, ComponentDesignationAndLocation.ods, Hardware_NanoPi_v7_ConnectorPlate.kicad_pcb, Hardware_NanoPi_v7_ConnectorPlate.kicad_sch, Hardware_NanoPi_v7_ConnectorPlate.step, Hardware_WiRoc_v8_ConnectorPlate.kicad_pcb, Hardware_WiRoc_v8_ConnectorPlate.kicad_sch, Hardware_WiRoc_v8_ConnectorPlate.step]
2025-10-19 more routing of WiRoc_v8, upgraded USBConnectorPlate to v9 and with ferrit beads, added an ESPHosted testboard
    [ESPHostedTestBoard.kicad_pcb, ESPHostedTestBoard.kicad_sch, Hardware_NanoPi_v8_USBConnectorPlate.kicad_pcb, Hardware_NanoPi_v8_USBConnectorPlate.kicad_sch, Hardware_NanoPi_v8_USBConnectorPlate.step, Processor-GPIO-Etc.kicad_sch, USB-SYS.kicad_sch, WiRoc_NanoPi.kicad_pcb]
2025-10-19 fill exclusion for emmc, adjust lengths emmc
    [WiRoc_NanoPi.kicad_pcb]
2025-10-31 Change SRRReceiver pins,
    [SRRReceiver.kicad_pcb, SRRReceiver.kicad_sch, SRRReceiver.step, bom.csv, designators.csv, positions.csv]
2025-10-31 add bom
    [Hardware_NanoPi_v8_USBConnectorPlate.kicad_pcb, Hardware_NanoPi_v8_USBConnectorPlate.kicad_sch, LED-Etc.kicad_sch, Lora.kicad_sch, MicroSD.kicad_sch, Power1.kicad_sch, Power2.kicad_sch, Processor-GPIO-Etc.kicad_sch]
2025-10-31 add oshw logo
    [WiRoc_NanoPi.kicad_pcb]
2025-11-16 change tracewidth for mem, add nettie for better length calculation
    [Lora.kicad_sch, PowerTree.kicad_sch, Processor-MEM.kicad_sch, WiRoc_NanoPi.kicad_pcb, WiRoc_NanoPi.kicad_sch]
2025-11-17 adjustments length and width of traces
    [WiRoc_NanoPi.kicad_pcb, eMMC.kicad_sch]
2025-11-21 add rst to wifi board
    [Processor-GPIO-Etc.kicad_sch, WiRoc_NanoPi.kicad_pcb, Wifi-BT.kicad_sch]
2025-11-21 add esp32-c5-wroom to library
2025-11-22 add esp32hosted-c5 board
    [Power1.kicad_sch, Power2.kicad_sch, PowerTree.kicad_sch, Processor-MEM.kicad_sch, Processor.kicad_sch, RTC.kicad_sch, USB-SYS.kicad_sch, WiRoc_NanoPi.kicad_pcb]
2025-11-25 change to 10uF in pdn, vdd-dram area to south caps, remove varistor, etc
    [MicroSD.kicad_sch, Power2.kicad_sch, PowerTree.kicad_sch, Processor-GPIO-Etc.kicad_sch, Processor-MEM.kicad_sch, Processor.kicad_sch, RTC.kicad_sch, USB-SYS.kicad_sch]
2025-11-26 save point for fix to layer issues in6
    [Lora.kicad_sch, Power1.kicad_sch, WiRoc_NanoPi.kicad_pcb]
2025-11-28 shorten spi meander, dataready/handshake shouldn't be length matched to spi. Move eMMC-cmd pullup to processor via. Make meanders more spacious.
    [Processor-MEM.kicad_sch, WiRoc_NanoPi.kicad_pcb]
2025-11-29 many small changes, change eMMC
    [Lora.kicad_sch, MicroSD.kicad_sch, Power1.kicad_sch, Power2.kicad_sch, Processor-GPIO-Etc.kicad_sch, Processor-MEM.kicad_sch, Processor.kicad_sch, RTC.kicad_sch]
2025-12-02 change gnd planes to 0.12 clearance and 0.09 minimum width, move some vias create path inbetween
    [WiRoc_NanoPi.kicad_pcb]
2025-12-02 more clearance adjustments for vias
    [WiRoc_NanoPi.kicad_pcb]
2025-12-04 add 3d of wifiboard
    [Hardware_NanoPi_v8_USBConnectorPlate.kicad_pcb, Hardware_NanoPi_v8_USBConnectorPlate.kicad_sch, WiRoc_NanoPi.kicad_pcb, WifiModuleBoard.kicad_pcb, WifiModuleBoard.kicad_sch]
2025-12-13 remove ignored production dir
    [bom.csv, designators.csv, positions.csv]
2026-01-02 change hole size to smaller, to better fit the pins
2026-01-02 change to use smaller pin holes
    [Hardware_NanoPi_v8_USBConnectorPlate.kicad_pcb]
2026-01-02 changed some vias to make them smaller like the others
    [WiRoc_NanoPi.kicad_pcb]
2026-01-03 make holes smaller to fit pins better
    [WiRoc_NanoPi.kicad_pcb]
2026-03-19 add ethernet etc
    [Hardware_NanoPi_v8_USBConnectorPlate.kicad_pcb, Hardware_NanoPi_v8_USBConnectorPlate.kicad_sch, LED-Etc.kicad_sch, Lora.kicad_sch, MicroSD.kicad_sch, Processor-GPIO-Etc.kicad_sch, Processor-MEM.kicad_sch, SRRReceiver.kicad_pcb]
2026-04-02 kicad10 and .gitignore lck history
    [LED-Etc.kicad_sch, Lora.kicad_sch, MicroSD.kicad_sch, Power1.kicad_sch, Power2.kicad_sch, PowerTree.kicad_sch, Processor-GPIO-Etc.kicad_sch, Processor-MEM.kicad_sch]
2026-04-11 add logo, improve layout
    [Hardware_NanoPi_v8_USBConnectorPlate.kicad_pcb, Hardware_NanoPi_v8_USBConnectorPlate.kicad_sch, LED-Etc.kicad_sch, Lora.kicad_sch, MicroSD.kicad_sch, Power1.kicad_sch, Power2.kicad_sch, PowerTree.kicad_sch]
2026-04-11 remove test project
    [test.kicad_pcb, test.kicad_sch]
2026-08-07 small layout changes (moved up lora, down oled), changed to rev3
    [WiRoc_NanoPi.kicad_pcb]
2026-08-07 library paths etc
    [SRRReceiver.kicad_pcb]
2026-08-07 rename to v6
    [SRRReceiver.kicad_pcb, SRRReceiver.kicad_sch, SRRReceiver.step]
2026-08-07 remove old folder
    [SRRReceiver.kicad_sch, SRRReceiver.step]
2026-08-07 rename conenctorplate directory
    [Hardware_NanoPi_v8_USBConnectorPlate.kicad_pcb, Hardware_NanoPi_v8_USBConnectorPlate.kicad_sch, Hardware_NanoPi_v8_USBConnectorPlate.step]
2026-08-07 new name of project files for conenctor plate proj
    [WiRoc_v8_USBConnectorPlate.kicad_pcb, WiRoc_v8_USBConnectorPlate.kicad_sch, WiRoc_v8_USBConnectorPlate.step]
2026-08-07 remove old proj
    [Hardware_NanoPi_v8_USBConnectorPlate.kicad_pcb, Hardware_NanoPi_v8_USBConnectorPlate.kicad_sch, Hardware_NanoPi_v8_USBConnectorPlate.step]
2026-08-07 renamed directory
    [WiRoc_v8_USBConnectorPlate.kicad_pcb, WiRoc_v8_USBConnectorPlate.kicad_sch, WiRoc_v8_USBConnectorPlate.step]
2026-08-07 fixing proj load error
    [WifiModuleBoard.kicad_sch]
2026-09-28 fix rotation of LED
    [LED-Etc.kicad_sch, Lora.kicad_sch]
2026-09-28 change partnumber
    [Power2.kicad_sch]
2026-09-28 rev 2, fix decoupl cap placement
    [SRRReceiver.kicad_pcb]
